gruMoses/wall_e-Mini/docs/data/shield_inputs_20261113/receiver_header_pins_20261114.jpg

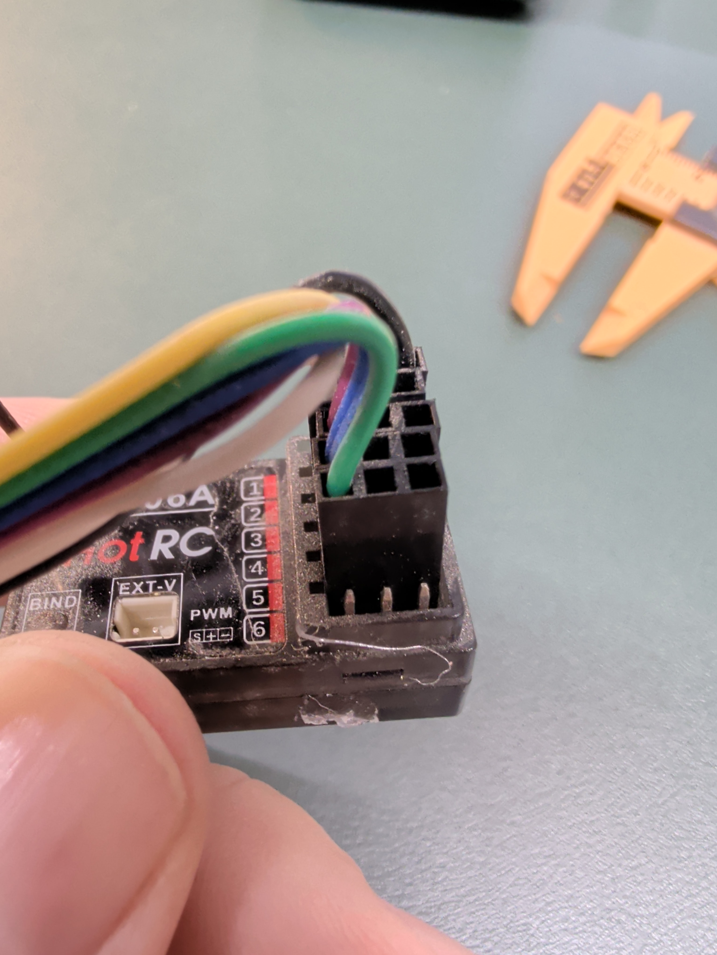
docs/data/shield_inputs_20261113/receiver_header_pins_20261114.jpg
