gruMoses/wall_e-Mini/docs/NEXT_SESSION.md

# Next session: start here

Updated 2026-11-10: a full audit of the documents against the code is in `docs/status_audit_2026-11-10.md`. Start there. It has the open safety gaps in priority order, the UPS battery incident of 2026-11-08, and the list of stale statements. Kevin's answers that day: the BMS targets in `docs/battery_settings.md` are applied; VESC part A is not applied; the new UPS cells stay; the east-field test plan is still wanted, but not now. This document does not have the 2026-11-08 drive review or the RTK sunset work (refer to `docs/rtk_float_investigation.md`).

Updated 2026-11-06 (evening): the VIO runs are DONE (`docs/depthai_upgrade.md`
section 5: works with the RAW IMU reports, 90.6 deg for a 90 deg turn, 6.79 m
for 7 m). The OAK is capped at USB 2 because USB 3 jams the RTK GPS
(`docs/ups_hat_b.md`); item 3 below no longer applies at USB 2. Next for VIO:
log it beside the gyro heading in one run, then decide whether it moves into
wall-e's pipeline (CPU about one core).

Plan written 2026-11-05 (evening) for 2026-11-06, in this order:

1. DONE 2026-11-06. VIO runs with `tools/vio_probe.py` (wall-e stopped).
2. VESC part A in the phone app (`docs/battery_settings.md` section 4, and
   the printed sheet). Not applied yet; a read-back at 15:1x showed the old
   values (-40 A regen, 40 A drive, cutoffs 40.8/36 V, regen cutoff off,
   right VESC 12 cells). After Kevin applies it, read both back with
   `tools/vesc_info.py`.
3. RC range check with the OAK at USB 3 (2.4 GHz noise): Kevin walks the
   remote to the far end of the yard; count clamped RC frames and RC-stale
   events. If the link degrades, force USB 2 in the config first. SUPERSEDED 2026-11-06: the OAK is capped at USB 2.
4. The regen stop measurement: the per-tick log now has `l_bus_v`,
   `l_bus_v_max`, `l_bus_a_min` (and `r_*`). The worst case (BMS charge FET
   open) needs a cold morning below 1 C or a BMS trip; on 2026-11-05 at
   17:56 the FET was back on (52.1 V, highest cell 4014 mV).
5. Kevin's decisions: a failed boot gravity check disables heading hold and
   waypoint navigation (Grok's advice), and wall-e starts the camera reader
   when the OAK is missing at startup (`docs/depthai_upgrade.md` section 6).

State at the end of 2026-11-05: depthai 3.6.1 is live (unplug test and
heading sign test passed, `docs/depthai_upgrade.md`); the OAK links at
USB 3 (Kevin keeps it) (SUPERSEDED 2026-11-06: capped at USB 2 with `max_usb_speed = "HIGH"`); the Pi-to-hub cable has its 5 V wire cut and the
backfeed is fixed (`docs/ups_hat_b.md`); the BMS cell overvoltage trip is
4250 mV (Kevin); the RC arm fail-safe is live (3a3a1b2).

Updated 2026-11-02 (evening): the 2026-11-03 east-field test plan is
`docs/field_test_2026-11-03.md`. The Pi was offline while it was written.
The test page and the google.com reachability halt are specified there and
were not implemented. Kevin installs a new UPS in the morning, drives the
robot into the plowed field east of the barn and east of the house, then
starts one routine at a time. Leave `docs/wifi_watchdog.md` alone.

Updated 2026-11-03: UPSPlus retired; Waveshare UPS HAT (B) + `bin/walle_ups.py` (`walle-ups.service`) halts the Pi 5 s after mains loss and RTC-polls every 60 s; see `docs/ups_hat_b.md`. The 2026-09-27 UPS MCU item and the 18650-pull TODO are closed.

Written 2026-09-20 (evening), at the end of the follow-me session.
Updated 2026-09-22 (evening): `fm-armsup` hardened after three Grok safety reviews and merged (sections 2 and 6).
Updated 2026-09-24 (evening): `fb9420e` deployed; the arms-up bench test PASSED on the test stand (section 2, "Bench result").
Updated 2026-09-24 (night): the log-only pump detector is built on branch `fm-pump` and NOT deployed (section 4, item 2). Housekeeping done (item 8).
Updated 2026-09-25 (night): four safety changes are live (the fourth: OAK auto-restart on a stalled colour stream, `b304609`), after these three: the stale-detection gate for follow-me (`2583757`), auto-disarm after 10 minutes armed and idle in MANUAL (`5340028`), and the startup arm interlock (`3f8cdfa`). Refer to section 4, item 0.
Updated 2026-09-26 (afternoon): follow-me top speed 1.61 m/s, follow range 8 m and a 4 ft stop are LIVE (`c3c995a`, deployed 13:45). Phantom obstacles in front of an iron gate: fix built and replay-validated on 45 raw frames (section 4, item 5).
Updated 2026-09-26 (evening): I2C bus 1 froze on 2026-09-25 21:36 (GPS and UPS monitor dark for 17 h); an auto-unlock guard service is LIVE (`2759465`, section 4, item 0). The corridor phantom fix is LIVE (`cceb2e1`, item 5).
Updated 2026-09-27: the UPS MCU is FROZEN (all registers constant since 2026-09-26 15:06), so the UPS watcher never saw a power-off; a battery-discharge fallback is LIVE (`f193e09`) and passed a live test. Section 4, item 0.
Updated 2026-09-27 (evening): the "pull to the left" was a stale heading-hold target with the GPS offset locked (fix `19a4ebe`); MANUAL obstacle curve for netting over the lens (`814c812`; no person/animal cap, by Kevin's safety principle); stick expo 0.6, ratio-preserving (`35dc7c2`). Wi-Fi: NetworkManager no-secrets block, stopgap live, watchdog not yet deployed that evening (reworked since: on `main`, installed and active). Section 4, item 0, "2026-09-27 evening".
Updated 2026-09-28: animal detections are logged (per-tick `animals`, no behaviour change) to size an animal slow zone; section 4, item 0, "Animals".
This document uses Simplified Technical English where practical.

## 1. State of the robot

- 2026-09-22: `main` gains the `fm-armsup` merge (`b758f7a`, section 2). Before that, the robot ran `main` at commit `8eb6cc5` plus documentation-only commits.
- Kevin validated this build in the field at 18:09 on 2026-09-20. His words: "that was gorgeous".
- All changes from 2026-09-20 are live: tracking fix, steering retune, speed-safety logic, honest person-range sampler, vision-latency fix.
- The full record of the day is `docs/follow_me_run_2026-09-20.md`.
- The end goal and the owner's constraints are in `CLAUDE.md` and in the auto-memory file `project-walle-north-star.md`.

## 2. Branch `fm-armsup`: arms-up bench test (deployed 2026-09-24, bench test PASSED)

Purpose: bench test for the "both arms up" gesture. When the robot sees both wrists above the shoulders, it gives one small reverse pulse (22 bytes for 0.25 s, approximately 7 cm). This is the acknowledgement test that Kevin asked for. It is the first step toward the back-up feature (section 4, item 2).

WARNING: This feature commands motion from a camera gesture. Enable it only while Kevin is at the robot with the RC.

How the gate works:

- A deploy does not enable the pulse. Only a runtime latch enables it: `POST /api/arms_up/twitch_test` with the body `{"enabled": true}`. The POST is accepted only from the robot itself (127.0.0.1). The latch is refused unless the robot is armed in MANUAL.
- The latch clears on disarm, e-stop, mode change, calibration, RC stale, 5 minutes, or 3 pulses. A second enable while latched is refused. A restart clears the latch.
- A pulse starts only when the sticks are within 6 bytes of neutral, web teleop is off, the output was neutral for 0.5 s, both wheel eRPMs are present and at or below 300, and the 3 s cooldown is over.
- A stick input, disarm, e-stop, charger, pack-low, calibration or a mode change cancels a pulse. A cancelled pulse does not resume.
- The gesture needs 3 fresh pose samples over 0.4 s. After a pulse, the camera must see the arms down (3 samples) before the next pulse.
- MediaPipe Pose loads at startup and runs only while the latch is on. It does not run in FOLLOW_ME or WAYPOINT_NAV.

Procedure (bench test with Kevin):

1. Kevin approves the push to `main` in the chat while at the robot. Push. Confirm the merge on the Pi with `git merge-base --is-ancestor`. The service restarts when the robot is disarmed.
2. Garage. Clear floor behind the robot. Armed, MANUAL, sticks centred. Kevin stands 2.5 m to 3 m in front of the robot with the arms down.
3. Latency baseline: with the latch off, Kevin stays in view for 30 s.
4. Enable the latch from a shell on the robot:
   `ssh pi@192.168.86.54 'curl -s -X POST -H "Content-Type: application/json" -d "{\"enabled\": true}" http://127.0.0.1:8080/api/arms_up/twitch_test'`
5. Kevin raises both arms above the head for approximately 1 s. The robot must move back approximately 7 cm, one time. One arm up must do nothing. Arms down for 1 s, then both arms up again: one more pulse.
6. Read the arm log: the `arms_up` block (`twitch_count`, `twitch_blocked_reason`, `twitch_cancel_reason`, `pose_ms`, `pose_hz`) and `oak.det_latency_s` with the latch on, compared with the 30 s baseline.

CAUTION: MediaPipe Pose runs only while the latch is on. A latency reading taken while disarmed or with the latch off does not measure the pose worker.

If `det_latency_s` p50 increases by more than approximately 0.05 s with the latch on, reduce `pose_max_hz` before the back-up feature runs the worker in FOLLOW_ME.

Known limit (deferred): detection freshness compares host poll times, not capture times. The crop can lag the person by the NN latency (approximately 0.2 s). The result is a missed trigger, not a false one. Use capture timestamps before the back-up feature.

Bench result (2026-09-24, 18:35 to 18:40, robot on the test stand with the wheels off the ground, `fb9420e`):

- Deploy: `DEPLOYED 39044dc -> fb9420e` at 18:30:06, service restarted. MediaPipe Pose loaded at boot.
- The latch was enabled from the Pi shell at 18:35:16. Pulses at 18:37:07 and 18:38:26. Kevin: "it definitely twitched backwards".
- Each pulse: bytes 110, 104, 112, 126; peak eRPM approximately -3600; wheel travel approximately 9 cm (integrated eRPM, no load); wheels stopped approximately 0.6 s after the start.
- One arm up: 78 distinct one-arm poses in 60 s gave no trigger.
- Re-arm: the second pulse came only after the camera saw the arms down.
- Expiry at 18:40:16 cleared the latch (1 pulse unused), and pose stopped (`pose_hz` 0).
- Latency (armed, MANUAL, person in view): `det_latency_s` p50 0.179 s with the latch off and 0.182 s with the latch on. `vision_work_ms` p50 26.7 to 32.0. Control loop unchanged. Pose inference approximately 75 ms per frame at 10 Hz (static-image mode).
- Camera geometry: at 2.5 m to 3 m, the shoulders are at 0.09 to 0.13 of the preview height and the NN box is clipped at the top. Raised hands are out of view at that range. The trigger fired only when Kevin stood farther back.
- Not tested: a stick cancel during a pulse, the third-pulse budget cutoff, and travel on the ground.

## 3. Rules learned on 2026-09-20 (obey these)

- Identity gates decide whom to follow. They must never hide a closer range from the speed command.
- A rule must never discard a CLOSE range. A veto is permitted only in the far direction.
- Do not fit a plant model from `imu.yaw_rate_dps`. Use the heading derivative. The analyzer does this.
- Count the zeros and the duplicates in a logged signal before you fit a model to it.
- `OakDetectionConfig.camera_fps = 15.0` is load-bearing. Measure `oak.det_latency_s` before and after each change to the OAK pipeline. The measurement works at idle. A field walk is not necessary.
- A diagnosis from a code review is a hypothesis. `nn_input_queue_size = 1` was "the bug" in review, and it changed nothing. The camera frame rate was the cause.
- Get a Grok safety review of each motion-safety diff before the push. The first review on 2026-09-20 found four real defects after 980 tests passed.
- Workflow that worked: diagnosis on the session model, `grok_second_opinion` on the plan, implementation by headless Grok CLI jobs in separate git worktrees with a written specification, diff review, full test suite, Grok safety review, then Kevin approves the push.
- Kevin wants short replies. Give the instruction first.
- (2026-09-22) Measure a code path in the state where it runs. The pose worker runs only while the bench latch is on, so a disarmed "idle" latency reading does not measure it.
- (2026-09-22) Give `grok_review` exact line ranges for a scoped re-review. An open focus used all 25 turns on reading and gave no verdict.

## 4. Backlog, in priority order

0. **INCIDENT 2026-09-25: follow-me drove on a frozen detection. Deploy 1 of the fix is LIVE (`2583757`, deployed 19:20, verified on the robot: `det_fresh_age_s` 0.2 s, sequence advancing, gate wired in the control loop). Follow-me can be used again.** Deploy 2 is LIVE too (`b304609`, 2026-09-25 night): the OAK session restarts itself after 5 s without a fresh NN packet (10 s warm-up), with a cap of 3 restarts in 15 min, then a latched `color_stall_fault` (health) until a fresh packet or a service restart.
   - At 17:43 the OAK colour camera (CAM_A: YOLO input and preview) stalled on the device after 23 h of uptime. The mono cameras and the depth path continued at 15 fps. Chip temperature was 77 C to 78 C before the stall; a thermal cause is not likely.
   - `get_person_detections()` returned the last list (one person, x -0.8, z 2.52 m, track 453) for 40 minutes. `get_health()` reported `detections_stale: True`, but no code read it.
   - At 18:23 Kevin selected FOLLOW_ME. The frozen list counted as a target, so the entry was accepted. Follow-me drove approximately 0.85 m/s with a constant left steer for 44 s (a circle), and again for 1.7 s and 2.2 s. Log: `arm_20260925_182305.log`.
   - The service restart at 18:30 recovered the camera (`det_fps` 14.5, detection age 0.05 s).
   - Also found: the robot stayed armed from 2026-09-24 18:46 to 2026-09-25 18:07 (arm switch on, transmitter on). The auto-deploy held all night for that reason.
   - Fix plan (Grok second opinion accepted): deploy 1 adds a capture-time freshness clock with sequence tracking in the reader, and a controller gate. The gate refuses FOLLOW_ME entry and leaves FOLLOW_ME on the same tick when the detections are older than 1.5 s. The reader return values do not change: an empty list means "detection gap" (coast), and a stale close person must keep forcing the stop tier. Deploy 2 (later, separate) restarts the OAK session when the colour stream is stale for 5 s with depth fresh, with a retry cap and a fault latch.
   - Deploy 1 is on `main` (`2583757`): full suite 1161 tests OK; Grok safety review: no must-fix. Two corrections were made in review: no slew bypass on the stale exit, and a per-session reset of the NN sequence.
   - Also live 2026-09-25 (Kevin approved each push; Grok safety review before each; no must-fix):
     - Auto-disarm (`5340028`): armed, MANUAL, sticks within 25 us of centre, no web teleop, not calibrating, and neutral output for 600 s (`SafetyConfig.auto_disarm_idle_s`) disarm the robot. The disarm latches: flip the arm switch off and on to re-arm. FOLLOW_ME and WAYPOINT_NAV never auto-disarm. The charger inhibit forces neutral output, so a charging robot left armed also disarms.
     - Startup arm interlock (`3f8cdfa`): after any restart (boot, deploy, crash) the robot arms only after the arm switch has been seen OFF (`SafetyConfig.require_switch_off_at_startup`). Journal lines: `Arm interlock: ...` at startup and `Arm latch cleared: arm switch seen OFF`.
   - Open: the log-only pump detector on `fm-pump` must be rebased on these changes and should use `get_detection_freshness()`. Not yet seen in the field: a real colour stall recovered by the watchdog (check the journal for `OAK colour stream stalled`).
   - Found 2026-09-25 20:20: the charger inhibit keys off charging current (`bms.charging`), not the plug. With a full pack (100 %, 0.0 A) on the charger, `charger_inhibit` is False and does not block motion. Candidate fix: detect the charger by voltage or a hardware input. Auto-disarm and the startup interlock cover the parked case meanwhile.
   - Charger-flag logging is LIVE (`6ef165b`): `bms.charger_connected`, `bms.load_connected`, `bms.bms_mode` in the per-tick log, and a WARNING `BMS charger flag: connected|disconnected ...` on each change. Test not done: the BMS Bluetooth went quiet at 20:55 (35 min on the charger at 100 %, 0 A; "Device ... was not found" since). A Daly BMS sleeps its Bluetooth without current; it should wake when current flows. Test: with the BMS awake, unplug the charger for 30 s and plug it back in, then read the journal.
   - OBSOLETE since 2026-11-03 for the UPS parts of the next six items: the UPSPlus HAT and `upsplus-power.service` are retired. The I2C guard now restarts `walle-ups.service`, and the MCU reset TO DO is closed. The text stays as history.
   - I2C BUS 1 FROZE 2026-09-25 21:36:16 (kernel: `i2c_designware 1f00074000.i2c: i2c_dw_handle_tx_abort: SDA stuck at low`). A device held SDA low; the GPS co-processor (0x20) and the UPSPlus HAT (read by `upsplus-power.service`, the safe-shutdown watcher) both went dark for 17 h. The UPS safe shutdown on power loss was OFF for that time. The bus had no I2C errors in the 3.8 days before; no power dip, no restart, robot parked on the charger. Suspect (not proven): the GPS co-processor, the most frequent user of the bus, whose read failed first. The Pi 5 driver has no GPIO bus recovery, so only a power cycle cleared it (done 2026-09-26 15:06; GPS back, RTK float at 15:15).
   - Fix LIVE 2026-09-26 (`2759465`, Kevin chose software over rewiring): `i2c-bus-guard.service` (root, `bin/i2c_bus_guard.py`, doc `docs/i2c_bus_guard.md`). When the UPS status is stale > 30 s AND 10 joint samples show SDA low with SCL high, it unbinds the driver, clocks SCL (open-drain emulation, never drives high), sends a STOP, restores `a3 pu`, rebinds, and restarts `upsplus-power` (that daemon never reopens its bus handle). It self-heals a half-finished recovery on every cycle, warns whenever the UPS status is stale for any cause, and restarts the UPS daemon if its status stays stale > 120 s on a healthy bus (once per 15 min). Status: `/tmp/i2c_guard_status.json`. It was verified with a dry run on the real pins; the live unlock was NOT exercised (Kevin skipped it), so the first real use will be a real freeze. The guard does not restart on auto-deploy: after changing it, run `sudo bash bin/install_i2c_bus_guard.sh`. If wall-e starts while the bus is stuck, GPS stays disabled until the next wall-e restart.

   - UPS MCU FROZEN (found 2026-09-27). The UPSPlus MCU (0x17, FW 14) answers I2C but has stopped sampling: every register (typec 5057 mV, battery 4034 mV, 72 percent, 52 C) stays constant; the typec register read 5040 on 2026-09-25 before the I2C lock-up and exactly 5057 at every read since 2026-09-26 15:06. The MCU runs on its own 18650, so a robot power cycle does not reset it. Effects: (1) the watcher never declared "AC lost" (it trusts typec_mv), so on 2026-09-26 17:25 main power off was never detected: no USB shed, no clean shutdown, the 18650 carried 4-7 A for 66 min and the Pi lost power hard at 18:31 (18650 at 2.456 V at the next boot); (2) no 20 s firmware output cut-off; (3) no Back-to-AC power-on: after a clean shutdown a person must power the Pi on.
   - During that outage the OAK flapped on USB (hub powered from the main pack) and each camera auto-restart aborted the wall-e process in depthai teardown (`dai::PipelineImpl::~PipelineImpl` -> `std::system_error: Resource deadlock avoided` -> abort): 117 crashes in an hour, 120 run logs. OPEN: make the camera session teardown survive this, so a flapping camera cannot crash-loop the service.
   - Fix LIVE (`f193e09`, installed 12:55 in `/home/pi/bin`, backup `.bak-20260927`): the watcher also declares input loss from the INA219 gauge (separate chip): every fresh reading below -2500 mA for 60 s (10 s cadence). The loss latches until a reading at or above -300 mA (the USB shed drops the drain to the Pi alone, ~-1 A, which must not cancel the shutdown; Grok found that loop). It sheds the OAK hub at once and re-checks with one fresh read before halting. A charger-voltage register unchanged for 30 min logs a warning. A main-loop simulation test covers outage, power back after the shed, and an hour of charger taper dips.
   - Live test 2026-09-27 13:11: main power off; at 13:12:05 "treating input power as LOST (register not trusted)", hub shed 13:12:06, clean power-off 13:12:17 (filesystems synced). Kevin powered the Pi on by hand (no Back-to-AC with a frozen MCU).
   - TO DO when the stack is apart: reset the UPS MCU (all power off, remove the 18650 for 10+ s). Then check that typec_mv changes and that Back-to-AC works again. Until then, after any power loss the Pi needs a manual power-on.

   **2026-09-27 evening** (Kevin approved each change and the deploy; independent Opus reviews because the Grok MCP timed out all evening):
   - **Pull to the left (fix `19a4ebe`).** RTK fixed at 16:52 and locked the GPS heading offset (+22.5 deg). With the lock, MANUAL re-applied a heading target from the start of each straight run on every tick, and the straight latch survives stick pulses, so the target stayed behind the operator's turns. At 17:32 Kevin held right stick for 52 s and the robot turned 27 deg left against up to -30 bytes of correction. MANUAL now works in the raw IMU frame with or without a lock; the compensator re-captures the target at each return to neutral. The review found a second path (a waypoint target kept into MANUAL through the straight latch); fixed in the same commit. Test: `test_manual_heading_hold_retarget.py`.
   - **MANUAL obstacle curve (`814c812`).** 17:18-17:26, loading electric mesh fencing: the netting hung over the lens and read as a solid 0.50 m obstacle; full stick gave the 15 percent crawl. MANUAL now gives 1.0 at 1.5 m, 0.5 at 0.50 m, and the 0.15 floor from 0.35 m. FOLLOW_ME, WAYPOINT_NAV and the 0.8 m person/animal hard stop do not change. The review found that the curve also relaxes a MANUAL approach to a person or an animal (at full stick, about 1.05 m/s instead of 0.60 m/s at the 0.8 m stop). A cap for that was built, leaked twice in review (animals and unranged persons are not masked out of the corridor; a hand or a cow's head reaches ahead of the range point), and was removed on Kevin's decision: his safety principle (CLAUDE.md) accepts a little extra risk from human input, never from autonomous input. Kevin will also keep the netting off the lens; with mesh over the lens the camera is partly blind, and follow-me still stops.
   - **Stick expo (`324023f` then `35dc7c2`).** RC MANUAL only, `rc_map.stick_expo` 0.6. The first version (per track) failed review: heading hold read gentle turns as straight and fought them, and near full stick a small difference was amplified about 2x. The live version multiplies both tracks by k = (1 - e) + e m^2 (m = the larger deflection): same turn radius, never more difference than linear, full stick unchanged; steering intent and the twitch stick band read the linear bytes. Tune on Kevin's word; 0.0 is linear.
   - **Wi-Fi (watchdog reworked, on `main`, installed and active).** 17:35-18:13 the Pi was up but off the network: NetworkManager 1.42 marked the profile "no-secrets" after three association timeouts at the edge of range and blocked it until reboot. A stopgap went live at 18:50: `preconfigured` auth-retries 0, autoconnect-retries 0. It covers association timeouts only; a drop during the WPA 4-way handshake still ends in the block. The first watchdog draft (branch `heading-hold`, `72cb1e4`) failed review: a router outage bounced working links; it could supersede NM's own attempt; candidate choice ignored the profile band; retry spacing counted from the start of an attempt; the `wwr outdoor` setup command put the password in sudo's log; and three tests were vacuous. The rework landed on `main` as `f4e209f` (2026-09-28), `e31067b` and `df1187d` (both 2026-10-04). It acts only when NM is idle for 120 s or the link is stuck for 600 s, takes candidates from `CONNECTIONS.AVAILABLE-CONNECTIONS`, remembers which profiles reached the gateway, and never takes down a link whose gateway has answered. `bin/add_wifi_profile.sh` prompts for the password. `wifi-watchdog.service` is installed and active on the Pi (verified 2026-11-03). The `wwr outdoor` fallback profile exists and passed the `GATEWAY_OK` test, so the `preconfigured` profile's `auth-retries` is now -1. `docs/wifi_watchdog.md` section 5 still describes the earlier `auth-retries` 0 stopgap; that section is out of date. Design and install notes: `docs/wifi_watchdog.md`. Kevin's "White Rock outdoor" is SSID `wwr outdoor` (2.4 GHz channels 6 and 11, -42 dBm at the garage). `preconfigured` is band=a (5 GHz only) for no recorded reason; the 2.4 GHz WHITE ROCK ROAD radios reach farther.

   **OAK vision worker hang (found 2026-10-08 17:15, "the robot drives extremely slowly").** Nothing in the code: the camera had been dead since 2026-10-04 13:41. A USB hub glitch (kernel: the OAK re-enumerated as the bootloader, then as an unbooted MyriadX; the Arduino serial dropped in the same second) raised X_LINK_ERROR on every stream, the colour-stall watchdog's third restart of the 15-minute window called `pipeline.stop()`, and depthai's teardown never returned. The worker thread sat in C++ for 99.7 h with `pipeline_running` True, `loop_age_s` 358,867 s, `depth_fps` 0; nothing restarted it because the supervisor runs inside that thread. Depth was 4 days stale, so MANUAL ran at the 10 percent stale floor (`throttle_scale 0.1` with `obstacle_distance_m 2.5` on the SSE stream; `OAK(2.50m scl=0.1)` in the journal) and FOLLOW_ME was refused. Recovery: a disarmed `sudo systemctl restart wall-e` at 17:36 (Kevin's OK); depth back at 14.5 fps a minute later.
   - Fix (this commit): `get_health()` reports `vision_hung`, `vision_worker_age_s`, `vision_thread_alive` (the worker heartbeat is the newer of the session-loop tick and the supervisor-loop tick, stamped before the import, at each session attempt, before `pipeline.start()`, and after each session, so a device-absent backoff or a slow boot is not a hang). `pi_app/app/vision_hang.py` turns the flag into a journal line every minute, JSON events, and after 60 s hung a loop exit with code 3 and `os._exit` (the stuck thread cannot be joined and depthai's exit teardown could block on the same deadlock); systemd `Restart=on-failure` starts a fresh process 5 s later. Grok's review (session `01a11db9`, 15 turns) found two must-fixes, both applied: (1) `cmd.is_armed` goes False on a 1 s RC dropout with the switch still up, so the gate now reads the raw ch3 level with a fresh link, blocks a dropout shorter than `vision_hang_rc_off_s` (30 s), allows after longer silence or with no RC ever (transmitter off), and must hold for `vision_hang_restart_settle_s` (10 s); (2) a hang that recurs on every boot had no bound, so `logs/vision_hang_restarts.json` caps it at `vision_hang_restart_budget` 3 per `vision_hang_restart_window_s` 60 min, then log only. Also from the review: SIGTERM is ignored once the exit is chosen (an auto-deploy restart during the cleanup could skip `os._exit`), the thread handle is published and read under the lock, and the pre-import hole is stamped. Accepted as-is: `Device.getAllAvailableDevices()` in the backoff has no timeout, so a USB scan blocked for 90 s also restarts (that is a hang; the budget bounds it). Knobs: `OakDetectionConfig.vision_hang_s` 30, `vision_hang_restart_s` 60 (0 = log only), `vision_hang_log_interval_s` 60. Tests: `test_vision_hang_monitor.py`, `test_oak_vision_hung.py`.
   - DONE 2026-11-05: depthai 3.6.1 is live and pinned in `requirements.txt`, and the IMU uses the UNCALIBRATED reports. The text below is history. The depthai teardown itself (research 2026-10-08, from the depthai-core source and PRs; the robot runs **depthai 3.3.0**, Python 3.11, kernel 6.12): the 2026-09-26 abort is a confirmed self-join. On a USB drop the reader node (`XLinkInHost`) throws, `ThreadedNode` calls `Node::stopPipeline()` on that node thread, and when that is the last Pipeline reference `~PipelineImpl` runs `wait()` on its own thread: EDEADLK, the destructor throws, the process aborts (PR luxonis/depthai-core#1678 describes the chain). Fixed by commit `3438d96a` (PR #1723): `stopPipeline()` now runs on a detached helper thread. First in **v3.6.0 / 3.6.1 (2026-05-04)**; absent from 3.3.0, 3.4.0, 3.5.0; latest is 3.10.0 (2026-09-02; issue titles report OAK-D Lite regressions on 3.7.1 and 3.8, unread). The 2026-10-04 hang is plausibly `XLinkInHost` parked on `isWaitingForReconnect.wait()` with no timeout, never woken because the monitor thread's `pipelinePtr.lock()` returns null during teardown (unchanged through 3.10.0, not confirmed). Ranked next steps: (1) upgrade depthai on the robot to 3.6.1 or later (try 3.10.0, fall back to 3.6.1) and bench-test stereo, detections and the IMU; CAUTION (2026-11-05, verified in the v3.6.1 release notes): from 3.6.1 the `RAW` IMU outputs are "captured directly from the IMU" instead of pre-rotated to RDF, and `oak_depth.py` requests `ACCELEROMETER_RAW` / `GYROSCOPE_RAW`, so `gyro_y` can change axis or sign silently; switch to the `*_UNCALIBRATED` outputs in the same change, then re-run the chalk SIGN test and check the boot gravity line. AutoCalibration is also on by default from 3.6 (`DEPTHAI_AUTOCALIBRATION=OFF` disables it); keep it off for the first run and confirm the intrinsics line still reads fx 456.89, cx 334.95. `requirements.txt` allows `depthai>=3.3,<4`, so a fresh install takes the newest 3.x; pin the version; (2) in the session `finally` call `pipeline.stop()` then `pipeline.wait()` on the worker thread and keep the old Pipeline referenced until `wait()` returns, before building the next one; (3) run stop+wait in a helper thread with a ~10 s join timeout and, on timeout, keep the object referenced, do not rebuild, and let the vision-hang self-restart recover (already live); (4) only with (1) or (2): `setMaxReconnectionAttempts(0)` / `DEPTHAI_RECONNECT_TIMEOUT=0` for one deterministic teardown (on 3.3.0 alone it makes the abort worse), and `DEPTHAI_CRASHDUMP_TIMEOUT=0`. Sources: https://github.com/luxonis/depthai-core/pull/1678 , https://github.com/luxonis/depthai-core/pull/1723 . The disarmed run log `run_20261004_125815.log` at 1.78 GB in 4 days is by design (1 Hz slow lines plus a 5 s heartbeat tick, about 450 MB/day; the sampled tail shows 0.2 ticks/s and no events): consider a lower idle slow-line rate.

   **RC channels 1-4 dead at the Arduino (2026-10-09 14:23, RESOLVED 2026-11-05).** Kevin in the field: "I can't drive." The transmitter reports connected, but the Arduino's CSV shows `ch1=1500 ch2=1500 ch3=1500 ch4=1500` for 20+ minutes across 200+ samples, while `ch5` jitters 996/1000 (a real pulse). The sketch (`arduino_rc_reader/arduino_rc_reader.ino`) initialises every channel to 1500 and clamps any pulse outside 800-2200 us to 1500, so an exact, jitter-free 1500 means NO pulse has been measured on that pin since the Arduino last reset (D2-D5 for ch1-ch4; D6 for ch5 works). A Pi reboot (Kevin's request, 14:31) and the Arduino's re-enumeration did not change it. The `Arm latch cleared` lines right after each start are the first frame, not a real switch. Diagnosis: the receiver's channel 1-4 outputs are not reaching the Arduino (leads/header on the receiver or the Arduino, receiver failsafe/output mode, or the transmitter on another model memory); ch5's lead is fine. Related: the kernel logged 167 USB over-current trips this boot before the reboot (25 on 2026-09-29 12:00-16:00, 2 on 10-04 13:41 that started the 4-day hang, 1 on 10-08 19:55), each cutting every USB port at once (OAK + Arduino + hub); `usb_max_current_enable=1` is not set in `/boot/firmware/config.txt` (Pi 5 default limit 600 mA without a PD supply), `EXT5V_V` reads 4.91 V, `throttled=0x0`. 2026-10-17 update: with the remote attached, channels 1-4 come through only in bursts (0 percent clamped frames on 10-08, 93 percent on 10-17); follow-me works because a 1500 on ch3/ch4 is "no change" for it, MANUAL cannot hold the arm (needs ch3 >= 1800 for 0.3 s) and reads the sticks as centre. **Do NOT set `usb_max_current_enable=1`** (Kevin asked why it was never set; investigated, no written decision, but the engineering reason holds): the Pi is fed by the UPSPlus through the header with no USB-PD, so the firmware's 600 mA cap exists because it cannot know the supply; the flag asserts a 5 A supply the HAT does not have (about 4 A; `EXT5V_V` 4.91 V), and the failure would move from a USB port trip to a Pi brownout mid-drive. The trips are not legitimate load either: the hub declares itself self-powered (100 mA) and the Arduino 98 mA, trips happen with the robot idle (10-10 01:09, 10-08 19:55), and the UPS daemon's notes record the hub's devices landing "back on the Pi's ports" when the pack dropped, so the hub's VBUS is wired both ways (backfeed of its higher 5 V into the Pi, or bus-power fallback when its pack supply sags). Fix: a Pi-to-hub USB lead with the 5 V wire cut (or a power-blocking adapter), so the hub runs on pack power only; then re-check the receiver (likely fed through the Arduino on the same starved port) and do the ch3-to-D6 swap test if it is still glitchy. Field check first: pull the hub's upstream cable from the Pi; the hub LED and the OAK must stay lit. 2026-11-04 update (raw serial, `wall-e` stopped, no project code in the path, robot on the stand): at rest ch1-ch4 read 1500-1508 and ch5 996-1000. Each press of transmitter button 3 or 4 gives ONE 40-80 ms frame group in which ch3 AND ch4 move together (button 3: both 1000-1004; button 4: both 2000-2004) and ch1/ch2 dip to 1484; then all four return to about 1504. 5,886 lines in 120 s, 4 presses, 4 such groups. On 2026-10-08 (`logs/netting_20261008/arm_20261008_171239.log`) ch3 held 2000-2004 for the whole armed session and ch4 sat at 992-996 on its own, so the fault is upstream of the Arduino's CSV and started between 10-08 and 10-09; `safety.py` (last change 2026-09-25), the reader and the sketch did not change in that window. Effect today: one button-4 press arms (one high frame is enough, because the debounce times the gap between transitions, not the pulse), the arm then holds while ch3 reads mid-band, and only a button-3 frame group disarms it. The `RC RC(... ch3=1500 ...) armed=Y` journal lines are this state, not a parse error. The 2026-10-17 sentence "MANUAL cannot hold the arm (needs ch3 >= 1800 for 0.3 s)" is wrong: it arms on one frame. Next checks: the transmitter's channel monitor for ch3/ch4 (independent there or not), then the ch3-to-D6 swap test. 2026-11-04 19:22-19:24 truth table (raw serial, `wall-e` stopped, one press at a time, Kevin: 3 and 4 are push-button toggles that latch; the transmitter has no channel monitor; capture kept on the robot as `logs/rc_truth_table_20261104.csv`): press 3 -> ch3 AND ch4 both low for 0.06-0.08 s, then both back to about 1502; press 3 again -> the same low blip (no toggle); press 4 -> both high for 0.04 s; press 4 again -> both high for 0.02 s. The drive stick held forward gave ch1/ch2 at 1796-1800 for the full 6.07 s, so the receiver-to-Arduino path carries a held value on D2/D3. Correction to the 2026-10-09 sentence above: ch1/ch2 are not dead, they only read centre when the sticks are centred. What reaches D4/D5 is a one-frame pulse per press on both channels, not a latched level. **2026-11-04 20:00 root cause (transmitter setting, not code or wiring):** the remote is a HotRC DS600 V3 (LCD, sold as Havcybin). Its V3 manual (`https://www.flyingtech.co.uk/wp-content/uploads/2023/11/DS600-Manual-EN-.pdf`) has two hybrid modes, cycled by holding button 3 while switching the remote on: LCD icon (1) = CH1/CH2 tank mix (KEEP, the drive mix), icon (2) = CH3/CH4 mix, a jog mode that puts one button on both channels with a neutral rest (the truth table above). The LCD showed (1) AND (2) on 2026-11-04. Holding 4 at power-on is Channel Reverse on the V3 (not the CH3/CH4 mix as in the older LED-model guide, which was tried first by mistake); stick directions looked unchanged afterwards, but confirm on the stand. Holding 5 = travel, 6 = trim lock, OK = failsafe. **Tomorrow:** cycle hold-3 power-ons until the LCD shows only (1); then arm with 3, push the stick forward, disarm with 3, and confirm in the arm log that ch3 holds about 2000 through the stick move and ch4 stays near 992 (the 2026-10-08 pattern). Until then the arm holds only through the mid-band hysteresis and disarm/follow-me arrive as 40-140 ms blips; the ch5 e-stop is the reliable stop. **Resolved 2026-11-05 about 09:30:** Kevin cycled the remote to icon (1) only. `arm_20261105_093449.log`: ch3 held 2000-2004 through stick moves, ch4 stayed at 992, and the disarm held 1000. SUPERSEDED on arming: since `3a3a1b2` (2026-11-05) the robot arms only after ch3 is held high for 0.2 s, and 0.5 s without a held-high reading while not low disarms it. The sentences above that say one high frame arms describe the code before that commit.

   **Mesh netting on the robot (Kevin, 2026-10-08 17:57).** With the electric-fence mesh netting loaded on the robot it hangs over the lens; the depth corridor reads it as a close wall and the MANUAL curve inhibits speed. Data: 60 raw depth snapshots with RGB taken while he drove with the netting on, 18:05-18:07 (`logs/depth_snapshots/20261008_180*.npz` on the robot; copied to the Mac at `logs/netting_20261008/`) and the armed log `arm_20261008_175636.log`. No video exists (the recorder is off whenever gestures are configured, backlog item 3).
   - Replay (`tools/replay_depth_snapshots.py`, new): in all 60 frames the mesh is a SOLID near wall to stereo, not a sparse field: 97-98 percent of the valid corridor pixels at 0.35-0.65 m (mode 0.45-0.55 m), 1-2 percent see through, corridor valid 33-42 percent, distance 0.40-0.41 m, MANUAL scale 0.26-0.29. The RGB shows the dense white/blue mesh over the whole frame with trees visible through it. The drive log: 588 s armed, 81 m of forward travel with the corridor at 0.40-0.50 m, scale 0.3-0.4, top speed 0.77 m/s. A depth-histogram filter cannot separate the mesh from a wall.
   - An automatic "the wall moves with us" latch (constant range over 0.5 m of wheel travel) was REJECTED by Grok's second opinion (session `01a11de8`) and I agree: a close person YOLO misses, wheels slipping on grass in front of a real wall, ground in the corridor with the nose down under cargo, or anything being pushed all satisfy the same test, and a safety mute must be one the hazard cannot satisfy.
   - Built instead (Kevin's OK before push): an EXPLICIT netting mute, `pi_app/control/netting_mute.py`. The operator taps "NETTING LOADED: MUTE CORRIDOR" on the phone dashboard (`POST /api/manual/netting_mute {"on": true|false}`) with the netting already over the lens: armed, MANUAL, and the dense near field in view (corridor distance <= `netting_mute_max_distance_m` 0.55 m, near/support share >= `netting_mute_min_near_share` 0.85), or the tap is refused (the badge shows why). There is no waiting state. While engaged, MANUAL ignores the corridor as long as the field holds (`netting_mute_hold_near_share` 0.70: the share sat below 0.85 for 36 percent of the drive in runs up to 69 s, below 0.70 for 0.1 percent and 0.33 s at most); a finite reading beyond 0.55 m drops it on that tick (a fence that appears when the netting lifts is never ignored); only a dropout (no reading, stale depth, in-band share dip) gets `netting_mute_absent_release_s` 0.5 s. It also drops on any person or stop/slow-tier animal detection (birds are log tier and do not count; a failed detection read counts as present), on disarm, on leaving MANUAL, after `netting_mute_timeout_s` 900 s, or on a second tap; after any drop a new tap is required. The web thread only queues the request and `process()` applies it (single writer; a same-tick operator drop could otherwise leave `active` True). The YOLO 0.8 m stop (distance 0.0 on its own channel) and a stale depth are never muted; FOLLOW_ME / WAYPOINT_NAV never use it. Accepted residual (explicit mute): a real wall inside 0.55 m at the moment of the tap is indistinguishable from the mesh. Telemetry `netting_mute` (SSE badge, per-tick log); journal `Netting mute ACTIVE / refused: ... / dropped: <reason>`. Grok safety review (session `01a11df6`) found three must-fixes in the first version (1 s release at 1.6 m/s, 0.70 m cap above the data with a waiting state, web/control race), all applied as above. Tests: `test_netting_mute.py`. Open: Kevin may prefer an RC channel; a true mesh recogniser (appearance: a periodic white/blue grid across the RGB frame) could add automatic engage later, with motion only as a veto, never as the permission; the corridor valid percent (27-47 percent on the netting) is logged but not a gate until the negative set is counted.

   **Animals (2026-09-28).** Kevin has ducks, chickens, geese, dogs and cats. YOLO reports all poultry as "bird" (COCO 14), which is in no safety tier; cat, dog, horse, sheep and cow are in the 0.8 m hard-stop tier. Grok's second opinion (accepted): do not just add bird to the hard stop. (1) 0.8 m is inside the braking distance at 1.6 m/s with 0.15-0.3 s of vision lag, for every animal. (2) A chicken inside about 0.8 m is mostly below the frame and below the depth corridor band (camera 0.5 m up). (3) The flock is the normal state of the yard, so a hard stop fires all the time, and false "bird" hits (leaves) add more. Kevin chose "log first, then slow zone":
   - Step 1 LIVE: the per-tick log has `animals` (label, conf, range, box, tier, depth status) for bird, cat, dog, horse, sheep and cow. Nothing else changed. Collect a yard session with the flock out, armed, in MANUAL and follow-me.
   - Step 2, after the data: an animal slow zone in FOLLOW_ME and WAYPOINT_NAV, from Grok's design: a bird-specific confidence; valid depth and a box-height-versus-range check for a ~0.25-0.4 m body, on the ground plane; 3-of-5-frame persistence; a speed cap of about 0.3 m/s (turn rate too) within about 2.5 m, applied to the command; the 0.8 m hard stop only after persistence, with release hysteresis; do not pull the obstacle distance to a raw bird sample. MANUAL: a soft cap at most (Kevin's safety principle). Count phantom stops on the logged yard data before trusting it. Get a Grok safety review of the diff.

1. **`fm-armsup` bench test.** PASSED 2026-09-24 on the test stand (section 2). Optional: one pulse on the ground to measure the real travel.
2. **Back-up feature.** Both arms up while Kevin walks toward the robot: the robot reverses, keeps Kevin centred, and keeps its distance. Agreed: trigger is both arms raised (the camera cannot see palms or fingers beyond 0.5 m); reverse speed cap 0.4 m/s; the robot stops when the arms go down (approximately 0.3 s); a maximum distance for each reverse movement; the RC always overrides; there are no rear sensors and Kevin accepts that. Skid-steer yaw sign does not depend on the travel direction, thus the keep-centred steering law stays the same. Write a design first, then get a Grok second opinion and a Grok safety review.
   CAUTION (bench test, 2026-09-24): with the camera as mounted, raised hands leave the frame when Kevin is closer than approximately 3.5 m to 4.5 m. That is the range where the back-up feature must work. Thus the raised-arms trigger is dropped.
   Design draft (2026-09-24): `docs/backup_pump_design.md`. The trigger is a low two-hand "pump" that the person box width shows at all ranges (tested the same evening: 3 to 3.7 x the rest width). Grok reviewed the draft and its eight corrections are in it. The box-based design does not use the pose crop, so the capture-time and largest-box limits of the arms-up worker do not apply. Kevin accepted the four decisions in section 10 of the design.
   Step 1 status (2026-09-24): the log-only detector is built on branch `fm-pump` (`dfbda57`): `pi_app/control/pump_gesture.py`, a `pump` log block, and the journal lines `PUMP would-start (log only)` / `PUMP would-stop (log only)`. 1164 tests pass. Grok review: no path to the motors or the mode, and no loop-stall risk. NOT deployed: Kevin said "not tonight".
   Procedure for the trial:
   1. Kevin approves the push in the chat. Merge `fm-pump` to `main` and push. The service restarts once while the robot is disarmed.
   2. Park the robot. Arm it in MANUAL with the sticks centred. CAUTION: the per-tick log runs at 10 Hz only while the robot is armed. Disarmed, it writes one line every 5 s, which is too slow for the trial.
   3. Kevin works in front of the robot for 10 minutes. Include the hard cases in design section 9, step 1: hands on hips, a carried board, bending, turning, walking toward the robot, a second person or an animal if possible.
   4. Kevin pumps 3 to 5 times each at approximately 2 m, 3 m and 4 m.
   5. Score the would-start journal lines and the `pump` log block. The raw `detections` are in the same log, so other detector variants can be replayed offline.
3. **Video recording is off.** The H.265 encoder is skipped when gestures are configured (`pi_app/hardware/oak_depth.py`, the condition `hand_queues is None` near the `VideoEncoder` block; journal line `OAK recorder: no recording queues available`). Kevin wants recording back. The comment says "ISP limits", but the hand stream replaces the preview stream, thus the count of camera outputs is the same as in the gestures-off configuration. Plan: a config flag, `fps=` on the 1080p output, encoder preset at the camera frame rate, then an idle A/B of `det_latency_s`, `det_fps` and `depth_fps`. Revert if latency increases.
4. **Hand gestures.** Decision: fix them, do not remove them. The RC stays the authority for now. Fix order: (a) mode ownership between RC channel 4 and gestures (an RC-started follow-me must put the state machine in phase ACTIVE so that the stop palm is checked; a gesture start must survive or be refused with a logged reason); (b) count the hold on new hand results, not on 30 Hz control ticks; (c) range: a hand crop from the person box at a higher resolution, or the on-device hand models. Refer to `docs/gesture_review_2026-09-20.md`.
5. **Phantom obstacles from repeated structures (gate, siding, gravel).** Fix built 2026-09-26 on `fm-speed` (`8a4afb2`, `04ba25d`): a depth-agreement speckle filter and a depth-aware person mask in the depth corridor. Replay-validated; field validation in motion is still open.
   - 2026-09-26 13:07 (`arm_20260926_130713.log`): Kevin stood in front of the iron gate. From 4.7 m to the stop, the corridor reported 0.56 m to 0.9 m (`corridor_near_px` 1,300 to 3,100, flickering around the support floor). Throttle 0.2 to 0.6 for 13 s: the approach was slow and jerky and started to slow early. 12:55: the same signature for 6 s next to the barn.
   - Evidence: 45 raw frames (`logs/depth_snapshots/*.npz` on the robot) from 11 setups that Kevin placed with the robot parked and disarmed. The gate phantoms are false stereo matches: sparse near pixels (median blob 2 px) at random depths from 0.35 m to 1.5 m, with nothing in front.
   - Filter: a near pixel (<= `slow_distance_m`) stays only when at least `corridor_speckle_min_neighbours` (16) near pixels in its `corridor_speckle_window_px` (13) square lie within one 100 mm depth bin of it. It runs only when the near pixels reach the support floor and stay under `corridor_speckle_max_near_px` (20,000). The density and support checks use the pixels before the filter; if too few remain to measure, the unfiltered reading stands (log `obstacle.corridor_speckle_fallback`). Log `obstacle.corridor_speckle_px` counts dropped pixels. About 7 ms per frame on the Pi 5 when it runs (the vision thread uses 11 of 66 ms today).
   - A blob-size filter (`8a4afb2`) was tried first and replaced: Grok and a stress test showed that woven wire fence looks like speckle at the pixel level; with 30 percent of the fence pixels removed, every blob variant lost the fence at about 1 m. Dropping pixels could also push valid density under `min_valid_pct` and publish "clear".
   - Replay of the production code over 150 frames (the 45 plus random and 8x8-block dropout to 70 percent): no real obstacle that the old code saw inside 1.5 m was lost, and no gate phantom was left. Old -> new: gate phantoms 0.70-0.81 m -> 2.1-2.2 m (ground edge); gate bars 1.00 -> 1.03 m; trash can 0.87 m (same); wire fence at 3 ft 0.79 -> 0.86 m (1.2 m at 70 percent density); wire fence at 5 ft 0.58-0.73 -> 1.64-1.71 m (its histogram peak is 1.6-1.8 m); siding in shade 1.73 m (same); sunlit siding at a taped 53 in (1.346 m; stereo median 1.341 m) 0.73 m (same, above the 20,000 px gate). The zero-loss, zero-phantom band is 12 to 22 neighbours at window 13.
   - Person mask: `person_mask_depth_margin_m` 0.5. The corridor used to zero the whole person box, which also hid an obstacle between the robot and the person inside that outline (Kevin asked why people are masked). Now only pixels at or beyond the person's range minus 0.5 m are masked. A person with an unknown range is not masked. An obstacle less than 0.5 m in front of the person is still masked (as before).
   - Still open: (a) a drive-by validation at the gate and along the barn; (b) a smooth, low-texture real obstacle (garage door, painted wall, dim light); (c) the sunlit siding reads about 0.6 m short (a 5 percent tail of false near pixels inside the wall's own blob sets the k-th smallest value): cautious, not a hazard. Rollback: `corridor_speckle_min_neighbours = 0`, `person_mask_depth_margin_m = 0.0`.
   - Tool: `POST /api/debug/depth_snapshot` on port 8080, local-only (live since `c284b28`). Run on the robot: `curl -s -X POST -H "Content-Type: application/json" -d '{"count": 5, "interval_s": 0.5}' http://127.0.0.1:8080/api/debug/depth_snapshot`. Cap 200 files. Colourized depth in the recorder cannot tell a false match from a hole (both dark blue): use raw frames.
6. **Steering gain.** Left at `pid_lateral_kp` 0.5 and cap 32 on purpose. The simulation shows margin. Since 2026-09-26 the follow-me forward cap is 128 (byte 254, the mixer limit), thus at top speed each steer correction is inside-wheel braking only and gives about half the yaw of the same correction at forward 110 or less. Optional experiment with Kevin present: `POST /api/follow_me/params {"pid_lateral_kp": 0.6}`. It needs no deploy and reverts in seconds.
7. **Lidar.** Recommendation: Slamtec RPLIDAR S2L (IP65, 80 klux, approximately 299 USD). Refer to `docs/lidar_selection_2026-09-20.md`. Verify the prices before an order. Do not start the integration before Kevin has the unit. Kevin also plans a T-bar handle to ride on the back axle: a rider changes the mass, the stopping distance and the yaw plant, thus measure them again.
8. **Housekeeping.** 2026-10-08: removed the eight clean, merged worktrees under `.claude/worktrees/` (arm-interlock, auto-disarm, bms-charger-flag, cam-restart, fix-vision-stale, fm-speed, heading-hold, i2c-guard) and the merged local branches animal-log `26c053e`, arm-interlock `d243f79`, auto-disarm `5340028`, bms-charger-flag `db773e9`, cam-restart `4a73ddf`, docs-ups `d089c46`, drive-push `04d9e09`, fix-vision-stale `7936805`, fm-speed `cceb2e1`, i2c-guard `e5e5815`, ups-discharge `f193e09`, wifi-watchdog `df1187d`, plus the superseded heading-hold `2c60f4b` (restore any with `git branch <name> <sha>`). Kept: `fm-pump` (worktree + branch, unmerged), `research/follow-me-trail-strategies`, and the stash `stray DetectionFilter confidence-gate comment` (behaviour-neutral; drop it when convenient). The 120 crash-loop run logs from 2026-09-26 were already removed by the 7-day cleanup. Earlier: DONE 2026-09-24 with Kevin's approval: all merged worktrees and local branches removed (only `main` and `fm-pump` remain); the two July review documents moved to the macOS Trash; 12 merged branches deleted from GitHub. Restore one with `git push origin <sha>:refs/heads/<name>`: `697a8d5 codex/replace-bare-except-with-logger.exception`, `1c6b80a docs/bms-fail-open-memo`, `16c1ac3 docs/gearing-memo`, `de4cb44 feature/property-map`, `7dc8466 fix/gps-align-lock-hardening`, `6950e14 fix/oak-imu-heading-hardening`, `c7b1734 fix/oak-imu-producer-integration`, `a2628f0 fix/spp-writer-retirement`, `7e6d8dd fix/stream-client-caps`, `dd0f366 fix/ups-startup-hardening`, `d2ba2b0 fm-armsup`, `91f4bb7 review/temperature-debug-graph`. Kept: `research/follow-me-trail-strategies` and `codex/initialize-_last_imu_update-in-controller` (not merged). 2026-11-10: these also exist, and their content is in `main`: the worktree `../wall_e-Mini-dai` (branch `depthai-upgrade-prep`), three worktrees under `.claude/worktrees/` (branches `worktree-agent-a1a2b199966abd999`, `worktree-agent-a6c2c9c909004a57d`, `worktree-agent-ac02263256c3121d3`), and the remote branches `origin/claude/epic-goodall-r0yri7` and `origin/claude/hopeful-euler-drwd8s`. They are safe to remove with Kevin's approval. DONE 2026-11-10 (evening) with Kevin's approval: all worktrees are removed (thirteen: the four above, the eight of that day's agent work, and `fm-pump`), with their local branches. Only `main` and `research/follow-me-trail-strategies` remain locally; `fm-pump` stays on GitHub only (`dfbda57`). The stash is dropped; its comment is in `main` (`862e066`). The old versions of the person stop hold (branch `worktree-agent-a22931b64a20f14f2`, tip `c1a2357`) are deleted on purpose. Not done: the two remote `claude/` branches are still on GitHub. DONE 2026-11-14 with Kevin's approval: three remote branches deleted from GitHub. Restore one with `git push origin <sha>:refs/heads/<name>`: `3f15802 claude/epic-goodall-r0yri7` (an ancestor of main), `a1e6050 claude/hopeful-euler-drwd8s` (its two files, `tools/vesc_info.py` and its test, are identical on main), `ff9dd01 codex/initialize-_last_imu_update-in-controller` (rejected: main already sets `_last_imu_update` at start-up with `time.monotonic()`; the branch used `time.time()` and an obsolete `RCInputs` field).

## 5. Known residual risks in the live build (from the second safety review)

All of them end in a stop, or they last 1 s or less.

1. A person at approximately 2.5 m with no stereo range and a box that is 0.85 of the frame height or more: the robot does not move closer until the range comes back.
2. A lone detection with an unknown range (for example a chicken) can continue the lock after the operator leaves the frame: the robot continues at a speed that does not increase for a maximum of 1 s, then it stops.
3. A close person whose box is short and whose range is unknown: the speed holds (it does not increase) for a maximum of 1 s.
4. The range status `ambiguous` can occur frequently beyond approximately 5 m, because one pixel of disparity is approximately 1 m at that distance.

## 6. Status of `fm-armsup` at the end of the 2026-09-22 session

- Commits: `d23c252` (detector and twitch), `b36db07` (hardening after review 1), `d2ba2b0` (fixes after review 2). Merge commit on `main`: `b758f7a`.
- Full test suite: 1137 tests, OK (4 skipped).
- Grok safety review 1 found 11 defects: twitch on by default; no RC override during the pulse; a twitch in FOLLOW_ME; a fake hold across a calibration gap; a pulse that resumed after charger or pack-low; the model load on the first armed frame; re-arm after a detection dropout; the unmapped crop; tracking on a moving crop; pose load in follow-me; a stop race.
- Grok safety review 2 found 3 bounded holes: a LAN client could refill the latch; the still check passed with no eRPM; a reverse byte could stay in the VESC across calibration.
- Grok safety review 3: no must-fix item for a supervised bench test.
- The largest confident person box is still the pose target, not the follow-me lock. This is acceptable for the MANUAL bench test only. The back-up feature must use the locked target.
- Idle baseline before the merge (2026-09-22 17:04, disarmed, `39044dc`): `det_latency_s` p10/p50/p90 0.174/0.197/0.219 s, `det_fps` 15.0, `vision_work_ms` 8.7.
- Bench test and latency with the latch on: done 2026-09-24, PASSED (section 2, "Bench result").

## 7. Session costs and tools (for the budget check)

- Grok CLI implementation jobs on 2026-09-20: approximately 12 USD of xAI credit in total. The documentation job was the most expensive (2.29 USD, 46 turns): give documentation jobs less to read next time.
- The 2026-09-20 session model was Fable 5.1. The 2026-09-22 session model was Opus 5.5.
- Grok on 2026-09-22: review 1 0.60 USD; second opinion 0.03 USD; implementation round 1 2.94 USD (42 turns); review 2 0.90 USD; implementation round 2 1.69 USD (39 turns); review 3 0.89 USD (ran out of turns, no verdict) and 0.22 USD (scoped retry). Total approximately 7.30 USD.
- A push to `main` needs Kevin's approval in the chat. The auto-mode classifier blocks an unapproved push as a production deploy. That is the correct behaviour.
