gruMoses/wall_e-Mini/docs/rtk_float_investigation.md

# RTK float investigation (2026-09-19)

The rover reported RTK float (fix quality 5) and never RTK fixed (4) until 15:27 on this date; the seven JSON logs on the Pi before that (oldest 2026-07-30) contain no epoch with quality 4 (section 2.1). Kevin has seen a fix in the past. This document gives the hardware identity, the evidence, the ranked causes, the decisive test, and the base-station checklist. A 13-agent research pass produced the causes; a Grok cross-check corrected one of them.

## 1. Hardware

- Kit: DFRobot Gravity GNSS-RTK High Precision Positioning Kit with LoRa, SKU KIT0198 (US 915 MHz variant for Texas). Rover: Quectel LC29HDA behind a DFRobot I2C co-processor at address 0x20 (`pi_app/hardware/rtk_gps.py`). Base: Quectel LC29HBS. Radio: Semtech LLCC68, 22 dBm.
- Bands: GPS/QZSS L1 C/A + L5; GLONASS L1 only; Galileo E1 + E5a; BDS B1I + B2a. Spec: 5 cm + 1 ppm; convergence < 10 s; range up to 1.5 km in the open.
- Base: on the barn roof, about 100 yards (90 m) from the yard. Kevin plugged it in without configuration. Power-cycle history unknown. The base has only a power LED; its state is invisible from the robot.
- The rover LED shows the fix state: 1 Hz blink = state 5, steady = state 4, off = other.

## 2. Evidence (robot parked, disarmed)

| Item | Value | Meaning |
|---|---|---|
| Fix quality | 5 continuously since 12:01; 1 (no corrections) from 11:12 to 12:01 | Corrections started when the robot moved at 12:01 |
| Satellites used | 28–36; HDOP 0.5–0.87 | The code solution is healthy; this says nothing about carrier-phase quality or L5 |
| Differential age | 1.0 s on 119 of 120 epochs, 2.0 s on 1 | Some correction message arrives each second |
| Station id | 3335 | RTCM 1005/1006 from the base decodes |
| Raw `$GNGGA` (register 81/82) | `...,5,30,0.71,38.075,M,-23.838,M,1.0,3335*57` | The receiver itself reports quality 5; the driver decode is correct |
| Raw `$GNRMC` | `...,0.067,076.52,190926,,,F,V*24` | Course 076.52°, speed 0.067 kn, mode F = RTK float; course and speed are available every epoch |
| Register 93 (operation) | 10 | LoRa mode confirmed |
| Register 94 (LoRa serial baud index) | 4 | 19,200 baud between the LoRa radio and the receiver; the air rate is not visible from the rover |
| Register 113 (connect state) | 0 | Meaning undocumented in LoRa mode |
| OAK-D Lite USB link | 480 Mb/s (USB 2) | No USB 3 harmonic near L1/L5 |

### 2.1 First fix, 15:27 (after this document was started)

Kevin drove the robot about 23 m west of its usual parking spot and stopped at 15:07. At 15:27:34, after 20 minutes stationary, the rover reported quality 4 for the first time in any log. It fell back to 5 at 15:27:49, fixed again at 15:34:30, fell to 5 at 15:47:08, and fixed at 15:47:18; it then held 4 with `$GNRMC` mode R, course 324.1, position scatter about 1 cm. Conclusions: the base, the link and the rover can produce a fixed solution; the convergence time (20 minutes against a specification of under 10 seconds) and the drop-outs say the corrections or the carrier-phase quality are marginal, which points at causes 1, 2 and 4 in section 3; the old parking spot never fixed in hours, so it is worse (obstruction, multipath, or LoRa margin) than the new one. The short-baseline test in section 4 and the base checklist in section 5 stay the next steps; the GPS heading aligner can now lock during a straight manual run for the first time.

### 2.2 Fixes happen mostly near sunset (2026-11-08)

The journal (`journalctl -u wall-e | grep fix_quality`) has 32 transitions to quality 4 from 2026-09-19 to 2026-11-08, on 6 days. All of them occur between about 3 hours before and 1 hour after local sunset. None occurs at midday.

CAUTION: The journal is not complete. Its `fix_quality` lines start at 17:57 CDT on 2026-09-19. Section 2.1 records an earlier fix on that day, at 15:27 CDT: 3 h 55 min before sunset, with the sun at about 47°. The daily PV total for 2026-09-19 was 11.2 kWh, which is a normal sunny day for this array. The position was different (23 m west of the usual parking spot). Thus a fix in strong daylight is possible at some spots. The table below does not include that episode.

The fixed share of the time in quality 4 or 5:

| Time relative to sunset | Fixed | Float | Fixed share | Days |
|---|---|---|---|---|
| −5 h to −3 h | 0 min | 347 min | 0 % | 5 |
| −3 h to −2 h | 30 min | 210 min | 12 % | 5 |
| −2 h to −1 h | 53 min | 229 min | 19 % | 8 |
| −1 h to 0 h | 147 min | 196 min | 43 % | 7 |
| 0 h to +1 h | 102 min | 23 min | 82 % | 4 |

The fix window follows sunset across the dates, not the clock time and not the GPS sidereal repeat. Examples: 2026-09-19, fixes 17:58–19:54 CDT, sunset 19:22. 2026-11-07, fixes 16:40–17:59 CST, sunset 17:30. In float, the differential age stays 1.0 s and station id 3335 decodes, with 23–37 satellites. The drive of 2026-11-08, 12:36–14:35, stayed in float the whole time.

Interpretation: a cause that moves with the sun lowers the carrier-phase quality in daylight. Leading suspect: switching noise from the solar power system, radiated by the panel wiring, which stops when production stops. Grok (session `01a1bd0d-4321-7511-a27f-ffcb05efc136`) objects that the step from 43 % to 82 % at sunset is sharper than the fall of PV output, so heat or solar radio noise can also fit. Sampling bias is possible too: the robot is often stationary in the evening.

Layout (Kevin, 2026-11-08): the base antenna is on top of the metal barn roof. The base unit is under it, with a gap, so the sun does not heat it directly. The inverter and charge equipment are in a steel shipping container (conex) below. The PV array is a ground mount, about 20 (unit not stated) from the antenna and the base, lower than both. The base gets its power from the container solar system. Thus noise can also reach the base through its supply (conducted), not only through the air. The container battery ran flat on 2026-11-04 (dark 03:29–07:07). That restarted the base and its survey-in, so RTK coordinates recorded before that date (waypoints) can have an offset. The container shields the equipment itself, but not the cables that leave it: the PV string wiring to the ground mount can radiate the MPPT switching noise. If the cause is solar noise, the base is the more probable victim (it is closer than the rover). A base with bad observations still sends corrections every second, which agrees with the evidence.

### 2.3 Stationary rover against PV power (2026-11-07)

On 2026-11-07 the robot stood disarmed, wheels at 0 rpm, at one spot from 12:22 to 17:59 (`arm_20261107_121745.log`; the spot is about 72 m east and 8 m south of the 12:17 start position). Corrections arrived the whole time (differential age 1.0 s). PV power is from the dashboard history (`/api/solar/history` on the home-auto Pi, 1-minute samples, 48 hours only).

| Time (CST) | PV power | Rover |
|---|---|---|
| 12:20–13:20 | 2.2–2.5 kW | float, 23–30 satellites |
| 13:30–15:20 | about 600 W (battery full, PV curtailed to the load) | float, 27–35 satellites |
| 15:30–16:30 | 500 W falling to 120 W | float, 34–39 satellites, HDOP 0.4–0.5 |
| 16:40 | about 100 W | **fixed** |
| 16:40–17:58 | 100 W falling to 0 W | fixed, with 4 short drops to float |
| 17:59 | 0 W | robot moved; the session ended |

Sunset was 17:30. The battery inverter carried about 600 W of AC load all evening while the rover held the fix. Thus the AC side of the inverter is not the noise source. If solar is the cause, the source is the PV side: the MPPT and the PV string wiring.

This day removes two explanations: the robot did not move (no sampling bias), and the spot did not change. It does not separate PV power from sun elevation: both are low at 16:40 (the sun was at about 9°). The step at 13:30 (2.4 kW to 600 W, still float for 3 hours) shows that the noise, if it is the cause, does not scale simply with power. A curtailed MPPT still switches. On 2026-11-08 (overcast, PV 200–400 W at midday) the rover stayed float, so a threshold must be below about 150 W.

Counter-evidence: the 2026-09-19 fix at 15:27 CDT (sections 2.1 and 2.2) occurred on a sunny day, at a different spot. The dashboard keeps only 48 hours of PV power, so the PV power at that time is not known here. Solar Assistant keeps a longer history. If the PV power was high at 15:27 on 2026-09-19, then PV noise is not the full cause: at most it removes the last margin at a marginal spot.

Satellite geometry (multipath from the metal roof) repeats about 4 minutes earlier each day. The journal fix times moved with sunset instead: 2026-09-19 at 16:58 CST, 2026-11-07 at 16:40 CST. A sidereal repeat would have moved them about 3 hours earlier over those 49 days. The two spots are different, so this comparison is weaker than a comparison at one spot. It still argues against fixed multipath geometry as the cause of the window.

Separate observation (2026-11-08): the robot stood disarmed within about 12 m of the 2026-11-07 spot from 13:03 to 14:24, and the corrections stopped (quality 2, differential age 0, 19–24 satellites). They came back at 14:24. At the garage area (about 70 m west) there are no corrections either. The cause (LoRa link, base power, or a base restart) is not known yet. A base restart starts a new survey-in, which changes the reference position.

Second opinion: Grok session `01a1bd64-c194-7123-bf11-03ff1cd48f16` agreed with a PV-only test and supplied the curtailment objection, the off-on-off sequence and the base-power check below.

Decisive test (Kevin runs it, clear day, near solar noon):

1. Park the robot at the 2026-11-07 spot. Do not move it during the test.
2. The base gets its power from the container solar system, so the inverter must stay on during the test (step 3 keeps it on).
3. Stop the PV input and keep the inverter on to supply the load from the battery. CAUTION: Do not open a DC disconnect under load unless it is load-break rated. A DC arc at string voltage does not stop like an AC arc. The safer sequence: disable PV charging in the inverter menu if it has that control. Or let the battery fill (PV then curtails to the load) and open a load-break-rated PV switch.
4. Keep the PV input off for 20–30 minutes. Then turn it on again. Do the off-on cycle two times.
5. Result: a fix within a few minutes of PV off, and float within about a minute of PV on, means PV noise. The sun's elevation and the temperature do not change that fast.
6. If the rover stays float with PV off, restart the rover one time with PV still off (a filter can stay bad after the noise stops). If it is still float, move the base antenna off the roof or run the base on a battery away from the array for one midday hour. That separates roof multipath from inverter noise.

Do not swap the base to a power bank as a first test (Grok session `01a1bd74-8f67-7620-b6d9-b728f30cdc6d`). The swap restarts the base and its survey-in. A boost converter at 5 V is not a quiet supply. A float result removes nothing, because the PV wiring still radiates. The PV-off test covers both the conducted and the radiated path, and the base stays powered.

Monitor options (2026-11-08). The base has no documented data port: the DFRobot wiki lists only Type-C power, a 5–10 V terminal, the SMA antenna connector and a power LED. Radio facts from the wiki: Semtech LLCC68, 915 MHz, 22 dBm, "pre-configured", and one base serves several rovers. Spreading factor, bandwidth, sync word, channel and framing are not documented. Order (Grok session `01a1bd79-cdaa-7d51-a49e-e51e3ac13d3a`):

1. The robot is the free monitor. It logs fix, satellites and differential age while parked and disarmed (verified in `arm_20261107_121745.log`). Park it at the 2026-11-07 spot on clear days and join its log to `pv_power`. It shows correlation, not the mechanism.
2. A receive-only 915 MHz listener (an ESP32 board with an SX1262 radio) on Wi-Fi, in channel-activity or RSSI mode, logged beside `pv_power`. It needs no decode to tell whether the base is on the air. Bursts present with a dead differential age at the robot means the base transmits and the robot does not use it. No bursts means the base radio or its power. Board (picked 2026-11-08, Grok session `01a1bd7f-f62e-71f3-9005-ff44f9cb313c`): Heltec WiFi LoRa 32 V3, US915. WARNING: The firmware must never call a transmit function; a transmitter on 915 MHz can jam the base link. The V3 needs Vext on (active low) and the RF switch set to receive (SX1262 DIO2), or it hears nothing.
3. Decode the link with the same listener: find the frequency by RSSI, then try spreading factor, bandwidth and sync word until packets decode, and look for RTCM3 frames (preamble 0xD3). If that works, the RTCM stream shows base restarts (a changed 1005 coordinate), the byte rate, and (with MSM4 or MSM7) the base's signal strength. The decoded stream can also feed a home-built rover (any dual-band RTK module). Risk: an unknown framing or frequency hopping. CAD and RSSI see only the frequency, spreading factor and bandwidth that are programmed, so the search is a sweep (902–928 MHz, SF5–SF11, BW 125/250/500 kHz, both sync words, both IQ settings). An implicit header, a custom sync word or hopping can stop the decode while CAD still fires. If the sweep finds nothing, the next tool is a USB SDR waterfall, not another LoRa board.
4. A second KIT0198-US is the plug-and-play rover. The wiki suggests that one base serves any number of rovers, but that a rover from another kit hears this base is not verified. Ask DFRobot before buying. Never re-pair the robot's rover to another base.

### 2.4 Listener results (2026-11-12)

The receive-only listener of option 2 is built: Heltec WiFi LoRa 32 V3,
firmware in `~/Documents/walle/heltec_lora_listener/` (outside this
repository). It runs on the outdoor Wi-Fi near the barn as
`lora-listener.local` (192.168.84.115), with a network console on port 23
and over-the-air updates. At boot it logs a 10 s summary of the base's
bursts.

Results:

1. The base is on the air. It sends a group of 9-10 short LoRa packets
   once per second (fixed 33.3 ms slots, about 263 ms per group), centred
   near 915.01 MHz. The level is about -68 dBm at the house and about
   -40 dBm near the barn (SNR about +9 dB). The listener hears this every
   second.
2. Radio settings: LoRa, SF5, 500 kHz, sync word 0x12, explicit header,
   CRC on. The packets decode with a valid LoRa CRC.
3. The payload is not plain RTCM3; the kit's own framing hides it. We do
   not try to read the payload. Ask DFRobot for the RTCM message set if it
   is needed (cause 2 in section 3).
4. The robot's logs agree: every drive of 2026-11-06 to 2026-11-08 shows
   reference station 3335 and a differential age of 1.0 s while
   corrections arrive. But corrections were missing for long stretches:
   87 % of the rows on 2026-11-07 evening, and 100 % while the robot is in
   the garage (2026-11-11 and 2026-11-12).

Conclusion: the base and its radio work. The weak point is reception at
the robot. Next checks: the rover's LoRa antenna (connected, vertical,
clear of the chassis and the battery), and a reception map. Carry the
listener (or log it next to the robot) where the robot drives, and
compare its burst count with the robot's differential age at the same
time. Bursts at the listener with a dead differential age at the robot
means the rover's antenna or radio.

A firmware defect in the first listener build hid all packets for a few
hours: the receive loop restarted the radio on every interrupt,
including "preamble detected". Version 1.2.0 raises the interrupt line
only for reception outcomes.

The test is faster and more certain with per-satellite carrier-to-noise density (C/N0) in the log, which the rover driver does not read yet (GSV sentences, possibly in `get_all_gnss()`, register 91). With C/N0, compare the midday value with the value near sunset, and compare satellites near the sun with satellites far from it (solar radio noise).

## 3. Ranked causes

1. HIGH. Incomplete correction epochs on the air. RTCM 1005 is about 20 bytes and keeps the differential age at 1 s by itself, while the MSM observation blocks (about 900 B/s for four constellations at MSM4) are truncated or dropped by a LoRa air rate set for range, not throughput (the LLCC68 goes down to 1.76 kb/s). Confirm with the short-baseline test (section 4) and by decoding the RTCM stream at the base output. Fix: raise the air rate (Emlid recommends about 9 kb/s for RTK), and cut the payload to GPS + Galileo, L1 + L5/E5a, MSM4 at 0.5–1 Hz, station coordinates at 0.1 Hz.
2. HIGH. L1-only intersection. GLONASS has no L5. If the base sends only L1/E1/B1I observations, or an antenna at either end is an L1-only patch, the rover resolves ambiguities on one frequency, which commonly ends in permanent float. 30+ satellites used is what four-constellation L1 tracking looks like. Confirm with per-satellite signal ids (GSV) from the full NMEA buffer or a UART tap; fix with L1/L5 antennas at both ends and an L5/E5a MSM set.
3. MEDIUM. Base coordinate not frozen. The LC29HBS default survey-in is 43,200 epochs (12 hours) and the base transmits while it surveys. CORRECTION from the Grok cross-check: a running mean moves the coordinate by about 0.3 mm per epoch after two hours, which cannot block a fix by itself; a frozen but wrong coordinate still gives quality 4. The only way this blocks a fix is an engine that restarts on each coordinate change. The fix is the same and takes five minutes at the base UART: freeze the coordinate (`$PQTMCFGSVIN` with a fixed position, or a 300-epoch survey-in that then locks). Do not wait 12 hours.
4. MEDIUM. Rover carrier-phase quality: GNSS antenna without a ground plane, multipath from the robot, broadband noise from the Pi, the VESCs and the BMS radio in the same enclosure. Satellite count and HDOP cannot show this. Confirm with the short-baseline test with the compute powered down.
5. MEDIUM. Base antenna sky view and multipath (metal roof, eaves). Confirm with the base's own NMEA on its UART and a sky photo.
6. LOW. Message set gaps (no 1230 with GLONASS MSM; infrequent 1005), MSM7 versus MSM4, receiver mode, or firmware. Confirm by decoding the RTCM stream.
7. RULED OUT. Driver decode (the raw GGA agrees with register 19). Packet loss at the parking spot (119/120 epochs on time). USB 3 interference (the OAK runs at USB 2). CORRECTION 2026-11-06: at USB 3 the OAK does jam the RTK GPS (10 to 11 satellites and no RTK, against 32 to 34 with float at USB 2). The OAK is capped at USB 2 since then.

The gates stay as they are: `WaypointNavConfig.min_rtk_quality = 4` and the aligner's `== 4` check are correct. Float is decimetre-to-metre accuracy and must not establish heading lock. Consequence: the GPS heading aligner has never locked, so the robot has run on gyro-only heading with no north reference since at least July. CORRECTION: the aligner has locked since then, first in the evening of 2026-09-19, when a waypoint run also succeeded. The heading is gyro-only whenever RTK is not fixed.

## 4. Decisive test: short baseline

WARNING: This test moves the robot. Kevin does it, and says when he starts.

1. Look at the rover LED. A 1 Hz blink confirms state 5 from the module itself.
2. Carry or drive the robot to within 5–10 m of the base antenna, with clear sky at both ends. If possible, power down the Pi, the OAK and the VESCs, or lift the GNSS antenna onto a metal disc away from the robot.
3. Wait 15 minutes. Watch the LED (or the dashboard `gps_fix`).
4. Result A: fixed near the base, float at the parking spot → baseline, link margin or robot noise. Raise the LoRa air rate; check the LoRa antennas; move the GNSS antenna onto a ground plane.
5. Result B: still float near the base → base configuration, base antenna, or the message set. Go to section 5.

## 5. Base-station checklist

1. Power LED on? When was it last power-cycled? Has it ever run for hours without interruption?
2. Photograph the sky from the antenna position. Note metal within 2 m, the roof, the eaves, and whether the antenna sits on a ground plane.
3. Confirm both LoRa antennas are screwed on, vertical, and clear of metal. Confirm both radios are the 915 MHz US variant.
4. Get a USB-TTL adapter on the base UART (LC29HBS). CAUTION: the base has no documented data port (2026-11-08); this step needs the case open and the module pinout. Do it on a bench, never on the roof. Read `$PQTMVERNO` (firmware) and `$PQTMCFGSVIN,R` (survey-in mode and stored position). Log the transmitted 1005/1006 coordinate for several minutes: frozen or moving?
5. Freeze the coordinate: `$PQTMCFGSVIN,W,1,300,15,0,0,0` (300-epoch survey-in, then lock) or a fixed position. Save and power-cycle to confirm it persists.
6. Decode the RTCM stream (RTKLIB `str2str`, `pyrtcm`): list every message number and rate. Required: 1005 or 1006; MSM for each constellation in use; 1230 if GLONASS MSM is sent.
7. Size the stream against the radio: measure bytes per second; read the spreading factor, bandwidth and air rate at both ends; they must match, and the air rate must exceed the payload with margin.
8. Make it permanent: bolt the antenna, record the coordinate, give the base an always-on supply, and stop power-cycling it.
9. Rover side: put the GNSS antenna on a 100 mm metal ground plane, as far from the USB run, the VESCs and the Pi as the harness allows.

## 6. Software changes (in progress, branch fable-follow-fixes)

- Log every fix-quality transition at WARNING with UTC, satellites, HDOP, differential age and station id.
- Parse UTC and geoid separation from the bytes already read; read course and speed over ground from the RMC sentence (registers 83/84) and log them; do not feed them into control yet. DONE: the items are in `main`. `cog_deg` and `sog_mps` feed `GpsHeadingAligner.update_cog()` in `pi_app/control/controller.py`.
- Publish low-quality epochs instead of discarding them, so a fix loss is visible.
- Poll at 5 Hz and dedupe on the UTC second (the 1 Hz poll aliases against the 1 Hz output).
- Verify the LoRa-mode register instead of writing it blind; log at WARNING.
- Health counters and bus reopen on repeated I2C errors.

## 7. Sources

- DFRobot wiki KIT0198: https://wiki.dfrobot.com/kit0198-eu/ and https://wiki.dfrobot.com/GNSS_RTK_High_Precision_Positioning_Kit_SKU_KIT0198_EN
- DFRobot product page (US 915 MHz): https://www.dfrobot.com/product-2970.html
- Vendor library: https://github.com/DFRobot/DFRobot_RTK_LoRa
- Quectel forum, LC29HBS float to fixed: https://forums.quectel.com/t/float-rtk-mode-to-fixed-rtk-using-lc29hbs-and-lc29hda/37451
- RTCM MSM bandwidth reference: https://www.kalmixtech.com/blogs/blog/an002-rtcm-3-frame-structure-msm-reference

## Appendix: Technical Names

DFRobot, KIT0198, Gravity, Quectel, LC29HDA, LC29HBS, Semtech, LLCC68, LoRa, RTCM, MSM4, MSM7, RTK, GNSS, GPS, GLONASS, Galileo, BDS, QZSS, L1, L5, E1, E5a, B1I, B2a, HDOP, NMEA, `$GNGGA`, `$GNRMC`, `$GNVTG`, GSV, `$PQTMCFGSVIN`, `$PQTMVERNO`, RTKLIB, `str2str`, `pyrtcm`, Emlid, I2C, UART, USB-TTL, USB 2, USB 3, OAK-D Lite, VESC, BMS, Pi, `rtk_gps.py`, `min_rtk_quality`, survey-in, ground plane, Kevin, Grok.
