gruMoses/wall_e-Mini/docs/gps_heading_alignment.md

# GPS Course-Over-Ground Heading Alignment

The OAK-D Lite BMI270 has no magnetometer. Integrated-gyro heading is relative to
startup orientation and drifts over time. **GPS heading alignment** learns a
scalar offset from RTK course-over-ground (COG) while the robot is actually
moving, so:

```text
corrected_heading_deg = (raw_imu_heading_deg + offset_deg) mod 360
```

is referenced to true north. The aligner never commands motors — it only
maintains this offset for consumers (waypoint nav, straight-drive heading hold).

## When the offset locks

All gates must pass on **distinct GPS samples** (deduped by `GpsReading.timestamp`):

| Gate | Default (`config.gps_heading_align`) | Meaning |
|---|---|---|
| `enabled` | `True` | Feature on |
| `min_fix_quality` | `4` | **RTK fixed only** (not float/GPS/DGPS) |
| `min_distance_m` | `0.8` | Displacement in rolling window |
| `min_speed_mps` | `0.12` | COG speed from GPS sample timestamps |
| `history_seconds` | `8.0` | Rolling GPS window |
| manual forward-straight intent | required | Both RC tracks must command forward; equal reverse never qualifies |
| `max_lock_yaw_rate_dps` | `3.0` | Curved/turning motion clears lock history |

Fix quality in this codebase (`rtk_gps.py`): `0=none`, `1=GPS`, `2=DGPS`,
`4=RTK fixed`, `5=RTK float`.

After lock, the offset is **frozen**. The aligner keeps it for the life of the
process, including disarm. A service restart or an IMU frame break clears it
(see "Lock persistence and verification" below). Continuous
EMA refinement is disabled: the 2026-07-12 field trace proved that GPS COG
during a turn is not the robot body heading and drove the offset through nearly
200°, producing a self-sustaining circle.

Before lock, RTK dropout (quality ≠ 4) clears history on a new sample.
Once locked, `update()` is a pure no-op until `reset()`, preserving the frozen
offset and history. Duplicate GPS timestamps are ignored. Out-of-order
timestamps clear unlocked history (fail-closed).

## Armed session lifecycle

The lock outlives the armed session. `Controller._on_armed_session_ended()`
runs on each transition that **ends an armed session**, and it keeps the lock:

- Manual RC disarm (ch3 low)
- RC link stale (>1 s)
- Emergency stop (ch5 latched)

The emergency stop is a special case. The same event schedules
`sudo shutdown -h now` 5 s later. The Pi halts, the process ends, and the lock
is gone.

`GpsHeadingAligner.reset()` runs in one place: the IMU frame check in the
controller (see "Lock persistence and verification" below). A service restart
also starts unlocked. After a reset or a restart, drive forward on RTK fixed to
re-lock before waypoint missions.

## Waypoint navigation gate (field test)

When heading alignment is **enabled** and both GPS + IMU are available,
`/api/nav/start` and `/api/nav/go` return **409** with
`heading_alignment_not_locked` until the aligner has locked.

Independently of the heading-align gate, waypoint activation and every runtime
navigation update require exactly fix quality **4** when
`waypoint_nav.min_rtk_quality = 4`. RTK float (quality **5**) returns
`gps_quality_not_trusted` at activation and commands zero motion if quality
drops during a mission. The existing stale-GPS timeout remains in force.

Start refusal reasons (2026-11-10, `Controller.waypoint_nav_activation_blocked()`).
The check runs in this order, and the first problem is the reason:
`waypoint_nav_unavailable`, `gps_state_unknown` (no GPS reading yet, for
example right after a restart), `gps_stale` (the reading is older than
`waypoint_nav.stale_timeout_s`, 3 s by default, or its age is unreadable),
`gps_quality_not_trusted`, `vision_stale` (the detection stream is older
than `OakDetectionConfig.vision_stale_s`; the person stop would be blind),
then the heading check: `heading_unavailable` (alignment is required but
there is no IMU compensator), `heading_alignment_not_locked`, and
`heading_stale` (the heading is older than `waypoint_nav.heading_stale_s`,
0.5 s by default, or its age is unknown). The `/navigate` page shows a
message for each reason (`pi_app/web/waypoint_nav_ui.py`).

Run end reasons (2026-11-10). While WAYPOINT_NAV runs, the controller checks
the same conditions on every tick. If one fails, it sets the mode to MANUAL,
the sticks have control, and the route and index stay. The reasons are
`vision_stale`, `heading_lock_lost` (the lock is gone; it is the in-run
name of `heading_alignment_not_locked`), `heading_stale`,
`heading_unavailable`, and `align_timeout` (ALIGN lasted longer than
`waypoint_nav.align_timeout_s`, 10 s by default). The reason is in the
controller telemetry key `waypoint_nav_exit_reason` and in the journal line
`WAYPOINT_NAV stopped: <reason>`. Refer to `docs/logging_troubleshooting.md`.

When alignment is disabled (`gps_heading_align.enabled = False`) or the GPS/IMU
stack is absent, waypoint nav behaves as before, except for the GPS and vision
checks above.

The `/navigate` pre-run validation panel shows **GPS heading alignment locked**
when the gate applies.

## Operator observability

| Field | Where | Meaning |
|---|---|---|
| `heading_offset_deg` | SSE, JSON log, MCAP | Learned IMU→true-north offset |
| `heading_offset_locked` | SSE, JSON log, MCAP | `True` once COG lock succeeded |
| `heading_offset_frozen` | SSE, JSON log, MCAP | `True` after the one-shot lock |
| `heading_offset_refining` | SSE, JSON log, MCAP | Always `False` in this tranche |
| `corrected_heading_deg` | SSE, JSON log, MCAP | True-north heading from raw IMU |
| `heading_align.last_cog_deg` | SSE, JSON log | Last trusted GPS track bearing |
| `heading_align.last_speed_mps` | Controller telemetry dict | Last COG speed used |
| CLI `HDG_OFF(+12.3° F)` | journalctl heartbeat | Offset and frozen state |

Dashboard heading card shows `raw° → corrected°` when locked.

## Field gate checklist (upcoming validation)

1. Arm on level ground with RTK fixed (fix quality **4**).
2. Drive forward straight ≥1 m with equal manual RC commands — confirm
   `heading_offset_locked=true`, `heading_offset_frozen=true`, and CLI
   `HDG_OFF(… F)`.
3. Command a short turn; confirm the offset does not change.
4. Start waypoint nav — it must succeed only after lock.
5. Disarm — the offset is kept (`HDG_OFF(… F)` stays); the next arm does not need a new drive to lock. A service restart clears it.
6. Run a short waypoint mission — compare cross-track error vs pre-alignment baseline.

Disable the gate temporarily with `gps_heading_align.enabled = False` in
`config.py` (service restart required).

## Per-epoch course-over-ground lock (2026-09-19)

The displacement method above needs a straight command on both tracks and a straight path for 8 s. A single mixed RC stick and uneven ground make that unreliable. The receiver reports its own Doppler course over ground each epoch (`GpsReading.cog_deg`, from `$GNRMC`). `GpsHeadingAligner.update_cog()` pairs each epoch's course with the IMU heading at that instant. Each pair gives one offset sample; a wobble moves the course and the heading together, so the samples still agree.

Gates (all fail-closed):

- RTK fixed only (`min_fix_quality`). A fix loss clears the candidate samples.
- Forward intent: both tracks last commanded above neutral + 6 bytes, in MANUAL mode, from the RC or the phone. A reverse run would give a course 180 degrees from the heading.
- Speed over ground at least `cog_min_speed_mps` (0.3 m/s). The Doppler course is noise below that.
- Yaw rate at most `cog_max_yaw_rate_dps` (6 degrees per second).
- Lock when `cog_min_samples` (6) samples inside `cog_window_s` (20 s) have a circular standard deviation at most `cog_max_spread_deg` (8 degrees). The circular mean becomes the frozen offset; `lock_source` reports `"cog"`.

Procedure: with the robot armed and the fix at 4, drive forward at walking pace for about 10 seconds. The path does not need to be straight. The nav page shows "GPS heading alignment locked" and the journal shows the lock line with the sample count and the spread.

The displacement method stays in place; either method can lock first. The offset stays frozen for the life of the process, including disarm.

### Lock persistence and verification (2026-09-19)

The lock is kept across disarm and RC stale within one service run (Kevin's decision). A ch5 e-stop does not keep it: that e-stop halts the Pi 5 s later (`sudo shutdown -h now`), and the halt ends the process. The IMU boot frame is continuous across disarm and RC stale: the gyro keeps integrating, ZUPT holds the heading while the robot is parked, and the tracked bias keeps it honest. Two guards replace the old reset:

1. Verification. While locked, qualifying epochs keep feeding the course-over-ground window. When six epochs agree with each other (spread at most 8 degrees) but disagree with the frozen offset by more than `cog_verify_max_error_deg` (15 degrees), the offset moves to the new value, `lock_source` becomes `"cog-relock"`, `relock_count` increments, and the journal shows a WARNING. Verification happens only in MANUAL mode under the same gates as the lock, so a waypoint run never changes the offset.
2. Frame discontinuity. Once per second the controller reads the OAK IMU health counters `oak_reconnect_count` and `count_cum_reset`. If either changes while locked, the lock is dropped with a WARNING, because rotation during an outage can be lost. Drive forward at RTK fixed to relock.

A service restart still starts unlocked.
