gruMoses/wall_e-Mini/docs/depthai_upgrade.md

# depthai upgrade: 3.3.0 to 3.6.1 or later

Status: DONE 2026-11-05 17:29. The robot runs depthai 3.6.1 (user
site-packages). Steps 1 to 7 passed; the results are in section 4. This
procedure is for Kevin and Claude together, with the robot on the test stand.

## 1. Why upgrade

- depthai 3.3.0 aborts the process when the OAK drops off USB during a
  session (`Resource deadlock avoided` in `PipelineImpl::wait`). systemd
  restarts wall-e. If the camera is not back yet, wall-e starts without it
  ("OAK-D Lite not detected") and runs with no obstacle avoidance and no
  follow-me until the next restart. This happened on 2026-11-05 at 14:59.
- The fix is in depthai 3.6.0 and later (PR luxonis/depthai-core#1723). Refer
  to `docs/NEXT_SESSION.md`, the depthai teardown item.
- Later versions add record and replay with calibration (3.6.1), newer YOLO
  parsers, and an `Odometry` message for VIO (3.11). Refer to section 0 of
  `docs/oak_d_lite_capability_audit.md`.

## 2. The two silent changes, and what the code does about them

| Change in depthai 3.6.1 | Effect on WALL-E | Protection in the code |
|---|---|---|
| The `RAW` IMU reports come directly from the IMU. Before, they were rotated into the RDF frame. `UNCALIBRATED` is the old behaviour. | The yaw channel (`gyro_y`, +Y down) and the boot gravity check assume RDF. With `RAW` on 3.6.1, the yaw axis can move or change sign. | `oak_depth.imu_report_names()` requests `RAW` before 3.6.1 and `UNCALIBRATED` from 3.6.1. Startup logs the choice. |
| AutoCalibration runs at pipeline start by default. | It can change the calibration that the corridor and the person geometry use. | `oak_depth.py` sets `DEPTHAI_AUTOCALIBRATION=OFF` unless the variable is already set. Startup logs the value. |

Source: the depthai v3.6.1 release notes and the 3.6.1 `IMUSensor` stubs.
3.3.0 has no `ACCELEROMETER_UNCALIBRATED`, so 3.3.0 must keep `RAW`.

`requirements.txt` pins `depthai==3.6.1` (3.3.0 before 2026-11-05). `bin/auto_deploy.sh` does not run
`pip install`, so the pin does not change the robot by itself.

## 3. Startup line to look for

Each OAK session logs one line at WARNING level:

```
OAK device: depthai 3.3.0, USB SUPER, IMU reports ACCELEROMETER_RAW + GYROSCOPE_RAW, DEPTHAI_AUTOCALIBRATION=OFF
```

This example is from before the upgrade. Today the line shows depthai 3.6.1 and `USB HIGH (cap HIGH)`.

Read it with `sudo journalctl -u wall-e -b | grep "OAK device"`.

## 4. Procedure

CAUTION: The OAK allows one process at a time. Each step that runs a tool
needs `wall-e.service` stopped. Get Kevin's permission to stop it, with the
robot disarmed.

1. Record the baseline on 3.3.0. Stop wall-e. Run
   `python3 tools/depthai_upgrade_check.py` with the robot at rest on a level
   floor. Keep the output. The expected result is PASS: fx 456.89, cx 334.95,
   and the `RAW` family with gravity on -Y.
2. Install the new version for the user that runs wall-e (it uses the
   system `python3` with the user site-packages):
   `python3 -m pip install --user --break-system-packages depthai==3.6.1`
   (the system Python is marked externally managed). Do not use 3.12.0 for the
   first step. To go back, install `depthai==3.3.0` the same way.
   Before this step, test 3.6.1 without changing what wall-e uses: a copy
   is staged in `/home/pi/depthai-3.6.1` (installed 2026-11-05 with
   `pip install --no-deps --target`; it imports, and it has `BasaltVIO` and
   the `UNCALIBRATED` reports). Run a tool on it with
   `PYTHONPATH=/home/pi/depthai-3.6.1 python3 tools/depthai_upgrade_check.py`.
   wall-e still imports 3.3.0 from the user site-packages.
3. Run `python3 tools/depthai_upgrade_check.py` again. The expected result is
   PASS, with the `UNCALIBRATED` family showing gravity on -Y, and the same
   fx and cx. If the robot's family does not show gravity on -Y, stop and go
   back to 3.3.0.
4. Start wall-e. Read the "OAK device" line (section 3). It must show
   `UNCALIBRATED` and `DEPTHAI_AUTOCALIBRATION=OFF`.
5. Run the chalk SIGN test (`docs/heading_tuning.md`). A right turn must
   increase the heading. If the sign is wrong, fix it at the reader. Do not
   add an inversion downstream.
6. Check vision on the stand: camera health HEALTHY, `oak.det_latency_s` near
   0.20 s at idle, person detections, depth corridor, no colour-stall
   restarts in 10 minutes.
7. Unplug and replug the OAK once, with the robot disarmed. wall-e must stay
   up (no abort in the journal), and the camera must come back by itself.
8. Change the pin in `requirements.txt` to the version that passed. Record
   the results in this document.

### Results, 2026-11-05 17:09 (steps 1 and 3, robot at rest on the stand)

`tools/depthai_upgrade_check.py`, wall-e stopped, the 3.6.1 run from the
staged copy. Both runs: USB SUPER, DEPTHAI_AUTOCALIBRATION=OFF, CAM_A
fx 456.89 cx 334.95, RESULT PASS.

| depthai | Report | Accelerometer (g) | Gravity | Gyro at rest (deg/s) |
|---|---|---|---|---|
| 3.3.0 | RAW (the robot's) | (-0.009, -0.988, -0.046) | -Y | (+0.232, -0.643, +0.127) |
| 3.3.0 | CALIBRATED | refused: "BMI270 supports only ACCELEROMETER_RAW and/or GYROSCOPE_RAW" | | |
| 3.6.1 | RAW | (-0.009, +0.988, +0.047) | +Y | (+0.210, +0.598, -0.161) |
| 3.6.1 | UNCALIBRATED (the robot's) | (-0.009, -0.988, -0.048) | -Y | (+0.218, -0.546, +0.146) |
| 3.6.1 | CALIBRATED | (-0.009, -0.988, -0.048) | -Y | (+0.227, -0.523, +0.134) |

The 3.6.1 RAW frame has Y and Z reversed against the old RAW (a half turn
about X), so `gyro_y` changes sign. Without the version gate the heading
would turn the wrong way, or be saved only by the inverted-mount sign from
the gravity check. 3.6.1 UNCALIBRATED matches 3.3.0 RAW. 3.6.1 also accepts
CALIBRATED on the BMI270, which 3.3.0 refused; it is a later option.

### Results, 2026-11-05 17:29-17:50 (steps 2 and 4 to 7)

- Step 2: `pip install --user --break-system-packages --no-deps
  depthai==3.6.1` with wall-e stopped (17:29).
- Step 4: `OAK device: depthai 3.6.1, USB SUPER, IMU reports
  ACCELEROMETER_UNCALIBRATED + GYROSCOPE_UNCALIBRATED,
  DEPTHAI_AUTOCALIBRATION=OFF`. Boot gravity: `+Y points DOWN (ay=-0.99 g)
  ... yaw_axis_sign=+1`. Gyro bias y -0.61 deg/s (3.3.0: -0.64).
- Step 5 (sign, by hand, disarmed, on the ground): a right turn of about
  90 degrees moved the heading 352 to 82 (+90); the turn back moved it 82 to
  351 (-91). PASS. The chalk magnitude test was not repeated; the frame and
  the gyro scale did not change (step 3).
- Step 6: camera HEALTHY, idle `oak.det_latency_s` p50 0.183 s, p90 0.206 s
  (3.3.0: 0.196 / 0.211), depth 15 fps, no colour-stall restarts.
- Step 7 (17:33, disarmed, on the stand): Kevin pulled and replugged the
  camera. wall-e stayed up (`NRestarts=0`, no abort). The session restarted
  itself and the camera was HEALTHY at 17:34:02, at USB 3, about 7 s after
  the replug. On 3.3.0 the same unplug aborted wall-e (14:59 the same day).
- Step 8: `requirements.txt` pins `depthai==3.6.1` (2026-11-05).

Rollback: stop wall-e, `python3 -m pip install --user
--break-system-packages --no-deps depthai==3.3.0`, start wall-e. The code
selects the IMU reports for either version.

## 5. Visual-inertial odometry (VIO) probe

`tools/vio_probe.py` runs depthai's `BasaltVIO` node and only logs the pose
to `logs/vio_probe_*.csv`. It does not control the motors. `BasaltVIO` is in
the Python API of both 3.3.0 and 3.6.1 for the Pi (aarch64 wheels, checked
2026-11-05). It runs on the Pi, not on the camera.

CAUTION: Do not give VIO control authority until the logged runs show that it
is better than the gyro. A featureless view or netting over the lens can
blind it.

Runs to do (wall-e stopped, robot moved by hand or on the stand):

1. Parked for 60 s: the yaw and position drift at rest.
2. A 90 degree right turn on the chalk marks: the yaw change and its sign.
3. A straight push along a tape: the distance against the tape.
4. The CPU figure that the tool prints, at 30 fps and at 60 fps.

### Results, 2026-11-06 16:44-16:57 (outdoors on gravel, OAK at USB 2)

Kevin pushed the robot by hand. wall-e was stopped. CSV files are in
`logs/vio_probe_20261106_*.csv` on the robot. The VIO yaw is
counter-clockwise-positive (world Z up), so a right turn is negative.

| Run | IMU reports | Result |
|---|---|---|
| Parked 75 s, 30 fps | UNCALIBRATED | yaw within 0.16 deg, position within 3.4 cm; 27.5 poses/s; 100 % of one core |
| 90 deg right turn | UNCALIBRATED | FAILED: 6 m of false travel during the turn; yaw reached -105 deg, then wandered to -46 deg with the robot still |
| 90 deg right turn | RAW | -90.3 deg at the end of the turn, then -90.6 deg for 65 s; 1.1 m position shift (the camera is ahead of the pivot point) |
| 7 m straight push (tape measure, two markers) | RAW | 6.79 m (-3 %); yaw drift -2.8 deg over the push; steady after the stop |
| Parked 45 s, 60 fps | RAW | yaw 0.0 deg, position within 3 cm; the dogs ran through the view; about 42 poses/s (USB 2 limit); 127 % of one core |

Findings:

- **BasaltVIO needs the RAW IMU reports on depthai 3.6.1.** RAW is the
  sensor's own frame, which the EEPROM IMU extrinsics describe. The
  UNCALIBRATED reports that wall-e uses (the old RDF frame) look correct
  at rest and fail during rotation. `tools/vio_probe.py` defaults to
  `--imu-report raw` since 2026-11-06. wall-e's own heading still uses
  UNCALIBRATED (section 2); do not change that for VIO.
- 30 fps fits USB 2. At 60 fps USB 2 delivers about 42 poses/s.
- CPU: 100-156 % of one core at 30 fps (system 27-37 % of four cores at
  60 fps). Measure the cost again before VIO runs beside wall-e.
- The surface was gravel, which has much texture. A grass field and
  netting over the lens are not tested.
- Not yet compared: VIO against the gyro heading in the same run (the probe
  logs VIO only), and VIO beside wall-e's own pipeline (one process can use
  the camera; VIO must move into wall-e's pipeline for that).

### VIO inside wall-e (log-only, 2026-11-06)

`OakDetectionConfig.vio_enabled` (default False) adds a BasaltVIO node to
wall-e's own camera session. It logs to the `vio` block
(`docs/logging_troubleshooting.md`) and has no control authority.

- The IMU node has one accelerometer slot and one gyroscope slot, so with
  VIO on wall-e requests RAW and `_poll_imu` negates y and z. On 3.6.1 that
  gives the UNCALIBRATED (RDF) values the heading uses (the bench numbers
  in section 4). `BasaltVIO.setImuExtrinsics` cannot do this from Python:
  `TransformData` has only an empty constructor in the 3.6.1 bindings.
- VIO shares the 640x400 mono outputs (at `camera_fps`, 15 fps) and the
  100 Hz IMU. Its inputs drop instead of blocking.
- Fallbacks: a VIO build failure, or any start failure of a session that
  tried VIO (including a failure to enable RAW), or two VIO sessions in a
  row that end within 60 s, disable VIO until the next process start. The
  next camera session then runs on UNCALIBRATED without VIO.
- Startup line: `IMU reports ACCELEROMETER_RAW + GYROSCOPE_RAW (y/z flipped
  to RDF), VIO on`.
- Before `vio_enabled = True` on the robot: `tools/vio_wall_e_bench.py`
  with VIO off and on (latency, depth fps, IMU packets/s, gravity sign,
  CPU); after the switch, the hand-turn heading sign test (section 4, step
  5) and the boot gravity line.

Bench 2026-11-06 17:52-17:55 (`tools/vio_wall_e_bench.py`, robot parked,
wall-e stopped, OAK at USB 2, 45 s each, first 10 s not counted):

| | VIO off | VIO on |
|---|---|---|
| `det_latency_s` p50 / p90 | 0.181 / 0.207 s | 0.209 / 0.237 s |
| depth fps (median) | 15.0 | **10.0** |
| detection fps (median) | 15.0 | **12.0** |
| IMU packets/s into the heading | 99.2 | 99.4 |
| `ay` (gravity, RDF) | -9.70 m/s^2 | -9.71 m/s^2 |
| VIO poses/s | - | 11.0 |
| VIO roll / pitch, frame_ok | - | 0.4 / -2.2 deg, True |
| process CPU | 49 % of one core | 82 % of one core |

Result: the RAW + y/z flip path is correct (same gravity, same IMU rate,
the VIO world is level). But VIO takes a third of the depth frames and a
fifth of the detection frames. **Keep `vio_enabled = False`.** The likely
cause is the USB 2 link: the two extra 640x400 mono streams (about
7.7 MB/s) on top of depth, the colour preview and the NN output come close
to what USB 2 carries through the hub. A second suspect is the shared
output: a frame held for the slow host transfer is not free for the
camera's frame pool. Next tries: give VIO its own `requestOutput` at a
lower size (320x200 is a quarter of the bytes), and check the VIO quality
at that size with `tools/vio_probe.py --width 320 --height 200` and a hand
turn.

## 6. Open items

- Grok review 2026-11-05 (session `01a1adba`): the boot gravity check in
  `oak_imu` only logs a warning. A wrong IMU frame then gives a wrong
  heading without a stop. Make a failed gravity check (gravity not on -Y,
  or a magnitude far from 1 g) disable the heading-dependent features
  (MANUAL heading hold, waypoint navigation) until a restart. This is a
  behaviour change: get Kevin's decision first.
- Adopted from the same review: an unparseable depthai version now selects
  the IMU report from the enum, not RAW.
- When the OAK is missing at startup, wall-e runs without the camera until
  the next restart. Decide with Kevin whether wall-e must start the camera
  reader anyway and let its supervisor wait for the device.

## Appendix: Technical Names

depthai, OAK, OAK-D Lite, BasaltVIO, VIO, RDF, IMU, `RAW`, `UNCALIBRATED`,
AutoCalibration, `DEPTHAI_AUTOCALIBRATION`, wall-e, `wall-e.service`,
systemd, YOLO, aarch64, fx, cx, CSV, pip.
