gruMoses/wall_e-Mini/docs/imu_steering.md

# IMU Steering Compensation

This document describes the IMU-based steering compensation system for the WALL-E Mini robot.

## Overview

The IMU steering compensation system uses an IMU (accelerometer + gyroscope) to:
- **Compensate for bumps and terrain variations** that cause unintended turning
- **Maintain straight-line travel** when no steering input is given
- **Provide smooth corrections** for external disturbances

## Hardware

The IMU is the **OAK-D Lite onboard BMI270** (gyroscope + accelerometer only — **no magnetometer**). `imu_source = "oak_d"` in `config.py` (pinned 2026-09-19). Heading is integrated from the gyro and is **relative to the robot's orientation at startup**, not referenced to magnetic north.

Do not restore `imu_source = "auto"`. It tries an external I2C IMU first, and that path publishes the opposite yaw-rate sign. The external path is unvalidated and has no tests; see `docs/external_imu_postmortem.md`. Magnetometer fusion is off (`imu_use_magnetometer = False`).

## Sign convention

The canonical statement is in the docstring of `OakImuReader.read`
(`pi_app/hardware/oak_imu.py`). Repeated here because the whole PID sign
depends on it:

- `heading_deg` is compass-style, **clockwise-positive** viewed from above,
  relative to boot orientation, in `[0, 360)`.
- `yaw_rate_world_dps` (published as `gz_dps`) is `d(heading_deg)/dt`, so a
  right turn gives a **positive** rate.
- `controller.py` applies a positive correction as `left + corr` /
  `right - corr`, which turns the robot **right**.

Therefore a rightward drift gives `error = target - heading < 0`, a negative
correction, and a left turn. No inversion is needed, and
`ImuSteeringConfig.invert_output` is **`False`** (default flipped from `True` on
2026-09-19). The knob is kept only for a bench A/B after a physical IMU
re-mount.

**Do not re-enable `invert_output` to fix a steering direction.** Before
2026-09-19 the OAK reader published a counter-clockwise-positive heading and
`invert_output = True` compensated for it. That pair also made the derivative
term anti-damping, because the yaw rate was clockwise-positive while the heading
was counter-clockwise-positive. If steering turns the wrong way, fix the reader
sign and re-run the chalk harness (which now prints a SIGN PASS/FAIL), rather
than adding a second inversion.

`pi_app/tests/test_heading_sign_closed_loop.py` closes the loop around a
kinematic plant so an inverted sign anywhere in the chain diverges.

## How It Works

### 1. PID Control Loop
The system implements a PID controller:
- **Proportional (P)**: Corrects based on current heading error
- **Integral (I)**: Accumulates and corrects for systematic drift
- **Derivative (D)**: Dampens oscillations using yaw rate (true damping only
  when the rate and the heading share the clockwise-positive convention above)

### 2. Steering Intent Detection
- Compensation is strongest in straight-intent conditions and scales down as steering input grows.
- Neutral/intent handling is controlled by hysteresis thresholds in `config.py`.

### 3. Fallback Behavior
- If IMU is unavailable or fails, the system automatically falls back to RC-only control
- No manual intervention required

## Configuration

The live values are in `ImuSteeringConfig` in `config.py`; do not copy numbers from this document.

### Tuning Guidelines

1. **Start with low gains**: Begin with the default values
2. **Increase P gain**: For faster response to heading errors
3. **Add I gain**: To eliminate steady-state drift
4. **Add D gain**: To reduce oscillations and overshoot
5. **Adjust deadband**: Increase if corrections are too sensitive

## Setup

The OAK-D Lite is the IMU. It needs no separate IMU hardware and no I2C wiring. The steering compensator calibrates the gyro bias at startup (`ImuSteeringCompensator._initialize_imu`), so keep the robot still during boot. Boot calibration and mount orientation are in `docs/heading_tuning.md`. Install the Python dependencies with `pip install -r requirements.txt`.

The CLI tools `calibrate_imu`, `advanced_imu_calibration`, `imu_axis_mapping_tuner` and `imu_cli_manual` work with the external I2C IMU only. Do not use them for the OAK IMU.

## Runtime Source Selection

`config.py` sets `imu_source = "oak_d"` (pinned 2026-09-19). The IMU is the OAK-D onboard BMI270.

- `"oak_d"`: the OAK-D onboard IMU. This is the only validated source.
- `"none"`: disables IMU steering.
- `"auto"` and `"external"` select the external I2C IMU path. That path is unvalidated, has no tests, and publishes the opposite yaw-rate sign. Do not restore `"auto"`: it lets a plugged-in external board take over the heading.

## Integration

The IMU steering compensation is automatically integrated into the main control loop:

1. **Controller initialization**: IMU compensator is created if IMU is available
2. **Real-time compensation**: Corrections are applied during each control cycle
3. **Automatic fallback**: RC-only control if IMU fails

## Monitoring

The system provides real-time status information:

```python
# Get IMU status from controller
imu_status = controller.get_imu_status()
if imu_status:
    print(f"Heading: {imu_status['heading_deg']:.1f}°")
    print(f"Target: {imu_status['target_heading_deg']:.1f}°")
    print(f"Available: {imu_status['is_available']}")
```

## Troubleshooting

### IMU Not Detected
- Verify the OAK-D is connected and the OAK pipeline is running (the BMI270 is on the OAK)

### Excessive Corrections
- Reduce `kp` gain
- Increase `deadband_deg`

### Oscillations
- Reduce `kp` gain
- Increase `kd` gain
- Check for loose hardware

### Drift Issues (heading wandering over time)
- Expected with gyro-only integration — the BMI270 has no magnetometer
- Increase `ki` gain to correct slow bias
- GPS COG heading alignment locks a true-north offset while driving on RTK fixed; see `docs/gps_heading_alignment.md`

## Safety Features

- **Maximum correction limits**: Prevents excessive steering adjustments
- **Automatic fallback**: RC control always available
- **Error detection**: System disables IMU if too many errors occur
- **Configurable timeouts**: Prevents system lockup

## Performance Characteristics

- **Update rate**: set by `ImuSteeringConfig.update_rate_hz` in `config.py`
- **Latency**: < 50ms from IMU reading to motor correction
- **Accuracy**: ±2° heading hold (configurable deadband)
- **Fallback time**: Immediate (< 1ms) when IMU unavailable
