gruMoses/wall_e-Mini/docs/mower_mode_plan.md

# WALL-E Mini — Mower Mode Plan

*Created: 2026-03-29*

## Overview

Add an autonomous lawn mowing mode to WALL-E Mini. The robot already has the core hardware — RTK GPS, OAK-D Lite stereo camera, IMU, VESC motor controllers over CAN bus, differential drive tracks, and a web dashboard. This plan covers what we need to build on top of that.

**Navigation strategy:** RTK GPS systematic mowing with boustrophedon (back-and-forth) path planning. No random bouncing.

**Obstacle avoidance:** OAK-D Lite neural net + stereo depth fusion. Tiered response — hard stop for people/pets, slow+navigate for objects, map+avoid for permanent obstacles.

## What We Already Have

These existing WALL-E systems carry over directly:

- **RTK GPS** — DFRobot GNSS-RTK on I2C (0x20)
- **OAK-D Lite** — stereo depth + RGB + Myriad X neural compute (MobileNet person detection already running)
- **IMU** — external I2C with OAK-D BMI270 fallback
- **VESC motor controllers** — CAN bus with telemetry read-back capability (wheel speed feedback)
- **Pure pursuit path following** — trail_follow already implemented and field-tested
- **Depth-based obstacle avoidance** — already implemented
- **Safety state machine** — arm/disarm, e-stop, RC override
- **Web dashboard** — Flask + SSE telemetry
- **config.py dataclass pattern** — all tuning parameters centralized

## What's New

### Navigation
- Boundary mapping tool (RC drive perimeter, record RTK waypoints → GeoJSON polygon)
- Boustrophedon path planner (Fields2Cover library or custom implementation)
- Coverage tracker (which areas have been mowed, resume after charge)
- Multi-zone support (front yard, back yard, side strips)
- Exclusion zones (permanent obstacles mapped via GPS)
- Return-to-dock navigation

### Obstacle Detection
- Upgrade from MobileNet to YOLOv8n (multi-class, 20-25 FPS on Myriad X VPU)
- Custom yard obstacle dataset (200-500 images per class from our lawn)
- Depth-validated detection pipeline (shadows have no depth signal → zero false positives)
- Tiered safety response system

### Hardware
- Mower deck + blade motor control (ESC or relay — TBD)
- Blade safety interlocks (tilt, lift, obstacle proximity)
- Battery-aware mission planning

### Sensor Fusion
- Dual-EKF: RTK GPS (5Hz) + IMU (50Hz) + VESC wheel encoders (100Hz)
- Dead-reckoning for GPS dropout under tree canopy
- Optional: OAK-D visual odometry as additional input

## Reference Projects

| Project | What It Is | Why It Matters |
|---|---|---|
| [OpenMower](https://github.com/ClemensElflein/OpenMower) | Most popular open-source RTK mower, ROS-based | Largest community, ublox F9P RTK, custom mainboard |
| [OAK-Mower](https://alemamm.github.io/oakmower/) | Spatial AI obstacle detection on OAK-D for OpenMower | Closest to our exact hardware stack |
| [Fields2Cover](https://github.com/Fields2Cover/Fields2Cover) | Path planning library for agricultural robots | Boustrophedon decomposition, Dubins curves, ROS2-compatible |
| Kenny Trussell's ArduRover mower | PixHawk + ZED-F9P, 5-18 acre fields | Most battle-tested DIY build, 2+ years of real mowing |
| [Greenzie](https://greenzie.com) | Commercial autonomous mowing | Boustrophedon planner was open-sourced (archived) |

## Commercial Mower Lessons

Key takeaways from studying Mammotion Luba, Husqvarna EPOS, Segway Navimow, and others:

- **Tree canopy is the universal weakness.** Every commercial RTK mower struggles under trees. Sensor fusion (IMU + wheel odometry dead-reckoning) is mandatory for bridging GPS gaps.
- **Multi-sensor fusion wins.** No single sensor is reliable enough. RTK + depth camera + IMU is the minimum viable stack. Mammotion's Luba 3 added LiDAR because RTK-only missed dark objects on the ground.
- **Own RTK base station > NTRIP** for residential. ~$400, set-and-forget, no internet dependency.
- **Husqvarna EPOS** achieves 1-2cm accuracy with local base station. That's our target.
- **Segway Navimow X3** has the best obstacle AI (300° FOV, 200+ object types via VSLAM). Worth studying their detection tiers.
- **App/connectivity issues** are the #1 complaint across all brands. Keep the dashboard simple and local.

## Obstacle Detection Strategy

### Model
**YOLOv8n** deployed on OAK-D Myriad X VPU. 20-25 FPS, Pi CPU stays near 0% during inference. Significantly better multi-class detection than current MobileNet-SSD.

### Detection Pipeline
1. Neural net detection (YOLOv8n on Myriad X)
2. Confidence threshold filtering
3. Depth validation (reject detections with no depth signal — kills shadow false positives)
4. Temporal tracking (persistence across frames)
5. Size validation (reject noise)
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
