gruMoses/wall_e-Mini/docs/data/shield_inputs_20261113/can_hat_pins_caliper_20261114.jpg

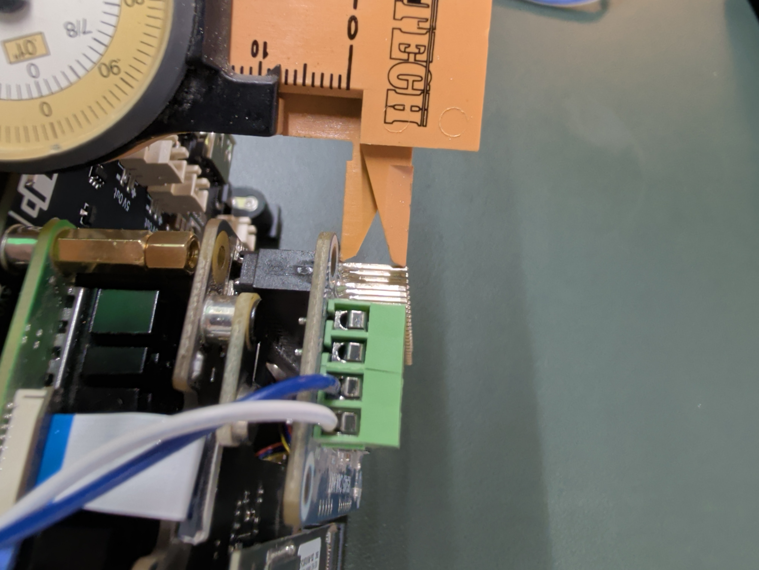
docs/data/shield_inputs_20261113/can_hat_pins_caliper_20261114.jpg
