gruMoses/wall_e-Mini/docs/data/shield_inputs_20261113/nano_bottom_ch340g.jpg

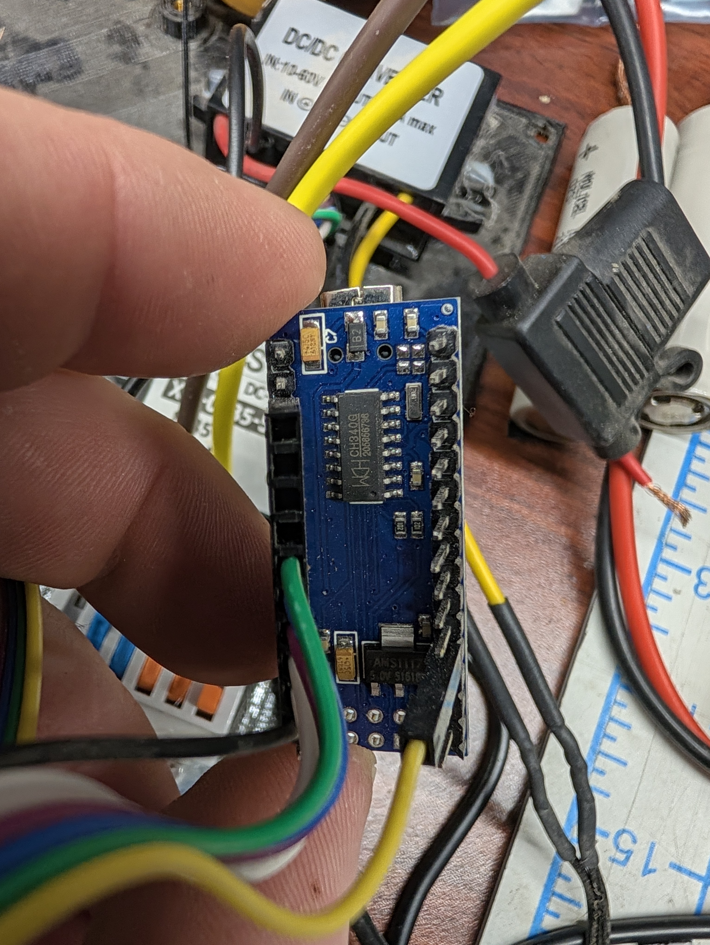
docs/data/shield_inputs_20261113/nano_bottom_ch340g.jpg
