gruMoses/wall_e-Mini/docs/data/shield_inputs_20261113/nano_length_caliper.jpg

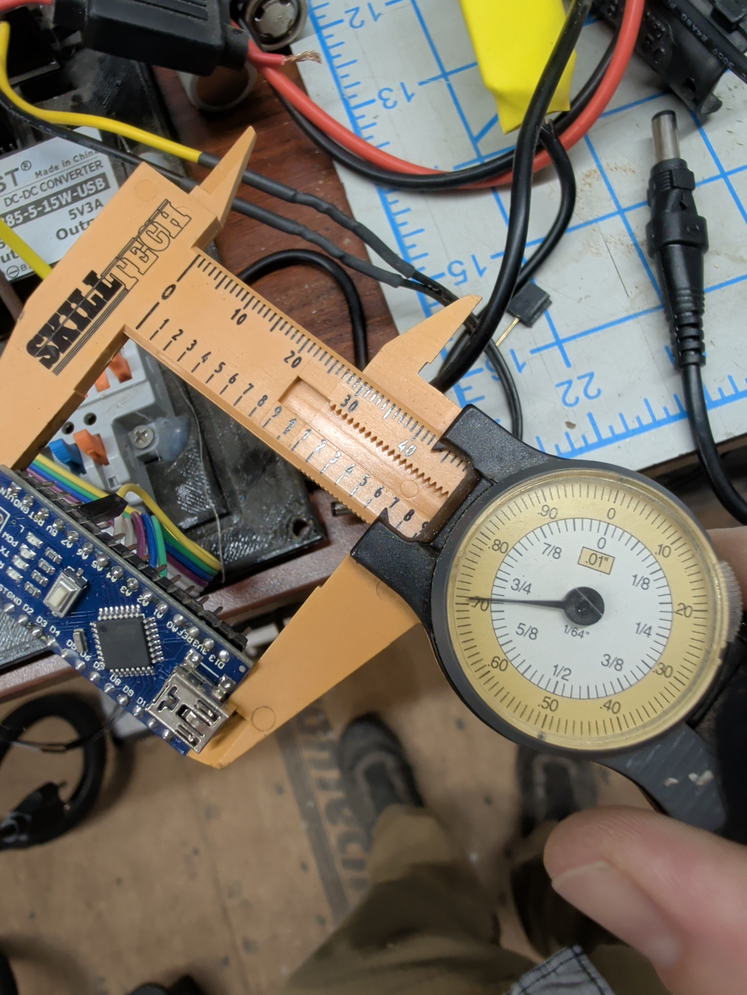
docs/data/shield_inputs_20261113/nano_length_caliper.jpg
