gruMoses/wall_e-Mini/docs/data/shield_inputs_20261113/nano_mount_and_usb_plug.jpg

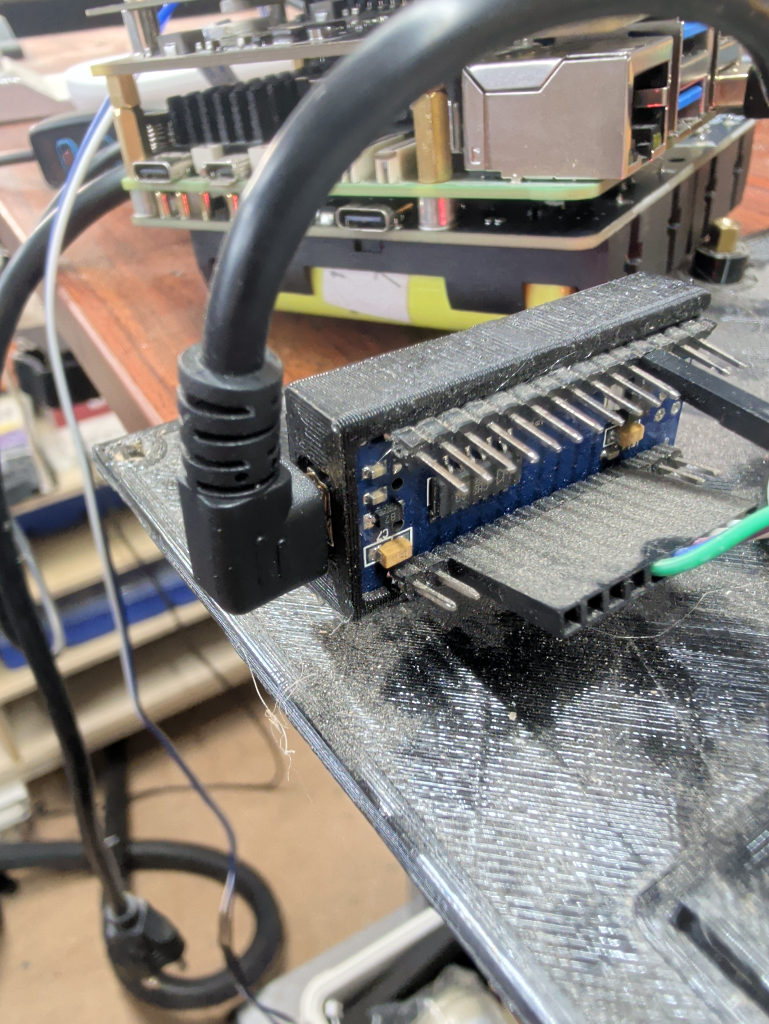
docs/data/shield_inputs_20261113/nano_mount_and_usb_plug.jpg
