gruMoses/wall_e-Mini/docs/data/shield_inputs_20261113/nano_receiver_power_5v_20261114.jpg

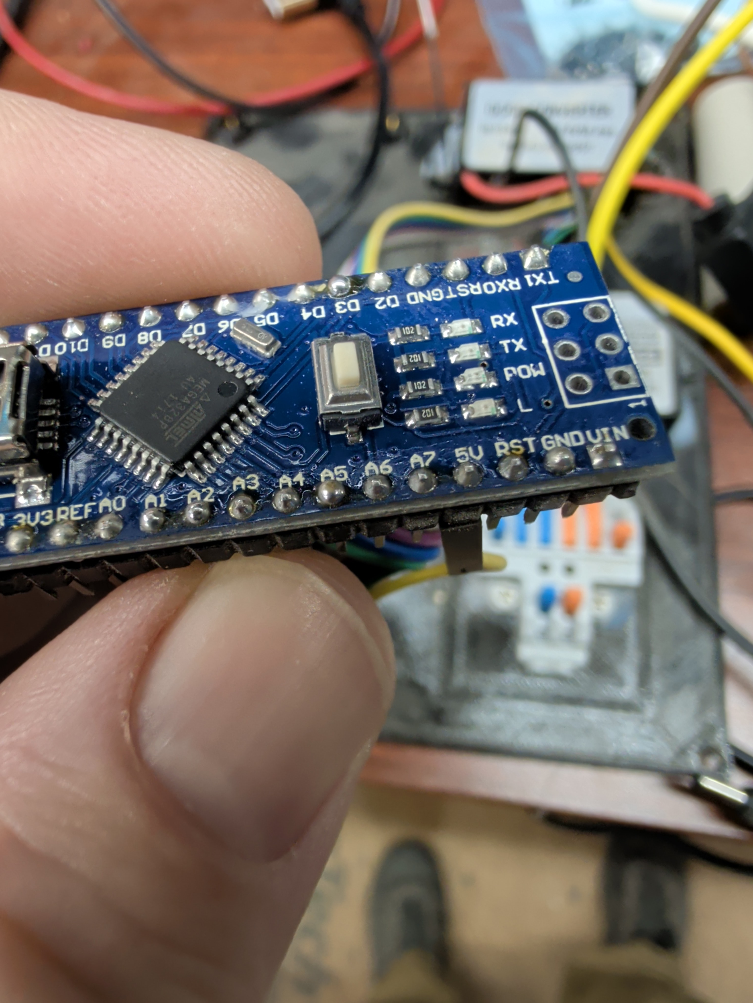
docs/data/shield_inputs_20261113/nano_receiver_power_5v_20261114.jpg
