gruMoses/wall_e-Mini/docs/data/shield_inputs_20261113/nano_top_silkscreen.jpg

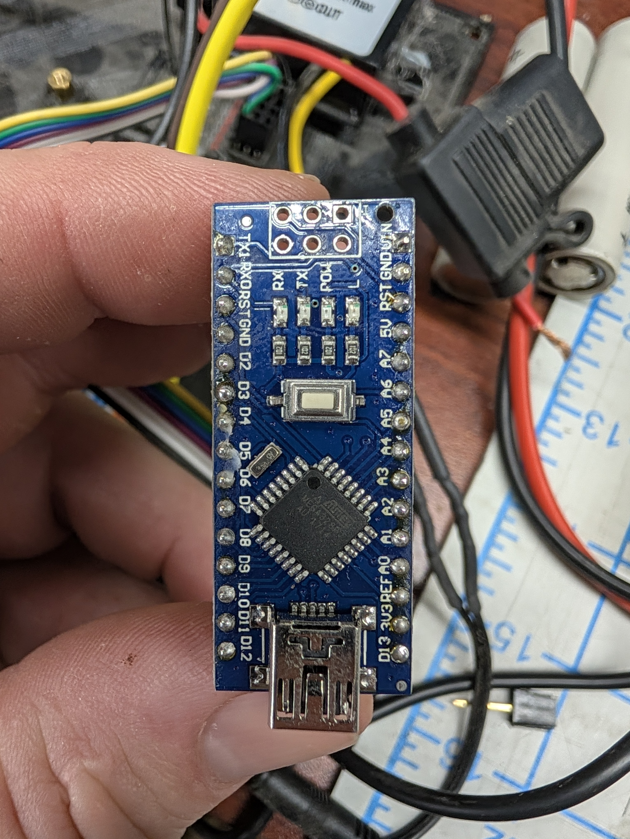
docs/data/shield_inputs_20261113/nano_top_silkscreen.jpg
