gruMoses/wall_e-Mini/docs/data/shield_inputs_20261113/rover_cable_back.jpg

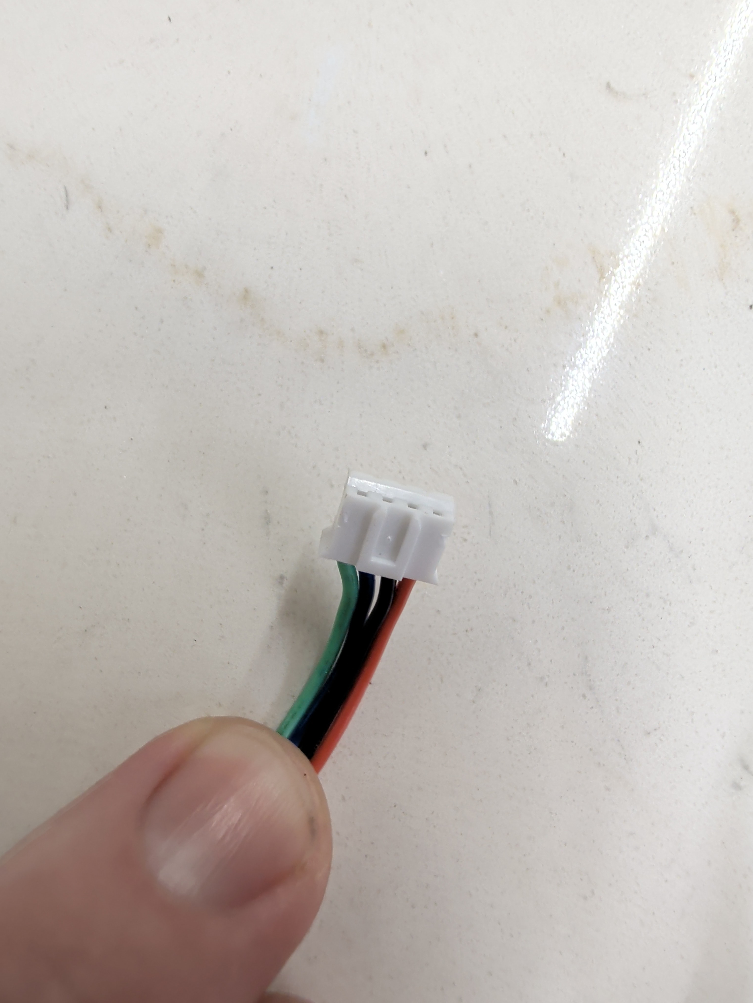
docs/data/shield_inputs_20261113/rover_cable_back.jpg
