gruMoses/wall_e-Mini/docs/data/shield_inputs_20261113/rover_cable_front.jpg

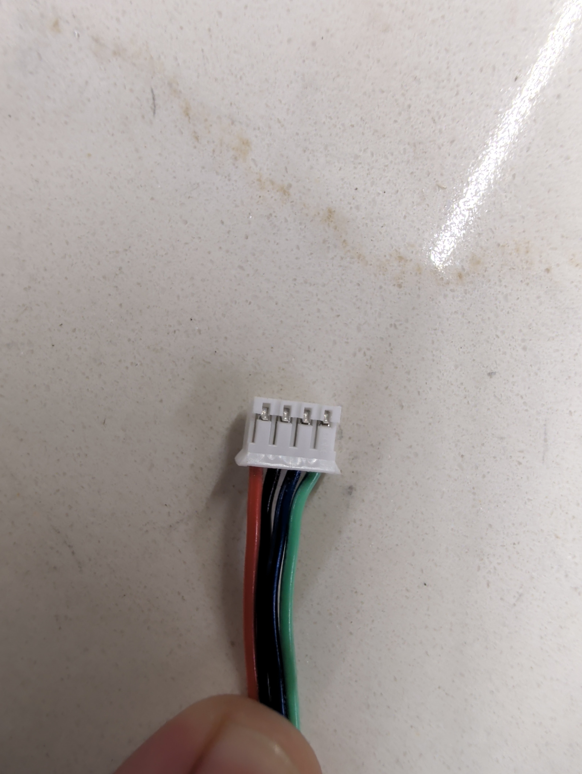
docs/data/shield_inputs_20261113/rover_cable_front.jpg
