gruMoses/wall_e-Mini/docs/data/shield_inputs_20261113/stack_height_caliper_20261114.jpg

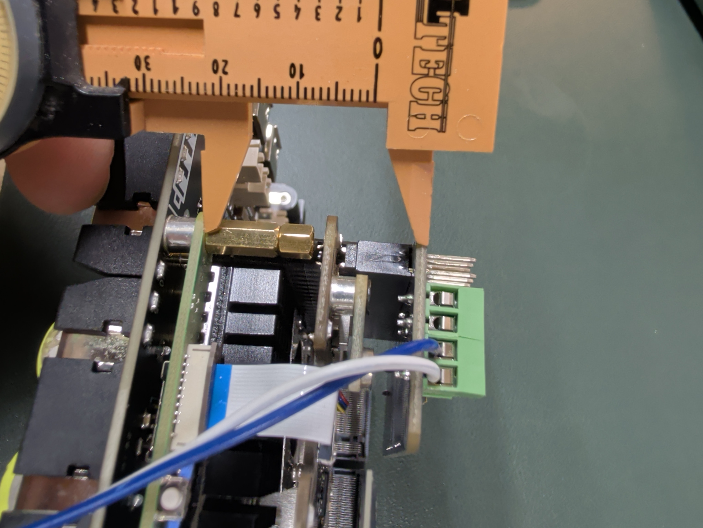
docs/data/shield_inputs_20261113/stack_height_caliper_20261114.jpg
