gruMoses/wall_e-Mini/docs/data/shield_inputs_20261113/terminal_block_dial_20261114.jpg

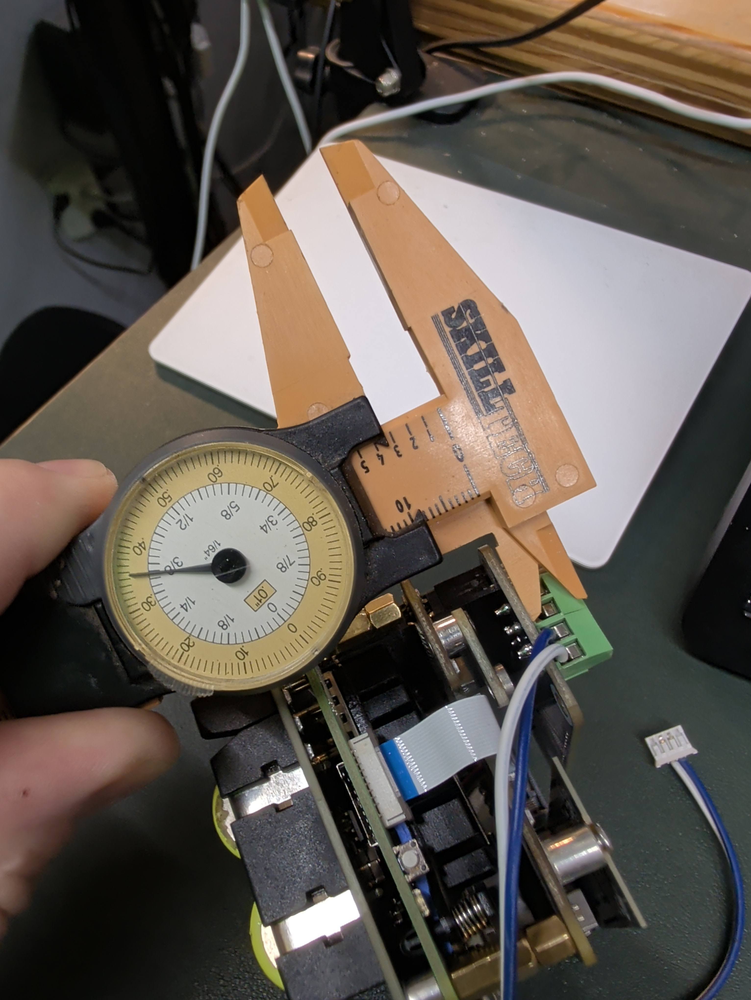
docs/data/shield_inputs_20261113/terminal_block_dial_20261114.jpg
