gruMoses/wall_e-Mini/docs/data/shield_inputs_20261113/measurement_sheet_20261114.pdf

# WALL-E Pi 5 shield: measurement sheet

2026-11-14 · Fill in, then send a photo of this sheet. Sketches are not to scale. Numbers in circles match the sketches.

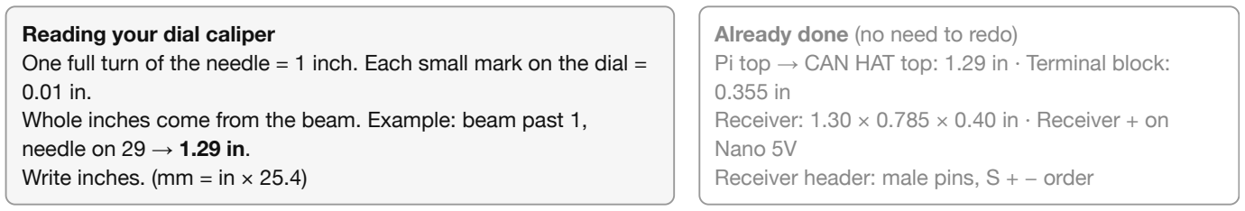
[picture p23: figure]
Reading your dial caliper; needle on 29 → 1.29 in. Write inches. (mm = in × 25.4); Already done (no need to redo); Nano 5V Receiver header: male pins, S + − order

One full turn of the needle = 1 inch. Each small mark on the dial =

Whole inches come from the beam. Example: beam past 1,

Pi top → CAN HAT top: 1.29 in · Terminal block:

Receiver: 1.30 × 0.785 × 0.40 in · Receiver + on

### A · The stack: CAN HAT and NVMe carrier

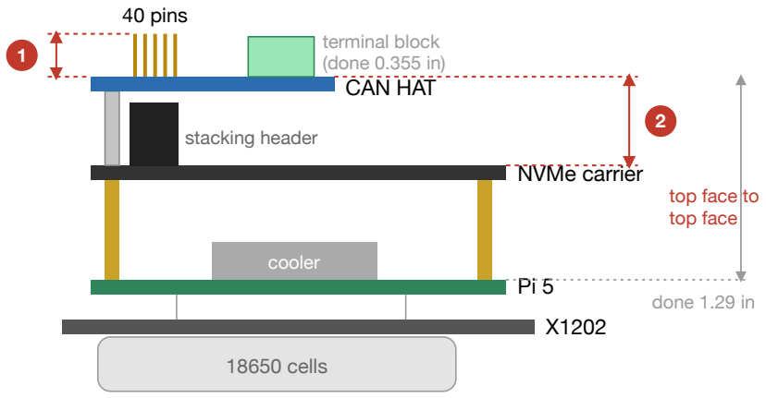
[picture p24: figure]
18650 cells; cooler; NVMe carrier; stacking header; CAN HAT; 40 pins; terminal block (done 0.355 in); top face to top face; done 1.29 in

Side view. ① measures the pins sticking up above the CAN HAT. ② is measured beside hole A or B.

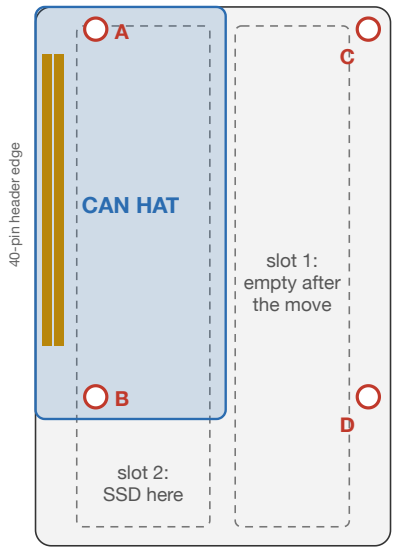
[picture p25: figure]
slot 2: SSD here; slot 1: empty after the move; CAN HAT; 40-pin header edge

↓ USB / Ethernet end of the Pi
Top view, like your photo. A, B: CAN HAT holes. C, D: carrier holes.

### 1 Pin height: CAN HAT top face to the pin tips. Measure at

each end of the 40-pin row and in the middle.
Want 0.295 to 0.335 in (7.5 to 8.5 mm)
end A | middle | end B
in

### 2 Carrier top face to CAN HAT top face, right beside hole

A, then beside hole B.
Sets the long standoffs for C and D (this + 0.433 in) | at A | in at B | in
3
What is in each hole today? Look from the top. Do C and
D after the SSD moves to slot 2.
A: | screw head | stud up | empty
B: | screw head | stud up | empty
C: | screw | nut | stud up | empty
D: | screw | nut | stud up | empty

CAN HAT

spare 2x20 female header

pushed down
until it stops | 4

### 4 Optional. Only if you have a spare

2x20 female header (the 8.5 mm tall kind). Push it onto the CAN HAT pins until it stops. CAN HAT top face to the top of the header.
Want 0.433 in (11.0 mm) or less. Skip if you have none.

in

### B · The receiver (HotRC F-06A)

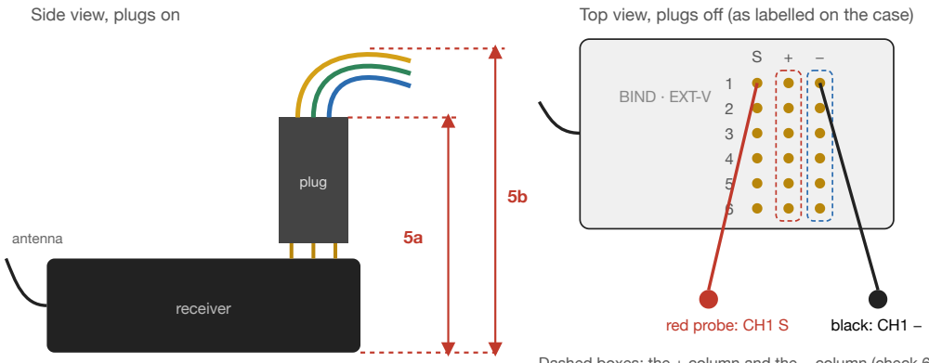
[picture p26: figure]
Side view, plugs on; antenna; plug; receiver; BIND · EXT-V; red probe: CH1 S; black: CH1 −

Top view, plugs off (as labelled on the case)

Dashed boxes: the + column and the − column (check 6)

5 Height with the plugs on, from the receiver's bottom face.
5a: to the top of the plug housing. 5b: to the top of the wire
bend.
For the case lid. Your harness as it is today. | 5a | in 5b | in

### 6 Meter on beep, receiver unplugged from power. Touch

the + pin of row 1, then the + pin of each other row. Then
the same for the − pins.
The shield powers the receiver through any one lead, so these must all connect.
all + beep together? | yes | no
all − beep together? | yes | no

### 7 Signal voltage. Receiver powered (its harness on the

Nano, Nano on any USB port), transmitter on, stick centred. Meter on DC volts: red probe on CH1's S pin (or the back of its plug), black on a − pin.
The meter shows the average of the pulses. I work the real level out from it.

V
blue LED on the receiver: | on | off

### C · The Nano's USB plug

Nano (top view)

90° plug

8

board edge →
far side of the plug

### 8 Your 90° Mini-B plug, plugged

into the Nano. From the
Nano's board edge (USB end)
to the far side of the plug, or of
the cable bend if that sticks out
more. | in

Nano flat, parts up. Which way
does the cable leave the plug?
up | down | left
right | straight out

### D · Later, after the board is built

Rover current at first power-up (USB meter) | mA
RC range test, receiver on the shield: solid link out to | ft

New Nano has the 6-pin ICSP header fitted? (tallest point if
so) | yes | no
