gruMoses/wall_e-Mini/docs/logging_troubleshooting.md

# Logging and Troubleshooting (Dashboard / OAK Feed)

This doc summarizes where logs live, how to use them for the **dashboard video feed root-cause** testing, and recommendations to improve logging if tests don’t go well.

NOTE: the "Current logging layout" table below predates the 2026-09-19
logging audit. Read "Log format (2026-09-19)" first for the current line
shapes; the table is kept for the parts that are still accurate (file
paths, journalctl commands).

## Current logging layout

| What | Where | Notes |
|---|---|---|
| **Structured JSON (main loop)** | `logs/run_YYYYMMDD_HHMMSS.log` | One JSON object per line, ~10 Hz. Symlink: `logs/latest.log`. |
| **Camera health** | Inside each JSON line as `oak_camera_health` | `pipeline_running`, `*_age_s`, `*_stale`, `is_stale`, `last_*_error`. |
| **Health transition warnings** | stdout (journalctl) | Only when health flips healthy↔stale; includes age fields and last errors. |
| **Module loggers** (oak_depth, recorder, viewer, etc.) | stderr → journalctl | `journalctl -u wall-e.service -n 500 --no-pager` |

## Key log locations for dashboard testing

- **Structured run log:** `logs/latest.log` (or the current `run_*.log`).
- **Service stdout/stderr:** `journalctl -u wall-e.service -f` (follow) or `-n 200` (last 200 lines).
- **Dashboard:** `http://<robot-ip>:8080/` — telemetry includes `camera_health` (RGB/Depth age, Pipeline running).

## Recommendations to improve logging (if testing doesn’t go well)

1. **Structured log: add a "health changed" event** — DONE 2026-09-19.
   The main loop writes `{"type":"event","event":"oak_health","from":...,"to":...,"ts":...}`
   on every transition, in addition to the existing console print. See
   "Log format (2026-09-19)" below.

2. **Emit transition to the structured log file (not only print)** — DONE 2026-09-19,
   same change as item 1.

3. **OAK thread: log first exception with full traceback**
   - In `oak_depth.py`, when setting `_last_depth_error_msg` / `_last_pipeline_error_msg` etc., the first time an error is set in a run, call `logger.exception(...)` (or `logger.error(..., exc_info=True)`) so journalctl gets one full traceback. Subsequent same-error can stay as the short summary to avoid spam. That helps distinguish pipeline crash vs device vs host-side bugs.

4. **Optional: periodic "heartbeat" line in structured log** — DONE 2026-09-19
   (differently than proposed): a 1 Hz `{"type":"slow",...}` line now carries
   `imu_pipeline`, `oak_camera_health`, and `oak.chip_temp_c`, replacing the
   heartbeat idea with something more useful than just confirming the loop
   is alive. See below.

5. **Dashboard: surface last error strings**
   - Telemetry already exposes `camera_health`. If not already shown, add the `last_*_error` strings to the dashboard (e.g. collapsed or tooltip) so you can see the last OAK error without opening logs.

6. **Retention and disk**
   - Run logs can grow large. Keep `_cleanup_old_logs(..., days=7)` (or configurable). For a failure run, copy the relevant `run_*.log` (and a journalctl snippet) off the Pi before the next restart so the exact failure window is preserved.

## Quick checks during/after a bad run

- **Is the vision worker hung (robot "extremely slow" in MANUAL, 2026-10-08)?**
  `curl -s -N -m 25 http://192.168.86.54:8080/api/telemetry | grep '^data:' | tail -1`
  and read `camera_health`: `vision_hung: true`, `vision_worker_age_s` large,
  `pipeline_running: true` with `depth_fps: 0` is a thread stuck inside depthai;
  `throttle_scale` 0.1 with a sane `obstacle_distance_m` is the MANUAL stale
  floor, not an obstacle. The journal has `OAK vision worker HUNG ...` every
  minute and the JSON log an `oak_vision_hung` event; the service restarts
  itself after 60 s hung while disarmed (`oak_vision_hung_restart` event,
  then `Started wall-e.service`).
- **When did health go stale?**  
  `grep '"is_stale": true' logs/latest.log | head -1` and check `ts_iso` / `ts`.
- **What did the pipeline report?**  
  Last line before staleness: `oak_camera_health.last_pipeline_error`, `last_depth_error`, etc., in that line.
- **Did the control loop keep ticking?**  
  `ts` and `loop_dt_ms` should keep advancing; if they stop, the main process likely hung or exited.
- **Journal around the time of stall:**  
  `journalctl -u wall-e.service --since "2026-03-13 18:25" --until "2026-03-13 18:35"` (adjust to your stall window).

## Log format (2026-09-19)

A 2026-09-19 audit found `logs/run_*.log` / `logs/arm_*.log` wrote 7,658 B
per armed line: `imu.oak_imu` alone was 2,197 B, `imu_pipeline` 1,539 B,
`oak_camera_health` 710 B. Most of that was monotonic counters that change
over seconds, logged 10 times a second. This section describes the format
after the fix. Each JSON line has a `"type"` field, except the original
per-tick line, which has none (it predates this change and stays that way
for backward compatibility with existing tools).

### Per-tick line (no `"type"` field)

One line per tick while armed (10 Hz); a low-rate heartbeat plus
always-log-on-event while disarmed (`should_log_tick`,
`pi_app/app/log_gating.py`). Since 2026-11-10 a tick with a non-empty
`events` list always writes a line while armed. Before that, the 10 Hz gate
could skip such a tick and the event was lost, because `events` lives in one
tick only. In the worst case this gives one line per control tick (about
30 Hz). Events are edge-triggered, so a session has only a few extra lines.
Built by `build_log_obj()`. Top-level blocks:

- `rc`, `bt`, `motor`, `safety`, `pid`, `obstacle`, `waypoint_nav`,
  `detections`, `heading_align`, `recording_state`, `bms`, `events`.
- `animals` (2026-09-28, log only): every YOLO detection whose class is in
  `OakDetectionConfig.log_animal_class_ids` (bird, cat, dog, horse, sheep,
  cow): `label`, `conf`, `z_m`, `x_m`, `bbox`, `tier` (`stop`/`slow`/`log`;
  birds are `log`), `depth_status`. `null` when none. Data for the planned
  animal slow zone; it changes no behaviour.
- `obstacle.person_stop_hold` (2026-11-10): the state of the person-stop
  hold (`pi_app/control/person_stop_hold.py`) at the last depth poll. The
  hold keeps the 0.8 m person/animal stop after a trigger until positive
  evidence or the operator releases it. Keys (`PersonStopHoldSnapshot`):
  `active` (bool), `reason`, `evidence_polls` (int), `operator_only` (bool),
  `operator_only_reason`, `chain` (`"person"`, `"animal"` or `""`),
  `chain_present` (bool), `beyond_streak` (int), `resolved` (bool),
  `manual_carry` (bool). `reason` is what engaged the hold (`trigger`,
  `carry_in`) or how it ended (`seen_beyond`, `corridor_clear`, `operator`,
  `manual_neutral`); it is `""` before the first event. When `operator_only`
  is true, only the operator ends the hold, and `operator_only_reason` is
  `lost`, `ambiguous`, `second_object`, `impostor_in_gate` or
  `second_trigger`. The value is `null` when the hold is off.
- `imu`: `controller.get_imu_status()`, rounded to 3 decimals. Its nested
  `oak_imu` sub-block drops the counters that duplicate `imu_pipeline`
  (`producer_*`, `queue_*`, `drain_batch_*`, `cadence_*`, `host_queue_*`,
  `max_packets_per_drain`, plus `last_batch_packets`,
  `zupt_engage_count`, `bias_updates`, `bias_g[xyz]_dps`,
  `window_*_std_*`, `last_bias_update_host_ts`,
  `stationary_tracking_enabled`, `zupt_enabled`) — confirmed key-for-key
  against `OakDepthReader.get_imu_metrics()`. It keeps
  `yaw_rate_source_*`, `yaw_axis_sign`, `integrate_status`,
  `integration_path`, `sample_age_s`, `last_dt_s`, `gx/gy/gz_body_dps`,
  `yaw_rate_world_dps`, `heading_deg`, `tracked_bias_dps`,
  `gyro_bias_dps`, `stationary`, `zupt_active`, and `count_*`.
- `imu_steering`: `steering_input`, `correction_raw`, `correction_applied`,
  `correction_blend`, `speed_gain_scale`, `saturated` (the anti-windup
  clamp flag).
- `vesc`: adds `rpm_plausible`, `gate_trips`, `l_temp_c`/`r_temp_c`,
  `l_motor_temp_c`/`r_motor_temp_c`, `l_duty`/`r_duty` (all were already
  computed by `controller.process()` and simply not logged before).
  It also holds the drive bus fields below (see "VESC bus fields").
- `gps`: adds `age_s` (seconds since the current fix, monotonic clock;
  `None` when there is no fix this tick).
- `follow_me`: adds `speed_loop` — `open_loop_byte`, `target_mps`,
  `actual_mps`, `err_mps`, `p`, `i`, `d`, `corr_mps`, `corr_byte`,
  `closed` (bool: whether the closed-loop velocity PID ran this tick; `p`/
  `i`/`d` are only meaningful when `closed` is `True`).
- Top level also adds `straight_intent`.
- `waypoint_nav_exit_reason` (2026-11-10): the controller sets this key in
  its telemetry dict on the one tick where it ends WAYPOINT_NAV by itself
  and returns the robot to MANUAL (`controller.py`). Values: `vision_stale`,
  `heading_unavailable`, `heading_stale`, `heading_lock_lost` (the
  heading-alignment lock was lost), `align_timeout` (ALIGN lasted longer than
  `waypoint_nav.align_timeout_s`, 10 s by default). WARNING: `build_log_obj()`
  does not copy this key into the JSON line yet. To find the reason, search
  the journal for `WAYPOINT_NAV stopped: <reason>`.
- Dropped: `imu_pipeline`, `oak_camera_health` (moved to the slow line —
  see below), and the flat `heading_offset_deg` / `heading_offset_locked`
  / `heading_offset_frozen` / `heading_offset_refining` keys (the same
  values are in `heading_align.offset_deg` / `.locked` / `.frozen` /
  `.refining` on the same line). `corrected_heading_deg` is unchanged.

### VESC bus fields (2026-11-05, per-tick `vesc` block)

These fields show the drive bus during braking. Regenerative braking pushes
energy back onto the 13S battery bus (54.6 V maximum). When the BMS charge
FET is open, the energy has nowhere to go and the bus voltage can rise
toward the VESC over-voltage fault (90 V). The fields are in the per-tick
line only. The slow line does not repeat them.

Latest values (one per VESC, `l_` is left and `r_` is right). The control
loop reads them every 50 ms, so a value can be up to 50 ms old.

| Key | Unit | Meaning |
|-----|---|---|
| `l_bus_v` / `r_bus_v` | V | Bus input voltage that the VESC measures (CAN STATUS_5). |
| `l_bus_a` / `r_bus_a` | A | Bus input current (CAN STATUS_4). Negative means energy flows into the pack (regen). |
| `l_motor_a` / `r_motor_a` | A | Motor current (CAN STATUS). The sign is as the VESC reports it. The sign convention is not checked on this robot. |

Peak-hold values. The driver sees every CAN frame (about 48 Hz per VESC),
so these catch a spike that is shorter than one log line.

| Key | Unit | Meaning |
|-----|---|---|
| `l_bus_v_max` / `r_bus_v_max` | V | Highest bus voltage in any frame since the previous log line. |
| `l_bus_a_min` / `r_bus_a_min` | A | Lowest bus input current in any frame since the previous log line. A strong regen pulse gives the most negative value. |

Rules for the peak-hold values:

- The window starts at the previous line that the logger wrote. The logger
  reads the peaks and resets them when it writes a line.
- Armed lines come at 10 Hz, so the window is 0.1 s. A disarmed heartbeat
  line comes every 5 s, so its window is longer.
- The first line after a service start covers the time since the start.
- A peak is `null` when no frame of that kind arrived in the window.
- `l_bus_a_min` is the lowest value, not only a negative one. It is
  positive when the robot did not regenerate in the window.

Rules for the latest values:

- A value is `null` when the VESC never sent that frame, or the last frame
  is older than 0.5 s, or the VESC telemetry as a whole is stale.
- The two VESCs measure the same bus. Their voltages can differ by a small
  ADC offset.
- Resolution is 0.1 V and 0.1 A (the VESC sends tenths).

Stand test: spin the wheels, release the stick, and read the maximum of
`l_bus_v_max` and `r_bus_v_max` in the lines after the release. Example
(`jq` on a run log):

```bash
jq -c 'select(.vesc) | [.ts_iso, .vesc.l_bus_v_max, .vesc.r_bus_v_max, .vesc.l_bus_a_min, .vesc.r_bus_a_min]' logs/arm_*.log
```

### VIO fields (2026-11-06, per-tick and slow `vio` block)

Log-only BasaltVIO inside wall-e's camera session. The block is `null` while
`OakDetectionConfig.vio_enabled` is False (the default). VIO has no control
authority: nothing reads these fields except the logs and `/api/telemetry`.

| Key | Unit | Meaning |
|---|---|---|
| `st` | | `on`, `stale` (no pose for 2 s), or `disabled: <reason>` |
| `hdg` | deg | VIO heading change since the camera session started, clockwise positive (compare with a change of the IMU `heading_deg`) |
| `x` / `y` / `z` | m | VIO position in its own world frame (Z up), origin at the session start |
| `path` | m | Path length since the session start |
| `age` | s | Age of the newest VIO pose |
| `frame_ok` | | False when roll or pitch passed 30 deg (a wrong IMU frame puts the VIO world upside down) |

The slow line adds `session`, `poses`, `hz`, `roll`, `pitch`, `imu_flip_yz`
(True when the IMU node runs RAW and `_poll_imu` negates y and z for the
heading), `errors` and `last_error`. A new camera session restarts VIO at the
origin, so compare VIO and gyro changes inside one session.

### Slow line (`"type": "slow"`)

One line per second, armed or not (`should_write_slow_line`,
`build_slow_obj()`). Carries `imu_pipeline` and `oak_camera_health` at full
float precision (the per-tick `imu` block above is rounded to 3 decimals;
this line is not), plus `oak.chip_temp_c` — the OAK module's chip
temperature, sampled once a second from
`pipeline.getDefaultDevice().getChipTemperature()` inside the pipeline
worker thread.

The `oak_camera_health` block (`OakDepthReader.get_health()`) holds the IMU
health fields (2026-11-10): `imu_age_s` (age of the newest IMU sample;
`null` before the first sample), `imu_stale` (true when that age is more than
the reader's stale age, 0.5 s, or when there is no sample yet; the heading is
frozen while it is true), `imu_watchdog` (the IMU watchdog is active),
`imu_stall_restarts` (count of camera restarts that the IMU watchdog caused)
and `imu_stall_fault` (true when the shared restart budget is full and the
watchdog stopped restarting). `imu_stale` is not part of `is_stale`; that
field stays the vision health.

`tools/imu_pipeline_analyzer.py` reads `imu_pipeline` from the slow line
when present, and falls back to the old per-tick location for logs
captured before this change.

### Session header (`"type": "session_header"`)

The first line written to every new `run_*.log` and `arm_*.log`
(`_session_header()`, called right after each `_open_log_file()`).
Carries `git_sha`, `git_dirty`, `file`, and a `config` block with the
tunables that matter for interpreting a run or deriving PID gains offline:
`imu_steering` (`kp`/`ki`/`kd`/`max_correction`/`invert_output`/
`deadband_deg`/`oak_yaw_rate_source`/`oak_yaw_rate_scale`/
`oak_stationary_*`/`oak_zupt_enabled`/`oak_yaw_axis_sign_auto`),
`follow_me` (`speed_kp`/`speed_ki`/`speed_kd`/`speed_integral_limit`/
`speed_pid_max_correction_mps`/`speed_loop_mps_per_byte`/
`follow_distance_m`/`max_follow_speed_byte`), `vesc`
(`rpm_plausibility_*`), `waypoint_nav` (`min_rtk_quality`/
`align_threshold_deg`/`recovery_threshold_deg`/`pivot_yaw_cmd`),
`gps_heading_align.max_lock_yaw_rate_dps`, and `imu_source`.

### Event lines (`"type": "event"`)

Written immediately when something happens, not on a timer. The first
kind: `{"type":"event","event":"oak_health","from":"HEALTHY"|"STALE",
"to":"HEALTHY"|"STALE","ts":...}`, mirroring the console
"OAK camera health transition" print.

IMU stall events (2026-11-10, `ImuStallMonitor` in `pi_app/app/imu_stall.py`).
The main loop writes each one as `{"type":"event", ...fields...,
"is_armed":<bool>,"ts":...}`. They exist because a 38.8 h IMU stall on
2026-11-06 left only `integrate_status` "stale" in the log:

- `oak_imu_stall`: the IMU has been stale for `OakDetectionConfig.imu_stall_event_s`
  (5 s). Fields: `imu_age_s`, `stale_for_s`. Shorter drops are not events.
- `oak_imu_stall_restart`: the IMU watchdog ended the camera session.
  Fields: `imu_age_s`, `imu_stall_restarts` (the new count).
- `oak_imu_stall_fault`: the restart budget is full and the watchdog stopped
  restarting. Fields: `imu_age_s`, `imu_stall_restarts`.
- `oak_imu_recovered`: fresh IMU samples after an `oak_imu_stall`. Fields:
  `stalled_for_s`, `imu_stall_restarts`.

`{"type":"event","event":"arm_midband_disarm","ch3_us":...,"ch4_us":...,
"since_held_high_s":...,"mode":...,"ts":...}` (2026-11-05): the robot
disarmed because, while armed, ch3 was not held high (>= 1800 us for
`SafetyParams.arm_high_persist_s`) for longer than
`SafetyParams.arm_midband_disarm_s` and was not low (the RC ch3/ch4
hybrid-mix fault). `since_held_high_s` is the time since the last held-high
tick, on the monotonic clock. The same tick's line has `ARM_MIDBAND_DISARM` and `DISARMED` in
`events`, and the journal has an `ARM SWITCH MID-BAND DISARM` warning.

### GPS (2026-09-19, Commit D)

The per-tick `gps` block gains `utc` (ISO 8601 string, `None` before the
receiver has a time fix), `cog_deg` and `sog_mps` (course/speed over
ground; `None` when the receiver reports no course, e.g. stationary),
`nmea_mode` (the RMC/VTG mode-indicator character), and `geoid_sep_m`.
`cog_deg`/`sog_mps` are logged, and the heading lock reads them
(`GpsHeadingAligner.update_cog()`; see `docs/gps_heading_alignment.md`).

The slow line gains `gps_health`: `RtkGpsReader.get_health()` --
`reconnect_count`, `poll_error_count`, `consecutive_i2c_errors`,
`last_poll_age_s`, `rmc_errors`, `mode_register_value` (the raw value last
read from operation-mode register 93).

A fix-quality change (e.g. RTK float -> RTK fixed) is logged separately at
WARNING with UTC/sats/HDOP/diff-age/station-id context, independent of the
JSON log -- `journalctl -u wall-e.service | grep 'fix_quality'` finds it
even without a copy of the run log. See `docs/rtk_gps_module.md` for the
register map and the read protocol this is built on.
