gruMoses/wall_e-Mini/pi_app/web/teleop.py

"""Phone teleop: fail-safe session manager + server-side deadman watchdog.

TRANCHE 1 — the fail-safe core (not the pretty UI; that's tranche 2).

Kevin's requirement: a phone-browser driver that is *fail-safe* — if internet/
wifi drop, the robot stops. The whole point of this module is that stopping is
enforced by the **server**, in a dedicated watchdog loop, NOT by anything the
phone or the WebSocket handler does. A dead WS handler thread, a slept phone, a
dropped wifi link, a crashed browser tab — all converge on the same code path:
no fresh heartbeat → motor neutral → teleop session disarmed.

Architecture / how this slots UNDER existing RC authority
---------------------------------------------------------
The real motor command path is the main control loop in ``pi_app/app/main.py``:

    rc = rc_reader.get_state()
    bt_override = <read /tmp/wall_e_bt_latest.json if fresh within 600 ms>
    cmd = controller.process(rc, bt_override_bytes=bt_override)  # -> set_tracks

``controller.process`` already gates EVERYTHING through RC: an RC-stale watchdog,
``update_safety`` (ch3 disarm / ch5 e-stop latch), and a final
``if not is_armed: left = right = NEUTRAL`` (controller.py:898). So phone teleop
physically cannot move the robot unless RC keeps it armed. We do not change that.

This module is purely an additional, *tighter* fail-safe ON TOP of that existing
file channel:

  * The legacy ``/api/teleop`` endpoint used to write the same override file
    with a 600 ms freshness window — a crude deadman (fall back to RC after
    600 ms) with no arming ceremony, no e-stop latch, no speed cap, no stale
    guard, and no explicit re-arm, on the SAME unauth Flask app and routing
    around every guard below. It has since been retired (410 Gone in
    ``oak_viewer.py``) because it shared this module's override file with no
    coordination — last-writer-wins let it fight ``/drive`` or drive
    unsupervised under a latched ``/drive`` e-stop. Use ``/drive`` or the REST
    mirror below instead.
  * ``TeleopSession`` owns a 250 ms server-side deadman, an arming ceremony, a
    latched e-stop, a speed cap, and a stale-command guard.
  * The **watchdog thread is the sole writer** to the command sink. The WS / REST
    handlers only mutate session state (last heartbeat, intent, seq). If the
    handler thread dies, the watchdog still runs and trips the deadman.

Defense in depth on a deadman trip:
  1. Belt: the watchdog writes NEUTRAL bytes to the override file immediately.
  2. Suspenders: it then stops writing, so the file goes stale and the main loop
     drops ``bt_override`` to ``None`` within 600 ms → RC regains authority.
Both independently bring the robot to a stop.

The core ``TeleopSession`` has **no Flask dependency** so it is unit-testable with
a mock motor sink and an injected clock. The Flask/WebSocket layer below is a
thin adapter.
"""

from __future__ import annotations

import json
import logging
import threading
import time
from pathlib import Path
from typing import Callable, Optional, Tuple

from pi_app.app import phone_override as _phone_override
from pi_app.control.mapping import CENTER_OUTPUT_VALUE
from pi_app.io.bt_proto import floats_to_bytes

logger = logging.getLogger(__name__)

# Default speed caps applied server-side to the normalized [-1, 1] track values.
DEFAULT_SPEED_CAPS = {"slow": 0.3, "normal": 0.6, "fast": 1.0}
DEFAULT_SPEED_LEVEL = "slow"

# Fail-safe timing.
DEADMAN_TIMEOUT_S = 0.25   # >250 ms without a heartbeat while armed -> trip
STALE_COMMAND_S = 0.30     # drive commands older than this (by client clock) dropped
ARM_HOLD_MIN_MS = 500      # UI press-and-hold floor before an arm message is honored
WATCHDOG_HZ = 50.0         # watchdog tick rate (20 ms) — comfortably tighter than 250 ms


class TeleopSession:
    """Fail-safe state machine for one phone-teleop session.

    Thread-safe. All public methods take an optional ``now`` (monotonic seconds)
    so tests can drive the clock deterministically; production passes the real
    ``now_fn`` at construction and lets the watchdog supply ``now``.

    The sink ``command_sink(left_byte, right_byte)`` is the ONLY way motor
    commands leave this object. In production it writes the override file; in
    tests it is a mock motor's ``set_tracks``.
    """

    def __init__(
        self,
        *,
        command_sink: Callable[[int, int], None],
        rc_state_provider: Optional[Callable[[], Optional[Tuple[bool, bool]]]] = None,
        now_fn: Callable[[], float] = time.monotonic,
        deadman_timeout_s: float = DEADMAN_TIMEOUT_S,
        stale_command_s: float = STALE_COMMAND_S,
        arm_hold_min_ms: int = ARM_HOLD_MIN_MS,
        require_rc_arm: bool = True,
        speed_caps: Optional[dict] = None,
    ) -> None:
        self._sink = command_sink
        # rc_state_provider() -> (rc_armed: bool, rc_estop: bool) | None
        #   None  => RC state unknown (e.g. no telemetry yet) -> do not force-disarm.
        self._rc_state_provider = rc_state_provider
        self._now = now_fn
        self._deadman_s = float(deadman_timeout_s)
        self._stale_s = float(stale_command_s)
        self._arm_hold_min_ms = int(arm_hold_min_ms)
        self._require_rc_arm = bool(require_rc_arm)
        self._caps = dict(speed_caps or DEFAULT_SPEED_CAPS)

        self._lock = threading.RLock()
        # ---- session state ----
        self.armed: bool = False
        self.estop_latched: bool = False
        self.speed_level: str = DEFAULT_SPEED_LEVEL
        self.tripped_reason: Optional[str] = None
        self._last_hb: float = 0.0          # monotonic of last heartbeat/accepted drive
        self._last_seq: int = -1            # last accepted drive sequence number
        self._max_client_ts: float = float("-inf")  # newest client timestamp (ms) seen
        self._intent: Tuple[float, float] = (0.0, 0.0)  # last commanded (left_f, right_f)
        self._driving: bool = False         # are we actively writing drive bytes?
        self._last_echo_ts: Optional[float] = None  # last client ts, echoed for RTT calc
        # ---- single-driver lock (DEFECT-1) ----
        # Exactly one client may hold the session armed. The client that completes
        # the arm ceremony becomes the driver; arm/drive from any other client is
        # refused. e-stop is accepted from ANY client (never lock out a stop). The
        # lock is released on driver disconnect, deadman trip, disarm, or e-stop.
        # A None driver id means "no one holds the lock" (bench/single-client).
        self._driver_id: Optional[str] = None
        # ---- e-stop physical re-arm gate (DEFECT-4) ----
        # When RC state has ever been observed, a latched e-stop is cleared from
        # the browser only AFTER an RC ch3 cycle (rc_armed False->True). In bench
        # mode (no RC ever seen) the two-tap browser clear remains.
        self._rc_ever_seen: bool = False         # provider has ever returned non-None
        self._rc_saw_disarm_since_estop: bool = False  # saw rc_armed False post-estop
        self._rc_rearm_since_estop: bool = False       # observed False->True post-estop
        # ---- watchdog thread ----
        self._wd_thread: Optional[threading.Thread] = None
        self._wd_stop = threading.Event()

    # -- arming ceremony ----------------------------------------------------

    def arm(self, *, rc_in_hand: bool = False, hold_ms: int = 0,
            client_id: Optional[str] = None,
            now: Optional[float] = None) -> Tuple[bool, str]:
        """Attempt to arm the phone session.

        Refuses while the e-stop is latched. Requires the robot to be RC-armed,
        OR an explicit ``rc_in_hand`` confirmation ("RC is in my hand"). A phone
        on the LAN therefore can never arm-and-drive with zero ceremony: it needs
        the press-and-hold (``hold_ms``) AND either RC already armed or the
        explicit confirmation. (The downstream controller RC gate applies
        regardless — teleop still cannot move the robot unless RC keeps it armed.)

        Single-driver lock (DEFECT-1): if another client already holds the driver
        lock, a different ``client_id`` is refused with ``"not_driver"``. The
        client that successfully arms becomes (or remains) the driver. A ``None``
        ``client_id`` leaves the lock untouched (bench / single-client).
        """
        with self._lock:
            now = self._now() if now is None else now
            # Driver lock: a different client cannot arm over the current driver.
            if (client_id is not None and self._driver_id is not None
                    and client_id != self._driver_id):
                return False, "not_driver"
            if self.estop_latched:
                return False, "estop_latched"
            if hold_ms < self._arm_hold_min_ms:
                return False, "hold_too_short"
            if self._require_rc_arm and not rc_in_hand:
                rc = self._read_rc_state()
                # rc is (rc_armed, rc_estop) or None (unknown).
                if rc is None or not rc[0] or rc[1]:
                    return False, "rc_not_armed"
            self.armed = True
            self.tripped_reason = None
            self._last_hb = now          # grace: first watchdog tick won't trip
            self._last_seq = -1
            self._max_client_ts = float("-inf")
            self._intent = (0.0, 0.0)
            # The client that completes the ceremony owns the driver lock.
            if client_id is not None:
                self._driver_id = client_id
            return True, "armed"

    def disarm(self, reason: str = "user", *, client_id: Optional[str] = None) -> None:
        with self._lock:
            self.armed = False
            self.tripped_reason = reason
            self._intent = (0.0, 0.0)
            self._driver_id = None      # release the single-driver lock
            self._stop_motor_if_driving()

    # -- e-stop (latched) ---------------------------------------------------

    def estop(self, *, client_id: Optional[str] = None) -> None:
        """Server-side latched e-stop: neutral + disarm + latch.

        Accepted from ANY client (never lock out a stop). Independent of the RC
        ch5 e-stop. The latch survives reconnects and is cleared only by
        ``clear_estop`` (subject to the physical re-arm gate when RC is present)
        followed by a fresh ``arm``.
        """
        with self._lock:
            self.estop_latched = True
            self.armed = False
            self.tripped_reason = "estop"
            self._intent = (0.0, 0.0)
            self._driver_id = None      # release the single-driver lock
            # Reset the physical re-arm tracking: a clear now requires a fresh
            # RC ch3 cycle (False then True) observed AFTER this e-stop.
            self._rc_saw_disarm_since_estop = False
            self._rc_rearm_since_estop = False
            self._stop_motor_if_driving()

    def clear_estop(self) -> Tuple[bool, str]:
        """Dismiss the latched e-stop. Does NOT re-arm — arm() must be called.

        Physical re-arm gate (DEFECT-4): when RC state has ever been observed,
        the latch is "latched until physical re-arm" — clear is REFUSED until an
        RC ch3 cycle (rc_armed False->True) has been seen since the e-stop. In
        bench mode (no RC ever observed) the two-tap browser clear remains.

        Returns ``(ok, reason)``.
        """
        with self._lock:
            if not self.estop_latched:
                return True, "not_latched"
            if self._rc_ever_seen and not self._rc_rearm_since_estop:
                # RC is the authority; require the physical ch3 re-arm cycle.
                return False, "cycle_rc_ch3"
            self.estop_latched = False
            if self.tripped_reason == "estop":
                self.tripped_reason = None
            return True, "cleared"

    # -- inputs from the phone ---------------------------------------------

    def heartbeat(self, *, client_ts: Optional[float] = None,
                  client_id: Optional[str] = None,
                  now: Optional[float] = None) -> None:
        """Liveness ping. Refreshes the deadman only while armed.

        After a trip the session is disarmed; heartbeats keep arriving but do
        NOT re-arm — re-arm requires an explicit ``arm`` message.

        Driver lock (DEFECT-1): only the driver's heartbeat refreshes the
        deadman; a non-driver heartbeat must not keep someone else's armed
        session alive. RTT echo is still recorded for any client.
        """
        with self._lock:
            now = self._now() if now is None else now
            if client_ts is not None:
                self._last_echo_ts = client_ts
            if (client_id is not None and self._driver_id is not None
                    and client_id != self._driver_id):
                return
            if self.armed and not self.estop_latched:
                self._last_hb = now

    def drive(self, *, left_f: float, right_f: float, seq: Optional[int] = None,
              client_ts: Optional[float] = None, client_id: Optional[str] = None,
              now: Optional[float] = None) -> str:
        """Apply a drive intent (also serves as a heartbeat when accepted).

        Stale-command guard: a command whose ``seq`` is not strictly greater than
        the last accepted seq is dropped (out-of-order). A command whose
        ``client_ts`` is older than the newest seen client timestamp by more than
        ``stale_command_s`` is dropped (stale). Commands are ignored entirely
        while e-stopped or not armed.

        Driver lock (DEFECT-1): a ``drive`` from a client that is not the current
        driver is refused with ``"not_driver"``.

        Returns a short status string describing what happened.
        """
        with self._lock:
            now = self._now() if now is None else now
            if client_ts is not None:
                self._last_echo_ts = client_ts

            # Single-driver lock: reject before touching any guard/intent state.
            if (client_id is not None and self._driver_id is not None
                    and client_id != self._driver_id):
                return "not_driver"

            # Ordering / staleness guards run regardless of arm state so a stale
            # packet can never be "accepted" later.
            if seq is not None:
                if seq <= self._last_seq:
                    return "dropped_out_of_order"
            if client_ts is not None and self._max_client_ts != float("-inf"):
                # client_ts in ms; stale window in seconds.
                if client_ts < self._max_client_ts - (self._stale_s * 1000.0):
                    return "dropped_stale"

            if self.estop_latched:
                return "ignored_estop"
            if not self.armed:
                return "ignored_disarmed"

            # Accept: advance guards, refresh deadman, store intent.
            if seq is not None:
                self._last_seq = seq
            if client_ts is not None:
                self._max_client_ts = max(self._max_client_ts, client_ts)
            self._intent = (
                max(-1.0, min(1.0, float(left_f))),
                max(-1.0, min(1.0, float(right_f))),
            )
            self._last_hb = now
            return "accepted"

    def set_speed(self, level: str) -> bool:
        with self._lock:
            if level not in self._caps:
                return False
            self.speed_level = level
            return True

    # -- single-driver lock helpers (DEFECT-1) ------------------------------

    def is_driver(self, client_id: Optional[str]) -> bool:
        """True if ``client_id`` currently holds (or may take) the driver lock.

        A ``None`` client id (bench / single-client) is always treated as the
        driver. A real id is the driver only when no one else holds the lock.
        """
        with self._lock:
            if client_id is None:
                return True
            return self._driver_id is None or self._driver_id == client_id

    def release_driver(self, client_id: Optional[str]) -> None:
        """Release the driver lock if ``client_id`` holds it (e.g. on disconnect).

        Also disarms the session: the driver going away is exactly the kind of
        event the deadman protects against, and dropping the lock without
        disarming would leave an armed-but-ownerless session.
        """
        with self._lock:
            if client_id is not None and self._driver_id == client_id:
                self._driver_id = None
                if self.armed:
                    self.armed = False
                    self.tripped_reason = "driver_left"
                    self._intent = (0.0, 0.0)
                    self._stop_motor_if_driving()

    def notify_rc_state(self, rc_armed: bool, rc_estop: bool) -> None:
        """RC authority hook. If RC is not armed or RC e-stop is active, force the
        phone session disarmed immediately — RC overrides phone state at all times.
        Safe to call from any thread; the watchdog also re-checks every tick.
        """
        with self._lock:
            self._rc_ever_seen = True
            # Track the ch3 re-arm cycle for the e-stop physical-clear gate.
            self._observe_rc_rearm_edge(rc_armed)
            if (not rc_armed) or rc_estop:
                if self.armed:
                    self.armed = False
                    self.tripped_reason = "rc_override"
                    self._intent = (0.0, 0.0)
                    self._driver_id = None      # release the single-driver lock
                    self._stop_motor_if_driving()

    # -- the watchdog: server-side enforcement -----------------------------

    def tick(self, now: Optional[float] = None) -> str:
        """One watchdog iteration. THIS is where the deadman is enforced.

        Order of authority (highest first):
          1. RC override   — RC disarm / RC e-stop forces session disarm.
          2. Latched e-stop — UI big-red-button.
          3. Disarmed       — nothing to enforce; ensure a stop was emitted.
          4. Deadman        — armed but heartbeat older than 250 ms → trip.
          5. Driving        — armed + fresh → write the capped intent.

        Returns a short status for logging/telemetry. The watchdog thread calls
        this ~50 Hz; tests call it directly with a controlled ``now``.
        """
        with self._lock:
            now = self._now() if now is None else now

            # 1. RC authority — always wins.
            rc = self._read_rc_state()
            if rc is not None:
                rc_armed, rc_estop = rc
                # Track the ch3 re-arm cycle for the e-stop physical-clear gate.
                self._observe_rc_rearm_edge(rc_armed)
                if (not rc_armed) or rc_estop:
                    if self.armed:
                        self.armed = False
                        self.tripped_reason = "rc_override"
                        self._driver_id = None  # release the single-driver lock
                    self._stop_motor_if_driving()
                    return "rc_override"

            # 2. Latched e-stop.
            if self.estop_latched:
                self._stop_motor_if_driving()
                return "estop"

            # 3. Disarmed: ensure we emitted a final neutral, then stay quiet so we
            #    don't suppress RC by continuously stamping the override file.
            if not self.armed:
                self._stop_motor_if_driving()
                return "idle"

            # 4. Deadman: armed but no fresh heartbeat.
            if (now - self._last_hb) > self._deadman_s:
                self.armed = False
                self.tripped_reason = "deadman"
                self._driver_id = None      # release the single-driver lock
                self._stop_motor_if_driving()
                # WARNING, not INFO: the app installs no logging handler, and a
                # deadman trip is a safety event the operator sees as a
                # mysterious lock (2026-09-19: a backgrounded phone tab).
                logger.warning(
                    "teleop deadman tripped: %.0f ms since last heartbeat "
                    "(timeout %.0f ms); session disarmed, press-and-hold ARM required",
                    (now - self._last_hb) * 1000.0, self._deadman_s * 1000.0,
                )
                return "deadman_trip"

            # 5. Armed + fresh: drive the capped intent.
            cap = self._caps.get(self.speed_level, self._caps[DEFAULT_SPEED_LEVEL])
            lf, rf = self._intent
            left_byte, right_byte = floats_to_bytes(lf * cap, rf * cap)
            self._sink(left_byte, right_byte)
            self._driving = True
            return "driving"

    def start_watchdog(self) -> None:
        """Spawn the daemon watchdog thread (production)."""
        with self._lock:
            if self._wd_thread is not None and self._wd_thread.is_alive():
                return
            self._wd_stop.clear()
            self._wd_thread = threading.Thread(
                target=self._watchdog_loop, name="TeleopWatchdog", daemon=True
            )
            self._wd_thread.start()
            logger.info("Teleop watchdog started (deadman=%dms, %.0f Hz)",
                        int(self._deadman_s * 1000), WATCHDOG_HZ)

    def stop_watchdog(self) -> None:
        self._wd_stop.set()
        with self._lock:
            self._stop_motor_if_driving()

    def _watchdog_loop(self) -> None:
        period = 1.0 / WATCHDOG_HZ
        while not self._wd_stop.is_set():
            try:
                self.tick()
            except Exception:  # never let the safety loop die
                logger.exception("Teleop watchdog tick failed")
            time.sleep(period)

    # -- status -------------------------------------------------------------

    def status(self, *, client_id: Optional[str] = None,
               now: Optional[float] = None) -> dict:
        with self._lock:
            now = self._now() if now is None else now
            hb_age_ms = None
            if self.armed and self._last_hb > 0.0:
                hb_age_ms = int(round((now - self._last_hb) * 1000.0))
            rc = self._read_rc_state()
            # Whether a browser clear_estop would be refused pending an RC ch3
            # cycle (DEFECT-4). False in bench mode (no RC ever observed).
            estop_clear_gated = bool(
                self.estop_latched and self._rc_ever_seen
                and not self._rc_rearm_since_estop
            )
            return {
                "armed": self.armed,
                "estop_latched": self.estop_latched,
                "estop_clear_gated": estop_clear_gated,
                "speed_level": self.speed_level,
                "speed_cap": self._caps.get(self.speed_level),
                "tripped_reason": self.tripped_reason,
                "deadman_ms": int(self._deadman_s * 1000),
                "heartbeat_age_ms": hb_age_ms,
                "rc_state": rc,
                "echo_ts": self._last_echo_ts,
                # Single-driver lock (DEFECT-1): is THIS client the driver / can
                # it take the lock? has_driver tells the UI someone else holds it.
                "has_driver": self._driver_id is not None,
                "is_driver": (client_id is None
                              or self._driver_id is None
                              or self._driver_id == client_id),
            }

    # -- internals ----------------------------------------------------------

    def _read_rc_state(self) -> Optional[Tuple[bool, bool]]:
        if self._rc_state_provider is None:
            return None
        try:
            rc = self._rc_state_provider()
        except Exception:
            logger.exception("rc_state_provider raised")
            return None
        if rc is not None:
            # Latch the fact that RC is the authority for this session; once seen,
            # the e-stop physical-re-arm gate (DEFECT-4) applies.
            self._rc_ever_seen = True
        return rc

    def _observe_rc_rearm_edge(self, rc_armed: bool) -> None:
        """Track an RC ch3 re-arm cycle (False->True) AFTER a latched e-stop.

        Called every time we read a real RC state while the e-stop is latched.
        Must run holding ``self._lock``.
        """
        if not self.estop_latched:
            return
        if not rc_armed:
            self._rc_saw_disarm_since_estop = True
        elif self._rc_saw_disarm_since_estop:
            self._rc_rearm_since_estop = True

    def _stop_motor_if_driving(self) -> None:
        """Emit ONE neutral command if we were driving, then stop writing.

        Writing neutral only on the driving->stopped edge (rather than every idle
        tick) is deliberate: continuously stamping the override file would make
        the main loop treat teleop as 'fresh' forever and suppress the RC sticks.
        On a real stop we emit the immediate neutral (belt) and then let the file
        go stale so RC regains authority (suspenders).
        """
        if self._driving:
            try:
                self._sink(CENTER_OUTPUT_VALUE, CENTER_OUTPUT_VALUE)
            except Exception:
                logger.exception("Teleop neutral write failed")
            self._driving = False


# ---------------------------------------------------------------------------
# Production command sink: write the shared override file the main loop reads.
# ---------------------------------------------------------------------------

class FileCommandSink:
    """Writes ``/tmp/wall_e_bt_latest.json`` in the schema ``main.py`` consumes.

    Same file + schema as the now-retired ``/api/teleop`` endpoint used to
    write, so this rides the already-audited RC-gated override path rather
    than touching the motor. This is now the sole session-gated writer; see
    the module docstring for the other (uncoordinated) writers that remain:
    ``pi_app/cli/spp_server.py``.
    """

    def __init__(self, path: str = "/tmp/wall_e_bt_latest.json") -> None:
        self._path = Path(path)

    def __call__(self, left_byte: int, right_byte: int) -> None:
        self._path.write_text(
            json.dumps({
                "left_byte": int(left_byte),
                "right_byte": int(right_byte),
                # main.py judges freshness on the monotonic stamp and the
                # boot ID (pi_app/app/phone_override.py); the epoch is for
                # people. The boot ID stops a command left in /tmp from an
                # earlier boot from looking fresh at the same uptime.
                "last_update_mono_s": time.monotonic(),
                "boot_id": _phone_override.BOOT_ID,
                "last_update_epoch_s": time.time(),
            }),
            encoding="utf-8",
        )


def make_recorder_rc_state_provider(
    recorder, *, staleness_s: float = 1.0,
    now_fn: Callable[[], float] = time.monotonic,
) -> Callable[[], Optional[Tuple[bool, bool]]]:
    """Build an rc_state_provider from the OAK recorder's latest telemetry.

    Returns ``(rc_armed, rc_estop)``:
      * ``rc_estop`` reflects the latched RC ch5 emergency (``emergency_active``).
      * ``rc_armed`` reflects the controller's armed state (``is_armed``).

    Fail-safe semantics (DEFECT-2 / DEFECT-3):
      * If telemetry has NEVER been seen (recorder is None, or it has not yet
        produced a snapshot), return ``None`` — RC state is genuinely unknown, so
        the session must not force-disarm (bench-mode behavior unchanged).
      * Once telemetry HAS been seen, a frozen/stale object is a fault, not a
        valid "all clear": if the newest snapshot's monotonic stamp is older than
        ``staleness_s`` (default 1.0 s) we return ``(False, False)`` so the rc
        gate force-disarms the teleop session. A frozen telemetry object must
        never keep the session armable forever.
    """
    # Closure flag: have we EVER observed a real telemetry snapshot? Once True we
    # apply the staleness fail-safe; until then we report "unknown" (None).
    seen: dict = {"any": False}

    def _provider() -> Optional[Tuple[bool, bool]]:
        if recorder is None:
            return None
        try:
            t = recorder.get_latest_telemetry()
        except Exception:
            # Transient read miss while telemetry has previously flowed is a
            # fault → force-disarm rather than silently reporting "unknown".
            return (False, False) if seen["any"] else None
        if t is None:
            return None
        seen["any"] = True
        # Staleness bound: a telemetry object whose monotonic stamp is older than
        # staleness_s means the main loop has stopped updating it → fail-safe.
        ts_mono = getattr(t, "ts_mono", 0.0)
        try:
            age = now_fn() - float(ts_mono)
        except Exception:
            age = float("inf")
        if not ts_mono or age > staleness_s:
            return (False, False)
        rc_armed = bool(getattr(t, "is_armed", False))
        rc_estop = bool(getattr(t, "emergency_active", False))
        return rc_armed, rc_estop
    return _provider


def make_recorder_battery_provider(recorder) -> Callable[[], Optional[float]]:
    """Best-effort pack voltage from telemetry for the UI status line."""
    def _provider() -> Optional[float]:
        if recorder is None:
            return None
        try:
            t = recorder.get_latest_telemetry()
        except Exception:
            return None
        if t is None:
            return None
        v = getattr(t, "bms_voltage_v", None)
        return float(v) if isinstance(v, (int, float)) else None
    return _provider


# ---------------------------------------------------------------------------
# Auth token resolution (Item F — hardening)
# ---------------------------------------------------------------------------

# Env var name and the default on-disk token path.
TELEOP_TOKEN_ENV = "WALL_E_TELEOP_TOKEN"
DEFAULT_TOKEN_PATH = "~/.config/wall_e/teleop_token"


def resolve_teleop_token(
    explicit: Optional[str] = None,
    *,
    token_path: str = DEFAULT_TOKEN_PATH,
    env: Optional[dict] = None,
) -> str:
    """Resolve the teleop auth token. Returns "" to mean *auth disabled*.

    Resolution order (Item F):
      1. An explicit non-empty ``explicit`` argument wins (caller override).
      2. The ``WALL_E_TELEOP_TOKEN`` env var IF IT IS SET — even when set to the
         empty string. ``WALL_E_TELEOP_TOKEN=""`` (set-but-empty) is the
         documented way to DISABLE auth for bench use → returns "".
      3. Otherwise a token file (default ``~/.config/wall_e/teleop_token``),
         auto-generated with ``secrets.token_hex(16)`` and ``chmod 600`` on first
         use if absent.

    The token VALUE is never logged or printed — only the file path is logged.
    """
    import os

    if explicit:
        return explicit

    environ = os.environ if env is None else env
    if TELEOP_TOKEN_ENV in environ:
        # Set (possibly empty). Empty => auth explicitly disabled.
        return environ[TELEOP_TOKEN_ENV]

    # Env unset: fall back to the on-disk token, generating it if missing.
    import secrets

    path = Path(os.path.expanduser(token_path))
    try:
        if path.exists():
            tok = path.read_text(encoding="utf-8").strip()
            if tok:
                logger.info("Teleop auth: using token file %s", path)
                return tok
        # Absent or empty: generate, persist with restrictive perms.
        path.parent.mkdir(parents=True, exist_ok=True)
        tok = secrets.token_hex(16)
        path.write_text(tok, encoding="utf-8")
        try:
            os.chmod(path, 0o600)
        except OSError:
            pass
        logger.info("Teleop auth: generated token file %s (chmod 600)", path)
        return tok
    except Exception:
        # If the filesystem is unusable, fail CLOSED with an ephemeral token so
        # the surface is not silently left open. Never logs the value.
        logger.exception("Teleop auth: token file %s unusable — using ephemeral token", path)
        return secrets.token_hex(16)


# ---------------------------------------------------------------------------
# Flask / WebSocket adapter (thin — all enforcement lives in TeleopSession)
# ---------------------------------------------------------------------------

def register_teleop(app, session: "TeleopSession", *, token: Optional[str] = None,
                    battery_provider: Optional[Callable[[], Optional[float]]] = None,
                    token_path: str = DEFAULT_TOKEN_PATH,
                    frame_source: Optional[Callable[[], Optional[bytes]]] = None,
                    frame_client_hook: Optional[Callable[[bool], None]] = None) -> None:
    """Register the /drive page, the drive WebSocket, and REST fallbacks on ``app``.

    Additive only: it adds new routes and does not modify any existing route.

    Auth (Item F): the effective token is resolved via ``resolve_teleop_token``:
    an explicit non-empty ``token`` wins; otherwise ``WALL_E_TELEOP_TOKEN`` if set
    (empty string = auth OFF for bench use); otherwise an auto-generated token
    file. The token is required on ``/drive``, the WS upgrade, and the REST
    mirror, supplied as ``?token=`` (browsers can't set WS headers) OR the
    ``X-Teleop-Token`` header. PWA manifest/icon routes stay open.

    Backward compatible: ``oak_viewer.py`` passes ``token=os.environ.get(
    "WALL_E_TELEOP_TOKEN", "")``. A falsy passed value triggers full resolution
    (env-or-file), so an unset env now activates the file-based token instead of
    leaving the surface open.

    The WS / REST handlers ONLY mutate session state — the watchdog thread is
    what reaches the motor, so a dying handler cannot keep the robot driving.
    """
    from flask import Blueprint, Response, request

    # Resolve the effective token. A falsy ``token`` (None or "" from the
    # legacy oak_viewer call) defers to env/file resolution; a non-empty string
    # is an explicit override.
    token = resolve_teleop_token(token, token_path=token_path)

    bp = Blueprint("teleop", __name__)

    def _auth_ok() -> bool:
        if not token:
            return True  # auth explicitly disabled (WALL_E_TELEOP_TOKEN="")
        supplied = request.args.get("token") or request.headers.get("X-Teleop-Token")
        return supplied == token

    def _client_id() -> Optional[str]:
        """Per-request client id for the single-driver lock (DEFECT-1).

        REST clients pass ``?cid=`` (or ``X-Teleop-Client`` header). None means
        "no id" → lock not enforced for that caller (bench/single-client).
        """
        return request.args.get("cid") or request.headers.get("X-Teleop-Client") or None

    def _json(obj, status=200):
        return Response(json.dumps(obj), status=status, content_type="application/json")

    def _battery_v():
        if battery_provider is None:
            return None
        try:
            return battery_provider()
        except Exception:
            return None

    def _status_payload(client_id=None):
        st = session.status(client_id=client_id)
        st["battery_v"] = _battery_v()
        st["server_t"] = time.time()
        st["camera_available"] = frame_source is not None
        return st

    # -- page ---------------------------------------------------------------

    @bp.route("/drive")
    def drive_page():
        if not _auth_ok():
            return Response("unauthorized", status=401)
        return Response(_DRIVE_HTML, content_type="text/html")

    # -- REST fallbacks (mirror the WS messages; deadman still watchdog-enforced)

    @bp.route("/api/teleop/session/arm", methods=["POST"])
    def rest_arm():
        if not _auth_ok():
            return _json({"error": "unauthorized"}, 401)
        p = request.get_json(silent=True) or {}
        cid = _client_id()
        ok, reason = session.arm(rc_in_hand=bool(p.get("rc_in_hand", False)),
                                 hold_ms=int(p.get("hold_ms", 0)), client_id=cid)
        return _json({"ok": ok, "reason": reason, "status": _status_payload(cid)})

    @bp.route("/api/teleop/session/disarm", methods=["POST"])
    def rest_disarm():
        if not _auth_ok():
            return _json({"error": "unauthorized"}, 401)
        cid = _client_id()
        session.disarm(client_id=cid)
        return _json({"ok": True, "status": _status_payload(cid)})

    @bp.route("/api/teleop/session/estop", methods=["POST"])
    def rest_estop():
        if not _auth_ok():
            return _json({"error": "unauthorized"}, 401)
        cid = _client_id()
        # e-stop is accepted from ANY authenticated client — never lock out a stop.
        session.estop(client_id=cid)
        return _json({"ok": True, "status": _status_payload(cid)})

    @bp.route("/api/teleop/session/clear_estop", methods=["POST"])
    def rest_clear_estop():
        if not _auth_ok():
            return _json({"error": "unauthorized"}, 401)
        cid = _client_id()
        ok, reason = session.clear_estop()
        return _json({"ok": ok, "reason": reason, "status": _status_payload(cid)})

    @bp.route("/api/teleop/session/speed", methods=["POST"])
    def rest_speed():
        if not _auth_ok():
            return _json({"error": "unauthorized"}, 401)
        p = request.get_json(silent=True) or {}
        ok = session.set_speed(str(p.get("level", "")))
        return _json({"ok": ok, "status": _status_payload(_client_id())})

    @bp.route("/api/teleop/session/drive", methods=["POST"])
    def rest_drive():
        if not _auth_ok():
            return _json({"error": "unauthorized"}, 401)
        p = request.get_json(silent=True) or {}
        cid = _client_id()
        result = session.drive(
            left_f=float(p.get("left", 0.0)), right_f=float(p.get("right", 0.0)),
            seq=p.get("seq"), client_ts=p.get("t"), client_id=cid,
        )
        return _json({"result": result, "status": _status_payload(cid)})

    @bp.route("/api/teleop/session/status")
    def rest_status():
        if not _auth_ok():
            return _json({"error": "unauthorized"}, 401)
        return _json(_status_payload(_client_id()))

    @bp.route("/api/teleop/camera/frame")
    def rest_camera_frame():
        """REST fallback: latest JPEG frame, token-gated.

        Returns 401 when auth fails, 503 when no frame source is registered or
        the frame source returns None after the poll window.

        If a ``frame_client_hook`` is provided and the initial frame_source()
        call returns None (preview not yet enabled), the hook is called with
        True to register this client, then frame_source is polled for up to
        ~0.8 s at 50 ms intervals.  The hook(False) is always called in a
        finally block so the recorder's client count stays balanced.
        """
        if not _auth_ok():
            return Response("unauthorized", status=401)
        if frame_source is None:
            return Response("no camera source", status=503)
        try:
            data = frame_source()
        except Exception:
            logger.exception("camera frame_source raised")
            data = None
        if not data and frame_client_hook is not None:
            # Preview not yet active — register this caller and poll briefly.
            try:
                frame_client_hook(True)
            except Exception:
                logger.exception("frame_client_hook(True) raised in REST camera frame")
            try:
                _POLL_INTERVAL_S = 0.05
                _POLL_TOTAL_S = 0.80
                _polls = int(_POLL_TOTAL_S / _POLL_INTERVAL_S)
                for _ in range(_polls):
                    time.sleep(_POLL_INTERVAL_S)
                    try:
                        data = frame_source()
                    except Exception:
                        logger.exception("camera frame_source raised during poll")
                        data = None
                    if data:
                        break
            finally:
                try:
                    frame_client_hook(False)
                except Exception:
                    logger.exception("frame_client_hook(False) raised in REST camera frame")
        if not data:
            return Response("no frame available", status=503)
        return Response(data, status=200, content_type="image/jpeg")

    # -- PWA assets (additive; no auth — manifest/icons are public) ----------

    @bp.route("/drive/manifest.json")
    def drive_manifest():
        return Response(_MANIFEST_JSON, content_type="application/manifest+json")

    @bp.route("/drive/icon.svg")
    def drive_icon_svg():
        return Response(_ROBOT_SVG, content_type="image/svg+xml")

    @bp.route("/drive/icon-<int:size>.png")
    def drive_icon_png(size):
        if size not in (180, 192, 512):
            from flask import abort as _abort
            _abort(404)
        return Response(_get_robot_png(size), content_type="image/png")

    app.register_blueprint(bp)

    # -- WebSocket ----------------------------------------------------------

    try:
        from flask_sock import Sock
    except Exception:
        logger.warning("flask-sock not installed — /drive WS disabled, REST fallback only")
        return

    sock = Sock(app)

    @sock.route("/ws/drive")
    def ws_drive(ws):  # pragma: no cover - exercised via integration, not unit tests
        import secrets as _secrets
        from flask import request as _req
        if token:
            # Accept the token via ?token= (browsers can't set WS headers) OR the
            # X-Teleop-Token header — fixes the audited WS/REST inconsistency.
            supplied = _req.args.get("token") or _req.headers.get("X-Teleop-Token")
            if supplied != token:
                try:
                    ws.send(json.dumps({"type": "error", "error": "unauthorized"}))
                finally:
                    ws.close()
                return

        # Server-issued per-connection client id for the single-driver lock
        # (DEFECT-1). Each WS connection is a distinct driver candidate.
        client_id = "ws-" + _secrets.token_hex(8)
        try:
            ws.send(json.dumps({"type": "hello", "client_id": client_id}))
        except Exception:
            return

        stop = threading.Event()

        def _pump_status():
            # Push status ~5 Hz so the phone always has a fresh deadman/arm/latency view.
            while not stop.is_set():
                try:
                    ws.send(json.dumps({"type": "status", **_status_payload(client_id)}))
                except Exception:
                    break
                time.sleep(0.2)

        sender = threading.Thread(target=_pump_status, name="TeleopWsStatus", daemon=True)
        sender.start()
        try:
            while True:
                raw = ws.receive()  # blocks; returns None on close
                if raw is None:
                    break
                try:
                    msg = json.loads(raw)
                except Exception:
                    continue
                _dispatch_ws(session, msg, client_id)
        finally:
            stop.set()
            # Release the single-driver lock so the session does not stay armed
            # without an owner once this connection goes away (DEFECT-1). This
            # disarms via release_driver(); it does NOT replace the deadman — the
            # watchdog still trips within 250 ms if heartbeats merely stop while a
            # connection somehow lingers. We do not rely on this path to stop the
            # robot; it only clears ownership.
            try:
                session.release_driver(client_id)
            except Exception:
                logger.exception("release_driver on WS close failed")

    # -- Camera WebSocket (only when a frame_source is provided) -------------
    # Completely separate socket from /ws/drive so camera latency never
    # affects the control channel or the deadman cadence.

    if frame_source is not None:
        _CAMERA_TARGET_HZ = 8.0
        _CAMERA_FRAME_S = 1.0 / _CAMERA_TARGET_HZ   # 125 ms nominal period

        @sock.route("/ws/camera")
        def ws_camera(ws):  # pragma: no cover - exercised via integration, not unit tests
            from flask import request as _req
            if token:
                supplied = _req.args.get("token") or _req.headers.get("X-Teleop-Token")
                if supplied != token:
                    try:
                        ws.send(json.dumps({"type": "error", "error": "unauthorized"}))
                    except Exception:
                        pass
                    finally:
                        try:
                            ws.close()
                        except Exception:
                            pass
                    return

            # Register this WS connection as a preview client so the recorder
            # starts producing JPEG previews (OakRecorder only generates them
            # when at least one consumer is connected).
            if frame_client_hook is not None:
                try:
                    frame_client_hook(True)
                except Exception:
                    logger.exception("frame_client_hook(True) raised in /ws/camera")

            try:
                # Push JPEG frames as binary messages at ~8 fps.
                # Pacing: record the wall-clock time before the send; if the send
                # took longer than one frame period (slow send, network backpressure)
                # skip the sleep entirely to avoid building a queue.  This keeps the
                # frame rate honest without queuing stale frames.
                while True:
                    t0 = time.monotonic()
                    try:
                        data = frame_source()
                    except Exception:
                        logger.exception("camera frame_source raised in /ws/camera")
                        data = None
                    if data:
                        try:
                            ws.send(data)
                        except Exception:
                            break   # client disconnected or error; exit cleanly
                    elapsed = time.monotonic() - t0
                    remaining = _CAMERA_FRAME_S - elapsed
                    if remaining > 0:
                        time.sleep(remaining)
            finally:
                # Always deregister — the hook is called exactly once per direction
                # per connection, so the recorder's client count stays balanced.
                if frame_client_hook is not None:
                    try:
                        frame_client_hook(False)
                    except Exception:
                        logger.exception("frame_client_hook(False) raised in /ws/camera")


def _dispatch_ws(session: "TeleopSession", msg: dict,
                 client_id: Optional[str] = None) -> None:
    mtype = msg.get("type")
    if mtype == "drive":
        session.drive(
            left_f=float(msg.get("left", 0.0)), right_f=float(msg.get("right", 0.0)),
            seq=msg.get("seq"), client_ts=msg.get("t"), client_id=client_id,
        )
    elif mtype == "hb":
        session.heartbeat(client_ts=msg.get("t"), client_id=client_id)
    elif mtype == "arm":
        session.arm(rc_in_hand=bool(msg.get("rc_in_hand", False)),
                    hold_ms=int(msg.get("hold_ms", 0)), client_id=client_id)
    elif mtype == "disarm":
        session.disarm(client_id=client_id)
    elif mtype == "estop":
        # e-stop accepted from ANY client — never lock out a stop.
        session.estop(client_id=client_id)
    elif mtype == "clear_estop":
        session.clear_estop()
    elif mtype == "speed":
        session.set_speed(str(msg.get("level", "")))


# ---------------------------------------------------------------------------
# PWA assets: manifest, SVG icon, and pure-Python PNG icon generator
# (no external image library required).
# ---------------------------------------------------------------------------

_MANIFEST_JSON = json.dumps({
    "name": "WALL-E Drive",
    "short_name": "W-E Drive",
    "description": "Fail-safe phone controller for WALL-E Mini",
    "start_url": "/drive",
    "display": "standalone",
    "orientation": "portrait",
    "theme_color": "#080a0f",
    "background_color": "#080a0f",
    "icons": [
        {"src": "/drive/icon.svg",     "sizes": "any",     "type": "image/svg+xml", "purpose": "any maskable"},
        {"src": "/drive/icon-180.png", "sizes": "180x180", "type": "image/png"},
        {"src": "/drive/icon-192.png", "sizes": "192x192", "type": "image/png"},
        {"src": "/drive/icon-512.png", "sizes": "512x512", "type": "image/png"},
    ],
}, separators=(",", ":"))

# Simple WALL-E robot glyph: binocular eyes, boxy head/body, twin track pods.
_ROBOT_SVG = (
    '<svg xmlns="http://www.w3.org/2000/svg" viewBox="0 0 512 512">'
    '<rect width="512" height="512" rx="96" fill="#080a0f"/>'
    # tracks
    '<rect x="86" y="318" width="80" height="140" rx="40" fill="#1a1d27" stroke="#2563eb" stroke-width="8"/>'
    '<rect x="346" y="318" width="80" height="140" rx="40" fill="#1a1d27" stroke="#2563eb" stroke-width="8"/>'
    # body
    '<rect x="120" y="230" width="272" height="200" rx="32" fill="#1a1d27" stroke="#2563eb" stroke-width="8"/>'
    # head
    '<rect x="150" y="100" width="212" height="158" rx="24" fill="#1a1d27" stroke="#2563eb" stroke-width="8"/>'
    # eyes (binocular rings)
    '<circle cx="210" cy="172" r="44" fill="#080a0f" stroke="#2563eb" stroke-width="8"/>'
    '<circle cx="210" cy="172" r="26" fill="#2563eb"/>'
    '<circle cx="302" cy="172" r="44" fill="#080a0f" stroke="#2563eb" stroke-width="8"/>'
    '<circle cx="302" cy="172" r="26" fill="#2563eb"/>'
    # antenna
    '<line x1="256" y1="100" x2="256" y2="56" stroke="#2563eb" stroke-width="10" stroke-linecap="round"/>'
    '<circle cx="256" cy="48" r="18" fill="#2563eb"/>'
    '</svg>'
)

_PNG_CACHE: dict = {}


def _get_robot_png(size: int) -> bytes:
    if size not in _PNG_CACHE:
        _PNG_CACHE[size] = _robot_png_bytes(size)
    return _PNG_CACHE[size]


def _robot_png_bytes(size: int) -> bytes:
    """Generate a WALL-E glyph PNG icon.  Uses numpy when available (fast);
    falls back to pure Python without any extra deps."""
    import struct
    import zlib

    bg   = (8,   10,  15)   # #080a0f
    body = (26,  29,  39)   # #1a1d27
    blue = (37,  99,  235)  # #2563eb

    try:
        import numpy as np
        img = np.empty((size, size, 3), dtype=np.uint8)
        img[:, :] = bg

        Y, X = np.mgrid[0:size, 0:size]
        NY = Y / size
        NX = X / size

        head  = (NX >= 0.29) & (NX <= 0.71) & (NY >= 0.14) & (NY <= 0.45)
        bod   = (NX >= 0.23) & (NX <= 0.77) & (NY >= 0.43) & (NY <= 0.83)
        lt    = (NX >= 0.10) & (NX <= 0.26) & (NY >= 0.55) & (NY <= 0.92)
        rt    = (NX >= 0.74) & (NX <= 0.90) & (NY >= 0.55) & (NY <= 0.92)
        struct_m = head | bod | lt | rt

        le  = (NX - 0.41) ** 2 + (NY - 0.30) ** 2 < 0.070 ** 2
        re  = (NX - 0.59) ** 2 + (NY - 0.30) ** 2 < 0.070 ** 2
        ant = (NX - 0.50) ** 2 + (NY - 0.08) ** 2 < 0.050 ** 2
        stm = (NX >= 0.485) & (NX <= 0.515) & (NY >= 0.08) & (NY <= 0.17)
        accent_m = le | re | ant | stm

        img[struct_m]  = body
        img[accent_m]  = blue
        pixels = img

    except ImportError:
        rows_list = []
        for y in range(size):
            ny = y / size
            row = []
            for x in range(size):
                nx = x / size
                if ((nx - 0.41) ** 2 + (ny - 0.30) ** 2 < 0.070 ** 2 or
                        (nx - 0.59) ** 2 + (ny - 0.30) ** 2 < 0.070 ** 2 or
                        (nx - 0.50) ** 2 + (ny - 0.08) ** 2 < 0.050 ** 2 or
                        (0.485 <= nx <= 0.515 and 0.08 <= ny <= 0.17)):
                    row.append(blue)
                elif ((0.29 <= nx <= 0.71 and 0.14 <= ny <= 0.45) or
                      (0.23 <= nx <= 0.77 and 0.43 <= ny <= 0.83) or
                      (0.10 <= nx <= 0.26 and 0.55 <= ny <= 0.92) or
                      (0.74 <= nx <= 0.90 and 0.55 <= ny <= 0.92)):
                    row.append(body)
                else:
                    row.append(bg)
            rows_list.append(row)
        pixels = rows_list

    def png_chunk(tag: bytes, data: bytes) -> bytes:
        hdr = tag + data
        return struct.pack(">I", len(data)) + hdr + struct.pack(">I", zlib.crc32(hdr) & 0xFFFFFFFF)

    raw = bytearray()
    if hasattr(pixels, "flatten"):          # numpy path
        for row_arr in pixels:
            raw.append(0)                   # filter = None
            raw.extend(row_arr.flatten().tolist())
    else:                                   # pure-Python path
        for row_list in pixels:
            raw.append(0)
            for (r, g, b) in row_list:
                raw.extend((r, g, b))

    ihdr = png_chunk(b"IHDR", struct.pack(">IIBBBBB", size, size, 8, 2, 0, 0, 0))
    idat = png_chunk(b"IDAT", zlib.compress(bytes(raw), 6))
    iend = png_chunk(b"IEND", b"")
    return b"\x89PNG\r\n\x1a\n" + ihdr + idat + iend


# ---------------------------------------------------------------------------
# Polished phone-first /drive UI  (tranche 2 — the "sexy" UI)
# ---------------------------------------------------------------------------
_DRIVE_HTML = r"""<!DOCTYPE html>
<html lang="en">
<head>
<meta charset="utf-8">
<meta name="viewport" content="width=device-width,initial-scale=1,maximum-scale=1,user-scalable=no,viewport-fit=cover">
<meta name="apple-mobile-web-app-capable" content="yes">
<meta name="apple-mobile-web-app-status-bar-style" content="black-translucent">
<meta name="apple-mobile-web-app-title" content="WALL-E Drive">
<meta name="theme-color" content="#080a0f">
<link rel="manifest" href="/drive/manifest.json">
<link rel="apple-touch-icon" href="/drive/icon.svg">
<title>WALL-E Drive</title>
<style>
/* ============================================================
   WALL-E Drive — FLIGHT DECK (Direction A) skin.
   Tokens flattened from the designer's .tv-deck scope: warm graphite
   panel plates, machined knurled knob, hazard-stripe E-STOP.
   Semantic roles: red=danger · green=armed/ok · blue=selected · amber=warn
   ============================================================ */
:root{
  --bg:#0b0c0f;--s1:#14161b;--s2:#1c1f25;--bd:#2c303a;
  --blue:#3b82f6;--blue-lo:rgba(59,130,246,.13);--blue-md:rgba(59,130,246,.35);--blue-bd:rgba(59,130,246,.55);
  --green:#10b981;--green-lo:rgba(16,185,129,.16);--green-md:rgba(16,185,129,.3);
  --red:#e5484d;--red-lo:rgba(229,72,77,.16);--red-md:rgba(229,72,77,.38);--red-bd:rgba(229,72,77,.55);
  --amber:#f5a623;
  --text:#eef0f3;--t2:#9aa3ae;--t3:#5d656f;
  --r-panel:8px;--r-pad:14px;--r-seg:9px;--r-arm:9px;--r-estop:12px;--r-chip:5px;
  color-scheme:dark;
}
*,*::before,*::after{
  box-sizing:border-box;
  -webkit-user-select:none;user-select:none;
  -webkit-tap-highlight-color:transparent;
}
html,body{margin:0;height:100%;overflow:hidden;}
body{
  background:var(--bg);color:var(--text);
  font:700 13px/1 -apple-system,"SF Pro Display",Roboto,system-ui,sans-serif;
  display:flex;flex-direction:column;
  padding-top:env(safe-area-inset-top);
  padding-bottom:env(safe-area-inset-bottom);
  padding-left:env(safe-area-inset-left);
  padding-right:env(safe-area-inset-right);
}
button{cursor:pointer;font-family:inherit;}
/* ---- overlay (disconnect / deadman / unauthorized) ---- */
#overlay{
  position:fixed;inset:0;z-index:100;
  background:rgba(4,6,10,.92);
  backdrop-filter:blur(14px);-webkit-backdrop-filter:blur(14px);
  display:flex;flex-direction:column;
  align-items:center;justify-content:center;gap:14px;padding:24px;text-align:center;
}
#overlay.hidden{display:none;}
.ov-icon{font-size:54px;line-height:1;animation:blink 1.4s ease-in-out infinite;}
.ov-title{font-size:24px;font-weight:900;color:var(--red);letter-spacing:.1em;}
.ov-sub{font-size:12px;font-weight:700;color:var(--t2);text-align:center;max-width:270px;line-height:1.55;letter-spacing:.03em;}
.ov-btn{
  margin-top:8px;padding:15px 48px;
  border:1.5px solid var(--bd);border-radius:12px;
  background:var(--s2);color:var(--text);
  font:800 13px/1 inherit;letter-spacing:.12em;
  transition:background .12s;
}
.ov-btn:active{background:var(--s1);}
/* ---- A2HS banner ---- */
#a2hs{
  background:var(--s1);border-bottom:1px solid var(--bd);
  padding:9px 14px;display:flex;align-items:center;
  gap:10px;font-size:11px;color:var(--t2);flex-shrink:0;
}
#a2hs.hidden{display:none;}
#a2hs-msg{flex:1;line-height:1.4;}
#a2hs-dismiss{
  border:1px solid var(--bd);border-radius:6px;
  background:var(--s2);color:var(--t2);
  font:inherit;padding:4px 9px;flex-shrink:0;
}
/* ---- HUD ---- */
.hud{
  background:linear-gradient(#171a20,#121419);
  box-shadow:inset 0 1px 0 rgba(255,255,255,.035),0 1px 0 rgba(0,0,0,.5);
  border-bottom:1px solid var(--bd);
  padding:10px 14px;flex-shrink:0;
}
.hud-r{display:flex;align-items:center;gap:7px;}
.hud-r+.hud-r{margin-top:9px;}
.sp{flex:1;}
.dot{
  width:9px;height:9px;border-radius:50%;background:var(--t3);flex-shrink:0;
  transition:background .3s,box-shadow .3s;
}
.dot.live{background:var(--green);box-shadow:0 0 0 3px var(--green-lo);animation:hbp 1.2s ease-in-out infinite;}
.dot.dead{background:var(--red);box-shadow:0 0 0 3px var(--red-lo);}
.lnk{font-size:10px;letter-spacing:.12em;color:var(--t2);transition:color .3s;}
.lnk.live{color:var(--green);}.lnk.dead{color:var(--red);}
/* CAM toggle lives in the HUD header (right side) */
.cam-btn{
  border:1px solid var(--bd);border-radius:var(--r-chip);
  background:var(--s2);color:var(--t3);
  font:800 9px/1 inherit;letter-spacing:.12em;
  padding:8px 11px;display:flex;align-items:center;gap:6px;flex-shrink:0;
  transition:color .15s,border-color .15s,background .15s;
}
.cam-btn .cd{width:6px;height:6px;border-radius:50%;background:var(--t3);transition:background .15s,box-shadow .15s;}
.cam-btn.on{border-color:var(--blue);color:var(--blue);background:var(--blue-lo);}
.cam-btn.on .cd{background:var(--blue);box-shadow:0 0 6px var(--blue);}
.cam-btn:disabled{opacity:.35;pointer-events:none;}
/* compact HUD chips — even fill, flex row */
.chip{
  flex:1;text-align:center;font-size:10px;letter-spacing:.05em;
  border:1px solid var(--bd);border-radius:var(--r-chip);
  padding:6px 4px;background:var(--s2);color:var(--t2);white-space:nowrap;
  transition:all .2s;
}
.chip.ok{background:var(--green-lo);border-color:var(--green);color:var(--green);}
.chip.warn{border-color:var(--amber);color:var(--amber);}
.chip.bad{background:var(--red-lo);border-color:var(--red);color:var(--red);animation:blink .9s infinite;}
/* ---- camera panel (below HUD when CAM on) ---- */
.cam-panel{
  flex-shrink:0;padding:0 12px;margin-top:9px;display:none;
}
.cam-panel.visible{display:block;}
.cam-img-wrap{
  position:relative;width:100%;
  background:#000;border-radius:var(--r-panel);overflow:hidden;
  border:1px solid var(--bd);
  aspect-ratio:4/3;
}
.cam-img-wrap img{
  width:100%;height:100%;object-fit:contain;display:block;
}
.cam-hint{
  position:absolute;right:8px;bottom:8px;
  font:700 9px/1 inherit;letter-spacing:.08em;color:var(--t2);
  background:rgba(0,0,0,.5);padding:4px 8px;border-radius:5px;
  pointer-events:none;
}
/* ---- drive zone (joystick bottom-anchored, gauges flanking) ---- */
.sticks{
  flex:1;min-height:0;display:flex;flex-direction:column;
  align-items:center;justify-content:flex-end;
  padding:8px 12px 2px;gap:7px;
}
.padrow{
  flex:1;min-height:120px;max-height:330px;width:100%;
  display:flex;align-items:stretch;justify-content:center;gap:13px;
}
.pad{
  height:100%;aspect-ratio:1/1;max-width:310px;
  position:relative;overflow:hidden;flex-shrink:1;
  background:var(--s1);border:1px solid var(--bd);border-radius:var(--r-pad);
  box-shadow:inset 0 2px 14px rgba(0,0,0,.55);
  touch-action:none;
  transition:border-color .15s;
}
.pad::before{
  content:'';position:absolute;top:9px;bottom:9px;left:50%;width:1px;
  background:var(--bd);pointer-events:none;transform:translateX(-50%);
}
.pad::after{
  content:'';position:absolute;left:9px;right:9px;top:50%;height:1px;
  background:var(--bd);pointer-events:none;
}
.pad-guide{
  position:absolute;left:50%;top:50%;width:62%;height:62%;
  transform:translate(-50%,-50%);border-radius:50%;
  border:1px solid var(--bd);opacity:.55;pointer-events:none;
}
.pad.fwd{border-color:var(--blue-bd);}
.pad.rev{border-color:var(--red-bd);}
.pknob{
  position:absolute;width:64px;height:64px;border-radius:50%;
  background:radial-gradient(circle at 36% 30%,#454c5b,#181b21 72%);
  border:2px solid #3a414f;
  box-shadow:0 5px 16px rgba(0,0,0,.7),inset 0 1px 0 rgba(255,255,255,.09);
  transform:translate(-50%,-50%);
  left:50%;top:50%;
  pointer-events:none;
  transition:left .22s cubic-bezier(.34,1.56,.64,1),top .22s cubic-bezier(.34,1.56,.64,1);
}
/* machined knurled inset ring */
.pknob::before{
  content:'';position:absolute;inset:6px;border-radius:50%;
  border:1.5px dashed rgba(255,255,255,.14);
}
.pknob::after{
  content:'';position:absolute;inset:-4px;
  border-radius:50%;border:2px solid transparent;transition:border-color .12s;
}
.pad.fwd .pknob::after{border-color:var(--blue-bd);}
.pad.rev .pknob::after{border-color:var(--red-bd);}
.pknob.drag{transition:none;}
.slbl{text-align:center;font-size:9px;font-weight:800;color:var(--t3);letter-spacing:.18em;flex-shrink:0;}
/* live L/R track gauges (presentational mirror of trackL/trackR) */
.gauge{display:flex;flex-direction:column;align-items:center;gap:6px;flex-shrink:0;}
.gbar{
  flex:1;width:15px;position:relative;overflow:hidden;
  background:var(--s1);border:1px solid var(--bd);border-radius:8px;
}
.gbar::after{
  content:'';position:absolute;left:2px;right:2px;top:50%;height:1px;
  background:var(--t3);opacity:.6;
}
.gfill{position:absolute;left:2.5px;right:2.5px;border-radius:4px;transition:height .1s linear;height:0;}
.gfill.pos{bottom:50%;top:auto;background:var(--green);box-shadow:0 0 8px var(--green-lo);}
.gfill.neg{top:50%;bottom:auto;background:var(--red);box-shadow:0 0 8px var(--red-lo);}
.glab{font-size:9px;font-weight:800;color:var(--t3);letter-spacing:.1em;}
/* ---- speed segmented ---- */
.spd-seg{
  display:flex;flex-shrink:0;margin:7px 12px 0;
  background:var(--s1);border:1px solid var(--bd);
  border-radius:var(--r-seg);padding:3px;gap:3px;
}
.seg{
  flex:1;padding:11px 2px;border:none;border-radius:calc(var(--r-seg) - 3px);
  background:transparent;color:var(--t3);
  font:800 10px/1 inherit;letter-spacing:.14em;
  transition:background .14s,color .14s,box-shadow .14s;
}
.seg.on{background:var(--blue);color:#fff;box-shadow:0 2px 12px var(--blue-md);}
/* ---- arm row ---- */
.arm-row{display:flex;align-items:center;gap:11px;padding:9px 12px 0;flex-shrink:0;flex-wrap:wrap;}
#dm-banner{
  flex:1 1 100%;
  font-size:12px;font-weight:700;color:var(--red);
  line-height:1.45;letter-spacing:.02em;
}
#dm-banner.hidden{display:none;}
.arm-outer{flex:1;position:relative;}
.arm-btn{
  width:100%;height:48px;border-radius:var(--r-arm);
  border:1.5px solid var(--bd);background:var(--s2);
  color:var(--t2);font:800 12px/1 inherit;letter-spacing:.09em;
  transition:background .15s,color .15s,border-color .15s,box-shadow .15s;
  touch-action:none;
}
.arm-btn.arming{border-color:var(--green);color:var(--green);background:rgba(16,185,129,.05);}
.arm-btn.armed{background:var(--green-lo);border-color:var(--green);color:var(--green);box-shadow:0 2px 16px var(--green-lo);}
.arm-btn:disabled{opacity:.38;pointer-events:none;}
/* radial progress ring */
.arm-ring{
  position:absolute;top:-8px;right:-8px;
  width:32px;height:32px;pointer-events:none;overflow:visible;
}
.r-bg{fill:none;stroke:var(--bd);stroke-width:2.5;}
.r-fg{
  fill:none;stroke:var(--green);stroke-width:2.5;
  stroke-linecap:round;
  stroke-dasharray:94.25;stroke-dashoffset:94.25;
}
.rc-lbl{
  display:flex;align-items:center;gap:7px;
  font-size:10px;font-weight:700;color:var(--t2);flex-shrink:0;letter-spacing:.04em;
  cursor:pointer;touch-action:manipulation;
}
.rc-lbl input{width:18px;height:18px;accent-color:var(--blue);cursor:pointer;}
/* ---- e-stop (bottom-most, largest, hazard-striped) ---- */
.estop-wrap{padding:10px 12px 12px;flex-shrink:0;}
.estop{
  width:100%;height:62px;border:none;border-radius:var(--r-estop);
  background:var(--red);color:#fff;
  font:900 18px/1 inherit;letter-spacing:.18em;
  box-shadow:0 4px 26px var(--red-md),0 2px 4px rgba(0,0,0,.4);
  transition:transform .08s,box-shadow .08s;
  position:relative;overflow:hidden;
  touch-action:none;
}
/* hazard strips on top & bottom edges */
.estop::before{
  content:'';position:absolute;left:0;right:0;top:0;height:7px;
  background:repeating-linear-gradient(-45deg,rgba(0,0,0,.32) 0 9px,transparent 9px 18px);
  pointer-events:none;
}
.estop::after{
  content:'';position:absolute;left:0;right:0;bottom:0;height:7px;
  background:repeating-linear-gradient(-45deg,rgba(0,0,0,.32) 0 9px,transparent 9px 18px);
  pointer-events:none;
}
.estop:active{transform:scaleY(.96);box-shadow:0 2px 12px var(--red-md);}
.estop.latched{
  background:#fff;color:var(--red);
  box-shadow:0 0 0 3px var(--red),0 4px 22px var(--red-md);
  animation:latch 1.1s ease-in-out infinite;
}
.estop.latched::before,.estop.latched::after,
.estop.dim1::before,.estop.dim1::after{display:none;}
.estop.dim1{
  background:var(--red-lo);color:#fff;
  border:2px solid var(--red);box-shadow:none;animation:none;
}
/* ---- keyframes ---- */
@keyframes blink{0%,100%{opacity:1;}50%{opacity:.55;}}
@keyframes hbp{
  0%,100%{opacity:1;box-shadow:0 0 0 3px var(--green-lo);}
  50%{opacity:.72;box-shadow:0 0 0 6px transparent;}
}
@keyframes latch{
  0%,100%{box-shadow:0 0 0 3px var(--red),0 4px 22px var(--red-md);}
  50%{box-shadow:0 0 0 7px var(--red),0 6px 32px var(--red-md);}
}
/* ---- landscape compact ---- */
@media(orientation:landscape)and(max-height:480px){
  .hud{padding:5px 14px;}
  .hud-r+.hud-r{display:none;}
  .cam-panel{margin-top:5px;padding:0 8px;}
  .spd-seg{margin:4px 12px 0;}
  .seg{padding:7px 2px;font-size:9px;}
  .estop-wrap{padding:5px 12px;}
  .estop{height:46px;font-size:15px;}
  .arm-row{padding:4px 12px 0;}
  .arm-btn{height:38px;}
  .sticks{padding:4px 12px 2px;gap:4px;}
  .padrow{min-height:90px;}
}
</style>
</head>
<body>

<!-- disconnected / deadman overlay — requires explicit dismiss before re-arm -->
<div id="overlay" class="hidden">
  <div class="ov-icon">&#9888;</div>
  <div class="ov-title" id="ov-title">DISCONNECTED</div>
  <div class="ov-sub"  id="ov-sub">Robot stopped &middot; reconnecting&hellip;</div>
  <button class="ov-btn" id="ov-btn">DISMISS</button>
</div>

<!-- iOS Add-to-Home-Screen hint (dismissible, not shown in standalone mode) -->
<div id="a2hs" class="hidden">
  <span id="a2hs-msg">Tap <b>&#8679; Share</b> &rarr; <b>Add to Home Screen</b> for full-screen mode</span>
  <button id="a2hs-dismiss">&#x2715;</button>
</div>

<!-- HUD — link status + CAM toggle in header, compact chip rows below -->
<div class="hud">
  <div class="hud-r">
    <div class="dot" id="dot"></div>
    <span class="lnk" id="lnklbl">CONNECTING</span>
    <div class="sp"></div>
    <button class="cam-btn" id="cam-btn"><span class="cd"></span><span>CAM OFF</span></button>
  </div>
  <div class="hud-r">
    <span class="chip" id="c-rtt">RTT &mdash;</span>
    <span class="chip" id="c-arm">DISARMED</span>
    <span class="chip" id="c-batt">BATT &mdash;</span>
  </div>
  <div class="hud-r">
    <span class="chip" id="c-cap">CAP &mdash;</span>
    <span class="chip" id="c-dm">DM &mdash;</span>
    <span class="chip" id="c-rc">RC &mdash;</span>
  </div>
</div>

<!-- Camera panel (below HUD; hidden until CAM on + camera_available) -->
<div class="cam-panel" id="cam-panel">
  <div class="cam-img-wrap" id="cam-wrap" style="display:none">
    <img id="cam-img" alt="camera feed">
    <span class="cam-hint" id="cam-hint"></span>
  </div>
</div>

<!-- Drive zone — joystick bottom-anchored, live L/R track gauges flanking -->
<div class="sticks">
  <div class="padrow">
    <div class="gauge">
      <div class="gbar"><div class="gfill pos" id="gfillL"></div></div>
      <span class="glab">L</span>
    </div>
    <div class="pad" id="padS">
      <div class="pad-guide"></div>
      <div class="pknob" id="knobS"></div>
    </div>
    <div class="gauge">
      <div class="gbar"><div class="gfill pos" id="gfillR"></div></div>
      <span class="glab">R</span>
    </div>
  </div>
  <div class="slbl">↑ FWD / REV ↓ &nbsp;&nbsp; ← STEER →</div>
</div>

<!-- Speed segmented control -->
<div class="spd-seg" id="spd-seg">
  <button class="seg on" data-l="slow">SLOW</button>
  <button class="seg"    data-l="normal">NORMAL</button>
  <button class="seg"    data-l="fast">FAST</button>
</div>

<!-- ARM row -->
<div class="arm-row">
  <div class="dm-banner hidden" id="dm-banner">Deadman tripped: the page was hidden or the connection paused. Press and hold ARM to resume.</div>
  <div class="arm-outer">
    <button class="arm-btn" id="arm-btn">HOLD TO ARM</button>
    <svg class="arm-ring" viewBox="0 0 32 32" aria-hidden="true">
      <circle class="r-bg" cx="16" cy="16" r="15"/>
      <circle class="r-fg" cx="16" cy="16" r="15" id="ring" transform="rotate(-90 16 16)"/>
    </svg>
  </div>
  <label class="rc-lbl">
    <input type="checkbox" id="rc-in-hand">
    <span>RC in hand</span>
  </label>
</div>

<!-- E-STOP — bottom-most, largest control, nearest the thumb -->
<div class="estop-wrap">
  <button class="estop" id="estop">E &mdash; STOP</button>
</div>

<script>
'use strict';

/* ---- config ---- */
const QS       = new URLSearchParams(location.search);
const ARM_MS   = 520;     // >= 500 ms server minimum
const RING_C   = 94.25;   // 2*pi*15 — ring circumference for 32x32 SVG, r=15

/* ---- auth token (Item F) ----
   Resolution: ?token= in the URL wins (and is persisted); else a previously
   persisted token from localStorage; else a one-time prompt. An empty token
   means the server has auth disabled (bench mode) — we send nothing. */
function resolveToken() {
  var t = QS.get('token');
  if (t !== null) { try { localStorage.setItem('walle-teleop-token', t); } catch(_) {} return t; }
  try { t = localStorage.getItem('walle-teleop-token'); } catch(_) { t = null; }
  if (t != null) return t;
  try {
    t = window.prompt('Teleop token (leave blank if auth is disabled):', '');
  } catch(_) { t = null; }
  if (t == null) t = '';
  try { localStorage.setItem('walle-teleop-token', t); } catch(_) {}
  return t;
}
const TOKEN = resolveToken();

/* ---- state ---- */
let ws = null, connected = false;
let rtt = null, lastSt = {}, seq = 1;
let leftV = 0, rightV = 0;   // mixed arcade values, sent as tank protocol
let stickX = 0, stickY = 0;  // raw joystick axes [-1,1]
let clientId = null;          // server-issued single-driver id (DEFECT-1)

/* ---- arcade mix ---- */
const STEER_GAIN = 0.8;
function clamp(v, lo, hi) { return v < lo ? lo : v > hi ? hi : v; }
function applyArcadeMix() {
  /* throttle = -y (stick up = +1), steer = x */
  var throttle = -stickY;
  var steer    = stickX;
  leftV  = clamp(throttle + STEER_GAIN * steer, -1, 1);
  rightV = clamp(throttle - STEER_GAIN * steer, -1, 1);
  paintGauges();
}

/* ---- live L/R track gauges — presentational mirror of the commanded
   trackL/trackR (leftV/rightV). They read zero unless the session is
   actually armed, not e-stopped, and the link is up — i.e. they reflect
   what is being SENT, not raw stick deflection. ---- */
var gfillL = null, gfillR = null;  // resolved after DOM parse (below script start)
function setGauge(el, v) {
  if (!el) return;
  var mag = Math.min(1, Math.abs(v));
  el.className = 'gfill ' + (v >= 0 ? 'pos' : 'neg');
  el.style.height = (mag * 50).toFixed(1) + '%';
}
function paintGauges() {
  var live = !!lastSt.armed && !lastSt.estop_latched && connected;
  setGauge(gfillL, live ? leftV  : 0);
  setGauge(gfillR, live ? rightV : 0);
}

/* ---- WebSocket ---- */
function wsUrl() {
  var p = location.protocol === 'https:' ? 'wss' : 'ws';
  var u = p + '://' + location.host + '/ws/drive';
  return TOKEN ? u + '?token=' + encodeURIComponent(TOKEN) : u;
}
function connect() {
  ws = new WebSocket(wsUrl());
  ws.onopen  = function() { connected = true;  renderConn(); hideOverlay(); };
  ws.onclose = function() {
    connected = false; clientId = null; renderConn();
    showOverlay('disconnected');
    setTimeout(connect, 800);
  };
  ws.onerror = function() { try { ws.close(); } catch(_) {} };
  ws.onmessage = function(ev) {
    var m; try { m = JSON.parse(ev.data); } catch(_) { return; }
    if (m.type === 'hello') { clientId = m.client_id; return; }
    if (m.type === 'error') { showOverlay('unauthorized'); return; }
    if (m.type !== 'status') return;
    var wasArmed = lastSt.armed;
    lastSt = m;
    if (!m.armed) armPending = false;
    if (m.echo_ts != null) rtt = Math.max(0, Math.round(performance.now() - m.echo_ts));
    if (!wasArmed && m.armed) startDriveLoop();
    renderAll();
    updateCamFromStatus(m);
  };
}
function send(o) {
  if (ws && ws.readyState === 1) { try { ws.send(JSON.stringify(o)); } catch(_) {} }
}

/* Neutral / no-input drive intent (same payload as a released stick). */
function sendNeutral() {
  stickX = stickY = 0; leftV = rightV = 0;
  send({type:'drive', seq: seq++, t: performance.now(), left: 0, right: 0});
  var knob = document.getElementById('knobS');
  var pad  = document.getElementById('padS');
  if (knob) { knob.classList.remove('drag'); knob.style.left = '50%'; knob.style.top = '50%'; }
  if (pad) pad.classList.remove('fwd', 'rev');
  paintGauges();
}

/* ---- drive loops — identical timing to tranche-1 minimal UI ---- */
/* heartbeat 10 Hz */
setInterval(function() { send({type:'hb', t: performance.now()}); }, 100);
/* drive 15 Hz, only when session is armed */
function driveTick() {
  if (lastSt.armed) send({type:'drive', seq: seq++, t: performance.now(), left: leftV, right: rightV});
}
var driveTimer = setInterval(driveTick, 66);
function stopDriveLoop() {
  if (driveTimer != null) { clearInterval(driveTimer); driveTimer = null; }
}
function startDriveLoop() {
  if (driveTimer == null) driveTimer = setInterval(driveTick, 66);
}

/* ---- client-side safety belt: zero sticks immediately on page hide ----
   Stop the drive loop so a later visible tab does not auto-resume driving.
   Re-arm (armed false→true) is what starts the loop again. The server
   cannot tell "tab hidden" from "connection paused"; both look like a
   stale heartbeat, so the UI uses one deadman message for both. */
document.addEventListener('visibilitychange', function() {
  if (document.hidden) {
    sendNeutral();
    stopDriveLoop();
  } else if (lastSt.armed) {
    /* Back before the 250 ms deadman tripped (rare): the session is still
       armed, so a stopped loop would leave the stick dead with the chip
       saying ARMED. Sticks were zeroed on hide, so nothing moves until the
       operator touches the stick again. */
    startDriveLoop();
  }
});
window.addEventListener('pagehide', function() {
  sendNeutral();
  stopDriveLoop();
});

/* ---- overlay ---- */
function showOverlay(reason) {
  var titles = {disconnected:'DISCONNECTED', deadman:'DEADMAN', unauthorized:'UNAUTHORIZED'};
  var subs   = {
    disconnected: 'Robot stopped · reconnecting…',
    deadman:      'Deadman tripped: the page was hidden or the connection paused. Press and hold ARM to resume.',
    unauthorized: 'Bad or missing token — clear it and reload to re-enter',
  };
  document.getElementById('ov-title').textContent = titles[reason] || 'STOPPED';
  document.getElementById('ov-sub').textContent   = subs[reason]   || 'Robot stopped';
  document.getElementById('overlay').classList.remove('hidden');
}
function hideOverlay() { document.getElementById('overlay').classList.add('hidden'); }
document.getElementById('ov-btn').addEventListener('click', hideOverlay);

/* ---- iOS A2HS banner ---- */
(function() {
  var ios = /iphone|ipad|ipod/i.test(navigator.userAgent);
  if (ios && !window.navigator.standalone && !localStorage.getItem('walle-a2hs-v1')) {
    document.getElementById('a2hs').classList.remove('hidden');
  }
  document.getElementById('a2hs-dismiss').addEventListener('click', function() {
    localStorage.setItem('walle-a2hs-v1', '1');
    document.getElementById('a2hs').classList.add('hidden');
  });
})();

/* ---- speed segmented control ---- */
document.getElementById('spd-seg').addEventListener('click', function(e) {
  var b = e.target.closest('.seg');
  if (!b) return;
  send({type:'speed', level: b.dataset.l});
  document.querySelectorAll('.seg').forEach(function(x) { x.classList.toggle('on', x === b); });
});

/* ---- E-STOP ---- */
var estopEl    = document.getElementById('estop');
var dimStep    = 0;
var dimTmr     = null;

estopEl.addEventListener('pointerdown', function() {
  if (lastSt.estop_latched) return;   /* latched state handled by click */
  stickX = stickY = 0; leftV = rightV = 0;
  send({type:'estop'});
  if (navigator.vibrate) navigator.vibrate(150);
});

estopEl.addEventListener('click', function() {
  if (!lastSt.estop_latched) return;
  /* DEFECT-4: when RC is present the server requires a physical RC ch3 re-arm
     cycle before the latch can clear. Tell the operator why instead of letting
     the two-tap silently no-op. */
  if (lastSt.estop_clear_gated) {
    estopEl.classList.add('dim1');
    estopEl.textContent = 'CYCLE RC CH3 TO CLEAR';
    if (navigator.vibrate) navigator.vibrate([60, 40, 60]);
    setTimeout(function() {
      estopEl.classList.remove('dim1'); renderEstop();
    }, 2500);
    return;
  }
  if (dimStep === 0) {
    dimStep = 1;
    estopEl.classList.add('dim1');
    estopEl.textContent = 'TAP AGAIN TO CLEAR';
    dimTmr = setTimeout(function() {
      dimStep = 0; estopEl.classList.remove('dim1'); renderEstop();
    }, 3000);
  } else {
    clearTimeout(dimTmr); dimStep = 0;
    estopEl.classList.remove('dim1');
    send({type:'clear_estop'});
  }
});

function renderEstop() {
  if (dimStep) return;
  estopEl.classList.toggle('latched', !!lastSt.estop_latched);
  if (lastSt.estop_latched) {
    estopEl.textContent = lastSt.estop_clear_gated ? 'E-STOP · CYCLE RC CH3'
                                                   : 'E-STOP LATCHED';
  } else {
    estopEl.textContent = 'E — STOP';
  }
}

/* ---- ARM button with 500 ms hold + radial progress ring ---- */
var armEl      = document.getElementById('arm-btn');
var ring       = document.getElementById('ring');
var isHolding  = false;
var armPending = false;
var justArmed  = false;
var holdTmr    = null;
var holdStart  = 0;
var holdRAF    = null;

function setRing(frac) {
  ring.style.strokeDashoffset = (RING_C * (1 - Math.max(0, Math.min(1, frac)))).toFixed(2);
}
function animRing() {
  setRing((performance.now() - holdStart) / ARM_MS);
  holdRAF = requestAnimationFrame(animRing);
}
function cancelHold() {
  isHolding = false;
  if (holdTmr) { clearTimeout(holdTmr); holdTmr = null; }
  if (holdRAF) { cancelAnimationFrame(holdRAF); holdRAF = null; }
  setRing(0);
  armEl.classList.remove('arming');
  renderArm();
}

armEl.addEventListener('pointerdown', function(e) {
  e.preventDefault();
  if (lastSt.armed || lastSt.estop_latched || isHolding) return;
  isHolding = true;
  holdStart = performance.now();
  armEl.classList.add('arming');
  armEl.textContent = 'HOLD…';
  setRing(0);
  holdRAF = requestAnimationFrame(animRing);
  holdTmr = setTimeout(function() {
    holdTmr  = null;
    isHolding = false;
    justArmed = true;
    armPending = true;
    send({type:'arm',
          hold_ms: Math.round(performance.now() - holdStart),
          rc_in_hand: document.getElementById('rc-in-hand').checked});
    if (navigator.vibrate) navigator.vibrate([25, 15, 25]);
    if (holdRAF) { cancelAnimationFrame(holdRAF); holdRAF = null; }
    setRing(1);
    armEl.classList.remove('arming');
    armEl.textContent = 'ARMING…';
  }, ARM_MS);
});

armEl.addEventListener('pointerup',     cancelHold);
armEl.addEventListener('pointerleave',  cancelHold);
armEl.addEventListener('pointercancel', cancelHold);

armEl.addEventListener('click', function() {
  if (justArmed) { justArmed = false; return; }  /* swallow click after successful hold */
  if (lastSt.armed) send({type:'disarm'});
});

function renderArm() {
  if (isHolding) return;
  armEl.classList.toggle('armed', !!lastSt.armed);
  armEl.classList.remove('arming');
  /* DEFECT-1: another client holds the single-driver lock. We are a spectator —
     arm/drive will be rejected server-side; reflect that and block the hold. */
  var lockedOut = (lastSt.has_driver && lastSt.is_driver === false);
  if (lastSt.armed) {
    armPending = false;
    armEl.textContent = lockedOut ? 'ANOTHER DRIVER ACTIVE' : 'ARMED · TAP TO DISARM';
    armEl.disabled = !!lockedOut;
  } else if (lockedOut) {
    armEl.textContent = 'ANOTHER DRIVER ACTIVE';
    armEl.disabled = true;
    setRing(0);
  } else if (armPending) {
    armEl.textContent = 'ARMING…';
    armEl.disabled = false;
  } else if (lastSt.estop_latched) {
    armEl.textContent = 'CLEAR E-STOP FIRST';
    armEl.disabled = true;
  } else {
    armEl.textContent = 'HOLD TO ARM';
    armEl.disabled = false;
    setRing(0);
  }
}

/* ---- single arcade-mix joystick (2-D) ---- */
function bindStick(padId, knobId) {
  var pad  = document.getElementById(padId);
  var knob = document.getElementById(knobId);
  var ptr  = null;

  function calcXY(e) {
    var r = pad.getBoundingClientRect();
    var x = Math.max(-1, Math.min(1,  2 * (e.clientX - r.left) / r.width  - 1));
    var y = Math.max(-1, Math.min(1,  2 * (e.clientY - r.top)  / r.height - 1));
    return [x, y];
  }
  function paint(x, y) {
    /* knob travels ±38% of pad size in each axis */
    knob.style.left = (50 + x * 38).toFixed(1) + '%';
    knob.style.top  = (50 + y * 38).toFixed(1) + '%';
    /* throttle = -y; forward when y < 0 */
    pad.classList.toggle('fwd', -y >  0.05);
    pad.classList.toggle('rev', -y < -0.05);
  }
  function spring() {
    knob.classList.remove('drag');
    /* CSS spring transition fires here — both axes return to centre */
    knob.style.left = '50%';
    knob.style.top  = '50%';
    pad.classList.remove('fwd', 'rev');
    paintGauges();
  }

  pad.addEventListener('pointerdown', function(e) {
    e.preventDefault();
    pad.setPointerCapture(e.pointerId);
    ptr = e.pointerId;
    knob.classList.add('drag');
    var xy = calcXY(e);
    stickX = xy[0]; stickY = xy[1];
    applyArcadeMix();
    paint(xy[0], xy[1]);
  });
  pad.addEventListener('pointermove', function(e) {
    if (ptr !== e.pointerId) return;
    var xy = calcXY(e);
    stickX = xy[0]; stickY = xy[1];
    applyArcadeMix();
    paint(xy[0], xy[1]);
  });
  function end(e) {
    if (ptr !== e.pointerId) return;
    ptr = null;
    stickX = stickY = 0; leftV = rightV = 0;
    spring();
  }
  pad.addEventListener('pointerup',     end);
  pad.addEventListener('pointercancel', end);
  pad.addEventListener('pointerleave',  end);
}

gfillL = document.getElementById('gfillL');
gfillR = document.getElementById('gfillR');
bindStick('padS', 'knobS');
paintGauges();

/* ---- HUD render ---- */
function renderConn() {
  var d = document.getElementById('dot');
  var l = document.getElementById('lnklbl');
  d.className = 'dot ' + (connected ? 'live' : 'dead');
  l.className = 'lnk ' + (connected ? 'live' : 'dead');
  l.textContent = connected ? 'LINK UP' : 'LINK DOWN';
  if (gfillL) paintGauges();
}

function renderAll() {
  var s = lastSt;

  /* RTT */
  var rttEl = document.getElementById('c-rtt');
  rttEl.textContent = rtt != null ? 'RTT ' + rtt + ' ms' : 'RTT —';
  rttEl.className   = 'chip' + (rtt != null && rtt > 120 ? ' warn' : '');

  /* arm badge */
  var ac = document.getElementById('c-arm');
  if (s.armed) {
    ac.textContent = 'ARMED'; ac.className = 'chip ok';
  } else if (s.tripped_reason) {
    ac.textContent = s.tripped_reason.replace(/_/g,' ').toUpperCase();
    ac.className = 'chip bad';
  } else {
    ac.textContent = 'DISARMED'; ac.className = 'chip';
  }

  /* deadman copy next to the press-and-hold ARM control (not a full-screen lock) */
  var dmBanner = document.getElementById('dm-banner');
  if (dmBanner) {
    dmBanner.classList.toggle('hidden', !(!s.armed && s.tripped_reason === 'deadman'));
  }

  /* battery */
  var bc = document.getElementById('c-batt');
  if (s.battery_v != null) {
    bc.textContent = s.battery_v.toFixed(1) + ' V';
    bc.className   = 'chip' + (s.battery_v < 21.0 ? ' warn' : '');
  } else {
    bc.textContent = 'BATT —'; bc.className = 'chip';
  }

  /* speed cap */
  document.getElementById('c-cap').textContent =
    s.speed_cap != null ? 'CAP ' + Math.round(s.speed_cap * 100) + '%' : 'CAP —';

  /* deadman age */
  var dc = document.getElementById('c-dm');
  if (s.armed && s.heartbeat_age_ms != null) {
    var pct = s.heartbeat_age_ms / (s.deadman_ms || 250);
    dc.textContent = 'HB ' + s.heartbeat_age_ms + ' ms';
    dc.className   = 'chip' + (pct > 0.7 ? ' warn' : '');
  } else {
    dc.textContent = 'DM —'; dc.className = 'chip';
  }

  /* RC state */
  var rc = document.getElementById('c-rc');
  if (s.rc_state) {
    var ra = s.rc_state[0], re = s.rc_state[1];
    rc.textContent = 'RC ' + (re ? 'ESTOP' : ra ? 'ARMED' : 'DISARMD');
    rc.className   = 'chip' + (re ? ' bad' : ra ? ' ok' : '');
  } else {
    rc.textContent = 'RC —'; rc.className = 'chip';
  }

  /* sync speed seg to server-reported level */
  if (s.speed_level) {
    document.querySelectorAll('.seg').forEach(function(b) {
      b.classList.toggle('on', b.dataset.l === s.speed_level);
    });
  }

  renderArm();
  renderEstop();
  paintGauges();
}

/* ---- camera feed ---- */
var camWs       = null;
var camOn       = false;
var camPrevUrl  = null;
var camFrameTs  = 0;
var camFpsTs    = 0;
var camFpsCount = 0;
var camFps      = null;
var camAvail    = false;  // populated from status.camera_available

var camPanel = document.getElementById('cam-panel');
var camBtn   = document.getElementById('cam-btn');
var camBtnLbl= camBtn.querySelector('span:last-child');  // text span (preserve .cd dot)
var camWrap  = document.getElementById('cam-wrap');
var camImg   = document.getElementById('cam-img');
var camHint  = document.getElementById('cam-hint');

function camWsUrl() {
  var p = location.protocol === 'https:' ? 'wss' : 'ws';
  var u = p + '://' + location.host + '/ws/camera';
  return TOKEN ? u + '?token=' + encodeURIComponent(TOKEN) : u;
}

function camStart() {
  if (camWs) return;
  camWs = new WebSocket(camWsUrl());
  camWs.binaryType = 'arraybuffer';
  camWs.onopen = function() {
    camWrap.style.display = '';
  };
  camWs.onmessage = function(ev) {
    if (!(ev.data instanceof ArrayBuffer)) return;
    /* revoke previous object URL to avoid memory leak */
    if (camPrevUrl) { try { URL.revokeObjectURL(camPrevUrl); } catch(_) {} }
    var blob = new Blob([ev.data], {type: 'image/jpeg'});
    var url  = URL.createObjectURL(blob);
    camImg.src = url;
    camPrevUrl = url;
    /* fps / staleness hint */
    var now = performance.now();
    camFrameTs = now;
    camFpsCount++;
    if (now - camFpsTs >= 2000) {
      camFps = camFpsCount / ((now - camFpsTs) / 1000);
      camFpsCount = 0;
      camFpsTs = now;
    }
    renderCamHint();
  };
  camWs.onerror = function() { try { camWs.close(); } catch(_) {} };
  camWs.onclose = function() {
    camWs = null;
    if (camOn) {
      /* auto-retry in 1 s while CAM is on */
      setTimeout(function() { if (camOn) camStart(); }, 1000);
    } else {
      camWrap.style.display = 'none';
    }
  };
}

function camStop() {
  if (camWs) { try { camWs.close(); } catch(_) {} camWs = null; }
  if (camPrevUrl) { try { URL.revokeObjectURL(camPrevUrl); } catch(_) {} camPrevUrl = null; }
  camImg.src = '';
  camWrap.style.display = 'none';
  camFps = null; camFpsCount = 0; camFpsTs = 0;
}

function renderCamHint() {
  if (!camOn || !camFrameTs) { camHint.textContent = ''; return; }
  var age = Math.round(performance.now() - camFrameTs);
  var fps = camFps != null ? camFps.toFixed(1) + ' fps' : '';
  var stale = age > 2000 ? ' · stale ' + (age / 1000).toFixed(1) + 's' : '';
  camHint.textContent = fps + stale;
}
setInterval(renderCamHint, 500);

function renderCamBtn() {
  /* CAM toggle lives in the HUD header now; the panel below holds only the
     feed, so show it only while actually streaming (CAM on + available). The
     toggle stays enabled whenever the camera is available from server status. */
  camPanel.classList.toggle('visible', camAvail && camOn);
  camBtn.disabled = !camAvail;
  camBtn.classList.toggle('on', camOn);
  camBtnLbl.textContent = camOn ? 'CAM ON' : 'CAM OFF';
}

camBtn.addEventListener('click', function() {
  if (!camAvail) return;
  camOn = !camOn;
  if (camOn) {
    camFpsTs = performance.now();
    camFpsCount = 0;
    camStart();
  } else {
    camStop();
  }
  renderCamBtn();
});

/* Update camAvail from the status stream */
function updateCamFromStatus(s) {
  var prev = camAvail;
  camAvail = !!s.camera_available;
  if (!camAvail && camOn) {
    /* server lost the camera — turn off */
    camOn = false;
    camStop();
  }
  if (prev !== camAvail) renderCamBtn();
}

/* ---- start ---- */
connect();
</script>
</body>
</html>"""
