gruMoses/wall_e-Mini/pi_app/hardware/oak_depth.py

"""
Threaded OAK-D Lite depth and spatial person-detection reader.

Runs a DepthAI pipeline on a background daemon thread. Exposes thread-safe
APIs consumed by the main control loop:
  - get_min_distance()      -> (distance_m, age_s)  for obstacle avoidance
  - get_person_detections() -> list[PersonDetection]  for Follow Me
  - get_detection_freshness() -> dict                  age of that stream
  - get_depth_stats()       -> DepthStats              for enriched telemetry
  - get_hand_data()         -> HandData | None          for gesture control
  - get_latest_rgb_frame()  -> (frame, ts)              640x480 BGR preview copy

When recording is enabled, exposes additional queues for the recorder:
  - get_recording_queues()  -> dict of XLinkOut queue names
"""

from __future__ import annotations

import logging
import marshal  # kept for _build_hand_tracker_script compatibility
import math
import numbers
import os
import re
import sys
import threading
import time
from dataclasses import dataclass, field, replace
from pathlib import Path
from typing import Optional

sys.path.append(str(Path(__file__).resolve().parents[2]))

from config import ObstacleAvoidanceConfig, FollowMeConfig, GestureConfig, OakRecordingConfig, OakDetectionConfig
from pi_app.control.follow_me import PersonDetection
from pi_app.control.gesture_control import HandData
from pi_app.control.person_stop_hold import PersonStopHold, PersonStopHoldSnapshot
from pi_app.hardware.oak_imu_yaw_producer import ImuPacket, ImuYawProducer
# OakImuReader's stale age, so health "imu_stale" means what the heading
# reader means (oak_imu imports oak_depth only for type checking).
from pi_app.hardware.oak_imu import _STALE_AGE_S as _IMU_STALE_AGE_S
from pi_app.hardware.vio_track import VioTracker

logger = logging.getLogger(__name__)

# depthai 3.6+ runs AutoCalibration at pipeline start by default, and it can
# change the calibration the corridor and person geometry are built on (see
# "Camera calibration" in CLAUDE.md). Keep it off until it has been evaluated
# on this unit; set DEPTHAI_AUTOCALIBRATION explicitly to override. pi_app
# imports depthai only inside functions, after this module has loaded, and
# run_main.sh exports the same default for the service. Older depthai ignores it.
os.environ.setdefault("DEPTHAI_AUTOCALIBRATION", "OFF")

# depthai 3.6.1 changed the IMU RAW reports: before, RAW was pre-rotated into
# the Luxonis RDF frame; from 3.6.1 RAW is the sensor's own frame and
# UNCALIBRATED carries the old RDF behaviour (v3.6.1 release notes). The yaw
# channel (gyro_y, +Y down) and the boot gravity check in oak_imu assume RDF,
# so the report is chosen by version to keep RDF on both sides of the upgrade.
# 3.3.0 has no ACCELEROMETER_UNCALIBRATED, so older versions keep RAW.
_IMU_UNCALIBRATED_IS_RDF_SINCE = (3, 6, 1)


def _depthai_version_tuple(version: str) -> Optional[tuple]:
    """Return (major, minor, patch) from a depthai version string, or None."""
    m = re.match(r"\s*(\d+)\.(\d+)\.(\d+)", str(version or ""))
    if m is None:
        return None
    return tuple(int(part) for part in m.groups())


def imu_report_names(depthai_version: str, imu_sensor_enum=None) -> tuple:
    """IMU report names (accelerometer, gyroscope) that arrive in the RDF frame.

    The version decides. When it cannot be parsed, the enum decides instead:
    ACCELEROMETER_UNCALIBRATED arrived with the 3.6.1 RAW change, so its
    presence means RAW is no longer RDF. Falling back to RAW there would put
    the yaw on the sensor's own axes without any error.
    """
    uncal = ("ACCELEROMETER_UNCALIBRATED", "GYROSCOPE_UNCALIBRATED")
    parsed = _depthai_version_tuple(depthai_version)
    if parsed is not None:
        return uncal if parsed >= _IMU_UNCALIBRATED_IS_RDF_SINCE else ("ACCELEROMETER_RAW", "GYROSCOPE_RAW")
    if imu_sensor_enum is not None and hasattr(imu_sensor_enum, uncal[0]):
        return uncal
    return ("ACCELEROMETER_RAW", "GYROSCOPE_RAW")


# BasaltVIO needs the RAW reports on depthai 3.6.1 (it diverges on
# UNCALIBRATED: its world comes out upside down). The IMU node has one
# accelerometer and one gyroscope slot, so with VIO on wall-e requests RAW too
# and turns it back into the UNCALIBRATED (RDF) values at the one conversion
# point (_poll_imu): on 3.6.1, UNCALIBRATED = RAW with y and z negated, a half
# turn about X. Measured on this unit 2026-11-05 at rest: accel UNCALIBRATED
# (-0.009, -0.988, -0.048) g, RAW (-0.009, +0.988, +0.047); gyro bias
# UNCALIBRATED (+0.218, -0.546, +0.146) deg/s, RAW (+0.210, +0.598, -0.161).
# Two independent vectors with X unchanged and the small Z component flipped
# rule out an axis swap.
VIO_MIN_DEPTHAI = (3, 6, 1)


def imu_session_reports(depthai_version: str, imu_sensor_enum=None, vio: bool = False) -> tuple:
    """(accelerometer report, gyroscope report, flip_yz) for one camera session.

    ``vio`` is True only when the caller has checked VIO_MIN_DEPTHAI. Then the
    reports are RAW and ``flip_yz`` tells _poll_imu to negate y and z, so the
    heading sees the same RDF values as with VIO off.
    """
    if vio:
        return ("ACCELEROMETER_RAW", "GYROSCOPE_RAW", True)
    accel, gyro = imu_report_names(depthai_version, imu_sensor_enum)
    return (accel, gyro, False)


def vio_decision(vio_enabled: bool, depthai_version: str, dai_node=None,
                 disabled_reason: Optional[str] = None) -> tuple:
    """(on, reason) for adding the log-only BasaltVIO node to a session."""
    if not vio_enabled:
        return (False, "off")
    if disabled_reason:
        return (False, f"disabled: {disabled_reason}")
    parsed = _depthai_version_tuple(depthai_version)
    if parsed is None or parsed < VIO_MIN_DEPTHAI:
        return (False, f"disabled: needs depthai >= 3.6.1 (have {depthai_version or '?'})")
    if dai_node is not None and not hasattr(dai_node, "BasaltVIO"):
        return (False, "disabled: depthai has no BasaltVIO node")
    return (True, "on")


def open_pipeline(dai, max_usb_speed: str = "HIGH"):
    """Return a dai.Pipeline on a device capped at ``max_usb_speed``.

    ``max_usb_speed`` is a depthai UsbSpeed name ("HIGH" = USB 2, "SUPER" =
    USB 3). An empty value keeps depthai's default (the cable decides). An
    unknown name is logged and also keeps the default, so a typo in the
    config cannot stop the camera. The device opens here, as dai.Pipeline()
    opens its implicit device, so a missing camera raises from the same call.
    """
    name = str(max_usb_speed or "").strip().upper()
    if not name:
        return dai.Pipeline()
    speed = getattr(getattr(dai, "UsbSpeed", None), name, None)
    if speed is None:
        logger.warning(
            "OAK max_usb_speed %r is not a depthai UsbSpeed; using the depthai default",
            max_usb_speed,
        )
        return dai.Pipeline()
    return dai.Pipeline(dai.Device(speed))


PERSON_LABEL = 15       # MobileNet-SSD VOC label index for "person"
YOLO_PERSON_LABEL = 0   # YOLOv8 COCO label index for "person"

_HAND_MODELS_DIR = Path(__file__).resolve().parent.parent / "models" / "hand"
_HAND_SCRIPT_TEMPLATE = _HAND_MODELS_DIR / "hand_tracker_script.py"

# DepthAI host IMU output queue (message slots, not wall-clock seconds).
# BMI270 is requested at 100 Hz with batch threshold 1 → ~1 packet/message.
# Default DepthAI maxSize=16 overflows during ordinary full-vision stalls
# (depth/YOLO/hand). 512 message slots give multi-second headroom at batch≈1,
# but this is NOT a hard 5.1 s guarantee: one queue message may hold multiple
# packets, and nonblocking overwrite loss is not observable via tryGet.
# Nonblocking so a stalled host never wedges the device.
IMU_HOST_QUEUE_MAX_SIZE = 512
IMU_HOST_QUEUE_BLOCKING = False
# Producer packet cap per drain (packets, not messages). Align with host
# message capacity at ~1 pkt/msg so a full host backlog is not silently
# halved. Keeps sort+fold memory O(cap). Raise only with measured multi-packet
# need — not a free pass to unbounded CPU.
IMU_MAX_PACKETS_PER_DRAIN = IMU_HOST_QUEUE_MAX_SIZE
# Drain-batch observability thresholds (NOT host-queue occupancy).
# A large drain means many messages were successfully retrieved in one poll;
# it does not measure remaining queue depth or overwritten samples.
IMU_DRAIN_BATCH_LARGE_FRAC = 0.75


@dataclass
class DepthStats:
    """Rich depth ROI statistics exposed for telemetry and recorder."""
    min_distance_m: float = float("inf")
    p5_mm: float = 0.0  # support-backed near estimate (see _corridor_near_distance_mm)
    p50_mm: float = 0.0
    valid_pixel_pct: float = 0.0
    corridor_valid_pct: float = 0.0
    corridor_support_px: int = 0
    corridor_near_px: int = 0  # valid corridor pixels claiming <= slow_distance_m
    timestamp: float = 0.0
    corridor_speckle_px: int = 0  # near pixels dropped by the speckle filter
    corridor_speckle_fallback: bool = False  # filter left too few pixels; unfiltered reading used


def _corridor_near_distance_mm(valid_depths, min_support_px: int) -> float | None:
    """Return the support-backed near depth (mm), or None if the corridor is rejected.

    Reported as ``p5_mm``, but this is not a plain 5th percentile: k =
    max(min_support_px, int(0.05 * n_valid)), clamped to n_valid, and the
    k-th smallest valid depth is taken with ``np.partition`` (no full sort).

    Why: on the 2026-09-19 18:50 follow-me run the corridor p5 flickered
    2.3 → 0.4 m while the followed person was 2.8–3.8 m ahead. Full-frame
    valid_pixel_pct was 2–7%; 5% of that handful was a few noisy near
    pixels. A real obstacle at 1 m and 0.3 m wide covers tens of thousands
    of corridor pixels; min_support_px=400 ≈ a 20x20 blob — anything
    smaller is noise.
    """
    import numpy as np
    n_valid = int(getattr(valid_depths, "size", 0) or 0)
    min_support_px = int(min_support_px)
    if n_valid <= 0 or n_valid < min_support_px:
        return None
    k = max(min_support_px, int(0.05 * n_valid))
    if k > n_valid:
        k = n_valid
    kth = k - 1
    partitioned = np.partition(valid_depths, kth)
    return float(partitioned[kth])


def _mask_person_boxes(band, person_boxes, y0: int, h: int, w: int,
                       margin_m: float):
    """Remove person pixels from the corridor band. Pure; returns a new array
    when it masks anything and never writes into ``band``.

    ``person_boxes`` holds ``(bbox, z_m)`` pairs: bbox normalised
    (xmin, ymin, xmax, ymax) on the full frame, z_m the person's range (0.0
    when unknown). ``y0`` is the band's first row in the full frame.

    ``margin_m > 0``: inside each box only pixels at or beyond
    ``z_m - margin_m`` are zeroed, so an obstacle between the robot and the
    person stays in the corridor. A person with ``z_m <= 0`` is not masked.
    ``margin_m <= 0``: the whole box is zeroed (behaviour before 2026-09-26).
    Zeroed pixels fail the ``> min_depth_mm`` validity test.
    """
    out = band
    copied = False
    band_h = band.shape[0]
    for bbox, z_m in person_boxes:
        bx1, by1, bx2, by2 = bbox
        px1 = max(0, int(bx1 * w))
        px2 = min(w, int(bx2 * w))
        py1 = max(0, int(by1 * h) - y0)
        py2 = min(band_h, int(by2 * h) - y0)
        if not (py1 < py2 and px1 < px2):
            continue
        if margin_m > 0.0 and z_m <= 0.0:
            continue
        if not copied:
            out = band.copy()
            copied = True
        region = out[py1:py2, px1:px2]
        if margin_m > 0.0:
            region[region >= max(0.0, (z_m - margin_m) * 1000.0)] = 0
        else:
            region[...] = 0
    return out


_SPECKLE_FILTER_UNAVAILABLE_LOGGED = False
_SPECKLE_BIN_MM = 100.0


def _drop_unsupported_near_pixels(depths, valid_mask, slow_mm: float,
                                  window_px: int, min_neighbours: int):
    """Drop near pixels that no nearby surface agrees with. Pure.

    Near = ``valid_mask`` and ``depths <= slow_mm``. A near pixel stays only
    when at least ``min_neighbours`` near pixels (itself included) in the
    ``window_px`` x ``window_px`` box around it lie within one 100 mm depth
    bin of its own. False stereo matches are sparse and have random depths,
    so they have few agreeing neighbours; a real surface, even a woven
    wire fence with holes, agrees with itself. Far pixels are never
    touched. Returns ``(kept_mask, dropped_px)``. ``min_neighbours <= 0``
    or no OpenCV returns the mask unchanged.

    Cost: one uint8 box filter per occupied depth bin over the bounding box
    of the near pixels (about 7 ms per frame on the Pi 5 for a band-wide
    speckle field).
    """
    global _SPECKLE_FILTER_UNAVAILABLE_LOGGED
    if min_neighbours <= 0 or window_px <= 0:
        return valid_mask, 0
    import numpy as np
    near = valid_mask & (depths <= slow_mm)
    ys, xs = np.nonzero(near)
    if ys.size == 0:
        return valid_mask, 0
    try:
        import cv2
    except ImportError:
        if not _SPECKLE_FILTER_UNAVAILABLE_LOGGED:
            _SPECKLE_FILTER_UNAVAILABLE_LOGGED = True
            logger.warning("Corridor speckle filter disabled: OpenCV not importable")
        return valid_mask, 0
    half = int(window_px) // 2
    h, w = depths.shape
    y0 = max(0, int(ys.min()) - half)
    y1 = min(h, int(ys.max()) + half + 1)
    x0 = max(0, int(xs.min()) - half)
    x1 = min(w, int(xs.max()) + half + 1)
    ly = ys - y0
    lx = xs - x0
    bins = (depths[ys, xs] // _SPECKLE_BIN_MM).astype(np.int32)
    present = np.unique(bins)
    ksize = (int(window_px), int(window_px))
    # A 13 x 13 window holds at most 169 pixels, so uint8 sums cannot
    # overflow for windows up to 15 x 15 (225).
    indicator = np.zeros((y1 - y0, x1 - x0), dtype=np.uint8)
    per_bin = {}
    for k in present:
        indicator[:] = 0
        sel = bins == k
        indicator[ly[sel], lx[sel]] = 1
        per_bin[int(k)] = cv2.boxFilter(indicator, -1, ksize, normalize=False,
                                        borderType=cv2.BORDER_CONSTANT)
    agree = np.zeros(ys.size, dtype=np.int32)
    for k in present:
        sel = np.nonzero(bins == k)[0]
        py = ly[sel]
        px = lx[sel]
        for kk in (int(k) - 1, int(k), int(k) + 1):
            counts = per_bin.get(kk)
            if counts is not None:
                agree[sel] += counts[py, px]
    bad = agree < int(min_neighbours)
    dropped = int(bad.sum())
    if dropped == 0:
        return valid_mask, 0
    kept = valid_mask.copy()
    kept[ys[bad], xs[bad]] = False
    return kept, dropped


def _corridor_min_support_px(min_px: int, min_frac: float, corridor_pixel_count: int) -> int:
    """Pixels of near support a corridor estimate needs: max(min_px, min_frac * corridor).

    Pure helper so the rule is unit-testable without a device.
    """
    frac_px = int(max(0.0, float(min_frac)) * max(0, int(corridor_pixel_count)))
    return max(int(min_px), frac_px)


# Person-range sampler (2026-09-20). OAK-D Lite is PASSIVE stereo; outdoors
# only 5-10 percent of depth pixels are valid. See FollowMeConfig comments
# next to depth_ema_alpha for the three field failures this replaces.
_PERSON_DEPTH_EDGE_EPS = 0.01
_VISION_RATE_WINDOW_S = 2.0
_HAND_DETECT_WINDOW_S = 1.0
_VISION_YIELD_S = 0.001


@dataclass(frozen=True)
class PersonDepthSample:
    """Stereo person-range sample. z_m is 0.0 whenever depth_status != "ok"."""
    x_m: float = 0.0
    z_m: float = 0.0
    depth_status: str = "no_frame"  # "ok" | "no_support" | "height_veto" | "far_veto" | "ambiguous" | "no_frame"
    depth_valid_px: int = 0
    depth_roi_px: int = 0
    z_stereo_m: float = 0.0
    z_height_m: float = 0.0
    z_spread_m: float = 0.0


def _record_event_ts(times: list, now: float, window_s: float = _VISION_RATE_WINDOW_S) -> None:
    """Append ``now`` and drop samples older than the moving-rate window."""
    times.append(now)
    cutoff = now - window_s
    n_drop = 0
    for t in times:
        if t < cutoff:
            n_drop += 1
        else:
            break
    if n_drop:
        del times[:n_drop]


def _window_rate(times, now: float, window_s: float = _VISION_RATE_WINDOW_S) -> float:
    """Events-per-second over the last ``window_s`` seconds (count / window)."""
    cutoff = now - window_s
    n = 0
    for t in times:
        ts = t[0] if isinstance(t, tuple) else t
        if ts >= cutoff:
            n += 1
    return n / window_s if window_s > 0.0 else 0.0


def _window_mean(samples, index: int, now: float, window_s: float = _VISION_RATE_WINDOW_S) -> float:
    """Mean of ``sample[index]`` over samples with ts in the last ``window_s``."""
    cutoff = now - window_s
    total = 0.0
    n = 0
    for sample in samples:
        if sample[0] >= cutoff:
            total += float(sample[index])
            n += 1
    return total / n if n else 0.0


def _record_windowed(samples: list, item: tuple, window_s: float) -> None:
    """Append a (ts, ...) sample and drop entries older than ``window_s``."""
    samples.append(item)
    cutoff = item[0] - window_s
    n_drop = 0
    for sample in samples:
        if sample[0] < cutoff:
            n_drop += 1
        else:
            break
    if n_drop:
        del samples[:n_drop]


def _color_stall_check(
    now: float,
    session_start_ts: float,
    fresh_ts: float | None,
    cfg,
) -> tuple[bool, float]:
    """Decide whether a colour-stream stall should end the OAK session.

    Returns ``(restart_now, stalled_for_s)``. ``stalled_for_s`` is the age
    of the last fresh NN packet, or the session age when none has arrived.

    Disabled when ``color_stall_restart_s <= 0``. Otherwise the reference
    time is ``max(fresh_ts or 0.0, session_start_ts + warmup)``: a session
    that has never produced a fresh packet restarts at
    ``session_start + warmup + restart_s``, and a later stall restarts
    ``restart_s`` after its last fresh packet, never inside the warm-up.

    The retry cap is not decided here. The reader keeps the restart times.
    """
    restart_s = 5.0
    warmup_s = 10.0
    if cfg is not None:
        restart_s = float(getattr(cfg, "color_stall_restart_s", 5.0))
        warmup_s = float(getattr(cfg, "color_stall_warmup_s", 10.0))
    return _stream_stall_check(now, session_start_ts, fresh_ts, restart_s, warmup_s)


def _stream_stall_check(
    now: float,
    session_start_ts: float,
    fresh_ts: float | None,
    restart_s: float,
    warmup_s: float,
) -> tuple[bool, float]:
    """Shared stall rule of the colour and IMU watchdogs.

    See ``_color_stall_check``: ``restart_s <= 0`` disables; the reference
    is ``max(fresh_ts or 0.0, session_start_ts + warmup_s)``.
    """
    if fresh_ts:
        stalled_for_s = now - fresh_ts
    else:
        stalled_for_s = now - session_start_ts
    if restart_s <= 0.0:
        return False, stalled_for_s
    reference = max(fresh_ts or 0.0, session_start_ts + warmup_s)
    return (now - reference) >= restart_s, stalled_for_s


def _imu_stall_check(
    now: float,
    session_start_ts: float,
    msg_ts: float | None,
    cfg,
) -> tuple[bool, float]:
    """Decide whether an IMU-stream stall should end the OAK session.

    Same rule as ``_color_stall_check``, with ``imu_stall_restart_s`` and
    ``imu_stall_warmup_s``. ``msg_ts`` is the last IMU message of THIS
    session. Depth freshness, the "never delivered" case and the budget are
    decided by the reader (``OakDepthReader._imu_stall_after_poll``).
    """
    restart_s = 10.0
    warmup_s = 10.0
    if cfg is not None:
        restart_s = float(getattr(cfg, "imu_stall_restart_s", 10.0))
        warmup_s = float(getattr(cfg, "imu_stall_warmup_s", 10.0))
    return _stream_stall_check(now, session_start_ts, msg_ts, restart_s, warmup_s)


def vision_loop_sleep_s(period: float, elapsed: float, deadline_flag: bool) -> float:
    """Seconds to sleep at the end of a vision-loop iteration.

    When ``deadline_flag`` is True, sleep only the remainder of the period so
    work + sleep ≈ period (2026-09-20 field runs: an unconditional 67 ms
    sleep after ~60 ms of work collapsed det_fps to ~8 Hz). When elapsed
    already meets or exceeds the period, yield ``_VISION_YIELD_S`` rather
    than busy-spinning. When ``deadline_flag`` is False, keep the old
    unconditional sleep of ``period``.
    """
    if not deadline_flag:
        return float(period)
    remaining = float(period) - float(elapsed)
    if remaining <= 0.0:
        return _VISION_YIELD_S
    return remaining


def _nn_msg_latency_s(msg) -> float | None:
    """Host age of an NN/detection message, or None if no usable timestamp.

    DepthAI NNData / ImgDetections expose getTimestamp() as a host-synced
    timedelta on this stack (see tools/perf/oak_timing_probe.py). Device
    timestamps (getTimestampDevice) are on the device clock and cannot be
    subtracted from time.monotonic(). If getTimestamp is missing, or the
    implied age is negative / implausibly large (wrong time base), latency
    is omitted.
    """
    getter = getattr(msg, "getTimestamp", None)
    if not callable(getter):
        return None
    try:
        ts = getter()
    except Exception:
        return None
    if ts is None:
        return None
    try:
        ts_s = float(ts.total_seconds()) if hasattr(ts, "total_seconds") else float(ts)
    except (TypeError, ValueError):
        return None
    age = time.monotonic() - ts_s
    if age < 0.0 or age > 5.0:
        return None
    return age


def _nn_msg_capture_ts(msg) -> float | None:
    """Host-synced capture time in seconds, or None if unusable.

    Same ``getTimestamp()`` conversion as ``_nn_msg_latency_s`` (timedelta
    ``total_seconds()``, otherwise ``float``). No 5 s plausibility cap: a
    frozen NN input frame must keep its old capture time so the age grows
    (2026-09-25, CAM_A stalled and the last person list was re-served for
    40 min). A value more than 0.5 s in the future is rejected — that is
    the wrong time base, not a real capture.
    """
    getter = getattr(msg, "getTimestamp", None)
    if not callable(getter):
        return None
    try:
        ts = getter()
    except Exception:
        return None
    if ts is None:
        return None
    try:
        ts_s = float(ts.total_seconds()) if hasattr(ts, "total_seconds") else float(ts)
    except (TypeError, ValueError):
        return None
    if not math.isfinite(ts_s):
        return None
    if time.monotonic() - ts_s < -0.5:
        return None
    return ts_s


def _nn_msg_sequence_num(msg) -> int | None:
    """``msg.getSequenceNum()`` as an int, or None if the message has none."""
    getter = getattr(msg, "getSequenceNum", None)
    if not callable(getter):
        return None
    try:
        seq = getter()
    except Exception:
        return None
    if seq is None:
        return None
    try:
        return int(seq)
    except (TypeError, ValueError):
        return None


def sample_person_depth(
    bbox,
    depth_frame,
    fx: float,
    cx_principal: float,
    *,
    person_depth_sample_min_m: float = 0.30,
    person_depth_sample_max_m: float = 9.0,
    person_depth_min_valid_px: int = 12,
    person_depth_min_valid_frac: float = 0.02,
    person_assumed_height_m: float = 1.75,
    person_depth_height_veto_ratio: float = 0.0,
    person_depth_fullheight_max_m: float = 3.5,
    person_depth_max_spread_m: float = 1.0,
    detect_camera_vfov_deg: float = 42.13,
) -> PersonDepthSample:
    """Torso-band stereo range for a person bbox. Pure; no device I/O.

    ROI is the torso band (inner 50 percent of width, 20-55 percent of
    height from the top). If the box touches the left frame edge the
    horizontal ROI shifts to the right half of the box (50-90 percent of
    width); if it touches the right edge, 10-50 percent — erosion only
    moves the sample window, it discards nothing. Valid pixels use
    (person_depth_sample_min_m, person_depth_sample_max_m), NOT
    FollowMeConfig.min_distance_m / max_distance_m, so a person at 0.4 m
    or 6.0-6.5 m is not discarded. z_height_m is a diagnostic (never a
    source of z). The too-close height veto is off unless
    person_depth_height_veto_ratio > 0.

    depth_status (z_m is 0.0 unless "ok"; downstream treats any other
    value as unknown):
      "ok"          stereo median with enough support
      "no_support"  too few valid stereo pixels in the ROI
      "height_veto" too-close vs bbox height (only if the ratio is > 0)
      "far_veto"    box clipped top AND bottom, z_stereo above
                    person_depth_fullheight_max_m — background past a
                    close person (impossible-far; safe direction)
      "ambiguous"   p75-p25 too large; ROI holds two surfaces
      "no_frame"    no depth frame, or the sampler raised
    """
    import numpy as np

    xmin, ymin, xmax, ymax = (
        float(bbox[0]), float(bbox[1]), float(bbox[2]), float(bbox[3]),
    )
    bbox_w = xmax - xmin
    bbox_h = ymax - ymin

    # Same VFOV convention as DetectionFilter Rule 3: implied_h =
    # bbox_h * z * 2 * tan(vfov/2), so z_height = assumed_h / (bbox_h * 2 * tan).
    top_bottom_clipped = (
        ymin <= _PERSON_DEPTH_EDGE_EPS or ymax >= (1.0 - _PERSON_DEPTH_EDGE_EPS)
    )
    if (not top_bottom_clipped) and bbox_h > 0.0 and detect_camera_vfov_deg > 0.0:
        z_height_m = float(person_assumed_height_m) / (
            bbox_h * 2.0 * math.tan(math.radians(float(detect_camera_vfov_deg)) / 2.0)
        )
    else:
        z_height_m = 0.0

    def _result(
        *,
        status: str,
        x_m: float = 0.0,
        z_m: float = 0.0,
        valid_px: int = 0,
        roi_px: int = 0,
        z_stereo_m: float = 0.0,
        z_spread_m: float = 0.0,
    ) -> PersonDepthSample:
        return PersonDepthSample(
            x_m=float(x_m),
            z_m=float(z_m),
            depth_status=status,
            depth_valid_px=int(valid_px),
            depth_roi_px=int(roi_px),
            z_stereo_m=float(z_stereo_m),
            z_height_m=float(z_height_m),
            z_spread_m=float(z_spread_m),
        )

    if depth_frame is None:
        return _result(status="no_frame")

    frame = np.asarray(depth_frame)
    if frame.ndim < 2 or frame.shape[0] <= 0 or frame.shape[1] <= 0:
        return _result(status="no_support")

    dh, dw = int(frame.shape[0]), int(frame.shape[1])

    left_edge = xmin <= _PERSON_DEPTH_EDGE_EPS
    right_edge = xmax >= (1.0 - _PERSON_DEPTH_EDGE_EPS)
    if left_edge and not right_edge:
        # Box against the left edge: sample the right half of the box.
        x0_n = xmin + 0.50 * bbox_w
        x1_n = xmin + 0.90 * bbox_w
    elif right_edge and not left_edge:
        # Box against the right edge: sample the left half of the box.
        x0_n = xmin + 0.10 * bbox_w
        x1_n = xmin + 0.50 * bbox_w
    else:
        x0_n = xmin + 0.25 * bbox_w
        x1_n = xmin + 0.75 * bbox_w
    y0_n = ymin + 0.20 * bbox_h
    y1_n = ymin + 0.55 * bbox_h

    x0d = max(0, min(dw, int(x0_n * dw)))
    x1d = max(0, min(dw, int(x1_n * dw)))
    y0d = max(0, min(dh, int(y0_n * dh)))
    y1d = max(0, min(dh, int(y1_n * dh)))
    if x1d <= x0d:
        x1d = min(dw, x0d + 1)
    if y1d <= y0d:
        y1d = min(dh, y0d + 1)

    roi = frame[y0d:y1d, x0d:x1d]
    roi_px = int(roi.size)
    min_mm = int(float(person_depth_sample_min_m) * 1000.0)
    max_mm = int(float(person_depth_sample_max_m) * 1000.0)
    if roi_px <= 0:
        return _result(status="no_support", roi_px=0)

    valid = roi[(roi > min_mm) & (roi < max_mm)]
    valid_px = int(valid.size)
    z_stereo_m = 0.0
    z_spread_m = 0.0
    if valid_px > 0:
        z_stereo_m = float(np.median(valid)) / 1000.0
        p25, p75 = np.percentile(valid, [25.0, 75.0])
        z_spread_m = (float(p75) - float(p25)) / 1000.0

    min_px = int(person_depth_min_valid_px)
    min_frac_px = float(person_depth_min_valid_frac) * float(roi_px)
    if valid_px < min_px or valid_px < min_frac_px:
        return _result(
            status="no_support",
            valid_px=valid_px,
            roi_px=roi_px,
            z_stereo_m=z_stereo_m,
            z_spread_m=z_spread_m,
        )

    ratio = float(person_depth_height_veto_ratio)
    if (
        ratio > 0.0
        and z_height_m > 0.0
        and z_stereo_m < ratio * z_height_m
    ):
        return _result(
            status="height_veto",
            valid_px=valid_px,
            roi_px=roi_px,
            z_stereo_m=z_stereo_m,
            z_spread_m=z_spread_m,
        )

    # H2b: both-edges clip + stereo farther than a full-height adult can be.
    fullheight_max_m = float(person_depth_fullheight_max_m)
    both_clipped = (
        ymin <= _PERSON_DEPTH_EDGE_EPS and ymax >= (1.0 - _PERSON_DEPTH_EDGE_EPS)
    )
    if (
        fullheight_max_m > 0.0
        and both_clipped
        and z_stereo_m > fullheight_max_m
    ):
        return _result(
            status="far_veto",
            valid_px=valid_px,
            roi_px=roi_px,
            z_stereo_m=z_stereo_m,
            z_spread_m=z_spread_m,
        )

    # H2c: two surfaces in the ROI; the median is not a measurement.
    spread_cap = max(
        float(person_depth_max_spread_m),
        0.35 * z_stereo_m,
    )
    if z_spread_m > spread_cap:
        return _result(
            status="ambiguous",
            valid_px=valid_px,
            roi_px=roi_px,
            z_stereo_m=z_stereo_m,
            z_spread_m=z_spread_m,
        )

    z_m = z_stereo_m
    x_m = 0.0
    if fx > 0.0 and z_m > 0.0:
        # ROI-independent bbox centre, same pinhole projection as before.
        cx_d = int(((xmin + xmax) / 2.0) * dw)
        x_m = ((float(cx_d) - float(cx_principal)) / float(fx)) * z_m
    return _result(
        status="ok",
        x_m=x_m,
        z_m=z_m,
        valid_px=valid_px,
        roi_px=roi_px,
        z_stereo_m=z_stereo_m,
        z_spread_m=z_spread_m,
    )


class _CorridorPersistence:
    """Report max(current, last persistence_polls-1 corridor estimates).

    A single-poll phantom cannot lower the distance. A genuine approaching
    obstacle is delayed by at most (persistence_polls - 1) polls (~66 ms at
    15 Hz). Applied ONLY to the corridor estimate, before the YOLO
    safety-tier override — a stop-tier detection must stay immediate.
    """

    def __init__(self, persistence_polls: int = 2) -> None:
        self._persistence_polls = max(1, int(persistence_polls))
        self._prev: list[float] = []

    def reset(self) -> None:
        self._prev.clear()

    def update(self, current_mm: float) -> float:
        reported = float(current_mm) if not self._prev else max(float(current_mm), *self._prev)
        keep = self._persistence_polls - 1
        if keep <= 0:
            self._prev = []
        else:
            self._prev.append(float(current_mm))
            extra = len(self._prev) - keep
            if extra > 0:
                del self._prev[:extra]
        return reported


@dataclass
class _DepthState:
    min_distance_m: float = float("inf")
    timestamp: float = 0.0
    stats: DepthStats = field(default_factory=DepthStats)
    raw_frame: object = None  # numpy uint16 array or None


@dataclass
class _DetectionState:
    persons: list[PersonDetection]
    timestamp: float = 0.0


@dataclass
class _RgbState:
    frame: object = None  # numpy BGR array or None
    timestamp: float = 0.0


@dataclass
class _HandState:
    hand_data: HandData | None = None
    timestamp: float = 0.0


@dataclass
class _ImuState:
    ax_mss: float = 0.0  # m/s²
    ay_mss: float = 0.0
    az_mss: float = 0.0
    gx_rads: float = 0.0  # rad/s
    gy_rads: float = 0.0
    gz_rads: float = 0.0
    timestamp: float = 0.0
    device_timestamp_s: float = 0.0
    # Producer-side unscaled cumulative free yaw (rad). Consumers apply scale once.
    cum_yaw_x_rad: float = 0.0
    cum_yaw_y_rad: float = 0.0
    cum_yaw_z_rad: float = 0.0
    cum_yaw_grav_rad: float = 0.0
    yaw_generation: int = 0
    producer_packets_integrated: int = 0
    producer_integrated_time_s: float = 0.0
    last_integrated_device_ts_s: float = 0.0
    # Stationary detector / zero-velocity update (see ImuYawProducer).
    # zupt_active means the producer deliberately froze cum for this sample, so
    # a consumer must report a yaw rate of 0 to stay consistent with the
    # frozen heading.
    stationary: bool = False
    zupt_active: bool = False
    # Producer's TRACKED gyro bias (dps) — diverges from the reader's boot
    # calibration copy once stationary tracking has adapted it. See
    # OakImuReader.read, which now sources body-rate bias from here.
    bias_gx_dps: float = 0.0
    bias_gy_dps: float = 0.0
    bias_gz_dps: float = 0.0
    # Producer packet cadence (avg seconds/packet) — used by OakImuReader to
    # bound how long the "duplicate read" branch may report a live rate.
    producer_cadence_avg_s: float = 0.0


@dataclass
class _ImuMetrics:
    """Lightweight IMU observability counters.

    Packet-loss proof uses integrated vs received, gap/backlog drops, and
    drain-batch size stats — never a manufactured coalesced=0, and never
    claims of DepthAI host-queue occupancy or overwrite count (those are
    not exposed by nonblocking tryGet).
    """
    # Successfully tryGet'd host queue messages (all are consumed/batched).
    queue_msgs_received: int = 0
    queue_msgs_consumed: int = 0
    # Always 0: drained messages are not dropped. Nonblocking DepthAI overwrite
    # loss is not observable through this API — do not invent a drop count.
    queue_msgs_dropped: int = 0
    queue_drain_count: int = 0
    packets_received: int = 0  # drained/parsed from host queue (batch total)
    packets_parsed: int = 0    # successfully converted to ImuPacket
    packets_consumed: int = 0  # alias of integrated delta (compat)
    # Selection-mode drops (legacy "latest"/"bounded"). Lossless path never
    # increments this — it stays 0 by structure, not by forcing assignment.
    packets_coalesced: int = 0
    packets_integrated: int = 0
    packets_duplicate: int = 0
    packets_regressed: int = 0
    packets_restart: int = 0
    packets_gap_freeze: int = 0
    packets_invalid_ts: int = 0
    packets_backlog_dropped: int = 0
    last_batch_packets: int = 0
    last_drain_msgs: int = 0
    host_queue_max_size: int = IMU_HOST_QUEUE_MAX_SIZE
    host_queue_blocking: bool = IMU_HOST_QUEUE_BLOCKING
    # Drain-batch observability: messages successfully drained per poll.
    # NOT host-queue occupancy, NOT overwrite count, NOT overflow proof.
    drain_batch_high_water_msgs: int = 0
    drain_batch_large_events: int = 0      # drain size >= large frac of maxSize
    drain_batch_full_size_events: int = 0  # drain size >= maxSize (interesting only)
    cadence_samples: int = 0
    cadence_last_s: float = 0.0
    cadence_min_s: float = 0.0
    cadence_max_s: float = 0.0
    cadence_avg_s: float = 0.0
    error_count: int = 0
    first_error_ts: float = 0.0
    last_error_ts: float = 0.0
    last_error_msg: str = ""
    warning_emits: int = 0


@dataclass
class ObjectDetection:
    """Single detection from YOLOv8 (or MobileNet) with spatial coordinates."""
    label: int
    label_name: str
    confidence: float
    x_m: float        # lateral offset in metres (positive = right of robot)
    z_m: float        # forward distance in metres
    bbox: tuple       # (xmin, ymin, xmax, ymax) normalised 0-1
    safety_tier: str  # "stop", "slow", or "log"
    depth_status: str = "ok"  # person-sampler status; default "ok" for device-spatial paths


@dataclass
class _AllDetsState:
    detections: list  # list[ObjectDetection]
    timestamp: float = 0.0


# ─────────────────────────────────────────────────────────────────────────────
# Host-side tracklet layer (IoU + constant-velocity Kalman)
#
# The OAK device's on-device ObjectTracker emits stable track_ids, but the
# host-side YOLOv8 NeuralNetwork parse path and the raw SpatialDetectionNetwork
# path do not. This pure-numpy layer assigns stable, monotonic track_ids to
# person detections on those paths so follow_me can lock onto one person across
# frames / brief occlusions instead of falling back to "closest by depth".
# Zero new dependencies — hand-rolled constant-velocity Kalman.
# ─────────────────────────────────────────────────────────────────────────────

# Monotonic, process-global track-id source. Never reused, even across tracker
# resets, so a re-acquired target always gets a fresh id (matches the "new id
# after target absent > max_age" contract).
_track_id_lock = threading.Lock()
_track_id_counter = 0


def _next_track_id() -> int:
    global _track_id_counter
    with _track_id_lock:
        _track_id_counter += 1
        return _track_id_counter


def _iou(a, b) -> float:
    """Intersection-over-union of two (xmin, ymin, xmax, ymax) boxes."""
    ax1, ay1, ax2, ay2 = a
    bx1, by1, bx2, by2 = b
    ix1 = max(ax1, bx1); iy1 = max(ay1, by1)
    ix2 = min(ax2, bx2); iy2 = min(ay2, by2)
    iw = max(0.0, ix2 - ix1); ih = max(0.0, iy2 - iy1)
    inter = iw * ih
    area_a = max(0.0, ax2 - ax1) * max(0.0, ay2 - ay1)
    area_b = max(0.0, bx2 - bx1) * max(0.0, by2 - by1)
    union = area_a + area_b - inter
    return inter / union if union > 0.0 else 0.0


class Tracklet:
    """One tracked person — constant-velocity Kalman over bbox state.

    State vector ``x = [cx, cy, w, h, vx, vy]`` (bbox centre, size, centre
    velocity). Measurements observe ``[cx, cy, w, h]``; ``vx, vy`` are inferred.
    """

    def __init__(self, track_id: int, bbox) -> None:
        import numpy as np
        cx, cy, w, h = self._bbox_to_z(bbox)
        self.track_id = track_id
        self.x = np.array([cx, cy, w, h, 0.0, 0.0], dtype=float)
        self.P = np.eye(6, dtype=float) * 10.0
        # Constant-velocity transition: centre advances by its velocity each step.
        self.F = np.eye(6, dtype=float)
        self.F[0, 4] = 1.0
        self.F[1, 5] = 1.0
        # Measurement matrix: observe [cx, cy, w, h].
        self.H = np.zeros((4, 6), dtype=float)
        self.H[0, 0] = self.H[1, 1] = self.H[2, 2] = self.H[3, 3] = 1.0
        self.Q = np.eye(6, dtype=float) * 1e-3   # process noise
        self.R = np.eye(4, dtype=float) * 1e-2   # measurement noise
        self.hits = 1
        self.age = 1
        self.time_since_update = 0
        # Last measured depth (m) of the detection this tracklet matched; None
        # until a caller supplies depths. Used by the association depth gate.
        self.last_depth: float | None = None

    @staticmethod
    def _bbox_to_z(bbox):
        x1, y1, x2, y2 = bbox
        return (x1 + x2) * 0.5, (y1 + y2) * 0.5, (x2 - x1), (y2 - y1)

    def predicted_bbox(self):
        """Bbox implied by the current (already-predicted) state."""
        cx, cy, w, h = self.x[0], self.x[1], self.x[2], self.x[3]
        w = max(0.0, w); h = max(0.0, h)
        return (cx - w * 0.5, cy - h * 0.5, cx + w * 0.5, cy + h * 0.5)

    def predict(self) -> None:
        self.x = self.F @ self.x
        self.P = self.F @ self.P @ self.F.T + self.Q
        self.age += 1
        self.time_since_update += 1

    def update(self, bbox) -> None:
        import numpy as np
        z = np.array(self._bbox_to_z(bbox), dtype=float)
        y = z - self.H @ self.x
        S = self.H @ self.P @ self.H.T + self.R
        K = self.P @ self.H.T @ np.linalg.inv(S)
        self.x = self.x + K @ y
        self.P = (np.eye(6) - K @ self.H) @ self.P
        self.hits += 1
        self.time_since_update = 0


class TrackletTracker:
    """Greedy-IoU + Kalman multi-object tracker for person bboxes.

    ``update(detections)`` takes a list of ``(xmin, ymin, xmax, ymax)`` bboxes
    (normalised 0-1) and returns a parallel list of ``Optional[int]`` track_ids:
    the confirmed id for a detection matched to (or that grew into) a confirmed
    tracklet, else ``None``. A tracklet is confirmed only after ``min_hits``
    hits, so transient / first-seen detections report ``None`` — keeping the
    None path identical to today's untracked behaviour.

    After the greedy IoU pass, unmatched CONFIRMED tracklets may still match
    unmatched detections by centre-distance. Narrow boxes at range plus
    detection gaps plus ego yaw drop IoU to 0 between consecutive boxes of
    the same person (2026-09-20 run). Disabled when ``center_gate_min`` and
    ``center_gate_width_mult`` are both 0 (the constructor default, so
    existing callers are unchanged). Ambiguous gates — two detections in one
    tracklet's gate, or one detection in two tracklets' gates — are not
    matched, so two people side by side cannot swap ids. Tentative
    tracklets never use the fallback.
    """

    def __init__(
        self,
        iou_threshold: float = 0.3,
        min_hits: int = 3,
        max_age: int = 15,
        depth_gate_m: float = 0.0,
        depth_gate_growth_m_per_frame: float = 0.0,
        center_gate_min: float = 0.0,
        center_gate_width_mult: float = 0.0,
    ) -> None:
        self._iou_threshold = float(iou_threshold)
        self._min_hits = int(min_hits)
        self._max_age = int(max_age)
        # Depth gate on association (2026-09-19). A detection may only match a
        # tracklet when |depth − tracklet.last_depth| <= gate + growth × missed
        # frames. Without it a closer occluder's bigger box can inherit the
        # operator's id purely on IoU, and the id then LIES to follow_me.
        # 0.0 (the constructor default) disables it: bbox-only behaviour, so
        # callers that pass no depths are unchanged.
        self._depth_gate_m = max(0.0, float(depth_gate_m))
        self._depth_gate_growth = max(0.0, float(depth_gate_growth_m_per_frame))
        # Centre-distance fallback (2026-09-20). 0.0 on both knobs disables
        # it, so existing callers and tests keep bbox-IoU-only association.
        self._center_gate_min = max(0.0, float(center_gate_min))
        self._center_gate_width_mult = max(0.0, float(center_gate_width_mult))
        self._tracklets: list[Tracklet] = []

    @property
    def tracklets(self) -> list:
        return self._tracklets

    def _depth_ok(self, t: "Tracklet", depth) -> bool:
        if self._depth_gate_m <= 0.0 or depth is None or t.last_depth is None:
            return True
        d = float(depth)
        if d <= 0.0:
            return True  # no depth measurement → cannot gate
        # time_since_update is already >= 1 here (predict() ran this frame);
        # each ADDITIONAL missed frame widens the gate.
        missed = max(0, int(t.time_since_update) - 1)
        tol = self._depth_gate_m + self._depth_gate_growth * missed
        return abs(d - t.last_depth) <= tol

    def _fallback_enabled(self) -> bool:
        return self._center_gate_min > 0.0 or self._center_gate_width_mult > 0.0

    def _centre_ok(self, t: "Tracklet", det_bbox, depth) -> bool:
        """Centre-distance fallback gate. Tentative tracklets never match here."""
        if t.hits < self._min_hits:
            return False
        pb = t.predicted_bbox()
        cx_p, cy_p, w_p, h_p = Tracklet._bbox_to_z(pb)
        cx_d, cy_d, w_d, h_d = Tracklet._bbox_to_z(det_bbox)
        center_gate = max(
            self._center_gate_min,
            self._center_gate_width_mult * max(w_p, w_d),
        )
        if abs(cx_d - cx_p) > center_gate:
            return False
        if abs(cy_d - cy_p) > 0.5 * max(h_p, h_d):
            return False
        if h_p > 0.0:
            ratio = h_d / h_p
            if ratio < 0.6 or ratio > 1.67:
                return False
        return self._depth_ok(t, depth)

    def update(self, detections, depths=None):
        """Advance the tracker one frame; return parallel list of Optional[int].

        ``depths`` (optional) is a list parallel to ``detections`` of forward
        distance in metres (``None`` / ``<= 0`` = unknown). When supplied and
        the depth gate is enabled, association additionally requires depth
        continuity (see ``_depth_ok``).
        """
        # 1. Predict every existing tracklet forward one frame.
        for t in self._tracklets:
            t.predict()

        n_det = len(detections)
        assigned = [None] * n_det  # track_id (or None) per detection
        if depths is None or len(depths) != n_det:
            depths = [None] * n_det

        # 2. Greedy IoU matching: predicted tracklet bbox vs new detections.
        unmatched_tracklets = set(range(len(self._tracklets)))
        unmatched_dets = set(range(n_det))
        if self._tracklets and n_det:
            pairs = []
            for ti, t in enumerate(self._tracklets):
                pb = t.predicted_bbox()
                for di in range(n_det):
                    iou = _iou(pb, detections[di])
                    if iou >= self._iou_threshold and self._depth_ok(t, depths[di]):
                        pairs.append((iou, ti, di))
            pairs.sort(reverse=True)  # highest IoU first
            for iou, ti, di in pairs:
                if ti in unmatched_tracklets and di in unmatched_dets:
                    self._tracklets[ti].update(detections[di])
                    unmatched_tracklets.discard(ti)
                    unmatched_dets.discard(di)
                    t = self._tracklets[ti]
                    if depths[di] is not None and float(depths[di]) > 0.0:
                        t.last_depth = float(depths[di])
                    if t.hits >= self._min_hits:
                        assigned[di] = t.track_id

        # 2b. Centre-distance fallback for still-unmatched CONFIRMED tracklets
        #     (2026-09-20). IoU is 0 when a narrow box jumps across the frame
        #     during a detection gap + ego yaw; without this pass a new id is
        #     minted and follow_me treats the operator as a different person.
        #     Ambiguous gates (one tracklet ↔ many dets, or one det ↔ many
        #     tracklets) are not matched — two people side by side must not
        #     swap ids.
        if (
            self._fallback_enabled()
            and unmatched_tracklets
            and unmatched_dets
        ):
            cand_pairs = []
            for ti in unmatched_tracklets:
                t = self._tracklets[ti]
                for di in unmatched_dets:
                    if self._centre_ok(t, detections[di], depths[di]):
                        cand_pairs.append((ti, di))
            t_count: dict = {}
            d_count: dict = {}
            for ti, di in cand_pairs:
                t_count[ti] = t_count.get(ti, 0) + 1
                d_count[di] = d_count.get(di, 0) + 1
            for ti, di in cand_pairs:
                if t_count[ti] != 1 or d_count[di] != 1:
                    continue
                if ti not in unmatched_tracklets or di not in unmatched_dets:
                    continue
                self._tracklets[ti].update(detections[di])
                unmatched_tracklets.discard(ti)
                unmatched_dets.discard(di)
                t = self._tracklets[ti]
                if depths[di] is not None and float(depths[di]) > 0.0:
                    t.last_depth = float(depths[di])
                if t.hits >= self._min_hits:
                    assigned[di] = t.track_id

        # 3. Unmatched detections become new tentative tracklets (report None
        #    until they reach min_hits).
        for di in unmatched_dets:
            t = Tracklet(_next_track_id(), detections[di])
            if depths[di] is not None and float(depths[di]) > 0.0:
                t.last_depth = float(depths[di])
            self._tracklets.append(t)
            if t.hits >= self._min_hits:  # only true if min_hits <= 1
                assigned[di] = t.track_id

        # 4. Age out tracklets unmatched for longer than max_age.
        self._tracklets = [
            t for t in self._tracklets if t.time_since_update <= self._max_age
        ]

        return assigned


class OakDepthReader:
    """Background OAK-D Lite reader following the ArduinoRCReader thread pattern."""

    def __init__(
        self,
        obstacle_config: ObstacleAvoidanceConfig,
        follow_me_config: FollowMeConfig,
        recording_config: OakRecordingConfig | None = None,
        gesture_config: GestureConfig | None = None,
        imu_poll_hz: float = 60.0,
        imu_packet_mode: str = "latest",
        imu_max_packets_per_poll: int = 4,
        detection_config: OakDetectionConfig | None = None,
    ) -> None:
        self._obs_cfg = obstacle_config
        self._fm_cfg = follow_me_config
        self._rec_cfg = recording_config
        self._gesture_cfg = gesture_config
        self._det_cfg = detection_config
        # Log-only VIO (OakDetectionConfig.vio_enabled). _imu_flip_yz is set
        # per session with the IMU report choice (imu_session_reports).
        self._vio_tracker = VioTracker()
        self._vio_active = False
        self._vio_reason = "off"
        self._vio_disabled_reason: Optional[str] = None
        self._vio_short_sessions = 0
        self._vio_errors = 0
        self._last_vio_error_msg = ""
        self._imu_flip_yz = False
        # Follow-me refuses a detection stream older than this. Default
        # matches OakDetectionConfig even when no detection config is passed
        # (unit tests, MobileNet-only callers).
        self._vision_stale_s = 1.5
        if detection_config is not None:
            self._vision_stale_s = float(getattr(detection_config, "vision_stale_s", 1.5))

        self._depth_state = _DepthState()
        self._corridor_persistence = _CorridorPersistence(
            int(getattr(obstacle_config, "corridor_persistence_polls", 2))
        )
        # Person/animal stop memory (pi_app/control/person_stop_hold.py).
        # The hold object, _person_hold_seen_det_ts and the warn-once flags
        # are written ONLY by the vision worker in _poll_depth. The snapshot
        # (vision writer) and the control-loop levels (one writer:
        # set_person_stop_hold_inputs) cross threads under self._lock.
        oc = obstacle_config
        self._person_hold_enabled = bool(getattr(oc, "person_stop_hold_enabled", False))
        self._person_hold = PersonStopHold(
            release_distance_m=float(getattr(oc, "person_stop_hold_release_m", 1.0)),
            release_polls=int(getattr(oc, "person_stop_hold_release_polls", 5)),
            min_valid_pct=float(getattr(oc, "person_stop_hold_min_valid_pct", 20.0)),
            edge_margin=float(getattr(oc, "person_stop_hold_edge_margin", 0.05)),
            in_manual=bool(getattr(oc, "person_stop_hold_in_manual", False)),
            carry_in_s=float(getattr(oc, "person_stop_hold_carry_in_s", 1.0)),
            chain_gap_s=float(getattr(oc, "person_stop_hold_chain_gap_s", 0.6)),
            chain_gate=float(getattr(oc, "person_stop_hold_chain_gate", 0.30)),
            resolve_polls=int(getattr(oc, "person_stop_hold_resolve_polls", 3)),
            stop_radius_m=float(getattr(oc, "safety_stop_radius_m", 0.8)),
            plausible_speed_mps=float(getattr(oc, "person_stop_hold_plausible_speed_mps", 1.5)),
            plausible_margin_m=float(getattr(oc, "person_stop_hold_plausible_margin_m", 0.25)),
            plausible_area_factor=float(getattr(oc, "person_stop_hold_plausible_area_factor", 1.5)),
        )
        self._person_hold_levels_max_age_s = float(
            getattr(oc, "person_stop_hold_levels_max_age_s", 1.0)
        )
        self._person_hold_snapshot = PersonStopHoldSnapshot()
        # Control-loop levels. Until the first write, and whenever they are
        # older than _person_hold_levels_max_age_s, the worker uses the strict
        # values: autonomous True, release False, forward neutral False.
        self._person_hold_release_req = False
        self._person_hold_autonomous = True
        self._person_hold_fwd_neutral = False
        self._person_hold_levels_ts: float | None = None
        self._person_hold_levels_warned = False  # vision worker only
        self._person_hold_error_logged = False   # vision worker only
        self._person_hold_seen_det_ts: float | None = None
        self._det_state = _DetectionState(persons=[])
        self._all_dets_state = _AllDetsState(detections=[])
        self._rgb_state = _RgbState()
        self._hand_state = _HandState()
        # Host-side MediaPipe Hands is the most expensive per-frame CPU consumer
        # in this loop. Gate it (see set_hand_poll_enabled) so it does not run
        # while no gesture can have any effect. Defaults True so standalone /
        # CLI users keep the previous behavior.
        self._hand_poll_enabled = True
        # Factory camera calibration for the socket the depth frame lives in.
        # Set at session start, cleared on teardown. _intrinsics_for()
        # caches the resolution-specific (fx, cx) derived from it.
        self._calib = None
        self._calib_socket = None
        self._intrinsics_cache: dict[tuple[int, int], tuple[float, float]] = {}
        self._intrinsics_warned = False
        self._lm_net = None  # lazy-loaded OpenCV DNN for host-side LM
        self._imu_state = _ImuState()
        self._imu_metrics = _ImuMetrics()
        # Lossless producer-side yaw: every drained packet is integrated here
        # independent of depth/YOLO/RGB/hand load and of consumer poll rate.
        # Packet cap aligns with host message capacity at ~1 pkt/msg.
        self._imu_yaw_producer = ImuYawProducer(
            max_packets_per_drain=int(IMU_MAX_PACKETS_PER_DRAIN),
        )
        # Host output queue depth (also stamped into metrics for field tools).
        self._imu_host_queue_max_size = int(IMU_HOST_QUEUE_MAX_SIZE)
        self._imu_host_queue_blocking = bool(IMU_HOST_QUEUE_BLOCKING)
        self._imu_max_packets_per_drain = int(IMU_MAX_PACKETS_PER_DRAIN)
        self._imu_metrics.host_queue_max_size = self._imu_host_queue_max_size
        self._imu_metrics.host_queue_blocking = self._imu_host_queue_blocking
        # Person label index depends on the active model
        _model_type = detection_config.model_type if detection_config is not None else "mobilenet-ssd"
        self._person_label: int = YOLO_PERSON_LABEL if _model_type == "yolov8n" else PERSON_LABEL
        # Host-side tracklet layer for parse paths the OAK device doesn't track
        # (YOLOv8 NeuralNetwork parse + raw SpatialDetectionNetwork). Knobs from
        # FollowMeConfig; getattr defaults keep old configs working.
        self._tracklet_tracker = TrackletTracker(
            iou_threshold=getattr(self._fm_cfg, "tracklet_iou_threshold", 0.3),
            min_hits=getattr(self._fm_cfg, "tracklet_min_hits", 3),
            max_age=getattr(self._fm_cfg, "tracklet_max_age", 15),
            depth_gate_m=getattr(self._fm_cfg, "tracklet_depth_gate_m", 0.0),
            depth_gate_growth_m_per_frame=getattr(
                self._fm_cfg, "tracklet_depth_gate_growth_m_per_frame", 0.0
            ),
            center_gate_min=getattr(self._fm_cfg, "tracklet_center_gate_min", 0.0),
            center_gate_width_mult=getattr(
                self._fm_cfg, "tracklet_center_gate_width_mult", 0.0
            ),
        )
        self._imu_prev_consumed_ts = 0.0
        self._imu_last_warn_ts = 0.0
        self._lock = threading.Lock()

        self._thread: threading.Thread | None = None
        self._stop_event = threading.Event()

        # Populated by _run_pipeline when recording is enabled; consumed by OakRecorder
        self._device = None
        self._recording_queues: dict | None = None
        self._device_ready = threading.Event()
        self._depth_stats_decimation = 3
        # OAK chip temperature (2026-09-19 logging audit), sampled once/sec
        # from the pipeline loop via pipeline.getDefaultDevice().
        # getChipTemperature() -- a live device call, so it must not run at
        # tick rate. average/css/mss are dai.ChipTemperature's own fields;
        # css/mss are best-effort (not on every depthai/device combination).
        self._chip_temp_c: float | None = None
        self._chip_temp_css_c: float | None = None
        self._chip_temp_mss_c: float | None = None
        self._last_chip_temp_poll_t: float = 0.0
        self._depth_stats_counter = 0
        self._rgb_poll_enabled = False
        self._rgb_always_poll = False  # set True for YOLO (passthrough monitoring)
        # Pose worker needs the same 640x480 preview the hand/web path uses.
        # Separate from _rgb_poll_enabled so the recorder toggling that flag
        # cannot starve Pose, and Pose cannot starve the recorder.
        self._pose_rgb_wanted = False
        self._imu_poll_interval_s = 1.0 / max(1.0, float(imu_poll_hz))
        mode = str(imu_packet_mode or "latest").strip().lower()
        self._imu_packet_mode = mode if mode in ("latest", "bounded") else "latest"
        self._imu_max_packets_per_poll = max(1, int(imu_max_packets_per_poll))
        self._pipeline_running = False
        self._pipeline_dead = False  # True when pipeline has crashed and not yet recovered
        # USB disconnect / auto-reconnect supervisor state.
        self._connected = False           # True while a device session is live
        self._reconnect_count = 0         # number of recoveries since start()
        self._last_disconnect_ts = 0.0    # monotonic ts of the most recent drop
        self._last_pipeline_loop_ts = 0.0
        self._last_depth_poll_ts = 0.0
        self._last_depth_recv_ts = 0.0
        self._depth_recv_count = 0
        self._depth_quality_reject_count = 0
        # 2 s moving rates for the vision thread (2026-09-20): the 14:58 run
        # suggested the loop runs at 6-10 Hz in follow-me, not the 15 Hz
        # everything assumes, and nothing logged it.
        self._det_event_ts: list[float] = []
        self._depth_event_ts: list[float] = []
        self._det_latency_s: float | None = None
        # Vision-loop diagnostics (2026-09-20 latency fix): 2 s window of
        # (ts, work_s, hand_poll_s) and a 1 s window of (ts, found) for
        # hand-detect rate. nn_input_queue_size is the value read back from
        # the device after setMaxSize (None until the pipeline starts).
        self._vision_iter_samples: list[tuple[float, float, float]] = []
        self._hand_detect_samples: list[tuple[float, bool]] = []
        self._nn_input_queue_size: int | None = None
        # H5: sampler exception log-once-per-episode (reset on the next success).
        self._person_sample_exc_logged = False
        self._last_detection_poll_ts = 0.0
        # Detection-stream freshness for the follow-me gate (2026-09-25).
        # None until the first packet whose sequence is missing or newer
        # than the last one seen. A repeated sequence does not move it:
        # the host can keep re-publishing one frozen NN frame.
        self._det_fresh_ts: float | None = None
        self._det_last_seq: int | None = None
        self._det_seq_stuck_packets: int = 0
        # Colour-stall watchdog (2026-09-25 CAM_A). Times are monotonic
        # stamps of watchdog restarts, pruned to color_stall_window_s.
        # The count is the total since this reader was created. The fault
        # latches when the window is full and stays until a fresh NN
        # packet arrives or the service restarts.
        self._color_stall_restart_times: list[float] = []
        self._color_stall_restart_count: int = 0
        self._color_stall_fault: bool = False
        # IMU stall watchdog (2026-11-06 19:34:37, the IMU stream stopped
        # with depth and detections live). Off until a heading consumer
        # (OakImuReader) asks for it: nobody needs a camera restart for an
        # IMU that no one reads. _imu_msg_ts is the last IMU message with
        # packets in any session (None = the IMU never delivered since this
        # reader started); _imu_session_msg_ts is the same for the current
        # session only. Restarts share the colour watchdog's budget (see
        # _watchdog_restarts_in_window_locked). The fault latches when the
        # budget is full and clears on the next IMU message after it.
        self._imu_watchdog_enabled: bool = False
        self._imu_msg_ts: float | None = None
        self._imu_session_msg_ts: float | None = None
        self._imu_stall_restart_times: list[float] = []
        self._imu_stall_restart_count: int = 0
        self._imu_stall_fault: bool = False
        self._imu_stall_fault_ts: float = 0.0
        self._imu_never_seen_logged: bool = False
        # Supervisor heartbeat (2026-10-08): stamped by _run_pipeline around
        # each session attempt and backoff, so get_health() can tell a
        # device-absent wait (supervisor ticking) from a worker thread that
        # is stuck inside depthai (nothing ticking, pipeline_running stale).
        self._last_supervisor_ts = 0.0
        self._last_rgb_poll_ts = 0.0
        self._last_pipeline_error_msg = ""
        self._last_depth_error_msg = ""
        self._last_detection_error_msg = ""
        self._last_rgb_error_msg = ""
        self._last_imu_error_msg = ""

    # -- Public API ----------------------------------------------------------

    @staticmethod
    def detect() -> bool:
        """Return True if an OAK-D Lite (Myriad X) is visible on USB."""
        try:
            import depthai as dai
            if hasattr(dai.Device, "getAllAvailableDevices"):
                return len(dai.Device.getAllAvailableDevices()) > 0
            # depthai v3: use DeviceDiscovery
            return len(dai.DeviceDiscovery.getAllAvailableDevices()) > 0
        except Exception:
            return False

    def start(self) -> None:
        with self._lock:
            if self._thread is not None:
                return
        self._stop_event.clear()
        thread = threading.Thread(
            target=self._run_pipeline, name="OakDepthReader", daemon=True
        )
        # Publish the handle only once the thread is alive, so get_health()
        # never samples a started-but-not-yet-running thread as "dead".
        thread.start()
        with self._lock:
            self._thread = thread

    def stop(self) -> None:
        self._stop_event.set()
        with self._lock:
            thread = self._thread
        if thread is not None:
            thread.join(timeout=3.0)
            with self._lock:
                self._thread = None

    def is_stopped(self) -> bool:
        """True after stop() has been requested. PoseWorker polls this."""
        return self._stop_event.is_set()

    def get_min_distance(self) -> tuple[float, float]:
        """Return (min_distance_m, age_s). Thread-safe."""
        with self._lock:
            age = time.monotonic() - self._depth_state.timestamp
            return self._depth_state.min_distance_m, age

    def get_person_stop_hold(self) -> dict:
        """Person/animal stop hold as of the last depth poll. Thread-safe."""
        with self._lock:
            return self._person_hold_snapshot.as_dict()

    def set_person_stop_hold_inputs(self, release: bool, autonomous: bool,
                                    forward_neutral: bool = False) -> None:
        """Control-loop inputs to the person-stop hold, written every tick.

        ``release``: the arm switch reads off with a live RC link.
        ``autonomous``: the mode is not MANUAL. ``forward_neutral``: MANUAL
        and no drive command for the neutral hold time (False when unknown).
        Levels, not queued events. The vision worker reads them at its next
        depth poll; if they are older than
        ``person_stop_hold_levels_max_age_s`` it uses the strict values.
        Thread-safe; the control loop is the only writer.
        """
        with self._lock:
            self._person_hold_release_req = bool(release)
            self._person_hold_autonomous = bool(autonomous)
            self._person_hold_fwd_neutral = bool(forward_neutral)
            self._person_hold_levels_ts = time.monotonic()

    def get_person_detections(self) -> list[PersonDetection]:
        """Return latest person detections. Thread-safe."""
        with self._lock:
            return list(self._det_state.persons)

    def get_person_detections_ts(self) -> float:
        """Monotonic time at which the current person list was published.

        0.0 until the first list is published. Thread-safe. The pose worker
        drops a list older than ``ArmsUpConfig.max_det_age_s`` relative to
        the preview frame.
        """
        with self._lock:
            return float(self._det_state.timestamp)

    def get_detection_freshness(self) -> dict:
        """Age of the detection stream the follow-me gate consumes.

        Keys: ``age_s`` (``inf`` before the first refreshing packet),
        ``stale`` (``age_s > vision_stale_s``), ``seq`` (last sequence that
        refreshed the clock; None if that packet had none), and
        ``seq_stuck_packets`` (packets since then whose sequence did not
        advance). Does not change ``get_person_detections()``. Thread-safe.
        """
        now = time.monotonic()
        with self._lock:
            fresh_ts = self._det_fresh_ts
            seq = self._det_last_seq
            stuck = self._det_seq_stuck_packets
            limit = self._vision_stale_s
        if fresh_ts is None:
            age = float("inf")
        else:
            age = now - fresh_ts
        return {
            "age_s": age,
            "stale": age > limit,
            "seq": seq,
            "seq_stuck_packets": stuck,
        }

    def get_depth_stats(self) -> DepthStats:
        """Return rich depth ROI statistics. Thread-safe."""
        with self._lock:
            return self._depth_state.stats

    def get_latest_depth_frame(self):
        """Return the most recent raw depth frame (uint16 mm) or None. Thread-safe."""
        with self._lock:
            return self._depth_state.raw_frame

    def get_latest_rgb_frame(self):
        """Return (frame, ts) of the most recent RGB preview. Thread-safe.

        The frame reference and timestamp are read under the lock. The
        copy runs after the lock is released: the vision thread assigns a
        new array on every poll, so the reference stays stable. ``ts`` is
        monotonic; ``frame`` is a BGR copy or None.
        """
        with self._lock:
            frame = self._rgb_state.frame
            ts = self._rgb_state.timestamp
        if frame is None:
            return None, ts
        copied = frame.copy() if hasattr(frame, "copy") else frame
        return copied, ts

    def get_hand_data(self) -> HandData | None:
        """Return latest hand landmark data or None. Thread-safe."""
        with self._lock:
            return self._hand_state.hand_data

    def get_all_detections(self) -> list:
        """Return all latest object detections (all classes) as list[ObjectDetection].

        Each entry includes a safety_tier field ("stop", "slow", "log") based on
        OakDetectionConfig.stop_class_ids / slow_class_ids.  Useful for detection-based
        obstacle awareness beyond the depth-ROI approach.  Thread-safe.
        """
        with self._lock:
            return list(self._all_dets_state.detections)

    def set_rgb_poll_enabled(self, enabled: bool) -> None:
        """Enable/disable host RGB preview polling to reduce host copy load."""
        with self._lock:
            self._rgb_poll_enabled = bool(enabled)

    def set_pose_rgb_wanted(self, wanted: bool) -> None:
        """Keep the 640x480 preview queue polled while the pose worker is on.

        Does not request a new camera output. ORs into the existing
        ``_rgb_poll_enabled`` / ``_rgb_always_poll`` / hand-poll path.
        """
        with self._lock:
            self._pose_rgb_wanted = bool(wanted)

    def set_hand_poll_enabled(self, enabled: bool) -> None:
        """Enable/disable host-side MediaPipe Hands inference.

        MediaPipe runs on the Pi CPU every poll iteration and competes with the
        ~30 Hz control loop. No gesture can produce an effect while the robot is
        disarmed: ACTIVATE requires ``safety_state.is_armed`` and DEACTIVATE only
        applies in FOLLOW_ME, which itself requires armed (see
        ``Controller.compute``). Disarmed is most of WALL-E's uptime, so gating
        on arm state is free CPU with no behavior change.

        Disabling clears the cached hand data, so a stale half-finished gesture
        sequence cannot survive across an arm cycle. ``GestureStateMachine.update``
        treats ``None`` as "no hand" and resets its hold counter.

        NOTE: while gestures are configured, the hand queue IS the RGB preview
        queue. The poll loop therefore keeps polling it for RGB when hand
        inference is off, so camera liveness and the web stream do not age out.
        """
        with self._lock:
            changed = bool(enabled) != self._hand_poll_enabled
            self._hand_poll_enabled = bool(enabled)
            if changed and not enabled:
                self._hand_state.hand_data = None
                self._hand_state.timestamp = time.monotonic()

    def get_imu_data(self) -> tuple[_ImuState, float]:
        """Return (imu_state_copy, age_s). Thread-safe.

        Includes producer cumulative free-yaw channels (unscaled rad). Consumers
        must apply ``oak_yaw_rate_scale`` once and must not re-integrate gyro×dt
        from the sparse latest snapshot for heading.

        ``gx_rads`` / ``gy_rads`` / ``gz_rads`` are the latest **raw** body rates
        (not bias-subtracted, not NMNI-gated). Bias and NMNI apply only inside
        the producer integrator that advances cum free-yaw. Gyro calibration
        must sample these raw rates (see ``get_imu_raw_gyro_dps``).
        """
        with self._lock:
            age = time.monotonic() - self._imu_state.timestamp if self._imu_state.timestamp else float("inf")
            return _ImuState(
                ax_mss=self._imu_state.ax_mss,
                ay_mss=self._imu_state.ay_mss,
                az_mss=self._imu_state.az_mss,
                gx_rads=self._imu_state.gx_rads,
                gy_rads=self._imu_state.gy_rads,
                gz_rads=self._imu_state.gz_rads,
                timestamp=self._imu_state.timestamp,
                device_timestamp_s=self._imu_state.device_timestamp_s,
                cum_yaw_x_rad=self._imu_state.cum_yaw_x_rad,
                cum_yaw_y_rad=self._imu_state.cum_yaw_y_rad,
                cum_yaw_z_rad=self._imu_state.cum_yaw_z_rad,
                cum_yaw_grav_rad=self._imu_state.cum_yaw_grav_rad,
                yaw_generation=self._imu_state.yaw_generation,
                producer_packets_integrated=self._imu_state.producer_packets_integrated,
                producer_integrated_time_s=self._imu_state.producer_integrated_time_s,
                last_integrated_device_ts_s=self._imu_state.last_integrated_device_ts_s,
                stationary=self._imu_state.stationary,
                zupt_active=self._imu_state.zupt_active,
                bias_gx_dps=self._imu_state.bias_gx_dps,
                bias_gy_dps=self._imu_state.bias_gy_dps,
                bias_gz_dps=self._imu_state.bias_gz_dps,
                producer_cadence_avg_s=self._imu_state.producer_cadence_avg_s,
            ), age

    def get_imu_raw_gyro_dps(self) -> tuple[tuple[float, float, float], float]:
        """Return ((gx, gy, gz) dps, age_s) of latest **raw** body gyro.

        Explicit calibration contract: never bias-subtracted or NMNI-gated.
        Same underlying sample as ``get_imu_data().g*_rads``; separate method
        so callers cannot confuse integrate-path rates with raw rates if the
        snapshot shape gains corrected fields later.
        """
        with self._lock:
            age = (
                time.monotonic() - self._imu_state.timestamp
                if self._imu_state.timestamp
                else float("inf")
            )
            return (
                (
                    math.degrees(self._imu_state.gx_rads),
                    math.degrees(self._imu_state.gy_rads),
                    math.degrees(self._imu_state.gz_rads),
                ),
                age,
            )

    def set_imu_gyro_bias_dps(self, gx_dps: float, gy_dps: float, gz_dps: float) -> None:
        """Push gyro bias into the producer integrator (applied before cum yaw)."""
        with self._lock:
            self._imu_yaw_producer.set_gyro_bias_dps(gx_dps, gy_dps, gz_dps)

    def set_imu_nmni(self, enabled: bool, threshold_dps: float = 0.3) -> None:
        """Configure per-packet NMNI on the producer integrator."""
        with self._lock:
            self._imu_yaw_producer.set_nmni(enabled, threshold_dps)

    def set_imu_watchdog_enabled(self, enabled: bool) -> None:
        """Turn the IMU stall watchdog on or off.

        ``OakImuReader`` turns it on when it is built on this reader: the
        OAK IMU is then the heading source, so a dead IMU stream is worth a
        session rebuild. Without a heading consumer the watchdog stays off.
        """
        with self._lock:
            self._imu_watchdog_enabled = bool(enabled)

    def set_motion_witness(self, still: bool) -> None:
        """Forward a wheels-stopped witness to the IMU yaw producer.

        Pushed once per control-loop tick from ``pi_app.app.main`` via
        ``pi_app.control.rpm_plausibility.wheels_stopped()``. See
        ``ImuYawProducer.set_motion_witness`` / docs/heading_tuning.md.
        """
        with self._lock:
            self._imu_yaw_producer.set_motion_witness(bool(still), time.monotonic())

    def configure_stationary_tracking(
        self,
        *,
        enabled: Optional[bool] = None,
        zupt_enabled: Optional[bool] = None,
        window_s: Optional[float] = None,
        gyro_std_dps: Optional[float] = None,
        accel_std_g: Optional[float] = None,
        max_rate_dps: Optional[float] = None,
        bias_tau_s: Optional[float] = None,
    ) -> None:
        """Configure stationary gyro-bias tracking / ZUPT on the producer.

        ``None`` leaves a knob unchanged. Both features default OFF on the
        producer; ``OakImuReader`` pushes the production values from config the
        same way it pushes bias and NMNI, so there is exactly one owner.
        """
        with self._lock:
            self._imu_yaw_producer.configure_stationary_tracking(
                enabled=enabled,
                zupt_enabled=zupt_enabled,
                window_s=window_s,
                gyro_std_dps=gyro_std_dps,
                accel_std_g=accel_std_g,
                max_rate_dps=max_rate_dps,
                bias_tau_s=bias_tau_s,
            )

    def get_imu_metrics(self) -> dict:
        """Return a thread-safe snapshot of IMU observability counters."""
        now = time.monotonic()
        with self._lock:
            m = self._imu_metrics
            last_ts = self._imu_state.timestamp
            snap = self._imu_yaw_producer.snapshot()
            # Truthful accounting: not all received packets integrate (restart
            # seeds, duplicates, gap freezes). Selection coalescing is separate.
            packets_not_integrated = max(
                0,
                int(m.packets_parsed)
                - int(m.packets_integrated)
                - int(m.packets_duplicate)
                - int(m.packets_gap_freeze)
                - int(m.packets_regressed)
                - int(m.packets_restart)
                - int(m.packets_invalid_ts)
                - int(m.packets_backlog_dropped),
            )
            return {
                "queue_msgs_received": m.queue_msgs_received,
                "queue_msgs_consumed": m.queue_msgs_consumed,
                # Always 0 — drained messages are consumed/batched, not dropped.
                # DepthAI nonblocking overwrite loss is not observable here.
                "queue_msgs_dropped": m.queue_msgs_dropped,
                "queue_msgs_overwrite_observable": False,
                "queue_drain_count": m.queue_drain_count,
                "packets_received": m.packets_received,
                "packets_parsed": m.packets_parsed,
                "packets_drained": m.packets_received,
                "packets_consumed": m.packets_consumed,
                "packets_coalesced": m.packets_coalesced,
                "packets_integrated": m.packets_integrated,
                "packets_not_integrated_residual": packets_not_integrated,
                "packets_duplicate": m.packets_duplicate,
                "packets_regressed": m.packets_regressed,
                "packets_restart": m.packets_restart,
                "packets_gap_freeze": m.packets_gap_freeze,
                "packets_invalid_ts": m.packets_invalid_ts,
                "packets_backlog_dropped": m.packets_backlog_dropped,
                "last_batch_packets": m.last_batch_packets,
                "last_drain_msgs": m.last_drain_msgs,
                "host_queue_max_size": m.host_queue_max_size,
                "host_queue_blocking": m.host_queue_blocking,
                "max_packets_per_drain": int(self._imu_max_packets_per_drain),
                # Drain-batch observability (messages drained per poll).
                # Never infer host-queue occupancy or overwrite overflow from these.
                "drain_batch_high_water_msgs": m.drain_batch_high_water_msgs,
                "drain_batch_large_events": m.drain_batch_large_events,
                "drain_batch_full_size_events": m.drain_batch_full_size_events,
                "cadence_samples": m.cadence_samples,
                "cadence_last_s": m.cadence_last_s,
                "cadence_min_s": m.cadence_min_s,
                "cadence_max_s": m.cadence_max_s,
                "cadence_avg_s": m.cadence_avg_s,
                "error_count": m.error_count,
                "first_error_ts": m.first_error_ts,
                "last_error_ts": m.last_error_ts,
                "last_error_msg": m.last_error_msg,
                "warning_emits": m.warning_emits,
                "last_sample_timestamp": last_ts,
                "last_sample_age_s": (now - last_ts) if last_ts else float("inf"),
                # Producer yaw channels (unscaled rad / deg helpers).
                "producer_cum_yaw_x_deg": math.degrees(snap.cum_yaw_x_rad),
                "producer_cum_yaw_y_deg": math.degrees(snap.cum_yaw_y_rad),
                "producer_cum_yaw_z_deg": math.degrees(snap.cum_yaw_z_rad),
                "producer_cum_yaw_grav_deg": math.degrees(snap.cum_yaw_grav_rad),
                "producer_generation": snap.generation,
                "producer_integrated_time_s": snap.integrated_time_s,
                "producer_last_status": snap.last_status,
                # Stationary detector / gyro-bias tracking / ZUPT.
                "stationary": snap.stationary,
                "zupt_active": snap.zupt_active,
                "zupt_engage_count": snap.zupt_engage_count,
                "bias_updates": snap.bias_updates,
                "bias_gx_dps": snap.bias_gx_dps,
                "bias_gy_dps": snap.bias_gy_dps,
                "bias_gz_dps": snap.bias_gz_dps,
                "window_gyro_std_dps": snap.window_gyro_std_dps,
                "window_accel_std_g": snap.window_accel_std_g,
                "last_bias_update_host_ts": snap.last_bias_update_host_ts,
                "stationary_tracking_enabled": bool(
                    self._imu_yaw_producer.stationary_tracking_enabled
                ),
                "zupt_enabled": bool(self._imu_yaw_producer.zupt_enabled),
                # Motion witness (wheels-stopped signal; see docs/heading_tuning.md).
                "witness_still": snap.witness_still,
                "witness_age_s": snap.witness_age_s,
            }

    def get_health(self) -> dict:
        """Return OAK pipeline health snapshot for observability."""
        now = time.monotonic()
        hz = max(1.0, float(getattr(self._obs_cfg, "update_rate_hz", 10.0)))
        loop_stale_s = max(0.5, 5.0 / hz)
        depth_stale_s = max(1.0, 12.0 / hz)
        det_stale_s = max(1.0, 12.0 / hz)
        rgb_stale_s = 3.0

        with self._lock:
            running = bool(self._pipeline_running)
            connected = bool(self._connected)
            reconnect_count = self._reconnect_count
            last_disconnect_ts = self._last_disconnect_ts
            loop_ts = self._last_pipeline_loop_ts
            depth_ts = self._last_depth_poll_ts
            depth_recv_ts = self._last_depth_recv_ts
            depth_recv_count = self._depth_recv_count
            depth_reject_count = self._depth_quality_reject_count
            det_ts = self._last_detection_poll_ts
            rgb_ts = self._last_rgb_poll_ts
            depth_state_ts = self._depth_state.timestamp
            rgb_state_ts = self._rgb_state.timestamp
            pipe_err = self._last_pipeline_error_msg
            depth_err = self._last_depth_error_msg
            det_err = self._last_detection_error_msg
            rgb_err = self._last_rgb_error_msg
            imu_err = self._last_imu_error_msg
            rgb_expected = bool(
                self._rgb_poll_enabled or self._rgb_always_poll or self._pose_rgb_wanted
            )
            chip_temp_c = self._chip_temp_c
            chip_temp_css_c = self._chip_temp_css_c
            chip_temp_mss_c = self._chip_temp_mss_c
            det_event_ts = list(self._det_event_ts)
            depth_event_ts = list(self._depth_event_ts)
            det_latency_s = self._det_latency_s
            det_fresh_ts = self._det_fresh_ts
            det_seq = self._det_last_seq
            det_seq_stuck_packets = self._det_seq_stuck_packets
            vision_stale_s = self._vision_stale_s
            color_stall_restarts = self._color_stall_restart_count
            color_stall_fault = bool(self._color_stall_fault)
            imu_stall_restarts = self._imu_stall_restart_count
            imu_stall_fault = bool(self._imu_stall_fault)
            imu_watchdog = bool(self._imu_watchdog_enabled)
            imu_sample_ts = self._imu_state.timestamp
            supervisor_ts = self._last_supervisor_ts
            thread = self._thread
            vision_iter_samples = list(self._vision_iter_samples)
            hand_detect_samples = list(self._hand_detect_samples)
            nn_input_queue_size = self._nn_input_queue_size
            hand_poll_enabled = bool(self._hand_poll_enabled)
            mp_loaded = self._lm_net is not None

        loop_age_s = (now - loop_ts) if loop_ts > 0.0 else float("inf")
        depth_age_s = (now - depth_ts) if depth_ts > 0.0 else float("inf")
        depth_recv_age_s = (now - depth_recv_ts) if depth_recv_ts > 0.0 else float("inf")
        det_age_s = (now - det_ts) if det_ts > 0.0 else float("inf")
        if det_fresh_ts is None:
            det_fresh_age_s = float("inf")
        else:
            det_fresh_age_s = now - det_fresh_ts
        vision_stale = det_fresh_age_s > vision_stale_s
        rgb_age_s = (now - rgb_ts) if rgb_ts > 0.0 else float("inf")
        depth_frame_age_s = (now - depth_state_ts) if depth_state_ts > 0.0 else float("inf")
        rgb_frame_age_s = (now - rgb_state_ts) if rgb_state_ts > 0.0 else float("inf")
        last_disconnect_age_s = (now - last_disconnect_ts) if last_disconnect_ts > 0.0 else None

        loop_stale = (not running) or (loop_age_s > loop_stale_s)
        # Worker hang (2026-10-08): neither the session loop nor the
        # supervisor has ticked for vision_hang_s, or the worker thread has
        # died, while nobody asked it to stop. A thread stuck inside depthai
        # (teardown deadlock) looks exactly like this: pipeline_running
        # frozen True, loop_age_s growing for days. The main loop acts on
        # this (journal reminder, and a service restart while disarmed).
        worker_ts = max(loop_ts, supervisor_ts)
        worker_age_s = (now - worker_ts) if worker_ts > 0.0 else float("inf")
        hang_s = float(getattr(self._det_cfg, "vision_hang_s", 30.0) or 0.0)
        thread_started = thread is not None
        thread_alive = bool(thread_started and thread.is_alive())
        stop_requested = self._stop_event.is_set()
        vision_hung = bool(
            hang_s > 0.0
            and thread_started
            and not stop_requested
            and (
                (not thread_alive)
                or (worker_ts > 0.0 and worker_age_s > hang_s)
            )
        )
        depth_stale = depth_recv_age_s > depth_stale_s
        det_stale = det_age_s > det_stale_s
        rgb_stale = rgb_expected and (rgb_age_s > rgb_stale_s)
        # "Critical" stale means obstacle/depth safety path is unhealthy.
        # Detection/RGB stalls are degraded but should not hard-mark pipeline stale.
        critical_stale = loop_stale or depth_stale
        det_fps = _window_rate(det_event_ts, now)
        depth_fps = _window_rate(depth_event_ts, now)
        vision_loop_hz = _window_rate(vision_iter_samples, now)
        vision_work_ms = _window_mean(vision_iter_samples, 1, now) * 1000.0
        hand_poll_ms = _window_mean(vision_iter_samples, 2, now) * 1000.0
        hand_cutoff = now - _HAND_DETECT_WINDOW_S
        hand_n = 0
        hand_found = 0
        for ts, found in hand_detect_samples:
            if ts >= hand_cutoff:
                hand_n += 1
                if found:
                    hand_found += 1
        hand_detect_rate = (hand_found / hand_n) if hand_n else 0.0

        return {
            "pipeline_running": running,
            "connected": connected,
            "reconnect_count": reconnect_count,
            "last_disconnect_ts": last_disconnect_ts if last_disconnect_ts > 0.0 else None,
            "last_disconnect_age_s": round(last_disconnect_age_s, 3) if last_disconnect_age_s is not None else None,
            "loop_age_s": round(loop_age_s, 3) if loop_age_s != float("inf") else None,
            "depth_age_s": round(depth_age_s, 3) if depth_age_s != float("inf") else None,
            "depth_recv_age_s": round(depth_recv_age_s, 3) if depth_recv_age_s != float("inf") else None,
            "depth_recv_count": depth_recv_count,
            "depth_quality_reject_count": depth_reject_count,
            "detections_age_s": round(det_age_s, 3) if det_age_s != float("inf") else None,
            "rgb_age_s": round(rgb_age_s, 3) if rgb_age_s != float("inf") else None,
            "depth_frame_age_s": round(depth_frame_age_s, 3) if depth_frame_age_s != float("inf") else None,
            "rgb_frame_age_s": round(rgb_frame_age_s, 3) if rgb_frame_age_s != float("inf") else None,
            "loop_stale": loop_stale,
            "depth_stale": depth_stale,
            "detections_stale": det_stale,
            "rgb_stale": rgb_stale,
            "rgb_expected": rgb_expected,
            "pipeline_dead": self._pipeline_dead,
            "critical_stale": critical_stale,
            "is_stale": loop_stale or depth_stale or det_stale or rgb_stale,
            "last_pipeline_error": pipe_err or None,
            "last_depth_error": depth_err or None,
            "last_detection_error": det_err or None,
            "last_rgb_error": rgb_err or None,
            "last_imu_error": imu_err or None,
            "chip_temp_c": round(chip_temp_c, 1) if chip_temp_c is not None else None,
            "chip_temp_css_c": round(chip_temp_css_c, 1) if chip_temp_css_c is not None else None,
            "chip_temp_mss_c": round(chip_temp_mss_c, 1) if chip_temp_mss_c is not None else None,
            "det_fps": round(det_fps, 2),
            "depth_fps": round(depth_fps, 2),
            "det_latency_s": round(det_latency_s, 3) if det_latency_s is not None else None,
            "vision_loop_hz": round(vision_loop_hz, 2),
            "vision_work_ms": round(vision_work_ms, 1),
            "hand_poll_ms": round(hand_poll_ms, 1),
            "nn_input_queue_size": nn_input_queue_size,
            "hand_poll_enabled": hand_poll_enabled,
            "mp_loaded": mp_loaded,
            "hand_detect_rate": round(hand_detect_rate, 3),
            "det_fresh_age_s": (
                round(det_fresh_age_s, 3) if det_fresh_age_s != float("inf") else None
            ),
            "det_seq": det_seq,
            "det_seq_stuck_packets": det_seq_stuck_packets,
            "vision_stale": vision_stale,
            "color_stall_restarts": color_stall_restarts,
            "color_stall_fault": color_stall_fault,
            "imu_stall_restarts": imu_stall_restarts,
            "imu_stall_fault": imu_stall_fault,
            # Age of the newest IMU sample, the same age get_imu_data()
            # hands OakImuReader; stale past its 0.5 s stale age (then the
            # heading is frozen). None / True before the first sample. Not
            # part of is_stale: that stays the vision health.
            "imu_age_s": (
                round(now - imu_sample_ts, 3) if imu_sample_ts else None
            ),
            "imu_stale": (
                (not imu_sample_ts) or (now - imu_sample_ts) > _IMU_STALE_AGE_S
            ),
            "imu_watchdog": imu_watchdog,
            "vision_worker_age_s": (
                round(worker_age_s, 3) if worker_age_s != float("inf") else None
            ),
            "vision_thread_alive": thread_alive,
            "vision_hung": vision_hung,
            **self._vio_health(now),
        }

    def _vio_health(self, now: float) -> dict:
        """Log-only VIO fields for get_health (no control authority)."""
        with self._lock:
            active = self._vio_active
            reason = self._vio_reason
            snap = self._vio_tracker.snapshot(now)
            errors = self._vio_errors
            err = self._last_vio_error_msg
            flip = self._imu_flip_yz
            disabled = self._vio_disabled_reason
        if active:
            age = snap.get("vio_age_s")
            status = "on" if (age is not None and age <= 2.0) else "stale"
        elif disabled and bool(getattr(self._det_cfg, "vio_enabled", False)):
            status = f"disabled: {disabled}"
        else:
            status = reason if reason != "on" else "off"
        out = {"vio_status": status, "imu_flip_yz": flip, "vio_errors": errors,
               "last_vio_error": err or None}
        out.update(snap)
        return out

    @property
    def pipeline_dead(self) -> bool:
        """True when the OAK-D pipeline has crashed and is attempting recovery.

        Obstacle avoidance should treat depth as unavailable when this is True.
        """
        with self._lock:
            return self._pipeline_dead

    # Substrings that mark a fatal device/communication failure (USB drop,
    # XLink teardown, device closed). When a per-poll call raises one of these
    # the whole session is unrecoverable and must be rebuilt by the supervisor.
    _FATAL_COMM_MARKERS = (
        "x_link",
        "xlink",
        "communication",
        "device",
        "closed",
        "disconnect",
        "no available",
        "not running",
        "usb",
    )

    @classmethod
    def _is_fatal_comm_error(cls, exc: BaseException) -> bool:
        """Heuristically classify an exception as a fatal device/comm failure.

        depthai surfaces USB drops as plain RuntimeError with messages like
        "Communication exception - possible device error/misconfiguration" or
        "X_LINK_ERROR". We treat any such message (or an explicitly-named
        device/comm error class) as fatal so the supervisor rebuilds the device.
        Non-fatal, frame-level glitches keep their existing swallow-and-continue
        behaviour inside the individual _poll_* methods.
        """
        name = exc.__class__.__name__.lower()
        if "xlink" in name or "communication" in name:
            return True
        msg = str(exc).lower()
        return any(marker in msg for marker in cls._FATAL_COMM_MARKERS)

    @staticmethod
    def _format_err(prefix: str, exc: Exception) -> str:
        msg = str(exc).strip()
        if len(msg) > 220:
            msg = msg[:220] + "..."
        if msg:
            return f"{prefix}: {exc.__class__.__name__}: {msg}"
        return f"{prefix}: {exc.__class__.__name__}"

    @property
    def recording_enabled(self) -> bool:
        return self._rec_cfg is not None and self._rec_cfg.enabled

    def get_recording_queues(self, timeout_s: float = 10.0) -> dict | None:
        """Wait for the pipeline to be ready, then return output queue dict.

        Returns None if pipeline never became ready or recording is disabled.
        """
        if not self.recording_enabled:
            return None
        if not self._device_ready.wait(timeout=timeout_s):
            return None
        with self._lock:
            if self._recording_queues is None:
                return None
            return dict(self._recording_queues)

    # -- Pipeline Construction & Run (depthai v3 API) -----------------------

    # Reconnect backoff schedule (seconds): quick first retries, then steady
    # 10 s polling for the device to re-enumerate. The final value repeats.
    _RECONNECT_BACKOFF_S = (2.0, 5.0, 10.0)

    def _run_pipeline(self) -> None:
        """Supervisor loop: owns one device session at a time and re-establishes
        it after a USB disconnect / re-enumeration without a service restart.

        A "session" is build-pipeline -> open-device -> run poll loops. When the
        OAK USB device drops mid-run a queue ``get`` raises an X_LINK /
        communication error; ``_run_pipeline_once`` detects that, closes the
        device defensively, and returns. This loop then marks health as
        disconnected, backs off (interruptibly), optionally waits for the device
        to re-enumerate, and rebuilds — repeating until ``stop()`` is called.
        """
        # Heartbeat before the import too: a live thread stuck before the
        # supervisor loop (a wedged import) would otherwise be invisible.
        with self._lock:
            self._last_supervisor_ts = time.monotonic()
        try:
            import depthai as dai
            import numpy as np
        except ImportError:
            logger.error("depthai or numpy not installed -- OAK-D reader cannot start")
            return

        attempt = 0  # consecutive failed/ended sessions since last clean run
        while not self._stop_event.is_set():
            session_connected = False
            with self._lock:
                self._last_supervisor_ts = time.monotonic()
            try:
                # Returns True if the device session actually opened (ran the
                # poll loop) before ending; False if the build/open failed.
                session_connected = bool(self._run_pipeline_once(dai, np))
            except Exception:
                logger.exception("OAK-D pipeline crashed -- will retry")
            if self._stop_event.is_set():
                break

            # The session has ended (fault or device drop). Mark disconnected so
            # consumers stop trusting depth, and count a reconnect attempt iff a
            # previously-live device went away (not a build failure on a missing
            # camera). We do NOT touch _depth_state.timestamp here: its age must
            # keep growing while the device is down so the staleness fail-safe in
            # compute_throttle_scale() stops autonomous motion.
            now = time.monotonic()
            with self._lock:
                self._last_supervisor_ts = now
                self._pipeline_dead = True
                self._pipeline_running = False
                self._connected = False
                self._last_disconnect_ts = now
                if session_connected:
                    self._reconnect_count += 1

            # A live device that just dropped restarts the fast 2s->5s->10s ramp;
            # consecutive build/open failures (device truly absent) keep climbing
            # toward the steady 10s poll for re-enumeration.
            if session_connected:
                attempt = 0
            backoff_s = self._RECONNECT_BACKOFF_S[
                min(attempt, len(self._RECONNECT_BACKOFF_S) - 1)
            ]
            attempt += 1
            logger.warning(
                "OAK-D reconnect: device session ended (connected=%s); "
                "retry in %.1fs (reconnects=%d)",
                session_connected, backoff_s, self._reconnect_count,
            )
            # Interruptible backoff sleep — stop() fires the event and we exit
            # promptly instead of finishing the full backoff window.
            if self._stop_event.wait(timeout=backoff_s):
                break
            # Optionally wait for the device to re-enumerate before rebuilding so
            # we don't burn cycles building a pipeline against an absent device.
            # Bounded so a permanently-missing device still loops (and so a test
            # without the helper present is unaffected).
            self._wait_for_device(timeout_s=backoff_s)
        with self._lock:
            self._pipeline_dead = False
            self._connected = False

    def _wait_for_device(self, timeout_s: float) -> bool:
        """Poll the availability helper until a device appears or timeout/stop.

        Best-effort: any error in the helper is swallowed and treated as
        "unknown / proceed", so a missing or mocked-out ``detect()`` never blocks
        the supervisor. Returns True if a device was seen, else False.
        """
        deadline = time.monotonic() + max(0.0, float(timeout_s))
        while not self._stop_event.is_set():
            try:
                if self.detect():
                    return True
            except Exception:
                return False
            if time.monotonic() >= deadline:
                return False
            if self._stop_event.wait(timeout=0.25):
                return False
        return False

    def _camera_fps_kw(self) -> dict:
        """kwargs for Camera.requestOutput: fps= only when camera_fps > 0."""
        fps = float(getattr(self._det_cfg, "camera_fps", 0.0) or 0.0)
        return {"fps": fps} if fps > 0.0 else {}

    def _nn_thread_counts(self) -> tuple[int, int]:
        threads = int(getattr(self._det_cfg, "nn_inference_threads", 2))
        shaves = int(getattr(self._det_cfg, "nn_shaves_per_thread", 4))
        return threads, shaves

    def _configure_nn_input_queue(self, nn_input, label: str) -> None:
        """Keep the NN input queue at nn_input_queue_size (newest-only when 1).

        depthai 3.3.0 on the robot has Node.Input.setMaxSize / getMaxSize.
        Older depthai raises AttributeError; we leave the library default.
        0 = do not call setMaxSize. Log the read-back at WARNING because
        this app installs no logging handler and INFO is dropped.
        """
        requested = int(getattr(self._det_cfg, "nn_input_queue_size", 1) or 0)
        if requested > 0:
            try:
                nn_input.setMaxSize(requested)
            except AttributeError:
                logger.warning(
                    "%s.input.setMaxSize not available on this depthai; "
                    "leaving library default",
                    label,
                )
        try:
            read_back = int(nn_input.getMaxSize())
            self._nn_input_queue_size = read_back
            logger.warning(
                "%s.input queue maxSize=%s (requested %s; 0 leaves library default)",
                label, read_back, requested,
            )
        except AttributeError:
            logger.warning(
                "%s.input.getMaxSize not available on this depthai",
                label,
            )

    def _poll_vision_queues(self, depth_q, spatial_depth_q, det_q, np) -> None:
        """Poll detections and depth in the configured order.

        The corridor already masks with the last published person boxes
        (see _poll_depth) and the safety-tier override already reads the
        last published detections (_all_dets_state), so detections-first
        does not change those consumers — it only publishes person boxes
        one corridor-computation earlier to the steering loop.
        """
        detections_first = bool(getattr(self._det_cfg, "poll_detections_first", True))
        if detections_first:
            self._poll_detections(det_q)
            self._poll_depth(depth_q, spatial_depth_q, np)
        else:
            self._poll_depth(depth_q, spatial_depth_q, np)
            self._poll_detections(det_q)

    def _color_stall_after_poll(
        self,
        now: float,
        session_start_ts: float,
        det_q_present: bool,
    ) -> bool:
        """Apply the colour-stall watchdog after one vision poll.

        Returns True when the session loop should exit so the supervisor
        rebuilds the device. A latched fault does not end the session:
        depth stays up, and follow-me keeps refusing the stale stream.
        ``stop()`` never counts as a watchdog restart.
        """
        if not det_q_present or self._stop_event.is_set():
            return False
        with self._lock:
            fresh_ts = self._det_fresh_ts
            fault = self._color_stall_fault
            depth_recv_ts = self._last_depth_recv_ts
            vision_stale_s = self._vision_stale_s
        restart_now, stalled_for_s = _color_stall_check(
            now, session_start_ts, fresh_ts, self._det_cfg,
        )
        # A packet younger than the follow-me gate means CAM_A is back.
        # The restart history stays, so a flap cannot reset the cap.
        if fault and fresh_ts is not None and (now - fresh_ts) < vision_stale_s:
            with self._lock:
                self._color_stall_fault = False
            logger.warning(
                "OAK colour stream recovered after a stall fault"
            )
            return False
        if not restart_now or fault:
            return False

        cfg = self._det_cfg
        window_s = 900.0
        max_restarts = 3
        if cfg is not None:
            window_s = float(getattr(cfg, "color_stall_window_s", 900.0))
            max_restarts = int(getattr(cfg, "color_stall_max_restarts", 3))
        if depth_recv_ts > 0.0:
            depth_age_s = now - depth_recv_ts
        else:
            depth_age_s = float("inf")

        with self._lock:
            # Shared with the IMU watchdog: either cause counts.
            in_window = self._watchdog_restarts_in_window_locked(now, window_s)
            if in_window >= max_restarts:
                self._color_stall_fault = True
                latched = True
            else:
                self._color_stall_restart_times.append(now)
                self._color_stall_restart_count += 1
                in_window += 1
                self._last_pipeline_error_msg = "color_stall"
                latched = False
        if latched:
            logger.error(
                "OAK colour stream still stalled after %d restarts in %.0f min; "
                "auto-restart disabled (restart the service to retry)",
                in_window, window_s / 60.0,
            )
            return False
        logger.warning(
            "OAK colour stream stalled: no fresh NN packet for %.1f s "
            "(depth age %.1f s); restarting the OAK session "
            "(%d in the last %.0f min)",
            stalled_for_s, depth_age_s, in_window, window_s / 60.0,
        )
        return True

    def _watchdog_restarts_in_window_locked(self, now: float, window_s: float) -> int:
        """Prune both watchdogs' restart stamps; return how many are in the window.

        Caller holds the lock. One budget for the colour and the IMU
        watchdog (OakDetectionConfig.color_stall_max_restarts per
        color_stall_window_s): a session restart costs the same depth and
        detection outage whatever caused it, and two separate budgets
        would let one watchdog's restarts add to the other's.
        """
        cutoff = now - window_s
        self._color_stall_restart_times = [
            t for t in self._color_stall_restart_times if t >= cutoff
        ]
        self._imu_stall_restart_times = [
            t for t in self._imu_stall_restart_times if t >= cutoff
        ]
        return len(self._color_stall_restart_times) + len(self._imu_stall_restart_times)

    def _imu_stall_after_poll(self, now: float, session_start_ts: float) -> bool:
        """Apply the IMU stall watchdog after the IMU poll of one loop pass.

        Returns True when the session loop should exit so the supervisor
        rebuilds the device (the colour watchdog's exit path: break, then
        the session's one ``finally`` teardown). Never True when:

        * the watchdog is off (no heading consumer, or
          ``imu_stall_restart_s <= 0``) or ``stop()`` was requested;
        * the IMU has never delivered a message since this reader started.
          A camera whose IMU never worked is not helped by rebuilds, and
          each one costs seconds of depth: warn once, report it in health,
          and leave the session alone;
        * depth is not fresh (``imu_stall_depth_fresh_s``): then the whole
          device is stalled, which is not an IMU-only stall;
        * the fault is latched (the shared budget was full).

        A session that has not delivered an IMU message yet, after the IMU
        worked in an earlier session, restarts at warm-up + restart time;
        the shared budget bounds that.
        """
        if self._stop_event.is_set():
            return False
        cfg = self._det_cfg
        with self._lock:
            enabled = self._imu_watchdog_enabled
            session_msg_ts = self._imu_session_msg_ts
            any_msg_ts = self._imu_msg_ts
            fault = self._imu_stall_fault
            fault_ts = self._imu_stall_fault_ts
            depth_recv_ts = self._last_depth_recv_ts
        if not enabled:
            return False
        # Fresh data clears the latch: any IMU message after it was set.
        # The restart history stays, so a flap cannot reset the cap.
        if fault and any_msg_ts is not None and any_msg_ts > fault_ts:
            with self._lock:
                self._imu_stall_fault = False
            logger.warning("OAK IMU stream recovered after a stall fault")
            return False
        restart_now, stalled_for_s = _imu_stall_check(
            now, session_start_ts, session_msg_ts, cfg,
        )
        if not restart_now or fault:
            return False
        if any_msg_ts is None:
            if not self._imu_never_seen_logged:
                self._imu_never_seen_logged = True
                logger.warning(
                    "OAK IMU has delivered no message since start (%.1f s into "
                    "this session); the IMU watchdog does not restart the "
                    "session for an IMU that never worked",
                    stalled_for_s,
                )
            return False
        depth_age_s = (now - depth_recv_ts) if depth_recv_ts > 0.0 else float("inf")
        depth_fresh_s = 1.5
        window_s = 900.0
        max_restarts = 3
        if cfg is not None:
            depth_fresh_s = float(getattr(cfg, "imu_stall_depth_fresh_s", 1.5))
            window_s = float(getattr(cfg, "color_stall_window_s", 900.0))
            max_restarts = int(getattr(cfg, "color_stall_max_restarts", 3))
        if depth_age_s > depth_fresh_s:
            return False

        with self._lock:
            in_window = self._watchdog_restarts_in_window_locked(now, window_s)
            if in_window >= max_restarts:
                self._imu_stall_fault = True
                self._imu_stall_fault_ts = now
                latched = True
            else:
                self._imu_stall_restart_times.append(now)
                self._imu_stall_restart_count += 1
                in_window += 1
                self._last_pipeline_error_msg = "imu_stall"
                latched = False
        if latched:
            logger.error(
                "OAK IMU stream still stalled after %d session restarts in "
                "%.0f min; IMU auto-restart disabled (heading stays stale; "
                "restart the service to retry)",
                in_window, window_s / 60.0,
            )
            return False
        logger.warning(
            "OAK IMU stream stalled: no IMU message for %.1f s "
            "(depth age %.1f s); restarting the OAK session "
            "(%d in the last %.0f min)",
            stalled_for_s, depth_age_s, in_window, window_s / 60.0,
        )
        return True

    def _max_usb_speed(self) -> str:
        """USB speed cap for the device session (config, else the config default)."""
        value = getattr(self._det_cfg, "max_usb_speed", None)
        if value is None:
            value = OakDetectionConfig.max_usb_speed
        return str(value or "").strip().upper()

    def _run_pipeline_once(self, dai, np) -> bool:
        """Build + open one device session and run the poll loops.

        Returns True if the device session actually opened and ran the poll loop
        (i.e. a live device went away or stop() was requested), False if the
        build/open failed before the device was ever live. The supervisor uses
        this to decide whether an ended session counts as a reconnect.
        """
        # Phase heartbeat: the build/open below can take seconds (device boot,
        # blob load); stamp so a legitimately slow start ages from here.
        with self._lock:
            self._last_supervisor_ts = time.monotonic()

        vio_attempted = False
        try:
            # USB 2 by default: the USB 3 link jams the RTK GPS (2026-11-06,
            # OakDetectionConfig.max_usb_speed).
            pipeline = open_pipeline(dai, self._max_usb_speed())

            # Determine model type early — affects stereo and NN config.
            _det_cfg = self._det_cfg
            _use_yolo = (
                _det_cfg is not None and _det_cfg.model_type == "yolov8n"
            )

            cam_rgb = pipeline.create(dai.node.Camera).build(dai.CameraBoardSocket.CAM_A)
            mono_left = pipeline.create(dai.node.Camera).build(dai.CameraBoardSocket.CAM_B)
            mono_right = pipeline.create(dai.node.Camera).build(dai.CameraBoardSocket.CAM_C)

            stereo = pipeline.create(dai.node.StereoDepth)
            stereo.setDefaultProfilePreset(dai.node.StereoDepth.PresetMode.DENSITY)
            stereo.setLeftRightCheck(True)
            stereo.setOutputSize(640, 400)
            if _use_yolo:
                # Extended disparity halves the minimum detectable range (0.35 m vs 0.7 m)
                # which helps catch close-range obstacles and improves near-field Follow Me.
                stereo.setExtendedDisparity(True)
                # Align depth map to RGB camera so bounding-box spatial positions are correct.
                stereo.setDepthAlign(dai.CameraBoardSocket.CAM_A)
            _cam_fps_kw = self._camera_fps_kw()
            mono_left_out = mono_left.requestOutput((640, 400), **_cam_fps_kw)
            mono_right_out = mono_right.requestOutput((640, 400), **_cam_fps_kw)
            mono_left_out.link(stereo.left)
            mono_right_out.link(stereo.right)

            # Device-side ROI spatial depth for obstacle distance + median depth.
            spatial_calc = pipeline.create(dai.node.SpatialLocationCalculator)
            rw = self._obs_cfg.roi_width_pct
            rh = self._obs_cfg.roi_height_pct
            rv = getattr(self._obs_cfg, "roi_vertical_offset_pct", 0.0)
            cy = max(rh / 2.0, min(1.0 - rh / 2.0, 0.5 + rv))
            roi_rect = dai.Rect(
                dai.Point2f(0.5 - rw / 2.0, cy - rh / 2.0),
                dai.Point2f(0.5 + rw / 2.0, cy + rh / 2.0),
            )

            spatial_min_cfg = dai.SpatialLocationCalculatorConfigData()
            spatial_min_cfg.depthThresholds.lowerThreshold = 400
            spatial_min_cfg.depthThresholds.upperThreshold = 10000
            spatial_min_cfg.roi = roi_rect
            spatial_min_cfg.calculationAlgorithm = dai.SpatialLocationCalculatorAlgorithm.MIN
            spatial_calc.initialConfig.addROI(spatial_min_cfg)

            spatial_med_cfg = dai.SpatialLocationCalculatorConfigData()
            spatial_med_cfg.depthThresholds.lowerThreshold = 400
            spatial_med_cfg.depthThresholds.upperThreshold = 10000
            spatial_med_cfg.roi = roi_rect
            spatial_median_algo = getattr(
                dai.SpatialLocationCalculatorAlgorithm,
                "MEDIAN",
                dai.SpatialLocationCalculatorAlgorithm.AVERAGE,
            )
            spatial_med_cfg.calculationAlgorithm = spatial_median_algo
            spatial_calc.initialConfig.addROI(spatial_med_cfg)
            stereo.depth.link(spatial_calc.inputDepth)

            if _use_yolo:
                _blob = _det_cfg.model_path
                if _blob:
                    # NNModelDescription.model is Hub-slug only; resolve to absolute path for
                    # local blobs and use setBlobPath() + manual input wiring instead.
                    _blob_abs = (Path(__file__).resolve().parents[2] / _blob).resolve()
                    if not _blob_abs.exists():
                        logger.error(
                            "YOLOv8n blob not found at %s — falling back to MobileNet-SSD. "
                            "Run scripts/convert_yolov8n.py on the Pi to generate it.",
                            _blob_abs,
                        )
                        _use_yolo = False
                        with self._lock:
                            self._person_label = PERSON_LABEL
                else:
                    logger.warning(
                        "YOLOv8n requested but model_path is empty; "
                        "falling back to MobileNet-SSD. "
                        "Run scripts/convert_yolov8n.py on the Pi to generate a local blob."
                    )
                    _use_yolo = False
                    with self._lock:
                        self._person_label = PERSON_LABEL

            # Check if hand tracking will be enabled (before NN setup).
            gesture_enabled = (
                self._gesture_cfg is not None
                and self._gesture_cfg.enabled
                and _HAND_MODELS_DIR.is_dir()
            )

            det_q = None
            tracker_enabled = False
            if _use_yolo:
                # Use plain NeuralNetwork — the ultralytics ONNX export produces
                # pixel-space (cx, cy, w, h) in output0 (values 0..input_w/h).
                # DetectionParser / SpatialDetectionNetwork expect normalised [0,1]
                # coords and silently reject every box, yielding zero detections.
                # Parse the raw NNData tensor on the host and compute spatial
                # coordinates from the stereo depth frame instead.
                yolo_nn = pipeline.create(dai.node.NeuralNetwork)
                yolo_nn.setBlobPath(str(_blob_abs))
                _nn_threads, _nn_shaves = self._nn_thread_counts()
                yolo_nn.setNumInferenceThreads(_nn_threads)
                yolo_nn.setNumShavesPerInferenceThread(_nn_shaves)
                yolo_nn.input.setBlocking(False)
                self._configure_nn_input_queue(yolo_nn.input, "yolo_nn")
                _yolo_cam_out = cam_rgb.requestOutput(
                    (_det_cfg.input_width, _det_cfg.input_height),
                    dai.ImgFrame.Type.BGR888p,
                    **self._camera_fps_kw(),
                )
                _yolo_cam_out.link(yolo_nn.input)
                det_q = yolo_nn.out.createOutputQueue(maxSize=1, blocking=False)
                # NeuralNetwork has no passthroughDepth; tap stereo.depth directly.
                depth_q = stereo.depth.createOutputQueue(maxSize=1, blocking=False)
                logger.info(
                    "OAK-D: using YOLOv8n (NeuralNetwork+host-NMS: conf=%.2f nms=%.2f, %s, input=%dx%d)",
                    _det_cfg.confidence_threshold, _det_cfg.nms_threshold, _blob_abs,
                    _det_cfg.input_width, _det_cfg.input_height,
                )
            else:
                model_desc = dai.NNModelDescription(
                    model="luxonis/mobilenet-ssd:300x300", platform="RVC2"
                )
                logger.info(
                    "OAK-D: using MobileNet-SSD (%s)",
                    "yolov8n blob unavailable"
                    if _det_cfg is not None and _det_cfg.model_type == "yolov8n"
                    else "legacy",
                )
                spatial_nn = pipeline.create(dai.node.SpatialDetectionNetwork).build(
                    cam_rgb, stereo, model_desc,
                )
                spatial_nn.setConfidenceThreshold(self._fm_cfg.detection_confidence)
                # MobileNet fallback keeps its own, unchanged settings; the
                # nn_inference_threads knob is for the YOLO path's A/B only.
                spatial_nn.setNumInferenceThreads(1)
                spatial_nn.setNumShavesPerInferenceThread(4)
                spatial_nn.input.setBlocking(False)
                self._configure_nn_input_queue(spatial_nn.input, "spatial_nn")
                spatial_nn.setBoundingBoxScaleFactor(0.5)
                spatial_nn.setDepthLowerThreshold(int(self._fm_cfg.min_distance_m * 1000))
                spatial_nn.setDepthUpperThreshold(int(self._fm_cfg.max_distance_m * 1000))

                if gesture_enabled:
                    # ObjectTracker's passthrough fan-out stalls the pipeline when
                    # PD is also consuming camera frames.  Fall back to raw
                    # detections so both person-following and hand gestures work.
                    det_q = spatial_nn.out.createOutputQueue(maxSize=1, blocking=False)
                    logger.warning(
                        "ObjectTracker skipped (hand-tracking active); using raw detections",
                    )
                else:
                    try:
                        object_tracker = pipeline.create(dai.node.ObjectTracker)
                        object_tracker.setDetectionLabelsToTrack([self._person_label])
                        object_tracker.setTrackerType(dai.TrackerType.SHORT_TERM_IMAGELESS)
                        object_tracker.setTrackerIdAssignmentPolicy(dai.TrackerIdAssignmentPolicy.SMALLEST_ID)

                        spatial_nn.out.link(object_tracker.inputDetections)
                        spatial_nn.passthrough.link(object_tracker.inputTrackerFrame)
                        spatial_nn.passthrough.link(object_tracker.inputDetectionFrame)
                        det_q = object_tracker.out.createOutputQueue(maxSize=1, blocking=False)
                        tracker_enabled = True
                    except Exception:
                        logger.warning(
                            "ObjectTracker init failed; falling back to raw detections",
                            exc_info=True,
                        )
                        det_q = spatial_nn.out.createOutputQueue(maxSize=1, blocking=False)

                depth_q = spatial_nn.passthroughDepth.createOutputQueue(maxSize=1, blocking=False)

            # Spatial ROI depth is also control-critical, so prefer newest sample.
            spatial_depth_q = spatial_calc.out.createOutputQueue(maxSize=1, blocking=False)
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
