gruMoses/wall_e-Mini/pi_app/hardware/bms.py

"""
Daly BMS Bluetooth service for WALL-E Mini.

Polls the JHB-R24TH-V1.3 BMS (Daly-app compatible) over BLE (bleak) in a background thread.
Thread-safe access to the latest battery state via get_state() / is_charging().

Fail-open charger inhibit: if the BMS has been unreachable for longer than
bms_timeout_s, is_charging() returns False so a lost BLE link never bricks
the robot.

Charge-detect debounce: is_charging() only reports True once pack current has
read above charge_detect_min_current_a for charge_detect_min_consecutive_polls
consecutive polls, so a single spurious positive-current sample (regen/noise
blip while driving) cannot latch a false charger-inhibit and stop the robot.

References:
  - bms_scan.py at repo root for the Daly wire protocol
  - config.BmsConfig for tunable parameters
"""

import asyncio
import copy
import logging
import struct
import threading
import time
from dataclasses import dataclass, field
from typing import List, Optional, Tuple

logger = logging.getLogger(__name__)

# Daly BLE service UUID fragment (0xFFF0 family)
_DALY_SERVICE_UUID_FRAGMENT = "fff0"

# Daly command bytes (A5 40 <cmd> 08 00*8 <checksum>)
_DALY_CMD = {
    "soc":               bytes([0xA5, 0x40, 0x90, 0x08, 0x00, 0x00, 0x00, 0x00, 0x00, 0x00, 0x00, 0x00, 0x7D]),
    "cell_voltage_range":bytes([0xA5, 0x40, 0x91, 0x08, 0x00, 0x00, 0x00, 0x00, 0x00, 0x00, 0x00, 0x00, 0x7E]),
    "temp_range":        bytes([0xA5, 0x40, 0x92, 0x08, 0x00, 0x00, 0x00, 0x00, 0x00, 0x00, 0x00, 0x00, 0x7F]),
    "mosfet_status":     bytes([0xA5, 0x40, 0x93, 0x08, 0x00, 0x00, 0x00, 0x00, 0x00, 0x00, 0x00, 0x00, 0x80]),
    "status":            bytes([0xA5, 0x40, 0x94, 0x08, 0x00, 0x00, 0x00, 0x00, 0x00, 0x00, 0x00, 0x00, 0x81]),
    "errors":            bytes([0xA5, 0x40, 0x98, 0x08, 0x00, 0x00, 0x00, 0x00, 0x00, 0x00, 0x00, 0x00, 0x85]),
}

# Daly 0x98 alarm bit layout: (byte_index, bit_number, label)
# Standard Daly Smart BMS protocol (verified against maland16/daly-bms-uart,
# python-daly-bms, and raw 0x98 response cross-checked against live BMS state).
# Pattern: even bit = Warning (L1), odd bit = Trip/Protection (L2)
# Daly 0x93 byte 0: the BMS's own charge/discharge classification.
_DALY_MODES = {0: "idle", 1: "charging", 2: "discharging"}

_DALY_0x98_ALARM_BITS: List[Tuple[int, int, str]] = [
    # Byte 0 — Voltage (bits 0-3: cell; bits 4-7: pack)
    (0, 0, "Cell OVP Warning"),    (0, 1, "Cell OVP Trip"),
    (0, 2, "Cell UVP Warning"),    (0, 3, "Cell UVP Trip"),
    (0, 4, "Pack OVP Warning"),    (0, 5, "Pack OVP Trip"),
    (0, 6, "Pack UVP Warning"),    (0, 7, "Pack UVP Trip"),
    # Byte 1 — Temperature (bits 0-3: charge; bits 4-7: discharge)
    (1, 0, "Charge OTP Warning"),  (1, 1, "Charge OTP Trip"),
    (1, 2, "Charge UTP Warning"),  (1, 3, "Charge UTP Trip"),
    (1, 4, "Discharge OTP Warning"), (1, 5, "Discharge OTP Trip"),
    (1, 6, "Discharge UTP Warning"), (1, 7, "Discharge UTP Trip"),
    # Byte 2 — Current (bits 0-3: OCP) + SOC (bits 4-7)
    (2, 0, "Charge OCP Warning"),  (2, 1, "Charge OCP Trip"),
    (2, 2, "Discharge OCP Warning"), (2, 3, "Discharge OCP Trip"),
    (2, 4, "SOC High Warning"),    (2, 5, "SOC High Trip"),
    (2, 6, "SOC Low Warning"),     (2, 7, "SOC Low Trip"),
    # Byte 3 — Differential alarms
    (3, 0, "Cell Voltage Diff Warning"), (3, 1, "Cell Voltage Diff Trip"),
    (3, 2, "Temp Sensor Diff Warning"),  (3, 3, "Temp Sensor Diff Trip"),
    # Byte 4 — Hardware / FET
    (4, 0, "Charge FET Failure"),
    (4, 1, "Discharge FET Failure"),
    (4, 2, "Cell Mismatch"),
]


@dataclass
class BmsState:
    """Latest snapshot of BMS telemetry.

    All numeric fields are None until the first successful poll.
    ``connected`` reflects the current BLE link status.
    """
    # Pack-level
    pack_voltage_v: Optional[float] = None
    pack_current_a: Optional[float] = None   # positive = charging, negative = discharging
    soc_pct: Optional[float] = None

    # Cell voltages (mV)
    cell_max_mv: Optional[int] = None
    cell_min_mv: Optional[int] = None
    cell_delta_mv: Optional[int] = None

    # Temperature (°C)
    temp_max_c: Optional[int] = None
    temp_min_c: Optional[int] = None

    # MOSFET / charger state
    charge_fet_on: Optional[bool] = None
    discharge_fet_on: Optional[bool] = None
    # Daly 0x93 byte 0: the BMS's own classification of the pack
    # ("idle" / "charging" / "discharging"). Daly 0x94 bytes 2 and 3: the
    # charger and load "connected" flags. Logged only (2026-09-25): the
    # charger inhibit follows current, so a full pack on the charger is not
    # inhibited. Whether this BMS sets the charger flag with 0 A on a full
    # pack is not yet verified on the robot.
    bms_mode: Optional[str] = None
    charger_connected: Optional[bool] = None
    load_connected: Optional[bool] = None

    # Pack info
    num_cells: Optional[int] = None
    cycle_count: Optional[int] = None

    # Active protection flags (list of human-readable names)
    error_flags: List[str] = field(default_factory=list)

    # Metadata
    last_update_epoch_s: float = 0.0
    connected: bool = False


@dataclass
class BmsLinkHealth:
    """Freshness of the BMS data, for telemetry and the journal only.

    ``state`` is ``"pending"`` (never polled, still inside ``bms_timeout_s``
    of the service start), ``"up"`` (last good poll inside ``bms_timeout_s``)
    or ``"dark"`` (no good poll for longer than ``bms_timeout_s``). While the
    link is dark, ``is_charging()`` fails open and the FET values in
    ``get_state()`` are the last polled values, not live ones.

    This is observation only: nothing reads it to decide motion.
    """
    state: str
    # Seconds since the last good poll; None if the BMS was never polled.
    data_age_s: Optional[float]
    # Seconds without a good poll (since the service start when never
    # polled); None unless state is "dark".
    dark_for_s: Optional[float]
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
