gruMoses/wall_e-Mini/(commit log)

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2025-08-28 Log RC read failures
    [arduino_rc.py]
2025-08-28 Handle inverted IMU correction
    [imu_cli_manual.py, test_controller.py, test_imu_steering_harness.py]
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2025-08-28 Add IMU timestamp reset helper and update tests
    [test_controller.py]
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2025-08-28 Reset IMU error count on successful read
    [test_imu_steering.py]
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2025-08-28 Analyzer: multi-run segmentation, motor columns, enhanced summaries (P/I/D means, roughness, overshoot), windup ratio; JSON now {meta,runs,overall}
    [pid_log_analyzer.py]
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2025-09-02 Add Bluetooth SPP control functionality
    - Modified main.py to use external SPP server via shared file
    - Enhanced spp_server.py with shared file communication and debug output
    - Updated run_main.sh to start wall-e-spp.service automatically
    - Implemented shared file bridge (/tmp/wall_e_bt_latest.json) for BT commands
    - Added freshness check for Bluetooth commands (600ms timeout)
    - Fixed command conversion and file writing with proper error handling
    - Enables Android app control via Bluetooth SPP connection
    [spp_server.py]
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2025-09-04 fix: IMU steering now works with Bluetooth full throttle
    - Fixed moving_ok detection for Bluetooth control
    - Previously IMU corrections were blocked when BT sent (255,255)
    because moving_ok was calculated from RC values instead of BT motor commands
    - Now uses actual motor byte values to determine movement for BT control
    - Maintains original RC logic for radio control input
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2025-10-31 RC control path verified end-to-end: \n- Confirm Arduino CSV format (ch1,ch2,ch3,ch5) and ranges\n- Upload to Nano (Old Bootloader) documented and used\n- Ensure service restarts and control app inte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
    [arduino_rc_reader.ino, spp_server.py, spp_server_backup.py, vesc.py]
2025-10-31 logging: write regardless of armed; show armed/events in UI; default bt_age=None; print write errors once
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2026-02-28 Add OAK-D Lite obstacle avoidance and Follow Me mode
    Integrate OAK-D Lite stereo camera for depth-based obstacle avoidance
    and autonomous person-following. Obstacle avoidance linearly scales
    throttle between configurable slow/stop distances. Follow Me mode uses
    MobileNet-SSD spatial detections to track and follow the nearest person
    with proportional steering and speed control.
    - OakDepthReader: threaded DepthAI v3 pipeline for depth + spatial NN
    - ObstacleAvoidanceController: pure-logic throttle scaling from depth
    - FollowMeController: person target selection and motor command generation
    - Safety: Follow Me activation via ch3 tap sequence or web UI toggle
    - Controller: mode switching (MANUA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
    [oak_depth.py, test_controller_obstacle.py]
2026-02-28 Add RTK GPS hardware reader and waypoint navigation
    Implement DFRobot GNSS-RTK I2C driver and autonomous waypoint navigation
    controller. The GPS reader uses a vendored register-level protocol to
    parse lat/lon/alt/fix/sats/hdop from the RTK module. Waypoint navigation
    uses haversine distance/bearing with cruise/approach speed profiles and
    integrates with the existing IMU steering compensator for heading control.
    - RtkGpsReader: threaded I2C reader with DFRobot register protocol
    - WaypointNavController: bearing/distance math, speed profile, waypoint advancement
    - CLI tools: test_rtk_gps.py (live GPS display), record_waypoints.py (interactive recorder)
    - Tests: haversine distance/bearing, wayp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
    [record_waypoints.py, rtk_gps.py, test_rtk_gps.py, test_waypoint_nav.py]
2026-02-28 Add web dashboard with live camera feeds and Follow Me UI
    Serve a live dashboard at :8080 with MJPEG RGB/depth streams, real-time
    SSE telemetry, person tracking radar, and a Follow Me toggle button.
    The recorder captures activity-triggered H.265 video and MCAP data when
    obstacle avoidance or Follow Me is active.
    - OakWebViewer: Flask app with MJPEG streams, SSE telemetry, Follow Me API
    - OakRecorder: activity-triggered recording with pre-buffer and storage management
    - Dashboard UI: tracking radar, motor gauges, detection overlays, auto-reconnect streams
    - oak_live_view.py: standalone dry-run test dashboard for camera-only testing
    Made-with: Cursor
    [oak_live_view.py, oak_recorder.py, oak_viewer.py]
2026-02-28 Add RC Ch4 and use it for Follow Me mode activation
    - Arduino: add Ch4 on pin D10 as 5th RC input (CSV: ch1,ch2,ch3,ch4,ch5)
    - Pi parser: accept 5-field CSV (backward-compatible with legacy 4-field)
    - Safety: replace quad-tap ch3 Follow Me activation with ch4 switch
    (ch4 high = enter, ch4 low = exit; still requires armed state)
    - Propagate ch4 through RCInputs, RCState, controller, main loop,
    monitor CLI, and structured JSON logs
    - Remove tap_window_s/tap_count from config
    - Update all tests (28 pass)
    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
    [arduino_rc.py, arduino_rc_reader.ino, monitor_rc.py, test_controller.py]
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2026-02-28 Unify motor neutral constant to 126 across entire codebase
    - mapping.py: Change CENTER_OUTPUT_VALUE from 128 to 126, MAX_OUTPUT
    from 255 to 254, and rewrite map_pulse_to_byte as piecewise-linear
    around center (850->0, 1500->126, 2150->254)
    - arduino_modelx.py: Import CENTER_OUTPUT_VALUE/MAX_OUTPUT/MIN_OUTPUT
    from mapping instead of hardcoding; remove stale TODO comments
    - controller.py: Replace all hardcoded 126/255 with shared constants;
    initialize _person_detections in __init__ to avoid AttributeError
    - follow_me.py: Import and use shared constants for neutral/max/min
    - config.py: Remove duplicate log_steering_corrections from Config
    (already exists in ImuSteeringConfig)
    - Update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
    [arduino_modelx.py, test_controller.py, test_mapping.py]
2026-02-28 Add RC staleness watchdog and serial reconnect for safety
    - controller.py: Check RC age on every process() call; if data is >1s
    stale, force disarm, stop motors, return neutral with RC_STALE event.
    This prevents the robot from running away if the Arduino disconnects.
    - safety.py: Add RC_STALE event type to SafetyEvent enum.
    - arduino_rc.py: Add _reconnect() method that closes the dead serial
    port, rediscovers the Arduino, and reopens. The _read_loop now catches
    SerialException/OSError and triggers reconnect instead of spinning on
    a dead file descriptor. Also handles generic errors with a 10-error
    threshold before reconnecting.
    - main.py: Fix reference to removed config.log_steeri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
    [arduino_rc.py, test_controller.py]
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2026-03-01 Optimize OAK host workload and harden performance validation.
    This reduces unnecessary preview/serialization CPU work, fixes DepthAI encoding and recorder queue wiring, and adds a reproducible perf harness plus baseline/P1 validation reports to drive before/after tuning.
    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
    [oak_depth.py, oak_recorder.py, oak_viewer.py, plot_pid_csv.py]
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2026-03-01 Revert "Tune OAK queue policies and drain recorder bitstream backlog."
    This reverts commit 4388f75d737f5a8460b8beb0b87b7d27e81f35df.
    [oak_depth.py, oak_recorder.py]
2026-03-01 Make high-rate PID CSV logging explicit and document follow-up outcomes.
    This adds an opt-in --pid-csv flag to avoid always-on per-tick CSV writes in normal runs and updates the performance report with live follow-me validation, MCAP runtime notes, and the reverted queue-tuning outcome.
    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
2026-03-01 Document post-P1 follow-up commits and latest regression notes.
    This updates the performance report with spatial offload/recording-trigger changes, commit traceability, and short-window regression caveats for interpreting stress data.
    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
2026-03-01 Cache recordings API directory scans with short TTL.
    This avoids re-walking the recordings directory on every /api/recordings poll by caching results for a brief interval, reducing filesystem overhead from dashboard refresh traffic.
    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
    [oak_viewer.py]
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2026-03-01 Gate MCAP image snapshots to follow/person contexts.
    Reduce recording-path CPU load by skipping MCAP RGB/depth image serialization during obstacle-only sessions while preserving video and telemetry recording.
    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
    [oak_recorder.py]
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2026-03-03 Add comprehensive ideas and enhancements tracker
    Captures all discussed improvements: IMU 15 Hz bottleneck fix, PID
    tuning issues, backlash compensation, wheel speed feedback (VESC
    telemetry / freed Arduino encoder pins), terrain roughness detection,
    tilt protection, slew rate limiting, Follow Me smoothing, gain
    scheduling, RTK GPS gotchas, gyro drift mitigation, and more.
    Prioritized by impact/effort ratio.
2026-03-08 Add slew rate limiter, follow-me PD steering, and calibration wizard.
    - Motor command slew limiter with mode-aware accel/decel profiles,
    hard-stop bypass, and snap-first-command behavior.
    - Follow-me PD steering (derivative damping + EMA smoothing),
    dynamic follow distance, and hold-last-command on brief target loss.
    - Depth ROI vertical offset and raised lower threshold (100→400mm)
    with host-side 5th-percentile obstacle distance.
    - Controller calibration mode for web-based calibration wizard.
    - OakWebViewer wired to calibration blueprint and new nav link.
    - Consolidated ideas doc into unified roadmap/TODO.
    - Tests for slew limiter asymmetric profiles and hard-stop bypass.
    Made-with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
    [auto_tune_follow_me.py, calibration_wizard.py, oak_depth.py, oak_recorder.py]
2026-03-08 Add hand-gesture activation for Follow Me mode
    Implements 3-4-3 finger sequence to activate Follow Me and open palm
    (5 fingers) to deactivate, using MediaPipe Hands running on the Pi CPU.
    Key design decisions driven by OAK-D Lite hardware constraints:
    - All hand detection/landmark inference runs host-side via MediaPipe
    (on-device palm detection stalled the pipeline due to ISP output limits)
    - ObjectTracker is conditionally disabled when gestures are active to
    avoid passthrough fan-out backpressure
    - Angle-based finger detection (PIP/DIP joint angles) instead of
    Y-coordinate ordering, which is robust to any camera mounting angle
    Includes GestureStateMachine with debounced sequence mat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
    [oak_depth.py, test_gesture_control.py]
2026-03-10 Follow Me: lost-target recovery steering, steer rate limiting, and obstacle fix
    - Lost target: turn back toward person's last known direction instead of
    driving straight forward (lost_target_search_steer_pct config).
    - Steering rate limiter: cap steer_offset change rate (max_steer_delta_per_s)
    and absolute value (max_steer_offset_byte) to prevent torque spikes.
    - Disable snap_first_command for Follow Me mode so first motor command is
    ramped through slew limiter (snap_first_follow_me config).
    - Obstacle avoidance: raise min depth from 400mm to configurable min_depth_mm
    (600mm default) and add min_valid_pct gate (8%) to reject sparse noise
    that was falsely throttling to 10% in both m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
    [oak_depth.py]
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2026-03-10 GPS telemetry, ground-plane obstacle visualization, and IMU smoothing
    - Add GPS fields to RecordingTelemetry and populate from RTK reader
    - Dashboard: live GPS fix, satellites, HDOP, position, altitude cards
    - IMU: EMA-smooth accelerometer before gravity projection for yaw rate
    - Obstacle overlay: draw ground-plane corridor triangle instead of
    fixed rectangle, using camera_height_m and robot_width_m geometry
    - Pass full ObstacleAvoidanceConfig to OakRecorder for accurate overlay
    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
    [oak_imu.py, oak_recorder.py, oak_viewer.py]
2026-03-10 Add IMU tuning session notes and obstacle avoidance plan docs
    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
2026-03-11 Follow Me: tuned steering/speed gains, fixed dynamic follow distance, improved lost-target behavior
    - Disable IMU heading compensation in Follow Me mode (was fighting the
    steering controller) and reset heading target on mode entry
    - Remove dynamic follow distance that overrode the configured 1.5m with
    whatever distance the person happened to be at on first detection
    - Decouple speed gain from max_distance_m so extending detection range
    (4m→6m) doesn't flatten the speed curve; new max_speed_error_m param
    - Increase max_follow_speed_byte 100→115 and accel slew 140→200 bps
    to keep up with walking pace on dirt
    - Tune steering: Kp 0.8→0.35, Kd 0.981→0.06, steer cap 50→15 bytes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
2026-03-11 Enrich MCAP and JSON telemetry for trail-following calibration
    Add IMU heading, odometry pose, pursuit mode, trail state, speed/steer
    offsets, and distance error to both MCAP and JSON logs. Add raw person
    detection list (x_m, z_m, conf, bbox) to JSON logs. Update trail replay
    tool to consume the new fields directly from MCAP instead of backfilling
    from JSON.
    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
    [oak_recorder.py, trail_replay.py]
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2026-03-11 Fix confirmed bugs from code review across 7 files
    Odometry (odometry.py):
    - Add MAX_DT clamp to prevent pose teleport after pipeline stalls
    - Guard against NaN/inf heading from IMU
    - Detect counter-rotating motors and zero forward speed
    - Freeze RobotPose dataclass
    Follow Me (follow_me.py):
    - Minimum forward speed during lost-target trail pursuit (prevents spin-in-place)
    - Add hysteresis on trail/direct mode switching decision (not steer output)
    Main loop (main.py):
    - Initialize imu_status before first use in telemetry block
    - Preserve timestamp precision (round to ms instead of int)
    - Add motor_driver.stop() at top of finally block
    Calibration parser (follow_me_calibration.py):
    - Read s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
    [follow_me_calibration.py, test_trail_follow.py]
2026-03-11 Add 14 new tests for bug fixes and safety-critical paths
    New odometry tests (test_trail_follow.py):
    - dt clamp prevents pose teleport on pipeline stalls
    - NaN/inf heading rejected without poisoning pose
    - Counter-rotating motors report zero forward speed
    - RobotPose frozen dataclass enforced
    New integration tests (test_follow_me_integration.py):
    - Lost-target with trail: robot follows trail, both motors forward
    - Lost-target with zero last_speed_offset: MIN_LOST_TARGET_SPEED kicks in
    - Lost-target with empty trail: robot stops at neutral
    - Mode-switch hysteresis prevents trail/direct flapping
    New safety/waypoint tests (test_safety_and_waypoint_fixes.py):
    - SafetyState.set_follow_me_active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
    [test_follow_me_integration.py, test_safety_and_waypoint_fixes.py, test_trail_follow.py]
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2026-03-13 Add LoRa link status to dashboard, field-tuning updates, and OAK-D health monitoring
    - Read differential age and base station ID registers from DFRobot RTK
    module and display LoRa correction link health in the dashboard with
    color-coded status (green/yellow/red based on diff age and fix quality)
    - Tune follow-me parameters from evening field session: increase lost
    target timeout, add blind trail pursuit window, widen direct pursuit
    thresholds, calibrate trail speed scale from VESC measurements
    - Add OAK-D pipeline health diagnostics (staleness tracking, error
    messages, per-subsystem timestamps) to oak_depth reader
    - Fix VescCanDriver construction in CLI tuning tools (pass left/righ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
    [auto_tune_follow_me.py, auto_tune_pid.py, auto_tune_straight_bias.py, oak_depth.py, oak_recorder.py]
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2026-03-13 Add affine geo-transform engine for pixel↔GPS conversion
    Pure-math module for map calibration: computes least-squares affine
    transform between pixel coordinates and GPS (lat/lon) using local
    tangent plane projection for numerical stability. Includes save/load
    JSON persistence and per-point residual computation via Haversine.
    9 unit tests covering round-trip accuracy, collinear rejection,
    interior point mapping, and persistence.
    [test_geo_transform.py]
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2026-03-13 Fix RTK GPS silent failure and dashboard telemetry blackout
    RTK GPS: split 33-byte I2C read into two calls (32+1) to stay within
    smbus2's 32-byte block limit; promote poll errors to WARNING.
    Depth: track frame reception separately from quality-filter pass so
    depth_stale reflects actual pipeline health; always update raw_frame
    for live dashboard visualization even when quality filters reject.
    SSE: replace float('inf')/NaN with null before JSON serialization—
    Infinity is not valid JSON and was causing JSON.parse() to fail on
    every SSE message, killing all dashboard telemetry.
    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
    [oak_depth.py, oak_viewer.py, rtk_gps.py]
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2026-03-13 Upgrade trail-following with regulated pure pursuit: smoothing, adaptive lookahead, curvature scaling
    Implements the four high-impact upgrades from trail-following research:
    1. Savitzky-Golay path smoothing on breadcrumb trail (numpy only, no scipy)
    2. Adaptive lookahead: clamp(speed_mps * time_s, min, max) replaces fixed formula
    3. Forward-only closest-point search with sliding window (prevents backward snap)
    4. Curvature-based velocity scaling with look-ahead pre-deceleration
    All features are feature-flagged and default to enabled. Existing behavior
    preserved when flags are disabled. 47 tests pass (21 new), zero regressions.
    [test_trail_follow.py]
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2026-03-15 Fix IMU heading update in Follow Me and tune trail pursuit lookahead
    - Call imu_compensator.update() in FOLLOW_ME branch of controller.py
    so dead-reckoning odometry gets live heading (was frozen before).
    - Increase pursuit_lookahead_speed_scale from 0.0015 to 0.019 so the
    lookahead reaches curved trail sections at follow speed (~2.5 m)
    while staying tight (~1.1 m) during slow lost-target recovery.
    - Document root cause of trail-steering wrong-direction bug: heading
    noise contaminates camera_to_world crumb positions, manufacturing
    phantom curves. Add three-phase fix plan to TODO (log-replay
    simulator, 2D physics sim, noise-immune crumb algorithm).
    - Add logging/troubleshooting ref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
    [test_follow_me_integration.py]
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2026-03-27 Add Follow Me log replay harness (Option 1)
    - tools/replay_follow_me_log.py: replay FOLLOW_ME segments through
    FollowMeController with monotonic time mapped from log ts; optional
    GPS feed; compare replay vs logged steer/speed; CSV export.
    - Fixture + unit tests for parse/replay smoke test.
    - Mark Option 1 done in performance_optimization_todo.md.
    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
    [replay_follow_me_log.py, test_replay_follow_me_log.py]
2026-03-29 Add UPS Plus power daemon with 30s grace timer
    Adds upsPlus_power_daemon.py to the repo (was deployed to ~/bin but
    never tracked). Also increases NO_CHARGE_GRACE_SECONDS from 10 to 30
    so the UPS Plus 2-minute battery sampling window (8-9s) no longer risks
    tripping the shutdown sequence.
    [upsPlus_power_daemon.py]
2026-03-29 Calibrate Follow Me for gravel field testing (Phase 0–5)
    - trail_speed_scale_mps_per_byte: 0.0016 → 0.0075 (measured via RTK GPS on gravel)
    - max_follow_speed_byte: 115 → 80 (more reaction time for corners)
    - pursuit_lookahead_curvature_points: 5 → 10 (earlier turn detection at higher speed)
    - trail_direct_blend: effectively disabled (was overriding trail pursuit at corners,
    causing the robot to cut corners and aim straight at the person)
    Phases 0–4 pass. Phase 5 (curvature velocity scaling) still in progress —
    corner-cutting fix needs field retest.
    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
2026-03-29 fix(oak): correct YOLOv8n hub slug and add MobileNet-SSD fallback
    Replace invalid "yolov8n" hub slug with "yolov8n_coco_640x352" (Myriad X
    RVC2 compatible). Wrap both NNModelDescription creation and
    SpatialDetectionNetwork.build() in try/except blocks that gracefully
    fall back to MobileNet-SSD so the robot always comes up even if YOLO
    model resolution fails.
    [oak_depth.py]
2026-03-29 fix(oak): revert default to mobilenet-ssd, fix slugs, add blob conversion script
    - Revert OakDetectionConfig.model_type default back to "mobilenet-ssd" so
    robot is functional while YOLOv8n blob conversion is pending
    - Fix YOLO branch: when model_path is empty, skip hub (no longer supported)
    and fall back to MobileNet-SSD immediately with a clear log message
    - Fix all MobileNet-SSD hub slugs to "luxonis/mobilenet-ssd:300x300" (the
    correct depthai 3.x / Luxonis Hub format; bare "mobilenet-ssd" caused
    NeuralNetwork blob-not-loaded errors at pipeline.start())
    - Add scripts/convert_yolov8n.py: converts yolov8n.pt → OpenVINO IR →
    .blob via blobconverter for local use on OAK-D Lite (R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
    [convert_yolov8n.py, oak_depth.py]
2026-03-29 feat(oak): switch default to YOLOv8n blob, fix opset for blobconverter compat
    - config.py: OakDetectionConfig model_type → yolov8n, model_path → models/yolov8n_416.blob
    - convert_yolov8n.py: export with opset=11 so blobconverter (OpenVINO 2022.1) can compile MaxPool
    [convert_yolov8n.py]
2026-03-29 fix(convert): use ONNX+opset11 path to bypass blobconverter opset14 rejection
    Ultralytics 8.4+ exports OpenVINO IR with opset14 MaxPool which the Luxonis
    blobconverter server (OpenVINO 2022.1) rejects. Switch to ONNX export with
    opset=11 and blobconverter.from_onnx() so the server handles IR conversion.
    [convert_yolov8n.py]
2026-03-29 fix(oak): use model= not modelPath= for NNModelDescription with local blob
    DepthAI constructor signature uses model= (not modelPath=) for loading a
    local .blob path. Fixes TypeError on YOLOv8n blob load at startup.
    [oak_depth.py]
2026-03-29 fix(oak): use setBlobPath+manual wiring for local YOLOv8n blob (depthai 3.x)
    NNModelDescription.model is Hub-slug only — passing a local file path causes
    a 404 Hub lookup. Switch to setBlobPath(abs_path) + cam_rgb.requestOutput() +
    stereo.depth.link() for local blobs; keep .build() path for Hub MobileNet-SSD.
    [oak_depth.py]
2026-03-29 fix(oak): align depth to RGB camera for YOLOv8n spatial detection accuracy
    Manual wiring doesn't auto-align depth; setDepthAlign(CAM_A) ensures bounding
    box spatial positions map correctly to the RGB inference frame.
    [oak_depth.py]
2026-03-29 fix(oak): use YoloSpatialDetectionNetwork for YOLOv8n blob
    SpatialDetectionNetwork uses SSD-style output parsing and produces zero
    detections when given a YOLOv8n blob (output shape [1, 84, 8400]).
    Switching to YoloSpatialDetectionNetwork and adding the required anchor-free
    YOLO parameters (setNumClasses/setCoordinateSize/setAnchors/setAnchorMasks)
    restores person detections.
    [oak_depth.py]
2026-03-29 fix(oak): configure YOLOv8n detectionParser in depthai v3
    depthai v3 SpatialDetectionNetwork.detectionParser defaults to
    NNFamily=YOLO but leaves NumClasses=0, CoordinateSize=0, and
    IouThreshold=0.0 — these zero values cause the YOLO decoder to
    produce no detections. Set NumClasses=80, CoordinateSize=4,
    Anchors=[], AnchorMasks={} (anchor-free), and IouThreshold from
    config on the detectionParser before the pipeline starts.
    YoloSpatialDetectionNetwork does not exist in depthai 3.3.0;
    the correct v3 pattern is SpatialDetectionNetwork + detectionParser.
    [oak_depth.py]
2026-03-29 fix(imu): correct roll/pitch axis mapping for OAK-D Lite BMI270
    The BMI270 uses the camera image frame (X=right, Y=down, Z=forward).
    When the camera is flat, ay ≈ -g causing atan2(ay,az) = -90° (was
    reporting -93.6° for a nearly-level camera).
    Remap to robot body frame:
    roll = atan2(ax, -ay) -- X=right tilt, -ay gives +g reference up
    pitch = atan2(az, -ay) -- Z=forward tilt, same reference
    Gyro integration updated to match:
    roll integrates gz (Z=forward is the roll axis)
    pitch integrates gx (X=right is the pitch axis)
    Yaw rate (gz_dps in return dict) is unchanged to preserve existing
    steering compensation behaviour.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
    [oak_imu.py]
2026-03-29 fix(oak): wire YOLO passthrough queue for rgb_stale diagnostics
    When using setBlobPath() (manual wiring), the YOLO pipeline was creating
    a separate cam_rgb.requestOutput(640x480) for rgb_preview_q — a raw camera
    preview that is only polled when the recorder is active (_rgb_poll_enabled).
    This meant rgb_stale was always True regardless of whether camera frames
    were actually reaching the YOLO NN.
    Changes:
    - Save _yolo_cam_out reference from cam_rgb.requestOutput() before linking
    to spatial_nn.input (ensures the output node stays alive during pipeline
    construction)
    - For YOLO (non-gesture), bind rgb_preview_q to spatial_nn.passthrough
    instead of a separate camera preview; the passthrou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
    [oak_depth.py]
2026-03-29 fix(oak): drop BGR888p type from YOLO requestOutput to fix dead camera→NN link
    Requesting an explicit BGR888p frame type from cam_rgb.requestOutput() at
    416x416 causes the ISP to silently produce no frames on depthai v3, which
    starves the YOLO NN of input and produces zero detections. Removing the
    explicit type lets the ISP output its native format; the Myriad X NN
    runtime handles the format conversion internally, matching the behaviour
    of the auto-wired MobileNet path.
    This resolves the root cause of rgb_stale: true persisting even after the
    passthrough queue fix — spatial_nn.passthrough was empty because the NN
    genuinely had no input frames to pass through.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
    [oak_depth.py]
2026-03-29 fix(oak): restore BGR888p for YOLO NN input; fix rgb_stale diagnostic
    Two issues found after deploying the passthrough-queue change:
    1. Removing BGR888p caused the Myriad X to receive NV12 frames (259584B)
    instead of the 519168B (3×416×416) that the YOLO blob's input tensor
    requires, logging:
    Input tensor 'images' exceeds available data range.
    Data size (259584B), size (519168B) — skipping inference
    Restore BGR888p so the ISP produces the correct 3-channel uint8 data.
    2. Using spatial_nn.passthrough as the host rgb_stale queue broke the
    ObjectTracker fan-out: passthrough already has two on-device consumers
    (inputTrackerFrame + inputDetectionFrame) and depthai v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
    [oak_depth.py]
2026-03-29 fix(oak): use 640x480 for YOLO rgb diagnostic to avoid requestOutput dedup
    depthai v3 deduplicates requestOutput() calls with identical (size, type)
    parameters on the same Camera node — calling requestOutput((416,416)) a
    second time returned the same on-device-only output already linked to the
    NN, so the host queue never received frames (rgb_stale: true).
    Use (640, 480) for the diagnostic queue to guarantee a distinct ISP output
    stream that is delivered to the host.
    [oak_depth.py]
2026-03-29 fix(oak): set _rgb_always_poll=True for YOLO regardless of gesture state
    When gesture_enabled=True (hand models dir exists on Pi), the previous
    code placed _rgb_always_poll=True inside 'if not gesture_enabled:',
    so it was never reached. rgb_preview_q was set to hand_rgb_q but
    _rgb_always_poll stayed False, causing _poll_rgb to never be called
    and rgb_stale to always report True.
    Move the _rgb_always_poll=True assignment outside the gesture check so
    it fires whenever _use_yolo is True, regardless of gesture mode.
    [oak_depth.py]
2026-03-29 fix(yolo): add reverse_input_channels=True to fix BGR→RGB mismatch
    OAK-D sends BGR888p frames but the blob expected RGB input, causing
    person detection confidence to fall to 0.02-0.05 (below 0.3 threshold).
    Furniture detections still worked because shape features are color-agnostic.
    The blobconverter reverse_input_channels flag inserts an OpenVINO
    mean/scale preprocessor that swaps channels at compile time, so no
    runtime overhead on the Myriad X.
    [convert_yolov8n.py]
2026-03-30 fix(convert): pass reverse_input_channels via optimizer_params
    blobconverter.from_onnx() does not accept reverse_input_channels as a
    direct kwarg — it must be passed as an OpenVINO MO flag via
    optimizer_params. Bare kwarg raised TypeError at runtime.
    [convert_yolov8n.py]
2026-03-31 Switch YOLO input to 640x352 wide aspect ratio for full OAK-D Lite HFoV
    - convert_yolov8n.py: replace --imgsz with --width/--height args (default
    640x352); ONNX export uses imgsz=[height, width] for non-square support;
    auto-derives output path as models/yolov8n_WxH.blob
    - config.py: replace input_size=416 with input_width=640/input_height=352;
    update model_path default to yolov8n_640x352.blob; fix camera_hfov_deg
    from 73.0 to 81.0 (OAK-D Lite full sensor HFoV)
    - oak_depth.py: pass (input_width, input_height) to requestOutput instead
    of the old square (input_size, input_size); update log message format
    - oak_viewer.py: set stream-card img aspect-ratio to 640/352 for correct
    widesc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
    [convert_yolov8n.py, oak_depth.py, oak_viewer.py]
2026-03-31 fix(yolo): bake input normalisation into blob, fix detection parser config
    convert_yolov8n.py:
    - Add --scale_values=[255,255,255], --mean_values=[0,0,0], --layout=NCHW to
    optimizer_params so the Myriad X normalises [0,255]→[0,1] internally;
    without this all sigmoid activations saturate and yield zero real detections
    - --reverse_input_channels was already present; now grouped with the other
    normalisation flags with an explanatory comment
    - Change default --shaves from 6 to 5 (correct for OAK-D Lite RVC2)
    - Clear ~/.cache/blobconverter and /tmp/blobconverter before conversion so
    stale cached blobs (compiled without normalisation) are not returned
    oak_depth.py:
    - Add dp.setSubtype("y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
    [convert_yolov8n.py, oak_depth.py]
2026-03-31 feat(cli): add standalone YOLO detection validation script
    test_detection.py builds the same YOLOv8n SpatialDetectionNetwork
    pipeline as production (same detectionParser config, RGB888p input,
    extended disparity, depth alignment) and runs it for a configurable
    duration. Per-frame detection output is printed live, followed by a
    summary with detection rate, top classes, avg confidence, and a clear
    PASS/FAIL verdict (PASS ≥ 50% frames with detections).
    Use `--save-frames` to save OpenCV-annotated JPEGs for visual inspection.
    [test_detection.py]
2026-04-01 Refactor follow-me into clean 5-layer architecture
    Replace the monolithic FollowMeController with distinct, testable layers:
    1. DetectionFilter — conf/depth/bbox-area validation, normalises x to [-1,+1]
    2. TargetTracker — EMA smoothing (α=0.35), track-ID continuity, 2s persistence
    3. SteeringLayer — proper PID (Kp=1.8 Ki=0.2 Kd=0.7) on normalised offset
    4. SpeedLayer — depth-error proportional control with ±0.2m dead zone
    5. SafetyLayer — accel slew-rate limiting, speed cap
    Motor output is rate-limited to 15 Hz (decoupled from 30 fps vision) while
    all computation (PID, trail breadcrumbs, mode selection) runs at full call
    rate so _pursuit_mode and tel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
2026-04-01 fix(test): align test_detection pipeline with baked-normalisation blob
    - Add dp.setSubtype("yolov8") — without this the DetectionParser
    misreads the [1,84,4620] YOLOv8 tensor as YOLOv5 layout and yields
    zero detections regardless of confidence threshold
    - Switch camera output from RGB888p → BGR888p to match oak_depth.py;
    the blob is compiled with --reverse_input_channels + --scale_values
    baked in, so it expects raw BGR888p from the camera
    [test_detection.py]
2026-04-01 Switch YOLOv8 detection to NeuralNetwork + host-side NMS
    The ultralytics ONNX export bakes in the decode step and outputs
    pixel-space (cx, cy, w, h) in output0 (values 0..640/352).
    DetectionParser / SpatialDetectionNetwork expect normalised [0,1]
    coordinates and silently reject every box, yielding zero detections.
    Replace SpatialDetectionNetwork + detectionParser with plain
    NeuralNetwork and parse the raw NNData tensor on the host:
    - _parse_yolo_tensor(): conf filter + per-class cv2.dnn.NMSBoxes
    - _compute_spatial_from_depth(): median depth sampling at bbox centre
    + pinhole projection for lateral x_m
    - depth_q now taps stereo.depth directly (no passthroughDepth)
    - ObjectTracker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
    [oak_depth.py, test_detection.py]
2026-04-01 follow-me: revert PID gains to match pre-refactor behavior
    Kill integral term (ki 0.2→0.0) that was causing hunting/oscillation.
    Scale back kp (1.8→0.8) and kd (0.7→0.3) to gentler old values.
    Restore follow_distance_m to 1.5m and target_ema_alpha to 0.3.
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2026-04-01 fix(follow_me): eliminate overshoot from stale steer + direct-mode spikes
    Three compounding causes of follow-me overshoot, all fixed:
    1. Steer frozen on stale data (persistence window)
    The TargetTracker returns the last known state for up to persistence_s
    even when persons=0. The controller was calling _compute_steering() on
    this stale normalized_x, holding e.g. steer=+18.2 for 2 s while the
    robot had already passed the target. Fix: gate the steering computation
    on `fresh_detection = bool(filtered)`; when the persistence window is
    active but no real detection exists, use steer=0 (coast straight).
    Also reduce the default persistence window from 2.0 s → 1.0 s.
    2. Ste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
2026-04-01 fix: front camera obstacles no longer block reverse commands
    Obstacle avoidance scaling now checks direction before applying
    throttle reduction — `is_forward_motion` gates both the motor
    byte scaling and the hard-stop slew-limiter bypass so that
    front camera detections only affect forward motion.
    Added regression test `test_reverse_unaffected_by_front_obstacle`.
    [test_controller_obstacle.py]
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2026-04-01 feat(vesc): CAN telemetry RX and low-voltage shutdown
    Adds background CAN telemetry reception and a voltage-triggered graceful
    shutdown to VescCanDriver — the primary safety path for low-battery protection.
    - vesc.py: daemon thread reads VESC STATUS/STATUS_4/STATUS_5 broadcast
    frames; thread-safe telemetry state (RPM, current, temps, pack voltage).
    Public API: get_voltage(), get_rpm(motor), get_current(motor),
    get_temperature(motor). Voltage monitor runs in the RX thread: if pack
    voltage stays below threshold for a sustained delay, motors are stopped
    and `sudo shutdown -h now` is invoked via a detached thread (one-shot
    latch, no oscillation). start()/stop() lifecycle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
    [test_vesc_telemetry.py, vesc.py]
2026-04-01 feat(bms): Daly BMS Bluetooth integration with charger inhibit
    Adds a threaded BmsService that polls the Daly SPIM08HP over BLE and
    gates drive commands when the charger is connected.
    bms.py — BmsService:
    - Runs an asyncio event loop in a daemon thread (bleak BLE client)
    - Polls SOC, cell voltage range, temperature, MOSFET status, pack status,
    and error/protection flags every 8 s (configurable)
    - Auto-reconnect with exponential backoff (5 s → 60 s cap)
    - Thread-safe get_state() returns a BmsState snapshot
    - is_charging(): charge FET on + current > 0; fail-open — returns False
    if BMS unreachable for > bms_timeout_s so a lost BLE link never bricks
    the robot
    - Logs INFO on each suc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
    [bms.py, test_bms.py]
2026-04-01 Add closed-loop speed control and slip detection via VESC telemetry
    Improves driving on farm terrain by closing the speed loop and detecting
    wheel slip in real time rather than relying on open-loop byte commands.
    - vesc.py: add VescTelemetry dataclass + VescCanDriver.get_telemetry()
    snapshot combining RPM, current, temp and voltage from both motors
    - config.py: VescConfig gains wheel_radius_m, motor_poles,
    vesc_telemetry_enabled; FollowMeConfig gains velocity PID fields
    (speed_kp/ki/kd/integral_limit) and slip detection fields
    (slip_threshold_rpm, slip_throttle_reduction, slip_feedforward_gain)
    - controller.py: MotorDriver Protocol + NoopMotorDriver gain
    get_telemetry();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
    [test_speed_loop_and_slip.py, vesc.py]
2026-04-01 fix(vesc): correct STATUS_5 voltage byte offset and length check
    Observed VESC firmware sends 8-byte STATUS_5 frames with input_voltage
    at bytes [4:6], not [8:10]. The previous parser required len >= 10 and
    read from offset 8, which silently dropped every STATUS_5 frame and left
    pack_voltage_v = None indefinitely (low-voltage shutdown never triggered).
    Fix: len >= 6, read from offset 4.
    Also update voltage_shutdown_threshold_v from 22.4V (stale 5S LiPo value)
    to 42.0V for the confirmed 14S Li-ion pack (measured ~55V at ~74% SOC,
    i.e. 14 × 3.93V/cell; 42V = 14 × 3.0V/cell safe cutoff).
    [vesc.py]
2026-04-01 Enable Daly BMS with confirmed 13S pack config
    - Set BMS MAC address to 50:19:05:01:09:4E (JHB-50190501094E)
    - Enable BMS polling (bms_enabled = True)
    - Fix voltage_shutdown_threshold_v: 42.0→39.0V (13S×3.0V, not 14S)
    - Correct stale "confirmed 14S" comment — BMS reports 13 cells
2026-04-02 test: fix two pre-existing test failures uncovered by recent changes
    test_vesc_telemetry: _status5_frame() helper was placing voltage at bytes
    [8:10] (old layout). The e8d2697 fix moved the parser to read from [4:6],
    so update the helper to match (drop tach_abs) and update the short-frame
    guard test from 9 bytes to 5 bytes (< 6 is now the threshold).
    test_controller_obstacle.test_follow_me_uses_detections_not_rc: the test
    called ctrl.process() twice in rapid succession (< 1 ms real time), so the
    slew limiter (follow_me_accel_bps=200) allowed < 1 byte of ramp from neutral
    and the DriveCommand read back 126. Fix by mocking time.monotonic to advance
    1 s between the mode-entry call and the dete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
    [test_controller_obstacle.py, test_vesc_telemetry.py]
2026-04-02 docs(follow_me): add follow-me fix plan from log + CAN audit
    Six confirmed issues from arm_20260401_190138.log and live diagnostics:
    steer=0 during detection persistence, speed persistence gap, BMS FET
    14s delay, IMU fight artifact (log-only), and two logging artifacts.
    Priority-ordered fix plan with root-cause evidence and implementation notes.
2026-04-02 fix(follow_me): implement all 6 priorities from FOLLOW_ME_FIX_PLAN
    P1 (CRITICAL): Replace steer=0.0 on detection dropout with hold-then-linear-
    decay over steer_hold_decay_s (1.5s). Robot now maintains turn direction
    during brief occlusions instead of driving straight while person is 39° off-axis.
    - Add _last_fresh_steer / _last_fresh_steer_time to FollowMeController.__init__
    - Add steer_hold_decay_s: float = 1.5 to FollowMeConfig in config.py
    P2 (HIGH): Add "vesc" section to log_obj (left_rpm, right_rpm, speed_mps) and
    actual_speed_mps to the follow_me section. VESC telemetry was parsed and held
    in telem dict but never written to JSON log.
    P3 (HIGH): Warn (don't block) when B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
2026-04-02 fix(follow_me): Grok safety review — BMS FET timeout, speed-aware steer decay, state telemetry, IMU filter preservation
    1. BMS FET safety timeout (config.py, main.py)
    - Rate-limit discharge_fet_on=False warning to once/5s (was every tick)
    - Add BmsConfig.bms_fet_grace_period_s=20 + bms_fet_safety_timeout_s=2
    - After grace period, FET off >2s forces charger_inhibit → neutral + disarm
    - Track arm/disarm events; reset all FET state on each arm cycle
    2. Speed-aware steer hold decay (config.py, follow_me.py)
    - Lower default steer_hold_decay_s 1.5→1.0
    - effective_decay = decay_s * max(0.3, 1.0 - speed_factor): at max speed
    decays in 0.3s; at zero speed decays in full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
    [test_gesture_control.py]
2026-04-02 Trail follow fixes: prune optimisation, extrapolate, tangent, hysteresis
    - pure_pursuit: add last_closest_idx property (observability)
    - trail: add get_tangent_direction() and extrapolate() wrapper; prune()
    already uses while/popleft (O(k) prefix removal, returns count removed)
    - follow_me: adjust_for_prune() after every prune(), extrapolate once on
    first lost-target entry, trail-tangent search direction, 3-frame
    hysteresis before declaring trail exhausted; observability in get_status()
    - test: fix test_prune_behind_robot to reflect prefix-removal semantics
    (oldest/consumed points are at the front of the chronological deque)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
    [test_trail_follow.py]
2026-04-06 feat(safety): depth corridor hardening, YOLO stop-tier cutoff, OAK-D auto-recovery
    - config: min_depth_mm 600→350 (extended disparity floor), stale_policy→stop (fail-safe),
    safety_stop_radius_m=0.8, SafetyLayer accel cap + ghost config keys for future use
    - obstacle_avoidance: wire YOLO 'stop'-tier detections (person/animal <0.8m) → scale=0
    with latch; expose safety_force_stop in telemetry
    - oak_depth: mask followed-person bboxes from depth corridor so wall behind person is
    measured, not the person themselves; integrate safety-tier overrides into effective
    corridor distance; wrap pipeline thread in retry loop with exponential backoff (1s→30s)
    and expose pipeline_dead flag f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
    [oak_depth.py]
2026-04-06 feat(control): safety_state sync for gesture Follow-Me, VESC CAN failure detection, BMS FET all armed modes
    - controller: call safety_state.set_follow_me_active() on gesture activate/deactivate
    so SafetyLayer gets proper mode context
    - vesc: track consecutive CAN send failures; alert after 5 failures within 2s window;
    expose can_send_alert + can_send_fail_count in VescTelemetry; recover silently on success
    - main: expand BMS discharge-FET safety check from FOLLOW_ME-only to all armed modes;
    web viewer gating changed from oak_recorder to oak_reader (decouples viewer from recorder)
    [vesc.py]
2026-04-06 fix(video): reduce MJPEG latency — 320x240 @ quality 50, decouple viewer from recorder
    - oak_recorder: resize annotated RGB and depth frames to 320×240 before JPEG encode;
    drop quality 70→50 (RGB) and 60→50 (depth) to cut stream size and browser buffer lag
    - oak_viewer: guard all recorder references with 'recorder is not None' so web viewer
    serves live telemetry and placeholder frames even when OakRecorder is disabled;
    avoids crashing when recorder=None is passed
    [oak_recorder.py, oak_viewer.py]
2026-04-11 fix(bms): correct MOSFET status parsing and error command
    Bug 1: 0x93 response byte 0 is a mode enum, not a FET bitmask.
    Charge/discharge FET on/off booleans are at bytes 1 and 2.
    Bug 2: Error/alarm command was 0x97 (cell balancing status), should
    be 0x98 (protection status). Rewrite parser to decode the 0x98
    multi-byte alarm format with Level 1 (warning) vs Level 2 (trip)
    distinction per the Daly UART protocol spec.
    [bms.py]
2026-04-12 fix(bms): always select fff2 as TX characteristic, not fff3
    The Daly BMS exposes two writable characteristics under service 0xFFF0:
    fff2 (command TX) and fff3 (unused). _find_daly_chars() previously picked
    whichever writable char appeared first in the BLE iteration, causing
    intermittent connection failures when fff3 was enumerated before fff2.
    Fix: collect all write-capable characteristics, then select fff2 explicitly
    before falling back to the first available writable char.
    [bms.py]
2026-04-12 fix(bms): correct 0x98 alarm bit mapping — OVP/UVP were swapped
    The entire _DALY_0x98_ALARM_BITS table had the wrong bit order. The Daly
    Smart BMS protocol uses low bits for OVP and high bits for UVP within each
    byte (not high=OVP, low=UVP as previously coded). This caused bits 0 and 4
    (Cell OVP Warning + Pack OVP Warning at ~4165 mV / 99.7% SOC) to be
    mislabeled as UVP — which is physically impossible at full charge.
    Also corrects bytes 1-4: temperature byte was similarly bit-reversed;
    current/SOC alarms were at wrong byte offsets; short-circuit/IC-error/FET-
    lock were remapped to bytes 2-4 per the standard protocol layout.
    Verified against raw 0x98 response (byte[0]=0x11) cross-check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
    [bms.py]
2026-04-17 fix(oak_depth): corridor valid-% uses in-corridor pixel count, not full band
    The ground-plane trapezoid corridor mask was being compared against the
    full band rectangle instead of actual in-corridor pixel count, so the
    valid-% metric was artificially depressed and could falsely trip the
    min_valid_pct rejection threshold.
    [oak_depth.py]
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2026-04-17 feat(nav_ui): respect original image dimensions so robot marker lands at correct GPS position
    The /map/image endpoint downsamples large source images for bandwidth
    (property_map.jpg is 9512x15530 / 28MB; served as 4096x6687). It sets
    X-Original-Width and X-Original-Height response headers so clients can
    recover the true pixel dimensions.
    map_calibration.json's gps_to_pixel affine is fit in ORIGINAL-image
    pixel space. Previously initMap() used the downsampled naturalWidth/
    naturalHeight from a plain Image() tag and set Leaflet bounds to the
    served dimensions — so gpsToPixel() returned coordinates in a 9512x15530
    space while Leaflet interpreted them in a 4096x6687 space. The robot
    marker la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
    [waypoint_nav_ui.py]
2026-04-17 fix(nav): expose waypoint progress in SSE, populate bearing/distance, relax start preconditions
    - waypoint_nav: get_status() now returns the live bearing/distance from the
    last compute() call instead of always 0.
    - oak_recorder/main/oak_viewer: thread wp_index/wp_total/wp_name/wp_bearing_deg/
    wp_distance_m/wp_completed through RecordingTelemetry to /api/telemetry so
    the /navigate UI can actually render waypoint progress, the active-target
    highlight, and the progress line.
    - waypoint_nav_ui: /api/nav/start only requires calibration when a waypoint
    lacks lat/lon; UI + server minimum is now 1 waypoint (enables single-tap
    goto, which is the described end-to-end use case).
    Co-Authore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
    [oak_recorder.py, oak_viewer.py, waypoint_nav_ui.py]
2026-04-17 fix(nav_ui): allow fitBounds to zoom out for 9512x15530 map, harden robot marker
    After commit 5dcd3a7 switched bounds to original-image space (9512x15530),
    fitBounds() on a phone needs zoom ~-4.9 to show the whole image. minZoom=-3
    (scale 1/8) clamped the view to a 1189x1941 center crop — which on a portrait
    phone screen showed only a horizontal slice through the middle of the map.
    That's what the user perceived as a "90-degree rotation", and the robot marker
    (image pixel y ~3325, i.e. 21% up from the bottom of the 15530-tall bounds)
    fell outside the clipped viewport so appeared "missing".
    - Lower minZoom to -6 so fitBounds can fit the full portrait image on any
    phone viewport, restorin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
    [waypoint_nav_ui.py]
2026-04-17 fix(nav_ui): flip Y-axis so image-file pixel coords match Leaflet CRS.Simple
    In CRS.Simple with bounds [[0,0],[imgH,imgW]], imageOverlay draws the image
    with its TOP-LEFT pixel at NW = (lat=imgH, lng=0) — so an image-file pixel at
    (px, py) corresponds to latlng (imgH-py, px), not (py, px).
    The UI was treating py as lat directly, so the robot marker (rover pixel
    x=713, y=3325 — near the house in the upper-left of the map) landed at Leaflet
    lat=3325, which is screen-y = imgH-3325 = 12204 from the top — i.e. near the
    bottom of the 15530-tall image, where the bottom sheet overlay then hid it.
    All waypoint/polyline/draw/click handlers had the same inversion so were
    self-consistently in the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
    [waypoint_nav_ui.py]
2026-04-18 fix(nav): pivot in place on large heading error to prevent donut driving
    Waypoint nav used to command full cruise speed regardless of heading error.
    With a large error (e.g. 90°) the IMU compensator's ±25-byte correction
    differential on top of a forward base produced a wide circular arc that
    never converged — the "donut" failure seen when the robot was armed for a
    10-ft westward hop.
    - WaypointNavConfig: add pivot_heading_error_deg (25°) and align_heading_
    error_deg (8°). Above pivot → speed=0. Below align → full speed. Linear
    ramp between.
    - WaypointNavController.compute() accepts optional current_heading_deg and
    applies the gate via _gate_speed_by_heading().
    - Controller f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
    [test_waypoint_nav.py]
2026-04-18 fix(nav): drive direct high-differential pivot instead of ±25 correction
    After the first fix, logs showed corr_applied saturating at -25 while the
    robot still arced: heading=308° drifted to 305° over multiple cycles while
    distance dropped 3.04m→2.66m. The compensator's ±25 cap plus VESC motor
    deadband produces asymmetric, weak counter-rotation — one wheel barely
    moves, the other goes forward, so the net motion is a slow arc, not a pivot.
    Instead of riding on the compensator correction when speed is gated to 0,
    compute the signed heading error in the controller and command motors
    directly with ±pivot_speed_byte (default 60) — well clear of the deadband.
    Suppress imu_correction for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
2026-04-18 refactor(nav): state-machine + command-space waypoint navigation
    Replace the byte-additive pivot hack with an IDLE/ALIGN/DRIVE/ARRIVE state
    machine. waypoint_nav.compute() now returns normalized (v_cmd, yaw_cmd, state);
    a deadband-compensated mix_to_bytes() converts those into motor bytes so a
    non-zero command always clears the motor deadband.
    - ALIGN pivots at a fixed normalized yaw until |heading_err| < align_threshold.
    - DRIVE follows a distance-based forward profile; falls back to ALIGN if the
    error exceeds recovery_threshold.
    - Speed-gating helper, direct-pivot branch, and pivot_speed_byte knob are
    gone; the state machine owns transitions.
    - ImuSteering.set_target_heading() now onl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
2026-04-18 fix(nav): obstacle avoidance no longer mangles pivot into left-hand circles
    Root cause of the "left-hand circles" bug: during waypoint nav ALIGN state,
    the mixer correctly emits a pure pivot (L=62, R=190). But the obstacle
    avoidance post-processor treated the pivot as "forward motion" because
    `is_forward_motion = left > 126 or right > 126` is true for any pivot with
    the right track forward. When depth dropped below threshold, it scaled both
    bytes toward neutral, collapsing the pivot asymmetrically to values like
    (L=113, R=139) — just barely above motor deadband. Real-world track response
    at that level favours the forward motor over the barely-reversed one, so the
    robot translates forward w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
2026-04-18 fix(nav): flip ALIGN pivot yaw sign to match physical robot
    ALIGN state was open-loop pivoting the wrong direction, so heading error
    grew instead of shrinking and the state machine never reached DRIVE.
    Follow Me masked this because its yaw is closed-loop on visual x-offset
    and self-corrects; waypoint nav's open-loop compass pivot does not.
    Log evidence: heading error grew 14.6° -> 22°, and yaw_rate_dps had the
    same sign as wp_heading_error_deg (they should be opposite).
2026-04-18 feat(nav): GPS course-over-ground auto-aligns IMU heading in waypoint nav
    OAK-D Lite has no magnetometer, so gyro-integrated heading is relative
    to startup orientation and drifts over time. Waypoint nav now learns
    the offset between raw IMU heading and true (GPS) north while driving
    and continuously corrects for gyro drift — fully transparent.
    - While in DRIVE, buffer GPS fixes (rolling window, default 4s).
    - Once we've displaced >=2m above 0.3 m/s, compute GPS course-over-ground
    and set heading_offset = cog - imu_heading (first sample locks, EMA
    refines thereafter).
    - State machine uses (raw_imu + offset) for heading-error decisions.
    - Controller feeds the PID a target of (bearing -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
    [oak_viewer.py]
2026-04-18 docs: audit and update — CLAUDE.md, IMU hardware facts, waypoint nav, known issues
    - Create CLAUDE.md: architecture overview, subsystem notes, IMU/OAK/nav/BMS
    details, known issues, and branch state for AI-assisted development
    - imu_steering.md: correct stale hardware claims — OAK-D BMI270 is gyro+accel
    only (no magnetometer), heading is relative to startup orientation, not north;
    magnetometer disabled by default; external I2C breakout is optional
    - README.md: add waypoint nav state machine section, GPS COG in-progress note,
    Known Issues section (VESC 0 RPM, IMU drift)
    - TODO.md: add VESC telemetry RPM=0 as known issue; fix stale path reference
    - performance_optimization_todo.md: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
2026-04-18 fix(nav): correct heading-offset EMA wrap, wire offset fields into SSE
    1. EMA wrap in WaypointNavController._update_heading_offset: the previous
    (x % 360) + one-sided clamp only normalized positive deltas correctly.
    Use the standard ((x + 180) % 360) - 180 form so negative updates land
    in (-180, 180] as intended.
    2. Forward wp_heading_offset_deg and wp_heading_offset_locked through the
    telemetry pipeline (controller -> RecorderTelemetry -> oak_viewer SSE
    + main.py SSE) so the dashboard can display whether the offset has
    locked and its current value.
    [oak_recorder.py, oak_viewer.py]
2026-04-18 refactor(nav): move GPS heading alignment out of waypoint_nav
    The GPS course-over-ground heading aligner was bolted onto
    WaypointNavController, so Follow Me and manual driving couldn't benefit
    from it even though they have the same gyro-drift problem. Extract it
    into a standalone GpsHeadingAligner, own it in Controller, and run it
    every tick regardless of mode. waypoint_nav now just consumes an
    already-corrected heading.
    - New pi_app/control/gps_heading_align.py: stateless correct() /
    imu_target_heading() for consumers; update() self-gates on fix
    quality, displacement, and speed.
    - GpsHeadingAlignConfig moves to top-level config; gps_align_* removed
    from WaypointNavConfig.
    - Controlle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
    [oak_recorder.py, oak_viewer.py]
2026-04-18 feat(nav): heading-aligner observability + DGPS gate
    The aligner was effectively invisible in journalctl — offset/locked
    fields only made it to the structured JSON log — so a session without
    RTK looked identical to a broken aligner.
    - config.GpsHeadingAlignConfig.min_fix_quality 4 → 2. DGPS (~2 m CEP)
    is fine given the 2 m displacement + 0.3 m/s speed gates already
    guard against noise. Sessions that never see RTK can now calibrate
    from manual driving.
    - Heartbeat line gains HDG_OFF(+XX.X° L|-) so aligner state is at a
    glance in journalctl. When mode != MANUAL, also append nav=STATE and
    mot(L=N R=N) so ALIGN/DRIVE transitions and the pivot actually
    reaching the motors are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
2026-04-18 revert(nav): keep min_fix_quality at RTK-fixed (4)
    DGPS-quality heading calibration isn't trustworthy enough to keep.
    Reverting the gate to RTK-only; heartbeat/lock-log observability from
    8fc8076 stays.
2026-04-18 Add GET /api/gps and POST /api/nav/go endpoints
    Enables sending WALL-E to a GPS waypoint from SSH or API without the
    map UI. /api/nav/go accepts absolute lat/lon or a relative offset
    (direction + distance_ft, or bearing_deg + distance_ft). /api/gps
    returns current fix, satellites, hdop, and RTK correction age.
    [waypoint_nav_ui.py]
2026-04-19 feat(robot): unify autonomy control and harden operator telemetry
    Consolidate shared drive/autonomy paths, expand waypoint mission UI, and stabilize camera/IMU/VESC observability so manual and autonomous operation are safer and easier to diagnose in the field.
    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
    [oak_depth.py, oak_imu.py, oak_recorder.py]
2026-06-11 Fix #1 — gate calibration wizard on armed state, run update_safety unconditionally
    The calibration routines drive the motors directly (motor.set_tracks),
    bypassing the normal command path. Two problems made this unsafe:
    * controller.process() returned early for calibration mode BEFORE
    update_safety() ran, so RC ch5 e-stop and ch3 disarm did nothing while
    calibrating.
    * the /api/cal/start endpoint was unauthenticated and ungated, so two LAN
    POSTs could spin the wheels regardless of arm state.
    * controller.py: move the calibration early-return to AFTER update_safety()
    so safety (RC-stale disarm, ch3 disarm, ch5 e-stop) runs every tick. In
    calibration mode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
    [calibration_wizard.py, test_calibration_wizard.py, test_controller.py]
2026-06-11 Fix #2 — initialize telemetry dict to prevent UnboundLocalError on follow-me with no target
    When ch4 (follow-me) is flipped while armed with no person in frame,
    update_safety emits FOLLOW_ME_ENTERED; controller.process() then takes the
    "no target" branch and writes telemetry["follow_me_activation_blocked"]. But
    the telemetry dict was not created until further down the function, so that
    write raised UnboundLocalError, killing the control process and dropping all
    authority over the motors.
    Initialize `telemetry = {}` right after update_safety (before any event
    handler can touch it) and reuse it for the later mode assignment instead of
    recreating it (which would have discarded the event-hand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
    [test_controller.py]
2026-06-11 Fix #3 — wire YOLO safety detections into the main tick (person-stop tier)
    ObstacleAvoidanceController.set_safety_detections() implements a "stop" tier
    that force-stops forward motion when a person/animal is within
    safety_stop_radius_m (0.8 m), but it was never called with live YOLO output,
    so the tier was dead code.
    Feed oak_reader.get_all_detections() to obstacle_ctrl.set_safety_detections()
    once per tick in the main loop, right after the depth obstacle update. Gated
    by a new config flag obstacle_avoidance.yolo_safety_enabled (default True) so
    it can be disabled if it false-stops.
    Tests (test_obstacle_safety_tier.py): the latch fires only for a stop-tier
    detection inside the radius, th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
    [test_obstacle_safety_tier.py]
2026-06-11 Fix #3 (revise) — consolidate person-stop to the depth-poll path; remove unused latch
    Per review: the YOLO person/animal stop tier already runs in the live tick via
    the depth poll — a "stop"-tier detection within safety_stop_radius_m forces the
    reported min_distance to 0 (oak_depth.poll_depth), which flows through
    get_min_distance() -> compute_throttle_scale() -> 0.0. The separate
    ObstacleAvoidanceController.set_safety_detections() latch I wired in 59c71c4 was
    a second, redundant mechanism. Kevin's call: keep ONE clear stop tier.
    * controller/obstacle_avoidance.py: delete the unused set_safety_detections()
    latch (it had no callers before 59c71c4), its _safety_force_stop state, the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
    [oak_depth.py, test_obstacle_safety_tier.py]
2026-06-11 Follow-me: disable velocity PID + add host-side IoU/Kalman tracklet layer
    Part A — velocity PID off (config.py FollowMeConfig):
    Zero speed_kp/ki/kd. The wheel-RPM telemetry feeding the closed speed loop is
    dead/unreliable, so the PID integrated garbage and produced the lunge/stall
    cycle. With all three gains zero, PIDController.compute() returns 0.0 (p+i+d all
    collapse; no divide-by-gain — verified read-only in follow_me.py), so
    SpeedLayer.compute() cleanly falls back to the open-loop throttle-vs-distance
    mapping. No controller.py change needed.
    Part B — host-side tracklet layer (pi_app/hardware/oak_depth.py):
    Add a pure-numpy constant-velocity Kalman + greedy-IoU tracker (Tracklet /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
    [oak_depth.py, test_tracklet_tracker.py]
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2026-06-11 fix: DepthFilter rejection latch — reseed after 5 consecutive rejections and on target switch
    [test_depth_filter_latch.py]
2026-06-11 fix: PID dt measures time since last compute, not last output
    [test_pid_dt.py]
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2026-06-11 feat: fm_score trial cost function
    tools/fm_score.py reduces a Follow-Me trial-recorder JSONL to a single scalar
    cost J (lower = better) for the auto-tuner to minimise:
    J = 1.0*sum(x_err^2 dt) + 0.1*sum((d_steer_norm/dt)^2 dt)
    + 0.5*max(0, zero_crossings - direction_changes) + 50.0*lost_track
    Tracking-error and steering-thrash terms are scored over direct-pursuit ticks
    only (pp not scored); the hunting term counts filtered-error zero-crossings
    beyond those explained by the 1s-smoothed signal's genuine direction reversals;
    lost_track flags any "lost"/"search" tick. Weights documented as constants.
    Robust to empty/single-line files and skips malformed lines. stdlib + numpy
    only. CLI pr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
    [fm_score.py, test_fm_score.py]
2026-06-11 feat: fm_autotune GP-BO ask-tell loop + docs
    tools/fm_autotune.py: human-in-the-loop Gaussian-process Bayesian optimiser for
    the five Follow-Me steering params. Each iteration asks skopt for a candidate,
    POSTs it to /api/follow_me/params, prompts the operator to walk a fixed pattern,
    finds the newest trial JSONL, scores it via fm_score, and tells the optimiser.
    Trial 1 is seeded with the shipped config values. Lost trials score normally
    (+50); missing/empty trial files get a fixed J=100 penalty. State is persisted
    after every trial for --resume (re-tells all recorded points). On completion it
    prints the recommended params and the exact config.py lines to make them
    permanent.
    Safety: only ev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
    [fm_autotune.py, test_fm_autotune.py]
2026-06-11 feat: teleop session manager + server-side deadman watchdog
    New pi_app/web/teleop.py: a fail-safe phone-teleop core that slots UNDER
    existing RC authority. TeleopSession is a Flask-free state machine (arm
    ceremony, latched e-stop, speed cap, stale/out-of-order guard) plus a 50 Hz
    watchdog thread that is the SOLE writer to the motor command sink. Every tick,
    if armed and the heartbeat is older than 250 ms, it forces neutral and disarms
    the session — so a dropped wifi link, slept phone, or killed WS handler all hit
    the same stop path. RC ch3 disarm / ch5 e-stop (read via rc_state_provider)
    override phone state every tick. Production sink writes the same
    /tmp/wall_e_bt_latest.json override fi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
    [teleop.py]
2026-06-11 feat: /drive minimal phone UI + WS heartbeat/drive protocol
    Wire the fail-safe teleop into the web viewer (additive only — one block in
    OakWebViewer._run alongside the existing calibration/map/nav blueprints):
    instantiate the TeleopSession with the file sink and a recorder-backed
    rc_state_provider, register the /drive page, the /ws/drive WebSocket, and the
    REST mirror, and start the deadman watchdog thread. No existing route or
    behavior changed. /drive serves a minimal phone-first UI (press-and-hold ARM,
    big-red E-STOP, slow/normal/fast caps, two touch-zone tracks, plain-text status
    with arm/deadman/RTT/speed/battery). Optional shared-token auth via
    WALL_E_TELEOP_TOKEN.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
    [oak_viewer.py]
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2026-06-11 feat: /drive polished joystick UI + HUD + e-stop + PWA
    Tranche 2 UI overhaul — replaces minimal tranche-1 HTML with a
    game-controller-grade dark UI. All safety semantics unchanged.
    Layout (portrait-first, iPhone safe-area aware):
    - HUD bar (top): connection dot w/ live pulse, RTT chip, arm badge
    (ok/bad/warn), battery V, speed cap %, deadman age, RC state chips
    - Speed segmented control: SLOW | NORMAL | FAST
    - E-STOP: full-width red button, 2-step dismiss for latched state
    - ARM row: press-and-hold with radial progress ring (rAF, 520 ms),
    haptic on arm success, RC-in-hand checkbox
    - Joysticks (thumb zone, bottom half): two virtual pads, spring-return
    knob (CSS cubic-bezier spring),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
    [teleop.py]
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2026-06-11 fix: wire FM trial recorder rotation into mode transitions; record is_armed + output bytes
    stop_recorder() was dead code (audit finding on 857fced): the JSONL
    recorder opened one file per process, never per session. Now
    start_recorder()/stop_recorder() are called at every FOLLOW_ME
    entry/exit site in controller.py (web API, RC ch4 event, gesture,
    emergency). Each record additionally carries is_armed and the final
    mixed left_byte/right_byte. Additive only — fm_score.py field names
    unchanged; safety-fix lines in controller.py untouched.
    Tests: rotation, unwritable dir, new fields (8 new, 54 total green).
    [test_follow_me.py]
2026-06-11 fix: empty depth corridor on a fresh frame is 'clear', not 'stale'
    _poll_depth early-returned without updating _depth_state.timestamp
    when the corridor had no valid pixels, so get_min_distance() age grew
    and the staleness tier fired on open ground. Now a fresh frame with an
    empty corridor (and no safety-tier person) stores min_distance=inf
    with a fresh timestamp. True frame loss still goes stale exactly as
    before; _apply_safety_tier_override is unchanged and still runs first.
    get_status() sanitizes non-finite distance to None so SSE/MCAP/CSV
    JSON never sees Infinity.
    Tests: 14 new in test_depth_corridor_stale.py incl. person-stop
    dominance on empty corridor.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
    [oak_depth.py, test_depth_corridor_stale.py]
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2026-06-11 safety: teleop hardening — real ch5 e-stop path, staleness bound, driver lock, gated e-stop clear, token auth
    Audit of e2cc241..f05567f found the rc_state_provider read a
    nonexistent RecordingTelemetry.emergency_active (RC ch5 never reached
    the session) and no staleness bound on telemetry. RecordingTelemetry
    gains emergency_active + ts_mono (populated additively in main.py);
    provider fail-safes to disarm on >1s-stale telemetry, None only when
    no source ever existed (bench mode).
    Also: single-driver lock (second phone cannot drive/arm an armed
    session; e-stop accepted from any client; lock clears on disconnect/
    deadman/disarm/estop), e-stop clear now requires an observed RC ch3
    cycle when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
    [oak_recorder.py, teleop.py, test_teleop.py]
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2026-06-11 fix: vesc_rpm_bench needs repo root on sys.path when run as a script
    ModuleNotFoundError on the Pi when invoked as python3
    tools/vesc_rpm_bench.py — the mocked tests run from repo root and
    could not catch it.
    [vesc_rpm_bench.py]
2026-06-11 feat: vesc_rpm_bench refreshes RPM command each tick; steady-state verdict
    First real run (2026-06-11, wheels off ground) proved ERPM telemetry
    works (+1500 commanded, ~1460-1500 reported, 298 pkt-9 frames, zero
    parse errors) but motors stopped at t~1.1s: the script sent the
    command once and the VESC firmware ~1s command timeout kicked in.
    Now the command is re-sent on every 10 Hz sample tick (cmd_tx column
    proves it) and the verdict reports mean steady-state ERPM error per
    side over t>0.5s.
    [test_vesc_rpm_bench.py, vesc_rpm_bench.py]
2026-06-11 docs: VESC RPM known-issue resolved — bench proves ERPM telemetry works
    2026-06-11 hardware bench: -1.0%/-0.4% steady-state error at +1500
    ERPM, zero parse errors. Also documents the confirmed ~1s VESC
    firmware command timeout.
2026-06-11 test: un-rot waypoint nav suite — pin e4cbfd0 state-machine behavior (15 fixes)
    All 15 long-standing failures were stale tests written against the
    pre-e4cbfd0 API: compute() now returns (v_cmd, yaw_cmd, state) floats
    instead of (bearing, speed_byte); pivot/align config fields renamed to
    recovery_threshold_deg/align_threshold_deg; speed ramp replaced by the
    binary ALIGN/DRIVE machine. No production code touched. RTK>=4 gate,
    stale-GPS halt, and heading gating are now correctly pinned, including
    the conservative no-heading->ALIGN behavior.
    [test_safety_and_waypoint_fixes.py, test_waypoint_nav.py]
2026-06-11 test: fix TestControllerFollowMe for the no-target engagement gate (4 fixes + 1 new)
    Tests flipped ch4 high without registering a person, so the a1bbe22-era
    'no Follow-Me entry without a target' safety gate correctly refused
    activation and the old assertions failed. Tests now inject a fake
    target first, and a new test pins the gate itself
    (follow_me_activation_blocked=no_target). No production code touched.
    [test_controller_obstacle.py]
2026-06-11 test: pin current OAK-IMU yaw API and corrected Daly BMS decode (6 fixes)
    oak_imu: _compute_yaw_rate_rads gained source/auto_axis params and the
    accel-invalid fallback moved to gy (camera-frame yaw) in dbef18a.
    bms: tests pinned the OLD wrong FET bit mapping; bms.py was fixed
    (cb8d2f6/b3718aa) to read charge/discharge as plain booleans at p[1]/
    p[2] and voltage alarms from buf[0] — tests now pin the corrected
    decode (matches the 2026-04-10 OVP debugging findings).
    No production code touched.
    [test_bms.py, test_oak_imu.py]
2026-06-11 feat: OAK USB auto-reconnect supervisor — no more service restarts on camera drop
    Root cause of the known issue: each _poll_* swallowed ALL exceptions,
    so an X_LINK communication error raised inside a poll was eaten and
    the session loop spun forever without ever reaching the rebuild path.
    Fatal comm errors (X_LINK/communication/device-closed markers) now
    re-raise; _run_pipeline is a supervisor that closes the device, backs
    off 2s/5s/10s (interruptible by stop()), waits for re-enumeration,
    and rebuilds. Depth timestamps are NOT refreshed during an outage, so
    the staleness fail-safe still halts autonomous motion. get_health()
    adds connected/reconnect_count/last_disconnect_ts. Safety tier and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
    [oak_depth.py, test_oak_reconnect.py]
2026-06-11 feat: optional camera feed in /drive — WS binary JPEG frames (item F complete)
    /ws/camera pushes binary JPEGs at a soft 8 fps with frame-skip
    backpressure (no queue build-up = no MJPEG-style multi-second phone
    buffering). Token-gated like /ws/drive; REST fallback
    /api/teleop/camera/frame; CAM toggle default OFF; frame source is
    recorder.get_latest_annotated_jpeg passed via a backward-compatible
    register_teleop kwarg. Control WS and deadman untouched. 8 new tests.
    [oak_viewer.py, teleop.py, test_teleop.py]
2026-06-11 fix: clean BMS BLE teardown — cancel the poll task instead of stopping the loop
    stop() called loop.stop() under a running coroutine, so every service
    stop logged 'BMS event loop exited unexpectedly' + RuntimeError and a
    GC'd un-awaited coroutine. Now stop() cancels the tracked poll task
    via call_soon_threadsafe; _run_loop handles CancelledError as a clean
    exit. Polling/reconnect/fail-open behavior unchanged. 2 new tests.
    [bms.py, test_bms.py]
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2026-06-11 fix: camera feed registers as RGB preview client so frames actually exist
    Live deploy found /api/teleop/camera/frame returning 503: OakRecorder
    only generates preview JPEGs while a stream client is registered
    (set_stream_client_connected gate). The teleop WS and REST camera
    paths now register/unregister exactly like /stream/rgb does (REST
    polls up to 0.8s for the first frame). Hook errors can never kill the
    socket or the endpoint. 4 new tests.
    [oak_viewer.py, teleop.py, test_teleop.py]
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2026-06-11 fix: stand test samples motor bytes after the output slew settles
    First hardware run: bytes read 135/135 one frame after e-stop (the
    controller's output slew mid-decay), 126/126 settled — by-design
    deceleration ramp, not a held command. Sample at +0.8s.
    [teleop_stand_test.py]
2026-06-11 feat: one-thumb arcade drive — single stick replaces tank joysticks
    Kevin's field feedback after tonight's stand+ground testing: one
    finger, not two sticks. Single centered pad; client-side arcade mix
    (throttle=-y, steer=x, STEER_GAIN=0.8, clamp ±1) feeding the
    unchanged tank WS protocol — zero server/safety changes. Stick zeros
    on pointerup/cancel, visibilitychange, pagehide, and E-STOP press.
    [teleop.py]
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2026-06-13 fix: disable slip-comp steer feed-forward (gain 0.02->0.0) — Follow-Me steer runaway
    Root cause of the 2026-06-13 'overshot and wouldn't drive forward'
    Follow-Me session (fm_trials/1781382327.jsonl, 780 ticks):
    _apply_slip_compensation is a no-op when VESC RPM is unavailable. RPM
    read 0 for this robot's whole life, so the path NEVER ran until RPM
    telemetry was fixed today — then it went live and ran a positive-
    feedback steer runaway. On a skid-steer robot any turn IS an rpm
    differential, so steer_correction=(L-R)*gain injects more steer ->
    bigger differential -> clamps to the global +-25 (bypassing the direct
    path's 18 cap, which is why records showed steer=25 on direct ticks).
    It pinne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
2026-06-13 feat: flight-recorder honesty + correct (disabled-by-default) slip detector
    Recorder honesty (so the next Follow-Me walk is diagnosable):
    per-tick records now carry steer_want (what the branch wanted, pre-slip
    pre-slew), steer_src (direct/trail/search/persist/lost — distinguishes
    a persistence hold from a true lost, which the old 'mode' conflated),
    slip_active, emitted (true only on 15 Hz output-gate ticks — filter to
    dedupe the 32 Hz vision double-writes), and rpm_l/rpm_r (actual eRPM —
    their absence is exactly why the 2026-06-13 slip runaway needed a live
    bench to diagnose). All legacy keys unchanged; fm_score.py uses .get().
    Slip detector rewrite (correct algorithm, OFF by default)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
    [test_follow_me.py, test_speed_loop_and_slip.py]
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2026-06-13 feat: edge-boosted steering gain — recover targets drifting to the frame edge
    Walk fm_trials/1781386838 lost the person laterally: they drifted to
    x_filt +-0.9 (frame edge) while steering only used +-8-12 of its 18-byte
    authority. The morning anti-oscillation tune (kp 0.8->0.4) is gentle at
    center (good) but too soft to recenter an edge target before it exits
    the FOV. Edge-boost amplifies the lateral error by (1 + steer_edge_boost
    * ramp) only above |x|=steer_edge_knee, so center behavior is exactly
    unchanged (gain==1.0 below the knee) and the PID reaches full authority
    sooner at the edge. Direct path only; deadband, the 18-byte cap, slew
    cap, and confidence scaling all preserved. Recorder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
    [test_follow_me.py]
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2026-06-14 feat: edge/width/height detection filter — reject edge slivers + short ground blobs
    Video analysis of the 'chicken' run (MCAP 20260613_165957) corrected
    the diagnosis: the robot did NOT misclassify a chicken. After losing
    the tracked person, YOLO confidently (0.90-0.92) boxed a CLIPPED SLIVER
    of the person at the right frame edge (xmin 0.90-0.94, width 0.06-0.10)
    and re-acquired it as a new target. The chickens were never boxed; one
    real short blob (impl height 0.68m) was correctly ignored.
    DetectionFilter (Layer 1) gains three geometric rejections, each
    config-gated (<=0 disables): edge exclusion (reject xmin>1-margin or
    xmax<margin; margin 0.15), min bbox width (0.09), min implied physi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
    [test_follow_me.py]
2026-07-05 chore: test real serializers not mirrors; refresh stale docs/comments
    - Extract sse_detection_dict() (oak_viewer.py) and mcap_detection_dict()
    (oak_recorder.py) as pure module-level functions; test_tracklet_tracker.py
    now imports and calls the real production serializers instead of
    hand-maintained local mirrors that could silently drift from prod.
    - TODO.md: mark VESC RPM-stuck-at-0 issue resolved (bench-verified
    commit 8e0d6ee; live vesc_rx_frame_count climbing, 0 parse errors),
    add follow-ups for real-drive RPM confirmation and velocity-PID
    re-enable decision.
    - docs/services.md: run_main.sh no longer passes --pid-debug (dropped
    in 5c1aa52); doc now matches `exec python3 -u -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
    [oak_recorder.py, oak_viewer.py, test_tracklet_tracker.py]
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2026-07-05 fix: debounce BMS is_charging to kill charger-inhibit motor cutout + surface charger_inhibit in telemetry/logs
    Root cause (2026-06-13 16:13:31 field log): a single spurious +1.3A pack-current
    poll during a full-speed FOLLOW_ME chase made is_charging() true for a full
    ~8s poll interval (BMS holds readings between polls), latching charger_inhibit
    and forcing the motors to neutral mid-chase. A momentary positive-current blip
    on a near-full pack (regen/noise) is not a charger being connected.
    - bms.py: is_charging() now requires pack current above
    charge_detect_min_current_a (default 2.0A) on >=2 consecutive successful
    polls (charge_detect_min_consecutive_polls) before reporting True. Any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
    [bms.py, oak_recorder.py, oak_viewer.py, test_bms.py]
2026-07-05 safety: gate /api/cal/start and /api/nav/skip behind session e-stop
    QA follow-up on the same wave1/web-surface hardening, reusing the estop_check
    pattern from the prior commit:
    - create_calibration_blueprint gains an optional estop_check callable
    (default None = ungated, back-compat). /api/cal/start now refuses 409 while
    the /drive TeleopSession e-stop is latched — calibration drives the motors
    directly, so a latched driver e-stop must block a run. The existing arm-gate
    (400) is kept; the e-stop check runs first.
    - /api/nav/skip now refuses 409 while latched, for consistency with
    /api/nav/start and /api/nav/go (advancing the target index under a latched
    e-stop would redirect m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
    [calibration_wizard.py, oak_viewer.py, test_calibration_wizard.py, test_teleop.py, waypoint_nav_ui.py]
2026-07-05 fix: per-motor VESC staleness + live open-loop fallback + contain CAN OSError/RX-thread death
    get_telemetry() returned non-None as soon as EITHER motor had ever reported
    RPM (per-motor rpm fields were never reset), making the controller's
    "stale telemetry -> open-loop" elif permanently dead code -- a dead RX
    thread or one silent VESC just froze stale numbers that every consumer
    (speed layer, slip detector) trusted as fresh.
    - vesc.py: add left/right_status_age_s (per-motor STATUS(9) frame age) and
    rx_thread_alive to VescTelemetry/get_rx_health(), computed in
    get_telemetry() from each motor's last_status_s.
    - controller.py: rewire the fallback inside the `if _telem is not None:`
    branch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
    [test_speed_loop_and_slip.py, test_vesc_telemetry.py, vesc.py]
2026-07-05 fix: slew-cap the FM lost/search path + kill phantom/dead steer config knobs
    Problem 1 (steer discontinuity): the per-tick steer slew cap
    (steer_slew_per_tick) was applied ONLY in the target-present branch of the
    emission gate in follow_me.py. Lost/search steer bytes bypassed the gate
    entirely via _handle_lost_target() returning pre-mixed motor bytes directly,
    and _last_emitted_steer was force-reset to 0.0 on every lost/search tick. This
    let SEARCH snap steering 0->±search_cap bytes in one 15Hz tick, and made
    reacquisition slew from a false 0 instead of the real last-commanded steer.
    Fix: _handle_lost_target() now returns (speed, steer) instead of motor bytes;
    compute() routes ALL branches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
    [follow_me_calibration.py, test_follow_me.py]
2026-07-05 fix: UPS AC-detection keyed on charger voltage + debounce (stop false shutdown-countdown flapping)
    The live upsplus-power.service daemon (not previously in the repo) inferred
    AC presence from INA219 battery current sign, which flaps every 1-2 minutes
    on a topped-off pack during normal charge-taper cycling even though the
    charger stays physically connected the whole time (typec/microusb voltage
    holds ~4.7-5.1V throughout). Each flap armed a 30s shutdown-countdown grace
    window that only survived by luck, cancelling ~8-9s later; a sustained load
    or longer taper window would have falsely shut down the Pi while on AC power.
    Brings the daemon under version control at scripts/upsPlus_power_daemon.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
    [test_ups_ac_debounce.py, upsPlus_power_daemon.py]
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2026-07-10 feat: UPS daemon detect-only mode — full detection chain without shutdown actions
    Adds a bench-test mode (--detect-only flag OR UPS_DETECT_ONLY=1 env var) that
    runs the entire AC-loss detection/debounce/grace chain identically to armed
    mode but suppresses every shutdown action at its own call site: stop wall-e,
    shed USB, UPS shutdown-countdown register write, and sync/shutdown. Also skips
    the two startup UPS register writes so the mode is strictly read-only against
    hardware. At grace expiry it logs a single unmistakable suppression line and
    keeps monitoring, so unplug/replug cycles are repeatable without a restart.
    Normal-mode behavior is unchanged (default path untouched beyond guard hook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
    [test_ups_ac_debounce.py, upsPlus_power_daemon.py]
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2026-07-10 docs: correct detect-only warning — 2026-07-10 shutdown was the VESC low-voltage watchdog (main battery switched off), not the UPS cell cutoff
2026-07-10 fix: VESC low-voltage watchdog — plausibility floor + 30s sustain, no OS shutdown (per Kevin's spec)
    The 2026-07-10 incident: main battery switched OFF while the Pi ran on its
    separate UPS. As the VESC caps drained a STATUS_5 frame reported 6.80V; the
    old watchdog saw 6.80 < 39.0V and, after 10s, ran `sudo shutdown -h now`,
    killing the Pi. The watchdog predates the UPS (written when the Pi was powered
    FROM the main pack). A 13S pack's BMS hard-cuts ~37.7V, so any reading far
    below that is switch-off cap drain or sensor garbage, not a dying pack.
    New behavior (early warning + motor cutoff ONLY — the OS-shutdown path is gone):
    - Plausibility floor (voltage_shutdown_floor_v, default 30.0V)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
    [oak_recorder.py, oak_viewer.py, test_vesc_telemetry.py, vesc.py]
2026-07-10 test: fix flaky trail-pursuit budget test with virtual clock
    test_trail_pursuit_hard_stops_at_3s built its 15-iteration trail on real
    time.monotonic() while feeding fake pose timestamps, so under CPU load a
    slow iteration could exceed target_persistence_s (0.5s), drop the tracker
    into the lost path mid-build, and corrupt _last_valid_time/the trail
    (~3% flake). Patch pi_app.control.follow_me.time during the build loop
    too, advancing a controlled clock in 0.1s steps so poses and compute()
    share one deterministic timeline. Assertions unchanged.
    Verified: 30/30 isolated runs and 15/15 runs under 4-core CPU load pass.
    [test_blind_pursuit_budget.py]
2026-07-10 fix: controller observes VESC pack-low latch — prevent lurch-on-release; pin latch-survives-dropout
    QA follow-up to bfc9662. The pack-low latch was enforced only inside the
    driver's set_tracks(), invisible to the controller: while latched, the
    controller's slew state (_slew_last_left/right) kept ramping toward the
    commanded value, so the instant the latch cleared at ~41V mid-command the
    fully-ramped bytes were emitted in one tick — a full-speed lurch on a 40kg
    robot.
    Fix: while self._vesc_pack_low_latched is true, the controller forces neutral,
    calls _motor.stop(), and _reset_slew_state() every loop — an exact mirror of
    the adjacent charger_inhibit block. On release the output now ram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
    [test_controller.py, test_vesc_telemetry.py]
2026-07-10 feat: /debug live status board + UPS status bridge
    Read-only bench diagnostics page at /debug on the dashboard Flask app. It
    subscribes to the existing /api/telemetry SSE and polls /api/ups, rendering
    every safety + power status as a big pill that visibly flips as the owner
    physically toggles switches / pulls plugs. Panels: SAFETY, VESC/CAN, BMS,
    UPS, and a client-side rolling event log of status transitions. No control
    elements — nothing on the page can command the robot.
    UPS data lives in the separate upsPlus_power_daemon process (it owns I2C).
    The daemon now atomically publishes /tmp/ups_status.json each poll loop
    (temp write + os.replace) via a fully exception-isolated helper that can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
    [oak_recorder.py, oak_viewer.py, test_debug_board.py, test_ups_status_bridge.py, upsPlus_power_daemon.py]
2026-07-10 fix: symlink-safe UPS status temp write + debug-page null rendering
    QA hardening: write_status_file previously opened a predictable
    f"{path}.tmp.{pid}" in world-writable /tmp with plain open() — the daemon
    runs as root, so a local attacker pre-planting a symlink there would turn
    the write into an arbitrary-file-write-as-root. The temp file is now
    created with os.open(O_WRONLY|O_CREAT|O_EXCL|O_NOFOLLOW, 0o644) under an
    unpredictable secrets.token_hex(6) suffix (O_EXCL refuses any pre-existing
    path and never follows symlinks; the random suffix prevents name-squatting
    races). Written via os.write with fd closed in a finally (no fd leak even
    if the write raises). All failures, EEXIST included,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
    [oak_viewer.py, test_ups_status_bridge.py, upsPlus_power_daemon.py]
2026-07-10 perf: UPS daemon I2C politeness — quiet during transfer windows, 10s supplemental cadence
    Prophylactic load reduction on the UPSPlus HAT's MCU (I2C 0x17, IP5328P
    power path). Field evidence 2026-07-10: with zero I2C traffic 3/3 main-pack
    output flips transferred cleanly; with the per-poll supplemental snapshot +
    INA219 read active the first pack-flip after deploy hard-cut the Pi output
    in ~2s. n=1 death, so this is insurance, not a proven root-cause fix.
    The per-poll DETECTION read (shutdown decision input) is untouched. Only the
    extra snapshot + INA219 reads behind _publish_status are gated: silenced
    during any sag/transfer/outage (instant-not-present OR debounce window OR
    state MISSING)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
    [oak_viewer.py, test_ups_status_bridge.py, upsPlus_power_daemon.py]
2026-07-10 perf: snapshot-free AC transition logging — zero supplemental I2C on edges
    The AC state-change log line did a fresh read_ups_snapshot (~16 regs +
    INA219) on every transition — supplemental I2C at the worst possible
    moments for the politeness policy: the 'missing' edge read landed
    mid-outage/transfer and the 'present again' edge read landed inside the
    5s recovery holdoff. ALL transition logging is now snapshot-free (even in
    steady AC-present state, for simplicity): charger voltages come from the
    current poll's detection read and battery values from the last cached
    supplemental read, tagged '[cached, batt Ns old]' when meaningfully aged.
    New pure _format_ac_transition_log() plus tests: fo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
    [test_ups_status_bridge.py, upsPlus_power_daemon.py]
2026-07-10 feat: early USB shed on AC loss + staggered restore — protect UPS output during pack transitions
    The OAK-D sits behind a Genesys powered hub fed from the MAIN PACK. When the
    pack switches off, the hub's devices dump their full draw onto the Pi's USB
    ports at the exact instant the UPS is transferring to battery — overloading
    its output (3 field hard-cuts match this). At pack-return, hub re-enumeration
    inrush collides with UPS charge inrush.
    - Shed OAK-hub USB power on the FIRST poll with an instant-low charger
    reading (pre-debounce, ~1s latency; a false positive costs a camera blip),
    fire-once per outage via usb_shed_active. Previously the shed only ran in
    run_shutdown_sequence at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
    [test_ups_ac_debounce.py, test_ups_usb_shed.py, upsPlus_power_daemon.py]
2026-07-11 Tighten UPS shutdown budget under the ~20s firmware guillotine
    The UPSPlus EP-0136 (FW v14) cuts its own 5V output ~19-20s after input
    loss regardless of battery charge (bench-verified 2026-07-10: single 60s
    cut, full pack, detect-only, zero register writes, output died at 19.5s;
    prior deaths at ~28-30s cumulative). The old budget (10s AC-loss debounce
    + 30s grace) started the OS shutdown at ~40s, AFTER that guillotine, so a
    real outage always ended in an unclean hard cut.
    Retune so the halt finishes before the firmware cut:
    - AC_LOSS_DEBOUNCE_S 10.0 -> 4.0
    - NO_CHARGE_GRACE_SECONDS 30 -> 4 (missing ~4s, grace expiry ~8s,
    shutdown issued ~8-9s, halt done ~15-17s, guillotine ~20s)
    - UPS_S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
    [test_ups_ac_debounce.py, test_ups_status_bridge.py, test_ups_usb_shed.py, upsPlus_power_daemon.py]
2026-07-11 Cut serialized wall-e pre-stop from UPS shutdown critical path
    Bench measurement (2026-07-10 20:50, journal-verified) showed the old
    sequence blew the guillotine budget it was just retuned for: the
    serialized `systemctl stop wall-e.service` alone took 5.2s (depthai
    teardown), putting grace expiry ~8-9s + 5.2s + halt at ~21-22s — past the
    19.5s UPS firmware output cut. Meanwhile a direct `shutdown -h now`
    completes the ENTIRE halt in ~7s because systemd stops wall-e IN PARALLEL.
    The halt is the clean teardown; the pre-stop was pure critical-path cost.
    - DELETE stop_rover_service() and its call (contract change: the shutdown
    sequence no longer pre-stops wall-e; tests updated to assert the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
    [test_ups_ac_debounce.py, test_ups_status_bridge.py, test_ups_usb_shed.py, upsPlus_power_daemon.py]
2026-07-12 Harden GPS heading alignment before autonomous navigation
    Require trusted RTK-fixed samples, reset alignment between armed sessions, and expose corrected heading so waypoint missions can be gated and validated safely.
    [oak_recorder.py, oak_viewer.py, test_gps_heading_align.py, test_gps_heading_align_controller.py]
2026-07-12 Freeze GPS heading after a trusted straight lock
    Prevent turning COG from corrupting the navigation frame and keep waypoint bearing control isolated from manual straight-hold logic.
    [oak_recorder.py, oak_viewer.py, test_gps_heading_align.py, test_gps_heading_align_controller.py]
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2026-07-17 harden /debug temperature graph: stale alignment, gap breaks, a11y
    Adversarial-QA hardening on top of the temperature history feature.
    Correctness:
    - Align the frontend VESC stale gate with the controller. The base page
    treated VESC temps as stale only when BOTH motor STATUS(9) ages exceeded
    0.5s (&&); the controller nulls its temp mirrors when EITHER age > 0.5s
    or the RX thread is dead. Introduce vescTempsStale() mirroring the
    controller so a single silent VESC gaps its series instead of freezing
    a last-seen value.
    - Break the plotted stroke when consecutive samples are >5s apart
    (TEMP_GAP_MS) so an SSE reconnect or tab freeze no longer draws a
    misleading diagonal across the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
    [oak_viewer.py, test_debug_board.py, test_vesc_telemetry.py]
2026-07-17 Harden GPS heading aligner gate ordering and lock immutability
    Salvaged from orphaned uncommitted WIP on fix/oak-imu-heading-hardening
    (the branch's config.py/controller.py/test_controller.py/heading_tuning.md
    edits were already superseded by the producer-integration commits; only the
    GPS-align hardening was unique).
    The controller polls update() at ~30 Hz while RTK GPS fixes arrive at ~1 Hz,
    so a single fix is re-seen ~30 times. Previously duplicate-timestamp dedup ran
    *after* the lock/yaw gates, so a transient IMU yaw spike on a later poll of the
    already-seen fix could wrongly clear the straight-run history. Fix the ordering:
    - Once locked, update() is a pure no-op until reset() (early r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
    [test_gps_heading_align.py]
2026-07-17 Fix circular gyro calibration in OAK IMU producer path
    Field chalk tests showed 90° CCW turns over-reporting by ~19-22° while CW
    was accurate at gyro_y × 1.0, with bias collection printing exactly
    x=y=z=0.000000. Root cause: OakImuReader.__init__ enables producer NMNI
    (bias=0) before the first calibrate_gyro. If the host snapshot ever exposed
    integrate-path rates (bias-subtracted then NMNI-gated), sub-threshold
    residual bias would read as exact zero and calibration would be a no-op,
    leaving that residual to integrate over the whole turn and skew CW vs CCW.
    Fix (no scale fudge):
    - oak_depth: keep latest g*_rads raw forever and add an explicit
    get_imu_raw_gyro_dps() as the calibration co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
    [oak_depth.py, oak_imu.py, oak_imu_yaw_producer.py, test_oak_imu_yaw_producer.py]
2026-07-18 docs: add charger-inhibit fail-open decision memo for Kevin
    Documents current BLE-timeout fail-open behavior for BmsService.is_charging()
    -> Controller.set_charger_inhibit() with file:line cites, a failure-mode
    table (including the 2026-06-13 spurious-current debounce incident), and
    four alternatives (keep as-is, fail-closed w/ RC-override, VESC/UPS
    corroboration, loud link-loss banner) evaluated against the actual telemetry
    this repo exposes. No behavior change.
2026-07-18 docs: add drivetrain gearing analysis for Follow-Me jerkiness
    Traces the byte->eRPM->wheel-speed math to a near-exact match with the
    documented top speed, cross-validating the recorded gear ratio and wheel
    diameter. Finds every diagnosed jerkiness mechanism (velocity-PID
    lunge/stall, slip-comp runaway) is a disabled feedback loop, not a
    gearing shortfall, and lays out measurements to confirm before regearing.
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2026-07-18 web: cap concurrent MJPEG + SSE stream clients to protect the Pi 5
    Each live /stream/rgb, /stream/depth (MJPEG) and /api/telemetry (SSE)
    connection pins a Flask worker thread that wakes several times a second
    to fan out a frame or serialize telemetry. On the Pi 5 those threads
    compete with the control loop, so a handful of forgotten browser tabs
    could measurably degrade autonomy with no upper bound.
    Add a thread-safe, leak-proof connection cap:
    - shared MJPEG pool (MAX_MJPEG_CLIENTS=3) across rgb+depth, since a
    single dashboard tab opens both and that is what actually costs the
    host; SSE pool (MAX_SSE_CLIENTS=6) for /api/telemetry.
    - a slot is reserved before streaming and relea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
    [oak_viewer.py, test_stream_client_caps.py]
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2026-07-26 Warn at startup when the boot supply looks marginal
    Diagnosed 2026-07-26. The 5V rail feeding the UPSPlus is a 3A buck off the
    13S pack. After the robot sits, the 18650 goes flat; on power-up the UPS
    demands ~2.9A to charge it on top of the Pi 5 + OAK-D boot load, which
    exceeds the buck's rating. The regulator falls out of regulation and the Pi
    hard-cuts with no OS shutdown and no log. The 08:44 boot that morning lasted
    115s and left a dirty journal.
    The failure is current delivery, not stored energy — 3.9V is ~50% SoC.
    Measured input rail against 18650 charge draw:
    0.19A -> 4893mV 1.24A -> 4864mV ~2.0A -> ~4.8V 2.88A -> 4184mV
    The first three are a ~0.06 ohm resistive droop (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
    [test_ups_marginal_supply_warning.py, upsPlus_power_daemon.py]
2026-07-26 Add read-only CLI to print OAK factory intrinsics
    The obstacle corridor derives focal length by trig from a hand-entered FOV
    instead of reading the per-unit calibration the camera ships with. Three
    sources disagree about that FOV: config.py:184 says 81.0, oak_depth.py
    defaults to 73.0 in both call sites, the 2026-03-09 board measurement derived
    73, and the Luxonis spec for the OAK-D Lite colour sensor is 81 diagonal /
    ~69 horizontal. 81.0 looks like a diagonal figure in a horizontal field.
    The error points the unsafe way: too large an HFOV gives too small an fx,
    which shrinks the corridor threshold (fx * robot_half_mm), so the mask
    rejects obstacles inside the robot's real swept path.
    This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
    [oak_intrinsics.py]
2026-07-26 Read camera intrinsics from EEPROM; fix the FOV constants they exposed
    MEASURED 2026-07-26 with pi_app/cli/oak_intrinsics.py against the actual
    camera: CAM_A @ 640x400 gives fx=456.89, implied HFOV 70.01 deg (EEPROM spec
    FOV 68.794). config.py claimed 81.0 -- the OAK-D Lite colour sensor's DIAGONAL
    FOV sitting in a horizontal field, 18% wrong.
    Three defects, one root cause.
    1. Obstacle corridor. fx was derived by trig from the 81 deg constant, giving
    374.67 against a true 456.89. The corridor threshold is fx * robot_half_mm,
    so it was 18% too small: the mask guarded a ~0.67 m wide robot instead of
    0.82 m and ignored obstacles ~7 cm inside each edge of its own swept path.
    oak_de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
    [oak_depth.py, test_blind_pursuit_budget.py, test_controller_obstacle.py, test_depth_filter_latch.py, test_detection_height_gate.py, test_follow_me.py]
2026-07-26 Log OAK intrinsics provenance at WARNING so it is actually visible
    The app configures no logging handler, so the root logger sits at WARNING and
    the INFO line added with the EEPROM read was silently dropped — leaving no
    runtime evidence of where the corridor's focal length came from. That matters
    because a failed EEPROM read falls back to the config constant and silently
    changes safety geometry.
    Now logs the calibration load and, once per resolution, the resolved fx/cx with
    the implied HFOV and the principal-point offset. Matches the existing
    HAND_INIT startup-diagnostic precedent in this file. Once per device session
    per resolution, never in a hot path.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
    [oak_depth.py]
2026-07-26 Query depth intrinsics with the full frame height, not the ROI band
    _poll_depth passed band.shape[0], but band is a vertical CROP of the depth
    frame (frame[y0:y1, :]). Asking getCameraIntrinsics for that height describes a
    differently-cropped sensor readout than the frame we actually have.
    Only fx and cx are consumed and both are horizontal, so the resolved numbers
    are unchanged (fx=456.89, cx=334.95 either way, confirmed on hardware). This is
    a latent-trap fix: any future caller reading fy/cy from the helper would have
    silently got values for the wrong geometry. Also stops the journal reporting a
    misleading "640x200".
    [oak_depth.py]
2026-07-26 Make device intrinsics the single source of camera geometry
    The recorder's overlay derived its own focal length from a hardcoded
    hfov_deg=81.0 default that NO caller ever overrode, plus a second hardcoded
    81.0 for the consume-radius arc, and placed the principal point at the frame
    centre. Meanwhile the obstacle corridor had just been switched to the device's
    real calibration (70.01 deg, fx=456.89, principal point +14.9 px off centre).
    So the picture the recorder drew and the corridor the robot enforced were
    different geometries. That is worse than either being wrong alone: the field
    check for the corridor fix is "compare the overlay against the physical robot
    width with the boards on", and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
    [oak_depth.py, oak_recorder.py, test_overlay_intrinsics.py]
2026-07-26 Bind remaining geometry defaults to config so they cannot drift
    Two parameter defaults still carried hand-copied physical values:
    follow_me.DetectionFilter camera_vfov_deg = 65.3 (the stale pre-fix FOV)
    oak_recorder camera_height_m = 0.497 (twice)
    Production overrode both, so neither was a live fault. But a literal default
    that no caller exercises is precisely how hfov_deg=81.0 survived unnoticed in
    the recorder for months — nothing reads it, so nothing contradicts it, until
    one day a caller omits the argument. Both now derive from the config dataclass
    at import time, so they cannot diverge from the measured values again.
    Audit of every other numeric default in h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
    [oak_recorder.py]
2026-07-26 Document camera calibration; drop stale VESC RPM known-issue
    README still listed VESC RPM readback as "stuck at 0, root cause not yet
    investigated". That was resolved and bench-verified 2026-06-11 and CLAUDE.md
    already said so, so the two docs contradicted each other — the exact trap the
    global instructions warn about (do not trust an old CLAUDE.md; report stale
    content).
    CLAUDE.md gains a camera-calibration section: the measured per-unit numbers,
    the rule that geometry only ever comes from get_intrinsics(), the three
    defects the wrong 81 deg constant caused, and the warning that two of them
    were cancelling each other so fixing one alone regresses the robot.
    Also records the open field c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
2026-09-19 Stop a closer person stealing the follow-me lock
    Two paths let a closer person take the operator's lock on a single frame:
    1. TrackletTracker associated purely on IoU, so an occluder whose larger,
    overlapping box swallowed the operator's inherited the operator's
    track_id. Association now also requires depth continuity
    (tracklet_depth_gate_m + growth per missed frame); the live YOLOv8
    host-NMS path passes per-detection depths.
    2. TargetTracker handed off immediately to the closest floor-clearing
    candidate the moment the committed id went missing. The hand-off is
    now sustained (target_switch_min_s and target_acquire_min_frames); the
    operator reappearing clears the challen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
    [oak_depth.py, test_depth_filter_latch.py, test_target_lock_steal.py]
2026-09-19 Re-enable the follow-me velocity PID behind an RPM plausibility gate
    The gains were zeroed 2026-06-11 because dead eRPM readback made the loop
    chase a bogus "not moving" error. Bench tests since showed the readback
    works, so the loop comes back with guards:
    - RpmPlausibilityGate: a motor commanded >= 12 bytes from neutral but
    reading < 150 eRPM for 0.5 s trips the gate; the controller nulls RPM
    and actual_speed_mps (open-loop fallback) until real RPM returns, with
    a 2 s minimum hold. Exposed in telemetry.
    - One speed scale: target and feedback both use the kinematic wheel
    speed (0.009416 m/s/byte from VescConfig), not the GPS ground-speed
    trail scale, which carried a ~20% bias.
    -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
    [test_rpm_plausibility.py, test_tracklet_tracker.py]
2026-09-19 Measure forward speed as the signed wheel mean; clear stale PID integral
    From the Fable review of the velocity-PID re-enable:
    - actual_speed_mps averaged |eRPM|, which reads max(|v|, |yaw|). Any
    low-speed arc looked like overspeed and the loop cut throttle toward
    zero over a sustained turn. The signed mean cancels the steering
    differential. Both sides read positive eRPM forward (2026-06-11 bench).
    - SpeedLayer kept the PID integral across open-loop ticks and across the
    full lost-target reset, so a stale I-term hit the first closed-loop
    tick after the RPM gate recovered. It now resets on every open-loop,
    too-close and tracking-reset path.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
    [test_rpm_plausibility.py]
2026-09-19 Add the OAK-D Lite capability audit
    Answer two operator questions with sourced Luxonis documentation: the
    OAK-D Lite BMI270 cannot provide fused or absolute heading (BNO08x only),
    so host-side gyro integration was the right design; and the pipeline
    under-uses the device. The audit lists each feature as used, unused,
    misused or unavailable, with a recommended sequence. The two high-value
    items: the pipeline requests RAW IMU reports where the v3 docs list
    CALIBRATED reports for the BMI270 (factory bias/scale/frame), and the
    YOLOv8n blob lacks NN Archive metadata, which is why every on-device
    detection/tracking node returned nothing and the host stack exists.
    CLAUDE.md: correct the detection-n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
2026-09-19 Add the external 9DoF IMU postmortem
    Why the SparkFun ISM330DHCX + MMC5983MA board never worked as a heading
    source, with sourced evidence and an offline simulation of the heading
    math: the magnetometer has been disabled since 2026-02-28 (gyro-only,
    worse than the OAK path it competed with), the documented calibration
    tool has collected zero samples since the commit that added it, the live
    hard-iron calibration exceeds the local horizontal Earth field, motor
    current at the mount can exceed that field with no validity gate in the
    fusion, and the MMC5983MA SET/RESET runs once and leaves the part in
    RESET polarity. Verdict: salvageable only as a magnetometer-based north
    corrector for the OAK gy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
2026-09-19 Make the OAK heading compass-native (clockwise-positive) end to end
    Field measurement 2026-09-19 (robot on 3923f23, OAK-D Lite BMI270, imu source
    oak_d): hand-turning the robot ~90 degrees RIGHT moved the dashboard heading
    241.4 -> 152.8 (-88.6 deg); turning back LEFT moved it 162.9 -> 255.0 (+92).
    Magnitude right, sign inverted.
    Cause: gyro_y was already clockwise-positive. The BMI270 Y axis points DOWN on
    this mounting (the accelerometer reads about -1 g on Y at rest, which is why
    oak_imu.py computes roll_acc = atan2(ax, -ay)), and a right-handed frame with
    +Y down makes +gy a clockwise turn. OakImuReader then negated it
    (heading = -yaw), so a right turn read as a left turn.
    Two downstre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
    [oak_imu.py, oak_imu_yaw_producer.py, oak_yaw_chalk_test.py, test_heading_sign_closed_loop.py, test_imu_steering_harness.py, test_oak_imu.py, test_oak_imu_yaw_producer.py]
2026-09-19 Report the live yaw rate on duplicate IMU reads instead of zero
    controller.py:755 calls imu_compensator.get_heading_deg() on every tick, which
    consumes the producer cum delta. Heading-hold update() then calls read() again
    in the same tick. At the 10 ms BMI270 packet cadence the second read usually
    finds no new packets and lands in the duplicate / generation_reseed branch of
    _consume_producer_yaw, which returned a yaw rate of 0.0. The PID D-term and the
    GPS heading-aligner's "am I turning?" gate therefore saw a rate that flickered
    between the real value and zero on alternate reads.
    Freezing the HEADING there is correct (there is no new cum to integrate), but
    the yaw RATE is a separate and st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
    [oak_imu.py, test_oak_imu.py, test_oak_imu_yaw_producer.py]
2026-09-19 Track gyro bias while stationary and freeze yaw integration
    oak_d): parked, the heading wound +0.9 deg/s. The robot JSON log shows
    gy_body_dps (the bias-subtracted body rate about Y) at -0.03 right after a GOOD
    3 s boot calibration at 11:12, then -0.46 (11:16), -0.83 (11:20), -1.07 (11:36),
    -1.25 (11:49), plateauing near -1.2 deg/s. That is thermal gyro-bias drift, and
    nothing in the stack was tracking it:
    * NMNI at 0.3 deg/s cannot gate a 1.2 deg/s rate.
    * The reader-side bias_adapt only ran when every axis was below the NMNI
    threshold, so it could never engage once the drift exceeded 0.3 deg/s --
    exa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
    [oak_depth.py, oak_imu.py, oak_imu_yaw_producer.py, oak_yaw_chalk_test.py, test_oak_imu.py, test_oak_imu_stationary_bias.py]
2026-09-19 Show the heading state honestly in the UI
    Three places showed a plausible stand-in instead of the state they actually
    had, which is how an inverted heading survived two months of driving.
    1. property_map drew the robot marker straight from imu_heading_deg. That
    heading is clockwise-positive but relative to BOOT orientation, while the
    marker contract is true north, so it was only right by luck. It now prefers
    corrected_heading_deg when heading_offset_locked is set, exactly as the
    waypoint UI already did, and falls back to the raw heading otherwise.
    2. wp_heading_error_deg and nav_state were never serialized into the telemetry
    SSE, although waypoint_nav_ui reads both at the to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
    [oak_recorder.py, oak_viewer.py, property_map.py, test_heading_ui_honesty.py]
2026-09-19 Gate stationary bias tracking on a wheels-stopped witness
    Two independent reviewers found the same BLOCKER in the stationary detector
    added by fb9e378: an IMU cannot vouch for its own stillness. A genuine slow
    steady rotation (a cross-slope creep, a gentle arc) satisfies the raw
    gyro/accel window's std and rate gates exactly as well as a truly parked
    robot, so ZUPT froze real rotation and the bias tracker absorbed it as drift
    (measured: a true 1.5 deg/s turn frozen 39 of 40 s; a 0.08 deg/s^2 ramp
    ratcheted the bias to 70 deg/s).
    Fix: stationary now additionally requires a FRESH witness from
    ImuYawProducer.set_motion_witness() saying the wheels are physically
    stopped. main.py derives that wi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
    [oak_depth.py, oak_imu.py, oak_imu_yaw_producer.py, oak_yaw_chalk_test.py, test_oak_imu.py]
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2026-09-19 Pin imu_source to the OAK BMI270
    "auto" tried the external ISM330DHCX + MMC5983MA reader first. That path
    is unvalidated, untested, and now publishes the opposite yaw-rate sign
    convention to the corrected OAK path, so plugging the parked board back
    in would silently hijack heading. Pin the source; re-enable only after
    the bench protocol in docs/external_imu_postmortem.md.
    Claude-Session: https://claude.ai/code/session_01KWgFAzHJyxP7sDA3T6g3fU
2026-09-19 Record the heading work in RESULT.md
    Field evidence (sign inverted on a hand turn; thermal bias walk after a
    good boot calibration), the five root causes, the seven commits, the
    on-robot validation plan, and what is still open.
    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
2026-09-19 Add the RTK float investigation runbook
    The rover (DFRobot KIT0198, Quectel LC29HDA) has never reported RTK
    fixed in any log since 2026-07-30. Live register probes confirm the
    module itself reports quality 5, that it is in LoRa mode, and that RMC
    course/speed are available but unread. Ranked causes (LoRa air rate vs
    correction payload, L1-only intersection, unfrozen base coordinate,
    rover noise/antenna, base sky view), the decisive short-baseline test,
    the base-station checklist, and the driver changes in progress.
    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
2026-09-19 Log the values already computed, add a session header and slim the console line
    The logging audit found several controller.process() telemetry values that
    were computed every tick and then discarded before they reached the JSON
    log: VESC RPM-plausibility/duty/temperature fields, the IMU steering
    correction_blend/speed_gain_scale, and straight_intent. Wire them through:
    - vesc block: rpm_plausible, gate_trips, l/r_temp_c, l/r_motor_temp_c,
    l/r_duty (all already on the telemetry dict; no controller.py changes).
    - imu_steering block: correction_blend, speed_gain_scale (already on
    telemetry), plus a new `saturated` bool -- ImuSteeringCompensator's
    anti-windup flag (_last_saturated) was tr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
    [test_controller.py, test_imu_steering.py, test_log_fields.py]
2026-09-19 Instrument the follow-me speed loop
    The velocity PID re-enabled behind the RPM plausibility gate had no
    telemetry: PIDController computed p/i/d and discarded them, and SpeedLayer
    computed open-loop byte, target speed, velocity error, and the closed-loop
    correction and discarded all of it too -- there was no way to derive the
    speed-loop gains offline or tell whether a given tick was even closed-loop.
    - PIDController.compute() now stores last_p/last_i/last_d/last_output on
    every call (generic -- also covers the lateral steering PID for free).
    - SpeedLayer.compute() stores last_open_loop_byte/last_target_mps/
    last_actual_mps/last_err_mps/last_corr_mps/last_corr_byte/last_closed on
    every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
    [test_follow_me.py]
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2026-09-19 RTK GPS: log fix-quality edges, read UTC/COG/SOG, fix poll aliasing
    Vendored register map and read protocol from DFRobot's own driver
    (DFRobot/DFRobot_RTK_LoRa, python/raspberrypi/DFRobot_RTK_LoRa.py,
    fetched 2026-09-19) and followed it exactly for the new register reads.
    Receiver: DFRobot KIT0198 (Quectel LC29HDA behind an I2C co-processor at
    0x20). See docs/rtk_gps_module.md for the register map and protocol.
    1. Parse UTC (registers 0-6, already inside the existing 32-byte block
    read) into GpsReading.utc_iso (ISO 8601, None when year==0/no fix yet),
    and geoid separation (registers 26-28, same sign/scale shape as
    altitude at 23-25) into GpsReading.geoid_sep_m. Register 32 (DIFID_L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
    [rtk_gps.py, test_log_fields.py, test_rtk_gps.py]
2026-09-19 auto_deploy: robust smoke test, error text in the log, docs-only pulls without restart
    A root-owned pi_app/io/__pycache__ on the Pi made compileall fail with a
    PermissionError, which the smoke test read as a broken push and rolled
    back a good deploy without recording why. Write bytecode to a scratch
    PYTHONPYCACHEPREFIX, gate on the exit code, and append the error text to
    deploy.log. Changes that touch only docs/ or top-level .md files now pull
    without restarting the daily-driver service.
    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
2026-09-19 Lock the GPS heading from per-epoch course over ground; log teleop deadman trips
    The displacement lock needed a straight command on both RC channels and a
    straight path for 8 s. With a single mixed stick on uneven ground that is
    a coin flip, and phone/BT driving could never lock at all. The receiver
    now reports its Doppler course over ground each epoch, so
    GpsHeadingAligner.update_cog() pairs each epoch's course with the IMU
    heading at that instant: wobble cancels sample by sample. Lock when six
    epochs within 20 s agree to within 8 degrees (circular std); gates are
    RTK fixed, forward intent from the last emitted motor bytes (RC or
    phone), speed >= 0.3 m/s, yaw rate <= 6 deg/s. The displaceme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
    [teleop.py, test_gps_heading_align.py, test_gps_heading_align_controller.py, waypoint_nav_ui.py]
2026-09-19 Keep the GPS heading lock across disarm; verify it from course over ground
    Every disarm reset the one-shot lock, so each attempt needed another
    forward run. The offset relates the IMU boot frame to true north, and
    that frame is continuous across disarm / RC stale / e-stop (the gyro
    keeps integrating, ZUPT holds the heading while parked, the tracked bias
    keeps it honest). Kevin chose to keep the lock (2026-09-19). Two guards
    replace the reset: while locked, qualifying course-over-ground epochs keep
    feeding the window, and six agreeing epochs that disagree with the frozen
    offset by more than cog_verify_max_error_deg (15) move it with a WARNING
    (lock_source "cog-relock", relock_count); and the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
    [test_gps_heading_align.py, test_gps_heading_align_controller.py]
2026-09-19 Make the waypoint ALIGN pivot proportional to the heading error
    Field run 2026-09-19 18:19: with the corrected heading and a fixed 0.5
    pivot (about 74 deg/s measured), ALIGN carried 25-30 deg past the target
    on every pivot, beyond recovery_threshold_deg, so DRIVE bounced back to
    ALIGN in the other direction and the robot rocked left-right while
    creeping toward the waypoint. The pivot now scales with the error: full
    pivot_yaw_cmd (lowered 0.5 -> 0.35) at pivot_full_error_deg (90) and
    above, down to pivot_yaw_min (0.18) near the window, so it can stop
    inside align_threshold_deg. Sign law unchanged.
    Tests changed with reasons: the two ALIGN sign tests asserted the fixed
    magnitude; they now ass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
    [test_waypoint_nav.py]
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2026-09-20 Follow-me: target the emitted forward byte in the speed loop; grace hold; slow into turns
    Three sources of the "jumpy" speed in the 18:50 run:
    1. SpeedLayer targeted open_loop from the depth error, but the persistence
    decay, the SafetyLayer accel ramp, the obstacle throttle and the slew
    limiter all cut the command after it. The velocity PID sat at its +21
    byte clamp (corr_byte 21.2 while speed_offset was 2.5) and dumped it as
    a surge when the limit lifted. The controller now feeds back the
    common-mode byte that reached the motors on the previous FOLLOW_ME tick
    (update_telemetry(emitted_forward_byte=...)); the target is
    min(open_loop, emitted - last correction), and a fu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
    [test_follow_me_speed_loop_limits.py]
2026-09-20 Depth corridor: require pixel support and two-poll persistence; log the corridor's valid fraction
    In the last 30 s of the 18:50 follow-me run (low sun) the corridor
    distance flickered 2.3 -> 1.4 -> 2.3 -> 0.4 (depth_p5_mm 383) -> 0.8 m
    while the operator was 2.8-3.8 m ahead and the full-frame valid fraction
    was 2-7 percent; throttle_scale went 0.9 -> 0.0 -> 0.4 -> 0.8. The 5th
    percentile of a handful of valid pixels is noise.
    The near estimate is now the k-th smallest valid depth with
    k = max(corridor_min_support_px (400), 5 percent of the valid count); a
    corridor with fewer than 400 valid pixels is rejected like a low
    valid-fraction one. A two-poll max filter (corridor_persistence_polls)
    k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
    [oak_depth.py, test_obstacle_corridor_support.py]
2026-09-20 Nav page: always-visible STOP, collapse on start, RTK-fixed gate, no confirm mid-hold
    Closes #45, #46, #47, #48, #51 from docs/ui_audit_2026-09-19.md.
    - STOP is a fixed 72 px control outside the collapsible sheet (same id and
    handler), shown while a run is active, paused or launching. The in-sheet
    STOP is gone; PAUSE and SKIP stay.
    - The sheet collapses on the MANUAL -> WAYPOINT_NAV transition, and the nav
    status line is always visible under the toolbar.
    - At 100 percent fill STOP appears first, GO fades, and a 4 s toast says
    releasing does not stop the robot.
    - The JS gate matches the backend (gpsFix === 4); validation runs on
    pointerdown before the hold; errors block with an in-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
    [test_waypoint_nav_ui_safety.py, waypoint_nav_ui.py]
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2026-09-20 Obstacle corridor: fraction-based near support and a MANUAL creep floor (19:53 garage stop)
    2026-09-19 19:53 CDT, after sunset: the robot could not be driven forward
    into the garage and had to be backed in. The log shows the corridor's
    5th-percentile depth at 367-429 mm (throttle 0.0) for two minutes before
    and during the attempt, while the corridor MEDIAN was 5-7 m and 10-13
    percent of pixels were valid. A real object at 0.37 m pulls the median
    down with it; a 5th percentile pinned at the minimum measurable depth
    (min_depth_mm 350) is max-disparity noise, which always reads "closest
    possible" and so stays steady to the centimetre. The OAK-D Lite has no IR
    projector: its stereo depth is pass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
    [oak_depth.py, test_controller_obstacle.py, test_obstacle_avoidance.py, test_obstacle_corridor_support.py]
2026-09-20 Retune follow-me steering against the real yaw plant; fix zeroed yaw rate
    The 2026-09-19 retune rested on "0.22 deg/s of yaw per L-R byte". That
    figure is wrong: 64 percent of logged imu.yaw_rate_dps samples were 0.0.
    The duplicate-read branch of OakImuReader only reported the live rate for
    samples younger than 50 ms, and under follow-me load the sample age is
    p50 90 ms / max 286 ms. From the heading derivative the plant is 0.65-0.71
    deg/s per byte with ~0.45 s lag on both days. The tripled loop gain made
    the robot weave with growing amplitude on the 2026-09-20 run and swing
    120 deg for a 28 deg bearing.
    - oak_imu: duplicate-rate freshness bound 0.05 -> 0.20 s (still below the
    0.5 s stale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
    [analyze_follow_me_log.py, oak_imu.py, test_analyze_follow_me_log.py, test_fm_params_endpoint.py, test_follow_me.py, test_oak_imu_motion_witness.py]
2026-09-20 Keep the follow-me lock through tracklet id churn on a lone operator
    The 2026-09-20 14:58 run hard-stopped from 1.4 m/s five times in 31 s with
    one person in frame at conf 0.85-0.93. The tracklet id on the operator
    churned 266 -> 272 -> 271 -> 273 -> 275 -> 276 -> 277: the box is 0.10 of
    the frame wide at 4 m, detections arrive 0.12-0.35 s apart and the robot
    yaws at 20-35 deg/s, so consecutive boxes have IoU 0. Each flip to a
    different CONFIRMED id tripped the sustained hand-off added on 2026-09-19
    (1.0 s), and speed decayed to 0 after the 0.3 s grace.
    - TrackletTracker: centre-distance fallback pass after the IoU pass, for
    confirmed tracklets only, behind the existing depth gate, with a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
    [analyze_follow_me_log.py, oak_depth.py, test_analyze_follow_me_log.py, test_target_lock_steal.py, test_tracklet_tracker.py]
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2026-09-20 Make the person-range sampler say "unknown" instead of guessing; log it
    2026-09-20 15:49 run: with the operator at 5.8-5.9 m the SAME track id
    read 5.8, 3.7, 3.1, 5.8, 4.1, 2.6 m on successive frames. The sampler
    discarded every pixel beyond max_distance_m (6.0 m) - the person's own -
    and took the median of whatever strays were left, with no support floor.
    Each bad range failed the tracker's depth gate and stopped the robot.
    - Sampler is a pure helper: torso band (20-55 % of box height, inner
    50 % of width), window shifted away from a clipped frame edge, valid
    pixels out to person_depth_sample_max_m (9.0), support floor
    (>= 12 px and >= 2 % of the ROI) else depth_status "no_support" a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
    [analyze_follow_me_log.py, oak_depth.py, test_person_depth_sampler.py]
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2026-09-20 Close the remaining drive-into-person paths found in safety review
    An independent Grok review of the 15:49 fix found the replayed case
    closed but four neighbours open:
    - H3: the nearest-person limit compared against raw_depth_m, so once the
    tracker ACCEPTED a true 1.2 m the limit switched off while DepthFilter
    still reported 3.0 m for ~5 frames, on a fresh tick. It now compares
    against the range the speed law would use (target.depth_m).
    - H4: "blind ticks never accelerate" capped at the last fresh REQUEST;
    a SafetyLayer ramp in progress (54 of a requested 100) kept climbing.
    Not-fresh AND depth-unknown-coast ticks now cap at min(last fresh
    request, the previous tick's post-safet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
    [test_depth_coast.py, test_follow_me.py, test_follow_me_integration.py]
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2026-09-20 A/B 1: cap OAK camera outputs at 15 fps (camera_fps 0 -> 15)
    nn_input_queue_size=1 landed (read-back maxSize=1) and idle det_fps rose
    11 -> 12.5, but idle det_latency_s stayed 0.60 s with only 18 ms of host
    work per loop, so the delay is upstream of the NN input queue. Next
    suspect from the pipeline review: the sensors free-run at ~30 fps while
    the NN sustains ~12, so camera/ISP frame pools queue ahead of the NN and
    contend with stereo + NN. Resolution unchanged (safety geometry
    untouched). Idle A/B on det_latency_s / det_fps / depth_fps; revert if
    depth_fps or det_fps drops. Kevin approved up to 3 A/B pushes.
    Also adds the lidar selection research (docs only).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
2026-09-20 Docs: record the 2026-09-20 follow-me rounds 3-5 and the gesture review
    docs/follow_me_run_2026-09-20.md now covers the whole day (14:58 hard
    stops + weave, 15:49 near-run-over and its fixes, 17:11 validation, the
    vision-latency work, 18:09 validation, open items, and the decision to
    leave steering gain alone). New docs/gesture_review_2026-09-20.md holds
    the hand-gesture review, the owner's direction and the fix order.
    CLAUDE.md: rounds 4-5, camera_fps = 15 is load-bearing, how to measure
    latency at idle, two new known issues (gestures do not work as deployed;
    recording is suppressed while gestures are configured).
    Written by Grok 4.6 from the session notes; docs only.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
2026-09-21 WIP (NOT for main): arms-up pose detector + reverse-twitch bench test
    Owner request 2026-09-20: a "both hands up" gesture that will later make
    the robot back up while keeping him centred. Tonight's scope is only the
    bench acknowledgement: when both wrists are above the shoulders for
    0.4 s, give ONE reverse pulse (22 bytes, 0.25 s, < 7 cm), 3 s cooldown.
    The camera cannot resolve palms/fingers beyond ~0.5 m, so the agreed
    trigger is body pose.
    - pi_app/control/arms_up.py: pure arms_up() + debounced ArmsUpDetector
    (hold counts NEW sample timestamps; release; stale).
    - pi_app/hardware/pose_worker.py: MediaPipe Pose (lite, ~40 ms on the
    Pi 5) on the person crop of the existing 640x480 frame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
    [oak_depth.py, pose_worker.py, test_arms_up.py]
2026-09-21 Add the next-session handoff (docs/NEXT_SESSION.md)
    State of the robot, the unmerged fm-armsup branch and its merge
    procedure, the rules learned on 2026-09-20, the prioritised backlog
    (arms-up bench test, back-up feature, recording, gesture fixes, gravel
    phantom, steering gain, lidar, housekeeping) and the known residual
    risks of the live build. Docs only.
2026-09-22 Harden the arms-up bench twitch after the Grok safety review
    A Grok safety review of d23c252 found paths to unintended reverse
    motion. This commit closes them. The branch stays off main.
    - Enable: runtime-only latch (POST /api/arms_up/twitch_test), refused
    unless armed + MANUAL + no e-stop/charger/pack-low/calibration. It
    clears on disarm, e-stop, mode change, calibration, RC stale, a
    5 min expiry, and a 3-pulse budget. twitch_test_enabled is gone, so
    a deploy never makes gesture-commanded motion live.
    - Gating: MANUAL only (FOLLOW_ME removed; the follow-me code is main's
    again). A start needs sticks within 6 bytes of neutral, no web-teleop
    override, 0.5 s of neutral output with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
    [oak_depth.py, oak_viewer.py, pose_worker.py]
2026-09-22 Close the second-review holes in the arms-up bench twitch
    A second Grok safety review of the branch found three bounded ways to
    get an unintended ~7 cm reverse pulse, a detector re-arm glitch, and a
    frame copy held under the OAK lock. All fixed here:
    - POST /api/arms_up/twitch_test is local-only (127.0.0.1 / ::1), so
    only a shell on the robot can enable the latch. A second enable while
    latched is refused ("already_latched"): the 3-pulse budget and the
    5 min window cannot be refilled. An accepted enable resets the
    detector streak on the control thread.
    - The still gate fails closed: both VESC eRPMs must be present and
    under the cap ("no_rpm" otherwise), and still time counts only i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
    [oak_depth.py, oak_viewer.py, pose_worker.py, test_arms_up.py, test_arms_up_endpoint.py]
2026-09-24 Docs: record the arms-up bench test result (PASSED on the stand)
    2026-09-24: fb9420e deployed; two reverse pulses on the stand, one-arm
    poses never triggered, re-arm worked, expiry cleared the latch, and
    det_latency_s p50 stayed at 0.18 s with the pose worker running.
    Also records the camera-geometry finding that blocks a raised-arms
    trigger for the back-up feature: inside ~3.5-4.5 m the raised hands
    leave the frame.
2026-09-24 Docs: draft the "pump to back up" design after the arms-up bench test
    The bench test showed that raised hands leave the frame inside
    ~3.5-4.5 m, which is the back-up working range. A same-evening test
    showed that a low two-hand pump widens the target's YOLO box 3-3.7x
    at 1.5-3 m with both edges moving and the centre steady, so the new
    design reads the gesture from the box width in metres. Grok's second
    opinion found eight defects in the first draft (start/hold conflict,
    one-frame flicker, a forward-speed sign bug, near-range clipping,
    blind rear swing, and more); all are corrected in this version.
    NEXT_SESSION.md points backlog item 2 at the design.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
2026-09-25 Docs: record the 2026-09-25 stale-detection follow-me incident
    The OAK colour camera stalled after 23 h of uptime; the reader kept
    serving a 40-minute-old person and follow-me drove a 44 s circle
    chasing it. Records the facts, the overnight-armed finding, and the
    two-deploy fix plan (freshness gate first, auto-restart later).
2026-09-26 Stop follow-me from driving on a stale detection stream
    2026-09-25 18:23: the OAK colour camera (CAM_A) had stalled on the
    device at 17:43 after 23 h of uptime while depth kept running.
    get_person_detections() kept returning the last person for 40 minutes,
    FOLLOW_ME entry accepted it as a target, and follow-me drove ~0.85 m/s
    in a left circle for 44 s. get_health() already said
    detections_stale=True, but nothing read it.
    - OakDepthReader: a freshness clock from the NN message's host-synced
    capture time, refreshed only when the NN sequence number advances
    (a re-published frozen frame stays stale); get_detection_freshness()
    and health fields det_fresh_age_s / det_seq / det_seq_stuck_pac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
    [oak_depth.py, test_detection_freshness.py, test_log_fields.py]
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2026-09-26 Require the arm switch to be seen OFF after a restart before arming
    Follow-up to auto-disarm: arming is level-based and the re-arm latch
    lived only in memory, so a service restart (deploy, crash) after an
    auto-disarm would re-arm on an arm switch that was left up.
    - Controller(startup_interlock=True) starts with the re-arm latch set;
    the robot arms only after ch3 has been seen at or below the low
    threshold. The RC-stale rebuild keeps the latch (transmitter off at
    boot), and a mid-band ch3 does not clear it.
    - main.py enables it from SafetyConfig.require_switch_off_at_startup
    (default True). A Controller built directly (unit tests) keeps the
    old behaviour, so existing tests are unc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
    [test_arm_interlock.py]
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2026-09-26 Restart the OAK session when the detection stream stalls
    Deploy 2 of the 2026-09-25 stale-detection fix. CAM_A stalled on the
    device with the pipeline still running and no exception, so nothing
    ended the session; recovery needed a manual service restart.
    - The session loop runs a watchdog after each vision poll: when no
    fresh NN packet (the capture-time clock from deploy 1) has arrived
    for color_stall_restart_s (5 s), after a color_stall_warmup_s (10 s)
    warm-up measured from the session loop start, it logs a WARNING and
    ends the session; the existing supervisor tears down, backs off 2 s
    and rebuilds. Sessions without a detection queue never trigger it,
    and stop() never counts as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
    [oak_depth.py, test_oak_color_stall.py]
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2026-09-26 Replace the corridor blob filter with a depth-agreement filter
    Grok's review of 8a4afb2 and a stress test proved the blob-size filter
    unsafe: woven wire fence looks like speckle at the pixel level, and with
    30 percent of its pixels removed (worse light) every blob variant, with
    or without merging nearby fragments, lost the fence at ~1 m. It also
    could turn a measurable corridor into "clear": dropping speckle pushed
    valid density under min_valid_pct (trash can, 50 percent dropout).
    Now a near pixel stays only when at least 16 near pixels in its 13 x 13
    window lie within one 100 mm depth bin of it (corridor_speckle_window_px,
    corridor_speckle_min_neighbours). False matches are sparse with ran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
    [oak_depth.py, test_corridor_speckle_person_mask.py]
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2026-09-26 Add an I2C bus 1 auto-unlock guard for the 2026-09-25 stuck-bus incident
    On 2026-09-25 a device on I2C bus 1 held SDA low for 17 hours, taking
    out both the RTK GPS and the UPSPlus HAT with it, and nothing on the
    Pi 5 recovers a stuck controller on its own. bin/i2c_bus_guard.py polls
    the UPS status file's age and SDA's level, and only when the UPS is
    stale AND SDA reads low for 3 consecutive ~1s samples does it run the
    standard unbind/clock-SCL/STOP/rebind bus-clear recovery, capped at 6
    attempts per rolling hour. Hardware access is isolated behind one
    Hardware class so detection and recovery are unit-tested against a
    fake (pi_app/tests/test_i2c_bus_guard.py) with no real GPIO involved.
    Also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
    [i2c_bus_guard.py, test_i2c_bus_guard.py]
2026-09-26 Fix review findings: open-drain drive, UPS reopen, UPS-blind-any-cause alert
    Four fixes from review of the initial guard:
    - Never drive SCL/SDA high push-pull ("op","dh"): a wedged slave can
    still be holding a line low, and a push-pull high would fight it on
    the same wire. Every drive is now low-only ("op","dl"); "high" is
    always a release to input-with-pull-up ("ip","pu").
    - The STOP condition is now the textbook open-drain sequence: drive SCL
    low, drive SDA low, release SCL, release SDA -- SDA then transitions
    low-to-high while SCL is high.
    - Unbinding/rebinding the adapter invalidates the UPS daemon's open
    smbus2.SMBus handle, and that daemon never reopens it on its own,
    so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
    [i2c_bus_guard.py, test_i2c_bus_guard.py]
2026-09-26 Fix Grok-flagged defects: kill safety, self-heal, joint detection, UPS rules
    Five defects from Grok's review of the guard, fixed with tests:
    - KILL SAFETY. A SIGTERM/SIGKILL during recover_bus used to skip its
    `finally` block, stranding GPIO2/3 in GPIO mode with the driver
    unbound and nothing to repair it. Now: main() installs a SIGTERM/
    SIGINT handler (ShutdownFlag) that only sets a flag -- the handler
    never raises, so a `finally` already running always completes, and
    the loop (_run_loop) exits after the current cycle instead of being
    torn down mid-recovery. SIGKILL still cannot be caught, so every
    cycle now opens with a cheap self-heal check (is_driver_healthy):
    if the dri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
    [i2c_bus_guard.py, test_i2c_bus_guard.py]
2026-09-26 Parse Pi 5 output-mode pinctrl lines; do not heal on unreadable pins
    Real `pinctrl get` prints output pins as " 7: op dh pu | hi // ...": the
    drive token sits between function and pull, so the old pattern read a
    pin left in output mode by an interrupted recovery as "unknown". The
    function is now the first token after "N:".
    is_driver_healthy() treated "unknown" as drift, so a pinctrl failure
    would have re-asserted both I2C pins every 5 s on a healthy, busy bus.
    Only a positively read non-a3 function or an unbound driver counts now.
    [i2c_bus_guard.py, test_i2c_bus_guard.py]
2026-09-26 Make the I2C guard status file readable by pi (0644)
    tempfile.mkstemp creates 0600 and the guard runs as root, so the dry run
    on the robot left /tmp/i2c_guard_status.json unreadable to `pi`: the
    doc's plain `cat` failed and the web UI (runs as pi) could not use it.
    fchmod to 0644 before the atomic replace.
    [i2c_bus_guard.py, test_i2c_bus_guard.py]
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2026-09-28 Hold the heading the operator last chose in MANUAL with a GPS lock
    With the GPS heading offset locked, the MANUAL straight-drive block
    re-applied a true-frame target, captured at straight entry, on every
    tick. The straight latch survives stick pulses (0.8 s hysteresis,
    |steering| <= 0.18 counts as straight), so the target never followed
    the operator's turns, and it overwrote the compensator's re-capture on
    each return to neutral. Each time the sticks evened out, heading hold
    drove back toward the old heading at up to the 35-byte cap.
    Field, 2026-09-27: RTK fixed at 16:52 locked the offset (+22.5 deg).
    At 17:32 the operator held right stick for 52 s and the robot still
    turned 27 deg left aga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
    [test_manual_heading_hold_retarget.py]
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2026-09-28 Make stick expo ratio-preserving and keep steering intent linear
    Review of 79c3cad found two defects in per-track expo:
    1. steering_input (heading-hold neutral test, straight latch, IMU blend)
    came from the expo-shaped bytes, but its thresholds are tuned for
    linear sticks. Gentle turns read as straight and the hold fought
    them: in a closed-loop sim of the real controller and compensator,
    64-120 deg turns in 4 s became 4-8 deg.
    2. Near full stick, per-track expo amplified a small stick difference
    about 2x (1900/1800 us: 123 deg in 4 s against 81 linear, at up to
    1.6 m/s).
    steering_input and the arms-up twitch stick band now read the linear
    stick bytes (expo would widen that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
    [test_auto_disarm_controller.py, test_controller_stick_expo.py, test_manual_heading_hold_retarget.py, test_mapping.py]
2026-09-28 Docs: record the pull-left fix, MANUAL obstacle curve, stick expo and Wi-Fi block
    NEXT_SESSION.md section 4 item 0 and CLAUDE.md gain the 2026-09-27
    evening changes: the GPS-locked heading-hold stale target, the MANUAL
    throttle curve for netting over the lens (person ranges keep the old
    law), the ratio-preserving stick expo, and the NetworkManager
    no-secrets Wi-Fi block with its stopgap. The reconnect watchdog is not
    on main; its review findings are listed for the rework.
2026-09-28 Remove the person/animal cap from the MANUAL obstacle curve
    Kevin's decision (2026-09-27), from his safety principle now in
    CLAUDE.md: human input can carry a little extra risk, autonomous input
    must not cause human harm. In MANUAL he stops the robot by letting go
    of the stick; disarming in the autonomous modes takes much longer.
    This reverts 3656bc0 and ce510f7. The cap made the relaxed MANUAL curve
    fall back to the old law near people and animals. Review found it
    leaky twice (animals and unranged persons are not masked out of the
    corridor; a hand or an animal's head reaches ahead of the range point),
    and it turned the netting relief off whenever the camera saw Kevin near
    the robot but cou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
    [oak_depth.py]
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2026-09-28 Add a Wi-Fi reconnect watchdog for NetworkManager's no-secrets block
    2026-09-27 17:35-18:13: at the edge of range NM 1.42 failed three
    association attempts, marked the profile "no-secrets", and blocked its
    autoconnect until reboot. The Pi stayed up, came back into range at
    18:05, and stayed off the network until a power cycle. Wi-Fi is its
    only IPv4 path. NM clears that block only when a secret agent
    registers, networking restarts or the profile reaches IP config; the
    300 s retry timer does not, and a drop during the WPA 4-way handshake
    takes the same path even with auth-retries 0.
    bin/wifi_watchdog.py (root, wifi-watchdog.service, installed by hand
    with bin/install_wifi_watchdog.sh) acts w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
    [test_wifi_watchdog.py, wifi_watchdog.py]
2026-10-04 Remember which Wi-Fi profiles have reached the gateway
    The "gateway answered" flag was per connection. A failed nmcli read, a
    Wi-Fi blip, or a reboot during a router outage cleared it, and the
    dark-gateway path then bounced a good link. The set of profile UUIDs
    now lives in /var/lib/wifi-watchdog/state.json, and a failed nmcli read
    skips the tick.
    The profile test accepts a valid ARP entry when ping fails, same rule
    as the watchdog. The runbook says to read that test after 6 minutes,
    and to leave preconfigured auth-retries at 0 until a fallback profile
    passes. 33 unit tests pass. A mutation check kills each reviewed bug.
    Co-Authored-B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
    [test_wifi_watchdog.py, wifi_watchdog.py]
2026-10-04 Do not clear the offline clocks on a failed UUID read
    _connected cleared offline_since and idle_since, then returned when the
    CON-UUID read failed. One bad read restarted the 120 s idle timer while
    the radio was still down. Read the UUID first and return before any
    assignment. Review of e31067b (session 01a107e5-1958-7b80-8f55-8367280ca739).
    [test_wifi_watchdog.py, wifi_watchdog.py]
2026-10-08 Detect a hung OAK vision worker and restart the service while disarmed
    The colour-stall watchdog's third restart on 2026-10-04 13:41 called
    pipeline.stop() and depthai's teardown never returned. The worker thread
    sat in C++ for four days with pipeline_running True; the supervisor runs
    inside that thread, so nothing rebuilt the session. Depth was four days
    stale, so MANUAL drove at the 10 percent stale floor ("extremely slow")
    and FOLLOW_ME was refused, with only the status line's scl=0.1 as
    evidence.
    get_health() now reports vision_hung when neither the session loop nor
    the supervisor heartbeat has ticked for vision_hang_s (30 s), or the
    thread died, while nobody asked it to stop. The heart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
    [oak_depth.py, test_oak_vision_hung.py, test_vision_hang_monitor.py]
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2026-10-09 Add an operator netting mute for the MANUAL depth corridor
    Electric-fence mesh netting loaded on the robot hangs over the lens and
    is a solid wall at 0.40-0.50 m to the stereo camera: in 60 raw frames
    97-98 percent of the valid corridor pixels sit at 0.35-0.65 m, so the
    MANUAL obstacle curve held Kevin at 0.3-0.4 throttle for 81 m of
    driving. Depth cannot tell the mesh from a wall, and an automatic "the
    wall moves with us" latch was rejected in review: a close person YOLO
    misses, wheels slipping in front of a real wall, or anything being
    pushed satisfies the same test.
    The mute is explicit. The operator taps "NETTING LOADED" on the phone
    (POST /api/manual/netting_mute) with the netting alre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
    [oak_recorder.py, oak_viewer.py]
2026-10-09 Docs: depthai 3.3.0 teardown abort is a self-join fixed in 3.6.1
    Record the research on the 2026-09-26 abort crash loop and the
    2026-10-04 hang: the abort is Node::stopPipeline() dropping the last
    Pipeline reference on a node thread (EDEADLK in ~PipelineImpl), fixed
    upstream in v3.6.0; the hang is plausibly an XLinkInHost reader parked
    without a timeout during teardown. List the ranked next steps (upgrade,
    stop then wait on the worker thread, bounded helper-thread teardown).
    Also note that the 1.78 GB idle run log is by design.
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2026-10-17 Docs: do not raise the Pi USB current limit; the hub backfeeds, fix the cable
2026-11-04 Add walle-ups: UPS HAT (B) mains-loss halt with RTC-alarm wake
    The UPSPlus HAT is retired. The Waveshare UPS HAT (B) has no MCU and no
    charger IC: its 8.4 V jack is wired straight to the 2S pack node, the
    only sensor is an INA219 at 0x42 on the battery shunt, and the 5 V output
    stays on after a halt. bin/walle_ups.py (walle-ups.service, root) halts
    the Pi after 5 s of battery discharge (<= -250 mA with the pack at or
    below the supply setpoint), killing wall-e first and arming the RTC
    alarm; walle-ups-wakecheck.service re-checks on every boot before
    basic.target and powers off again while mains is absent, failing open on
    any doubt. Needs POWER_OFF_ON_HALT=1 / WAKE_ON_GPIO=0 in the bootloader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
2026-11-04 Retire the UPSPlus code, point the dashboard at walle-ups, apply the audit fixes
    UPSPlus: delete scripts/upsPlus_power_daemon.py, its seven tests and two
    bench docs; run_main.sh no longer probes I2C 0x17/0x18; docs/services.md
    lists walle-ups, walle-ups-wakecheck, the I2C guard and the Wi-Fi watchdog
    with their install scripts. The /debug UPS panel and read_ups_status()
    now read the walle-ups/1 status schema (input, batt_v, batt_ma, soc_pct,
    state, mode, halt_enabled, last_loss) and show a blind watcher as STALE.
    Audit (12 contradictions found by a read-only review, fixes chosen by
    Kevin): ch5 e-stop halts the OS, so the field plan and the GPS heading
    doc no longer promise a drive home afte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
2026-11-04 walle-ups: the shunt is 10 mOhm, not 0.1R; add simulate-loss
    The first bench unplug (2026-11-03 20:51) read -52 mA for a Pi drawing
    about 0.6 A and sat in the hold band, so the Pi stayed up on the pack.
    The schematic's 0.1R label is wrong by ten: the brick-connected trickle
    is +40..+150 mA and the unplugged Pi reads -520..-910 mA at 10 mOhm.
    Default shunt 0.01 ohm, present band >= -80 mA (floating noise is
    +/-40 mA at this scale), regression tests from the logged register
    values. `walle_ups.py simulate-loss --yes` fires the real kill/alarm/
    poweroff sequence with mains connected to test the wake chain without a
    plug pull. Docs and CLAUDE.md carry the corrected numbers and the cell
    finding: t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
2026-11-04 Add the Pi 5 power module spec (60 V input, 14 V outputs, 2S buffer)
    Research draft for the board that replaces the UPS HAT (B): a surge
    stopper and a 150 W brick on the 13S pack, a 14 V rail with two smart
    high-side outputs, separate 5 V rails for the Pi and for the USB
    devices (no backfeed into the Pi), a resistor-set 7.60 V charger with a
    scheduled 8.40 V balancing top-up, and a module MCU that halts the Pi,
    cuts its 5 V and applies it again when the pack returns, so the RTC
    polling goes away. Written by a Fable agent with three Grok second
    opinions recorded in its appendix.
    Review fixes before commit: the 8.40 V top-up switch now adds a
    resistor in parallel with the lower feedback resis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
2026-11-04 Power module spec: 13.2 V rail on a Murata quarter brick
    Kevin chose a 13.2 V rail, peak ratings and smart FET outputs, and asked
    why the board cost so much. The TRACO TEP 150 was half the BOM and had
    been priced from memory at 160 USD; DigiKey lists it at about 268 USD
    with a 19-week lead time. A Murata HPQ-12/25-D48 quarter brick (300 W,
    94.5 percent, about 100 USD, in stock) trimmed +10 percent lands on
    13.2 V, carries the 10 A tap and the Pi together, and cuts the worst
    brick heat from 22 W to about 10 W. Spin 1 drops from about 325 to
    about 265 USD; spin 2 stays about 190 USD.
    A Grok second opinion agreed and listed holes, now in the spec: the
    36 V input floor under motor sag (threshol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
2026-11-04 Power module spec: cheap golf-cart converter as a bench-tested option
    Kevin found a 48 V to 12 V 20 A golf-cart converter for about 25 USD.
    A Grok second opinion rejected it for spin 1: protecting its 60 V input
    would mean lowering the surge clamp to about 58 V, which makes the
    stopper absorb ordinary regen on a full pack, and with no datasheet its
    failure modes cannot be specified. The Murata brick stays the default.
    The board gains an optional 12 V IN connector (fuse, TVS under 28 V,
    15 V overvoltage disconnect) and bench test T-17, so the cheap unit can
    be tried without a respin once it survives 68 V and a short on the
    bench.
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2026-11-04 Power module spec: off-the-shelf 12 V converter off the board
    Kevin chose an off-the-shelf converter ("we're going to use something
    off the shelf") and doubted the 68 V clamp. He is right that the pack
    cannot reach 68 V; bus overvoltage happens only when the cells are not
    absorbing it (a hot-plug ring, or regen with the BMS charge path open),
    which is a robot-level problem for the VESCs and every converter.
    The 12 V rail now comes from a potted golf-cart converter rated for
    72 V carts, bolted to the chassis. The board carries no pack power: a
    thin pack-sense lead feeds VIN_OK, and the 12 V comes in through a fuse,
    an SMBJ15A and a 100 V LTC4368 disconnect (15.0 V / 10.5 V). The surge
    stoppe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
2026-11-04 walle-ups: fixes from the Opus review of the new loss rules
    The third Grok pass timed out, so a Claude Opus subagent reviewed d6f41d9.
    Fixes for its findings:
    - The boot check decides "low pack" from the voltage at boot, not the
    chain's stored kind: on 75 % of the samples at or below 7.0 V,
    whatever the current, it powers off with the 600 s alarm and never
    caps. A floor halt on 1 ohm cells can happen with the pack near 8 V at
    rest, and a pack at 6.9 V drawing -200 mA used to fail open into a full
    boot. A present supply holds the pack at S, so this cannot lock a live
    supply out.
    - Band readings count at boot inside any chain except a simulated one
    (critical included), still unde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
2026-11-04 Docs: the 7.5 V real-pull test with the new rules passed
    Held 17 min while the pack sagged from above the supply, clean hard
    halt at 7.18 V, 18 alarm wakes powered off on band readings inside the
    hard chain, and the boot continued within 75 s of the replug.
2026-11-04 walle-ups: hysteresis on the hard loss line
    In the 2026-11-04 pull test the pack hovered at 7.14-7.27 V around the
    7.20 V hard line for 6 minutes, and the 10 s gap reset kept restarting
    the loss count. A count still starts only below S - 0.30 V; while it
    runs (its last counted sample is within the gap), a discharging sample
    below S - 0.20 V also counts. A present sample or the gap ends it, and a
    stalled loop cannot restart a stale count through it.
    Tests replay the field dither (halts in 5 s with the hysteresis, not
    without), the release level, the end of a count, and a stalled loop.
    Grok review 01a1a82c: no findings.
2026-11-04 walle-ups: in a loss chain, ignore band readings from a supply below the pack
    On 2026-11-04 a supply swap halted the Pi and opened a hard chain. The
    robot buck then held the pack at 7.496-7.512 V, but the cells rested near
    7.8 V and still pushed -270..-305 mA, so every wake read "outage going on"
    and the Pi polled until the 24-wake cap (30 min). A real outage in the
    same chain read 7.30-7.35 V at -567..-600 mA.
    Inside a chain, a band sample now counts toward powering off only if the
    pack discharges at 400 mA or more AND its voltage is not pinned within
    0.03 V of the setpoint (a present CC/CV supply pins the node at S; Grok
    review 01a1a857 showed the current cut alone fails for a fuller pack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
2026-11-04 Docs: the robot buck swap booted on the first wake with a069476
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2026-11-05 Docs: raw-serial proof that the RC ch3/ch4 fault is upstream of the code
    With wall-e stopped, the Arduino's own CSV shows ch3 and ch4 moving
    together for one 40-80 ms frame group per transmitter button press and
    resting near 1504. On 2026-10-08 ch3 and ch4 were independent and ch3
    held 2000 while armed. Record the effect on arming and correct the
    10-17 note that said MANUAL needs 0.3 s of ch3 high.
2026-11-05 Power module spec: option A (Pi on the main pack, ignition gate, grace timer)
    Revise docs/power_module_spec.md to option A of
    docs/pi_power_architecture.md, which wins on any conflict.
    - The Pi gets 5.1 V from an isolated 75 V / 100 V-surge brick (TRACO TEN
    30-4811WIN class; RECOM RP30-4805SFW/N, TEN 20-4811WIN as options) on
    the battery side of the main switch, behind F3 and a P-FET high-side
    switch, so the brick is disconnected in storage (under 10 uA leakage).
    - ENABLE = ignition OR (Pi 3V3 AND NOT grace expired). The ignition is
    sensed from the switched side only, through PV and phototransistor
    optos on their own fuse; the battery side has no galvanic link to
    anything. A 74H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
2026-11-05 Docs: RC button truth table from a raw serial capture
    Each press of button 3 or 4 reaches the Arduino as one short pulse on
    both ch3 and ch4 (3 low, 4 high), never a latched level, while a held
    stick reads steadily. Correct the 10-09 note that called ch1/ch2 dead.
2026-11-05 Docs: RC fault root cause is the DS600 V3 CH3/CH4 hybrid mode
    The remote's LCD shows both mix icons. Record the V3 power-on combos
    (hold 3 cycles the mixes, hold 4 is channel reverse), the state left
    tonight and the check for tomorrow.
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2026-11-05 Docs: stand motor test, bus voltage and UPS under load
    Full-speed driving, a reverse step and hard stops on the stand moved
    the bus 0.5 V at most and never pushed the UPS watcher out of present.
    Mark the result as the mild case: free wheels, a pack that was not
    full and a 48 Hz sample.
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2026-11-05 Review option A power spec: bus overvoltage gate, heat and hot-plug fixes
    Hardware review of docs/power_module_spec.md (option A) against the
    VESC facts measured 2026-11-04/05 (l_max_vin 90 V, regen cutoff off,
    -40 A regen, right VESC on 12 cells) and the TRACO, Vishay, TI and
    Toshiba datasheets.
    - 3.2a: with the fault at 90 V a full-pack stop can hold the bus above
    the SMBJ58A breakdown; the TVS burns and F3 opens (hard Pi cut while
    driving), and the brick sees >75 V for >100 ms. List the conditions
    before the brick goes on the bus: regen cutoff, l_max_vin ~61 V,
    13 cells, T-2 at 1 MS/s before fitting, dump clamp if T-2 fails.
    - TLP293 dark current (50 uA at 85 C) made IGN_OFF read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
2026-11-05 Add RC arm-channel fail-safe: arm persistence and mid-band disarm
    From 2026-10-09 to 2026-11-05 the HotRC DS600 V3 had its CH3/CH4
    hybrid (jog) mix on. ch3 then rested at ~1500 us and reached ~2004 or
    ~1000 only in one 40-140 ms burst per button press. Level arming armed
    on one high burst and held the arm while ch3 sat mid-band, so only a
    lucky one-frame low burst could disarm the robot. The 2026-11-04 logs
    show 2.5-15 s armed on a dead switch, once in FOLLOW_ME after a single
    press (arm_20261104_194325).
    update_safety now:
    - arms only after ch3 >= 1800 us on every tick for
    SafetyParams.arm_high_persist_s (0.2 s). Every hybrid high burst in
    the logs is one logged tick with mid-band 103-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
2026-11-05 Fix arm fail-safe review findings: monotonic clock, burst refresh, e-stop
    An independent Grok review of 489c440 found three defects.
    1. Time base. The run timers and the debounce used the wall clock
    (now_epoch_s = time.time()). The Pi has no RTC battery and NTP steps
    the clock after boot: a forward step during one high frame satisfied
    arm_high_persist_s on the next frame (one hybrid burst could arm),
    and a backward step postponed the mid-band disarm. update_safety now
    takes now_mono_s and runs every safety timer on it; the controller
    passes its mono_now, and force_disarm and the RC-stale rebuild stamp
    the monotonic clock. SafetyState.last_transition_epoch_s becomes
    l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
2026-11-05 UPS doc: main-switch pull with the VBUS-cut hub cable
    The HAT current after the pull fell from 1.1-1.6 A to 0.79-0.85 A, and
    the pack stayed at 6.68 V or above, so the normal absent halt ran instead
    of the critical rule. The hub no longer back-powers from the Pi.
2026-11-05 Docs: OAK at USB 3 after the plug turn-over, charger measured from the BMS log
    The camera links at 5000M with its USB-C plug turned over; latency is
    unchanged. The charger holds about 54.4 V in its constant-voltage stage,
    so it is correct. The old 4200 mV limit tripped at 1.0 A and the trip
    stays latched with the cells resting at 4.18 V, so the overvoltage
    release must sit above the resting full cells.
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2026-11-05 Log VESC bus voltage, currents and a peak-hold in the per-tick vesc block
    Regenerative braking pushes energy onto the 13S bus; with the BMS charge
    FET open the bus can rise toward the VESC 90 V over-voltage fault. The CAN
    driver already parsed STATUS_4/STATUS_5 but nothing reached the run log, so
    the planned stand test had no data.
    Per side the vesc block now has l_/r_bus_v, l_/r_bus_a (input current,
    negative = regen) and l_/r_motor_a, plus a peak-hold since the previous
    written line: l_/r_bus_v_max and l_/r_bus_a_min. The driver tracks the
    peaks under its existing lock in the STATUS parsers (it sees every frame)
    and take_bus_peaks() returns and resets them; main.py calls it only when a
    lo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
2026-11-05 Make the OAK pipeline safe across the depthai 3.6.1 upgrade
    depthai 3.6.1 changes the IMU RAW reports from the RDF frame to the
    sensor frame (UNCALIBRATED is the old RAW) and runs AutoCalibration by
    default. The yaw channel and the boot gravity check assume RDF, and the
    corridor geometry assumes the factory calibration, so either change
    could move the robot's heading or geometry without an error.
    - Pick the IMU report by depthai version: RAW before 3.6.1 (3.3.0 has no
    ACCELEROMETER_UNCALIBRATED), UNCALIBRATED from 3.6.1.
    - Default DEPTHAI_AUTOCALIBRATION=OFF before depthai is imported.
    - Log depthai version, USB speed, IMU reports and the autocalibration
    setting once per OAK session at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
2026-11-05 Fail closed on an unparseable depthai version; export the autocal default
    Grok review: when the version string cannot be parsed, choosing RAW
    would put the yaw on the sensor's own axes on 3.6.1+. Decide from the
    IMUSensor enum instead (ACCELEROMETER_UNCALIBRATED arrived with the RAW
    change). run_main.sh now also exports DEPTHAI_AUTOCALIBRATION=OFF for
    the service. Record the review's open items in docs/depthai_upgrade.md.
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2026-11-05 depthai upgrade doc: bench results on 3.3.0 and 3.6.1
    3.6.1 RAW reverses Y and Z against the old RAW, so gyro_y changes sign;
    3.6.1 UNCALIBRATED matches 3.3.0 RAW. Intrinsics, USB speed and the
    autocalibration default are unchanged.
2026-11-05 Docs: wall-e runs depthai 3.6.1; unplug and heading sign tests passed
    The camera unplug no longer aborts wall-e; the session reconnected in
    about 7 s at USB 3. A hand turn right moved the heading +90 and the turn
    back -91. Latency is a little lower (p50 0.183 s). The requirements pin
    is still 3.3.0, pending a restart window.
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2026-11-06 Cap the OAK at USB 2: its USB 3 link jams the RTK GPS
    Measured outdoors on 2026-11-06 with the antenna within 30 cm of the hub:
    OAK streaming at USB 3 gave 10-11 satellites and no RTK while tracking,
    and 0 satellites for 4 minutes from a fresh GPS start (also with the cut
    extension's shield repaired). At USB 2 the GPS held 32-34 satellites with
    RTK float. The plug orientation picked the speed on this cable, so the
    cap is now OakDetectionConfig.max_usb_speed = "HIGH", applied when the
    session opens the device; the startup line shows the cap.
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2026-11-06 Add log-only VIO to wall-e's camera session (off by default)
    OakDetectionConfig.vio_enabled adds a BasaltVIO node that shares the mono
    outputs and the 100 Hz IMU and logs pose, heading change and path to a new
    "vio" log block. It has no control authority.
    BasaltVIO needs the RAW IMU reports on depthai 3.6.1 and the IMU node has
    one accelerometer and one gyro slot, so with VIO on wall-e requests RAW and
    _poll_imu negates y and z, which reproduces the UNCALIBRATED (RDF) values
    the heading uses (measured on this unit). With VIO off the session is the
    same as before. VIO inputs drop instead of blocking; a VIO build or start
    failure, or repeated short VIO sessions, disable VIO until restart so t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
2026-11-06 VIO bench: correct IMU path, but it costs a third of the depth frames on USB 2
2026-11-08 RTK runbook: parked-rover PV correlation, 09-19 counterexample, PV-only test
    On 2026-11-07 the rover sat at one spot for 5.5 h with corrections
    all day and fixed only when PV power fell to about 100 W; the battery
    inverter carried the AC load all evening while it held the fix, so the
    AC side is not the noise source. The 09-19 first fix (15:27 CDT, sunny
    day) predates the journal lines, so 'only near sunset' was too strong.
    The test now cuts PV input only, off/on twice, at the 11-07 spot.
    Also record the panel layout and the 11-08 80-minute corrections gap.
2026-11-08 RTK runbook: base runs off the container solar; monitor recommendation
    Kevin confirmed the base is powered by the container solar system, so
    noise can be conducted through its supply and the 11-04 container
    blackout restarted its survey-in. Record why a power-bank swap is not a
    good first test, and recommend a listen-only tap on the base serial line
    as the networked monitor.
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2026-11-08 RTK runbook: pick the 915 MHz listener board and its decode limits
    Heltec WiFi LoRa 32 V3 (US915) for the receive-only listener: the V4's
    amplifier front end buys nothing at 90 m. Record the receive-only rule,
    the V3 power and RF-switch setup, and why a decode can fail while
    channel activity still fires.
2026-11-10 Docs: status audit of 2026-11-10 and corrections to stale statements
    Add docs/status_audit_2026-11-10.md: the result of an audit of the
    documents against the code (eight open safety gaps in priority order,
    the pack-low latch that cannot trip, the UPS battery incident of
    2026-11-08, what is not working, and what waits for Kevin).
    Correct statements that the code has overtaken in 17 documents: the
    motor byte range, the UPS wake-check and run-mode alarm times, the
    one-sided band rule, the USB 2 cap, the depthai 3.6.1 pin, the retired
    UPSPlus and /api/teleop paths, the arm fail-safe, and the BMS targets
    that Kevin confirmed as applied. Record his rulings of today: the
    east-field plan is still w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
2026-11-10 UPS doc: review the USB 3 shielding list against a live measurement
    Kevin asked if the earlier list (foil on the hub and the OAK cable, a
    plate under the antenna) is still the right plan. At USB 2 the hub's
    USB 3 side is in runtime suspend, so the good GPS result there does not
    identify the part that radiates. Record a revised order: check that
    USB 3 has a task, replace the cut extension, isolate the part, then
    repair it. A recommendation only; Kevin has not decided.
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2026-11-10 Status audit: odometry on the recent drives, GPS odometry frame defect
    An agent pass over the armed logs of 2026-11-04 to 2026-11-08, checked
    against the code. GpsOdometry keeps a math-angle heading, but its
    camera_to_world and pure pursuit use a clockwise frame, so trail
    pursuit steers the wrong way after a pivot (confirmed with the repo
    classes). Its heading is the boot-relative gyro. Three FOLLOW_ME paths
    use it; none ran in the 55 armed logs. Also: wheel speed reads 20 to
    25 percent above GPS ground speed, and the heading lock never engaged.
    Recommendation recorded, not applied: trail_follow_enabled False.
2026-11-10 Follow-me: turn trail following off until GPS odometry is repaired
    GpsOdometry keeps a math-angle heading, but its camera_to_world and
    pure pursuit use the clockwise dead-reckoning frame, so trail pursuit
    steers the wrong way after a pivot (+6.6 bytes where -1.8 is correct
    with the repo classes). Its heading is also the boot-relative gyro.
    GPS odometry is selected whenever the GPS has a fix, and it fed trail
    pursuit beyond 5.2 m, blind trail pursuit after a lost target and the
    search-pivot direction. None of those paths ran in any armed log.
    With trail_follow_enabled False the trail, the odometry objects and
    pure pursuit are not built. FOLLOW_ME is direct pursuit only, and a
    lost target get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
2026-11-10 Limit the waypoint API speed and radius; a refused start changes nothing
    /api/nav/start and /api/nav/go wrote the client's cruise_speed and
    arrival_radius into nav._cfg with no limit: 127 is full speed, a negative
    value reverses, and the value stayed for later missions.
    Now both routes validate with _parse_nav_params. A present value must be a
    finite number; a negative speed or a radius <= 0 is refused with HTTP 400 and
    a JSON error, and anything else is clamped to the slider range. The page's
    slider min/max now come from the same _SPEED_SLIDER_RANGE and
    _RADIUS_SLIDER_RANGE constants (placeholders in the template), so there is one
    definition. A start refused by activate_waypoint_nav (409)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
2026-11-10 Run the RC-stale watchdog and the phone override age on the monotonic clock
    Controller.process computed rc_age = epoch_now - rc.last_update_epoch_s.
    This Pi's wall clock steps at boot (the RTC resets when 5 V drops, then
    NTP corrects it), and a backward step made a dead RC link look fresh. The
    phone/SPP override age in main.py had the same epoch arithmetic and no
    lower limit, so a negative age passed as fresh.
    - ArduinoRCReader stamps each frame with time.monotonic()
    (RCState/RCInputs.last_update_mono_s replaces last_update_epoch_s).
    - Controller.process compares that stamp with its mono_now. A negative or
    non-finite age is stale. 0.0 keeps its meaning "no frame yet" (centred
    sticks,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
2026-11-10 Stop WAYPOINT_NAV when its heading reference is lost, stale or stuck in ALIGN
    Status audit 2026-11-10, item 3:
    (a) An OAK reconnect during a run makes _check_imu_frame_continuity reset
    the GPS heading offset to 0, and the run went on in the raw gyro frame
    because the lock was checked only at activation.
    (b) waypoint_nav_activation_blocked skipped the fix-quality check and the
    lock check when no GPS reading existed yet (e.g. after a restart).
    (c) ALIGN had no timeout, and nothing checked that the heading was fresh.
    Now:
    - _leave_waypoint_nav_if_unsafe runs every tick before the command is
    computed, next to the follow-me vision-stale exit, and uses the same
    exit as the other W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
2026-11-10 Leave WAYPOINT_NAV on a stale detection stream, as FOLLOW_ME does
    Status audit 2026-11-10, item 4: FOLLOW_ME leaves when the detections are
    older than OakDetectionConfig.vision_stale_s (1.5 s), but WAYPOINT_NAV
    did not. With the colour camera stalled, a run continued on the depth
    corridor alone and the person stop was blind. No control code read
    color_stall_fault or detections_stale.
    WAYPOINT_NAV now reuses the follow-me freshness source
    (OakDepthReader.get_detection_freshness via _vision_is_stale, sampled once
    per tick, fail-closed on a getter error) in the per-tick guard added for
    item 3: reason vision_stale, mode MANUAL before the command is computed,
    the sticks are the target and the sl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
2026-11-10 Docs: record the five corrections of 2026-11-10 and the IMU stall finding
    Items 2, 3, 4 and 5 of the status audit are corrected and deployed
    (2ebdace, eea14b5, cd6c9ee, 8bfbfb5, 949c0b4). Record what each one
    changes, what was checked on the robot, and what is not verified
    (arming with the transmitter on). Record the new gap from the logs of
    2026-11-07: the OAK IMU stream stopped without a fault for 38.8 h. Its
    correction is prepared and not deployed. Record the state of the
    person stop hold (three failed safety reviews, a simpler design in
    work) and of the GPS odometry repair.
2026-11-10 Restart the OAK session when the IMU stream stalls with depth live
    On 2026-11-06 19:34:37 the BMI270 stream stopped reaching the Pi in the
    middle of a healthy session, with no error. Depth and detections kept
    running, so nothing ended the session: the heading stayed frozen for
    38.8 h, through two drives, until an unrelated colour-stall rebuild on
    2026-11-08 brought the IMU back in the same process.
    The session loop now ends the session, after the IMU poll, when no IMU
    message has arrived for imu_stall_restart_s (10 s) while depth is newer
    than imu_stall_depth_fresh_s (1.5 s) and the session is past its warm-up
    (10 s). The supervisor rebuilds it exactly as for a colour stall: the
    loop breaks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
2026-11-10 Stop the heading hold while the IMU heading is stale; re-capture on recovery
    From 2026-11-06 19:34 to 11-08 10:21 OakImuReader reported the heading
    frozen ("stale") on every read, but ImuSteeringCompensator kept
    is_available True and kept computing a correction from the frozen
    heading. A turn in progress when the stream died pins the correction at
    the 35-byte clamp for as long as the stream stays dead: nothing the robot
    does can change the error.
    update() now returns no correction while the reader reports its heading
    stale (integrate_status "stale", or an infinite sample age = never
    sampled), and the integral, D-term filter and anti-windup flag are
    cleared. Neutral/steering tracking keeps r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
2026-11-10 Alarm on a stale IMU: health fields, per-minute journal line, status line, JSON events
    The 2026-11-06 dead IMU stream left one journal warning and nothing else
    for 38.8 h: get_health() had no IMU field, the 5 s status line printed a
    normal-looking "IMU 0°→0°", and the JSON log had no event.
    - get_health() (and so /api/telemetry camera_health) gains imu_age_s,
    imu_stale (OakImuReader's 0.5 s stale age, imported, so both mean the
    same) and imu_watchdog; imu_stall_restarts / imu_stall_fault came with
    the watchdog. is_stale is unchanged: it stays the vision health, so a
    short IMU drop does not flap the camera transition line.
    - OakImuReader repeats its stale WARNING every 60 s while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
2026-11-10 Docs: the IMU stall corrections are deployed
    185f239, 67b3f04 and 07cbc74 are on the robot (17:05 to 17:15). Record
    what each one does, the checks on the robot, and what only a real
    stall can show.
2026-11-10 Hold the person/animal stop until its object is seen beyond
    The 0.8 m stop in _apply_safety_tier_override is decided again at every
    depth poll with no memory. Inside ~0.4 m the box is clipped by the frame
    edge, the depth sample fails or reads the background through the clipped
    box, the box is narrower than the 0.40 width backstop, and the corridor
    ignores pixels at or below 350 mm. One bad frame released the stop on
    2026-11-08 14:27:40 (FOLLOW_ME, 0.66 s with Kevin 0.3-0.9 m away).
    PersonStopHold (pi_app/control/person_stop_hold.py) keeps the published
    obstacle distance at 0.0 after a trigger in FOLLOW_ME / WAYPOINT_NAV, or a
    carry-in of a trigger at most 1.0 s old on entry to those modes.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
2026-11-11 Odometry: one frame contract for both odometries and every consumer
    GpsOdometry kept a counter-clockwise math angle (0 = east) while its
    camera_to_world and PurePursuitController used the clockwise
    (-sin, cos) "right" vector, so after a pivot trail pursuit steered the
    wrong way (3 m ahead / 1 m right, 30 deg right pivot: +6.6 bytes, should
    be negative). Its update_gyro also overwrote the fused heading with the
    boot-relative gyro every tick, so the course-over-ground blend lasted
    one tick and the frame was 59-78 deg off the true GPS positions.
    The contract now lives in one place, pi_app/control/odometry.py: +y is
    90 deg clockwise of +x, theta clockwise-positive (= radians of the
    OakImuReader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
2026-11-11 Follow-me: build the trail from one valid odometry, dead reckoning by default
    _pick_odometry chose GPS odometry whenever it had a fix and dead
    reckoning otherwise, per tick, so one trail could mix points from two
    world frames. It now uses one source, FollowMeConfig.trail_odometry_source
    (default "dead_reckon"), returns None while that source offers no valid
    pose, and clears the trail and pure-pursuit state when the source's
    frame epoch changes.
    Why dead reckoning: on 30 s windows of the 2026-11-06/08 drives its
    end-to-end error against the GPS track was 0.85 m median / 2.3 m p90
    over a 16.6 m path, with the existing 0.0100 m/s/byte scale (best fit
    0.0100-0.0105; the VESC eRPM speed, not the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
2026-11-11 Follow-me: keep get_status read-only for the trail odometry
    get_status called _pick_odometry, which clears the trail and resets pure
    pursuit on a frame-epoch change. Status is read by telemetry/SSE threads
    between control ticks, so a status read could wipe the live trail and
    race the control loop. The side-effecting call is now _tick_odometry,
    used only on the compute path; get_status uses _peek_odometry, which
    returns the selected odometry when its pose is valid and touches no
    trail, pursuit, _odom_source or epoch state.
    An unknown trail_odometry_source now raises ValueError at construction
    instead of silently using dead reckoning.
    Tests: status reads between ticks and right after a frame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
2026-11-11 Tools: keep the replay and analysis scripts of 2026-11-10
    These scripts existed only in a temporary folder of the session that
    made the corrections of 2026-11-10. Keep the ones that are useful
    again:
    - tools/person_stop_hold: replay of the hold on armed logs (holds,
    what releases each one, operator-only cases) and the numbers behind
    its plausibility limits.
    - tools/odometry_analysis: extract and measure odometry from armed
    logs, compare dead reckoning with GPS odometry, replay with trail
    following on, and the flag-off equivalence check.
    - tools/wait_deploy.sh: wait for the robot's auto-deploy and print its
    health (ancestry check, service state, tracebacks). The robot and
    the jum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
2026-11-11 Docs: log fields, phone command freshness and waypoint reasons of 2026-11-10
    logging_troubleshooting: person_stop_hold keys, IMU stall events, IMU health
    fields in the camera health block, waypoint_nav_exit_reason (telemetry and
    journal only; build_log_obj does not log it), the always-log-on-event rule.
    teleop and services: last_update_mono_s, boot_id and the 0 to 0.6 s monotonic
    freshness rule. gps_heading_alignment: the new start refusals and run end
    reasons.
    (cherry picked from commit b8e47fba834b3b8a00097777f5440dbf9a04935a)
2026-11-11 Docs: charger inhibit review of 2026-11-10 (audit item 7)
    The BMS link goes dark 45-62 min after the pack current reaches 0.0 A,
    which on this robot means the charger holds the float. The inhibit was
    on for about 6 % of the charger time. Recommends a persisted charger
    latch with a narrow operator override (option C) and a slew fix first;
    lists the decisions for Kevin. No behaviour change.
    (cherry picked from commit 39f98ce1d6689f63d5fa46195388925992ac9ca2)
2026-11-11 Docs: correct the 42 h figure for the dark BMS link
    The charger inhibit review of 2026-11-10 measured the link timeline
    from the journal and the logs. The link was up on 2026-11-07 from
    12:17 to 20:09; the dark periods on each side were 17.5 h and 16.5 h.
    The BMS sleeps 45 to 62 minutes after its current reaches 0.0 A.
2026-11-11 Docs: the eRPM wheel speed reads 1.23x the GPS ground speed
    Straight steady drives of 2026-11-04 to 11-08 show a constant scale error
    in the eRPM-to-m/s conversion, not slip: no dependence on motor current at
    2-4 A, the same ratio on five drives, two fix types and the March RTK
    calibration. Byte 254 is about 1.31 m/s on the ground. The document lists
    the consumers, the decisions for Kevin and the tape test.
    (cherry picked from commit b16ec89161e4963078461061ca955680c71b9f0e)
2026-11-11 Docs: record the work prepared in the evening of 2026-11-10
    Five changes are ready in local worktrees and are not deployed: two
    small corrections, the BMS link telemetry, the slew correction after
    an armed stop release, the pack-low latch, and the wheel ground scale.
    Record the branches, the reviews, the order for a deploy and the
    decisions for Kevin.
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2026-11-11 Safety: make the person/animal stop override total on malformed detections
    _apply_safety_tier_override runs on every depth poll; its caller's try drops
    the poll result on any exception. A non-numeric z_m, a malformed bbox or a
    broken detection object could raise there. Now it never raises: an unreadable
    or NaN z_m and a missing depth_status count as unknown depth (never "ok"), so
    the width backstop still applies; an unreadable box skips only that detection
    and the rest are still evaluated; a broken iterator fails safe to a stop.
    Well-formed input (bool z_m included) decides exactly as before: a 4000-case
    random comparison against the old function sits in the test.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
2026-11-11 Slew: ramp from neutral after an armed stop releases, never snap
    2026-11-05 09:31:19 the charger inhibit released with the stick held at
    full reverse and the next tick sent 0, 0. The charger-inhibit and
    pack-low branches called _reset_slew_state(), which sets
    _slew_seen_non_neutral = False, and the person-stop bypass (distance
    0.0) set it False when its output was neutral. With snap_first_command
    True (production), the first non-neutral command after the release then
    passed the slew limiter unramped.
    Add _hold_slew_at_neutral() (reset, then mark motion seen) for the two
    armed inhibit branches, and mark motion seen in the hard-stop bypass.
    Stops stay immediate; only the release now ramps at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
2026-11-11 VESC: scale eRPM wheel speed to the measured ground speed
    Add VescConfig.wheel_ground_scale 0.815 and apply it in erpm_to_wheel_mps
    (controller actual_speed_mps) and wheel_mps_per_byte. The nominal
    kinematics read 1.23x the GPS ground speed on straight steady drives
    (docs/wheel_speed_scale_2026-11-10.md). The geometry constants stay as
    labelled because the data cannot split radius, gearing and pole count.
    FollowMeConfig.speed_loop_mps_per_byte follows the derivation:
    0.012555 -> 0.010232. The follow-me loop is ratiometric, so bytes do not
    change inside the clamps; the 0.20 m/s correction clamp is now 19.5 bytes
    (was 15.9). Gains and caps are unchanged on purpose.
    Tests changed because they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
2026-11-11 Follow-me: scale the two m/s speed-loop clamps with wheel_ground_scale
    speed_pid_max_correction_mps 0.20 -> 0.163 and speed_integral_limit
    1.0 -> 0.815 (each x 0.815). They were tuned on 2026-09-19/20 in the old
    over-reading wheel units; scaled so they are worth the same motor bytes
    (15.9 and 11.9) and the validated behaviour is unchanged.
    speed_loop_mps_per_byte is now exactly 0.012555 x 0.815 = 0.010232325 so
    target, feedback and clamps all scale by one factor and the bytes match
    to float precision. TestIdenticalMotorBytes drives the old and new
    configs through a ceiling-saturating step, an integral-saturating
    sustained error and a mixed sequence: identical bytes on every tick.
    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
2026-11-11 Docs: the evening corrections are deployed; record Kevin's rulings
    The replay tool, the stop hardening, the slew correction and the wheel
    ground scale are on main. Record what each changes, the wheel scale
    units in CLAUDE.md, and Kevin's rulings: limp home on, no charger
    latch, the first command after a re-arm stays as it is.
2026-11-12 Tools: write the part A battery limits to the VESCs over CAN
    tools/vesc_battery_limits.py does what VESC Tool's "write motor
    configuration" does: read the live MCCONF, change only the bytes of the
    7 part A fields (battery current max/regen, battery cutoff start/end,
    regen cutoff start/end, cell count), prove every other byte is unchanged,
    and send it back with COMM_SET_MCCONF framed as comm_can_send_buffer().
    The firmware ignores a failed flash store and GET_MCCONF shows only the
    live config, so the tool then reboots the VESC (COMM_REBOOT) and requires
    it to go silent and come back with re-measured boot offsets before it
    compares the stored copy.
    Dry run unless --write. Gates, checked again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
2026-11-12 BMS: show a dark link and stale FET data (telemetry only)
    The BMS sleeps about an hour after the pack current reaches 0.0 A on the
    charger, and the journal then shows only the reconnect retries. Nothing
    said that the charger inhibit had failed open or that the discharge-FET
    value was old.
    Add BmsService.get_link_health() (pending/up/dark on the same 30 s limit
    as the fail-open check, plus the data age) and check_link(), which logs a
    WARNING on the dark and restored edges and every 10 min while dark. Carry
    link_state/age_s in the run-log bms block, bms_link_state/bms_data_age_s
    in /api/telemetry, BMS(dark Nm) in the status line, and one WARNING per
    armed session armed with a dark link. No in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
2026-11-12 Pack-low latch: disarm gives a fresh MANUAL-only window, countdown survives noise
    Fixes from the Grok review of the first commit
    (session 01a1c84b-44ed-7301-b110-f995aa75450e):
    - Stuck latch: a non-limp disarm cleared the latch but kept the elapsed
    countdown, so a pack resting below 44 V re-latched within one frame and
    only a restart cleared it. The disarm now restarts the countdown and the
    BMS cell count and starts a post-latch session: MANUAL only (FOLLOW_ME /
    WAYPOINT_NAV ramp to zero) until the trusted pack is back at 46 V with
    zero throttle. Limp, when enabled, adds the cap and the lower floors.
    - Missed latch: one untrusted, below-floor or above-threshold frame reset
    the 3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
2026-11-12 Pack-low latch: disagreement and a lone right reading cannot postpone it
    Fixes from the second Grok review (session
    01a1c854-0e2a-7930-b4be-33a796cae2de):
    - Sustained disagreement (> 1.5 V) counted toward the 2 s reset grace, so
    repeated 2 s spells of it restarted the 30 s countdown forever. Only a
    TRUSTED reading at or above the threshold (or below the floor) can clear
    the countdown now; untrusted samples neither latch nor clear, so the
    countdown keeps its start time (fail-safe).
    - A disagreement where even the higher reading is below the threshold now
    counts as low (the pack is low whichever VESC is right). It can only
    latch, never release.
    - The right VESC alone was trusted a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
2026-11-12 Pack guard: restricted state, start seed, and ramps both ways with the slew fix
    Lasting untrusted voltage (the third Grok review's open item,
    session 01a1c859-6bc1-7b03-953e-336870b9e53b): untrusted data still
    never latches, but a pack voltage that is not cross-checked for
    pack_voltage_untrusted_limit_s (10 s) now enters a RESTRICTED state:
    autonomous modes ramp to zero and MANUAL is capped at the limp speed
    (32 bytes, 0.40 m/s). Not cross-checked = stale, disagreeing, below the
    plausibility floor while frames arrive, or only one usable reader (the
    other VESC silent or frozen), because a lone reader stuck high cannot be
    caught. A lone reader still latches. It ends after
    pack_voltage_trust_co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
2026-11-12 Pack guard: unchecked time accumulates, no below-floor brake pulse
    Fixes from the Grok review of 7a1de67 (session
    01a1c86b-6cf3-7dd0-895c-916dd6c8ddc7):
    - One cross-checked sample reset the 10 s not-cross-checked clock, so
    9.9 s bad / 0.1 s good kept autonomy unrestricted forever. The clock is
    now forgotten only after pack_voltage_trust_confirm_s (2 s) of
    cross-checked readings in a row.
    - A below-floor frame sent RPM 0 from the RX thread while the control
    loop was driving, and the next tick restored the full command: a
    one-tick brake pulse. RPM 0 is now sent there only when the control
    loop is silent (the same rule as a trip).
    - The start seed is decided on the first trusted sa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
2026-11-12 Controller: a bad pack-guard limit value fails closed too
    The Grok review of 742ad34 (session 01a1c86f-f738-7fc0-927b-140673e5c93c)
    noted that int() of the driver's limit ran outside the try, so a
    non-numeric value aborted the tick instead of failing closed. Convert it
    inside the try; an exception or a bad value now means limit 0.
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2026-11-12 Pack guard: autonomous stops at once in a limp session, floor latch kept
    Fixes from the Grok review of the limp-home default (session
    01a1c89a-5aa0-78e0-b5b3-1c3d0e874fd8):
    - Switching to FOLLOW_ME / WAYPOINT_NAV during limp, post-latch or
    restricted only shrank the envelope over 1.0 s, so the robot kept
    crawling in an autonomous mode. Both the driver (set_tracks,
    get_drive_limit_immediate) and the controller (_apply_pack_limit) now
    go to neutral on the first autonomous tick. The controller also uses
    the polled guard status, so a failed context push cannot leave the cap
    in force. A latch trip still ramps.
    - Below the limp floor, a disarm cleared the latch for one control tick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
2026-11-12 Pack guard: switch the frozen-reader rule off; print a feed failure once
    Review of the branch against real data. The VESC bus voltages step in
    0.1 V, and at rest one VESC often holds one value while the other
    flickers between two. The frozen-reader rule (20 s) took that as a
    frozen reader, used one VESC alone, and so put the robot in the
    RESTRICTED state. A replay of the real VescCanDriver over every armed
    log of 2026-11-06 to 2026-11-08 and the parked night of 2026-11-10
    found about 1,600 frozen episodes and 404 RESTRICTED episodes (8,000 s),
    including about 5 minutes of armed MANUAL at the crawl cap (39 ticks
    where the operator asked for more). With the rule off the same replay
    gives no RE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
2026-11-12 Pack guard: fix the final-review findings (Grok 01a1cc96, 01a1ccba)
    - Start seed: decided on the first cross-checked sample. The RX loop
    checks after every frame, so the first sample was always one VESC
    alone and used the seed up; the seed now only moves a countdown earlier.
    - A lone reader can latch but never release a latch, end the post-latch
    session, or clear a running countdown: all three need both VESCs fresh
    and agreeing (a reader stuck high beside a silent one).
    - A fresh reader below the 30 V floor beside a plausible one is dropped
    and the other is used alone; both below the floor is "below_floor"
    even when they differ by more than 1.5 V, and it clears the countdown
    (a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
2026-11-12 Controller: autonomy obeys the pack guard; only a deliberate disarm counts
    Wiring review of the low-battery branch (Opus) and Grok 01a1ccd5, 01a1cce1:
    - FOLLOW_ME and WAYPOINT_NAV starts are refused while the driver's pack
    guard is latched, RESTRICTED, in a post-latch session, or unreadable
    (fail closed): web follow-me start, /api/nav/start and /api/nav/go
    (reason "pack_guard"), RC ch4, gesture ACTIVATE. A driver without
    get_pack_guard_status() is not gated.
    - A running session that is RESTRICTED, post-latch or unreadable stops
    AT ONCE and goes to MANUAL: the slew is pinned at neutral, so a held
    stick ramps up from neutral inside the 32-byte cap. Before, a frozen
    FOLLOW_ME res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
2026-11-12 Pack guard: keep the raw 3.0 V check as a backstop beside the averages
    Both reviews of the averaged comparison (Grok 01a1cde8, and an
    independent Opus review briefed with the data, not the author's view)
    came back "recommend with changes" with the same core fix. The average
    lags a step by about 0.2 s, so in that window a pair that the raw 3.0 V
    check of 6ec19b9 rejects was trusted. Opus demonstrated the harm: a left
    reader glitching to 43 V for one frame every 1.5 s on a healthy 50 V pack
    was trusted, and the minimum latched the healthy pack at 32.9 s (main
    restricts and never latches). Grok showed a one-sided step 43 -> 50 V
    beside 44 V clearing a running countdown.
    Now a pair disagrees wh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
2026-11-13 Docs: LoRa listener results - the base transmits every second; reception at the robot is the weak point
    The receive-only listener (Heltec V3, outdoor Wi-Fi near the barn) hears
    the base every second: 9-10 LoRa packets (SF5, 500 kHz, sync 0x12,
    explicit header, CRC) near 915.01 MHz, about -40 dBm and SNR +9 dB near
    the barn. The robot's logs show station 3335 at a 1.0 s differential age
    when corrections arrive, but long gaps (87 % of rows on 2026-11-07
    evening, all of the garage time). Next checks: the rover's LoRa antenna
    and a reception map with the listener. Docs only: no service restart.
2026-11-13 Docs: X1202 bench results without hands, go/no-go 'not yet', hands-on procedure
    Record the first bench tests of the Geekworm X1202 (option F) in
    docs/pi_power_architecture.md sections 7.5 to 7.8, with the raw harness
    results in docs/data/x1202_bench_20261113/.
    Why: Kevin asked for the 7.2 results with a go/no-go. 33 power cycles ran
    through a remote outlet. The normal cycle and the reboot pass. The Pi stays
    off when the input returns during a shutdown or after a halt with the input
    present. The cells sag too much under load. The tests that need hands are
    listed in 7.7.
2026-11-13 Add the X1202 bench logger and the power-cycle test harness
    tools/x1202_bench_logger.py runs on the Pi: it records GPIO 6 (input good),
    GPIO 16 (charge disable), the MAX17040 cell voltage, EXT5V and the throttle
    flags, can hold charging off, and has a flag-gated bench guard that halts
    the Pi cleanly when the input stays lost. tools/x1202_cycle_test.py runs on
    a workstation: it switches a remote outlet and the Pi through the 7.2 test
    matrix (ride-through, full cycle, restore-during-shutdown race, halt with
    the input present, reboot, load on cells, minimum off time, soak).
    Why: the Geekworm X1202 must pass the bench tests in
    docs/pi_power_architecture.md section 7.2 before it replaces the UPS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
2026-11-13 Docs: draft design for the X1202 power watcher (not approved)
    Add docs/x1202_power_watcher_design.md: the design of the short script
    that would replace bin/walle_ups.py on the Geekworm X1202, its unit, the
    bus-guard witness, the retirement and install procedure and the test plan.
    Link it from docs/pi_power_architecture.md section 7.6.
    Why: Kevin asked for a reviewed plan for the robot install. The bench
    go/no-go is 'not yet', so this is a draft made ahead of the gate: nothing
    from it is installed or pushed as code. Grok (sessions 8ad0ce4e and
    8c736335) and an independent Opus reviewer examined it in three rounds.
    The reviews removed the late-shutdown check, the charge probe and the
    early-ha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
2026-11-13 Docs: X1202 bench ran on the USB-C input, not 12 V; name the cells
    Correct the setup in docs/pi_power_architecture.md section 7.5: the bench
    supply is the Raspberry Pi USB Type-C supply on the board's USB Type-C
    input (Kevin, 2026-11-13). The 12 V in the first issue was an assumption.
    Add the 6 V to 18 V input as an open go/no-go item, because the robot
    uses that input. Record the cells: old Moli ICR-18650H laptop cells.
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2026-11-13 Harness: skip the dimmer-level step on a plain relay outlet
    The level check after each 'on' was written for the Z-Wave dimmer that
    switched the bench supply on 2026-11-12. The supply is now on a plain
    Zigbee relay outlet, which has no level attribute, so the check would send
    an unsupported setLevel command and add 3 s to 6 s after each switch-on.
    The check now runs only when the device reports a level.
2026-11-13 Docs: X1202 power-cycle results on the 12 V input; debounce is 5 s
    Add the repeat of the power-cycle tests on the 6 V to 18 V input (17
    cycles, same behaviour as on the USB Type-C input; GPIO 6 reacts about
    0.7 s later) to docs/pi_power_architecture.md section 7.5, with the raw
    results. Set the debounce in docs/x1202_power_watcher_design.md to 5 s
    and correct the numbers that depend on it.
    Why: the robot uses the 12 V input, and the night's tests used the other
    input. Kevin decided the 5 s debounce on 2026-11-13, after the reviews.
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2026-11-13 Docs: record Kevin's shield decisions in the wiring doc
    Kevin decided: a microcontroller on the shield reads the RC channels,
    it talks to the Pi over USB, and the CAN interface stays separate.
    Add the two requirements that follow from USB (a cable, because the
    header has no USB; one 5 V source with VBUS not tied to it, after the
    2026-11-04 hub back-feed). Recommend dropping the Model X outputs
    (first-prototype motor driver, likely not fitted) and the HAT+ ID
    EEPROM (no use here; may clash with the NVMe carrier's).
2026-11-13 Docs: shield drops the Model X outputs and the ID EEPROM
    Kevin's decision: the Pi 5 shield has no Model X drive outputs (the
    first-prototype motor driver he does not know, probably not fitted)
    and no HAT+ ID EEPROM. All five shield decisions are now recorded.
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2026-11-13 Docs: Arduino flash verified against the repo sketch; shield chip and CH6
    Read the robot Arduino's flash in avrdude no-write mode (wall-e stopped
    about 15 s, Kevin's approval). The first 4,806 bytes match a build of
    the sketch at dcc550e with the Pi's Debian toolchain, byte for byte;
    5f275d0 and 5aa12e3 do not. The rest up to 9,807 is dead leftover from
    an older build. Board confirmed: ATmega328P, CH340, 16 MHz, Nano old
    bootloader. The full image is saved under arduino_rc_reader/backup as a
    restore point.
    Fold in the verification agent's review: an out-of-range pulse reads as
    a valid 1500 (a CH5 pulse above 2200 hides the e-stop), byte 255
    overflows the Model X PWM math, DTR resets the boa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
2026-11-13 Docs: the Arduino only streams RC to USB; the Model X is removed
    Kevin: the Arduino drives no device today; it used to control the
    OSOYOO Model X, which is gone. Correct the wiring doc, the diagram,
    hardware_mapping, can_vesc, README and CLAUDE.md: VESC over CAN is the
    only drive path, and the Model X fallback drives nothing.
    Keep one caution: the verified firmware still sets D7-D12 as outputs
    and drives them on an M command (sent only when no VESC is found), so
    no input may go on those pins; CH6 goes on A0.
2026-11-13 Docs: USB hub removed; Arduino on a Pi port, OAK on the UPS 5 V
    Kevin: the USB hub is no longer used. The Arduino plugs into a USB port
    of the Pi with a normal cable, so the Pi powers it and the receiver.
    The OAK-D Lite takes its 5 V from the UPS through the cut wire in its
    cord. That is the "variant without the hub" in pi_power_architecture.md,
    now marked as built (fuse and checks not recorded; max_usb_speed still
    HIGH).
    Shield requirement S10 keeps VBUS and the header 5 V apart: both now
    come from the Pi's 5 V rail, but joining them on the shield goes around
    the Pi's USB current limit, and a powered hub would back-feed again.
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2026-11-13 Docs: shield sits on the Waveshare CAN HAT; Mini-B socket; hand-solder
    Kevin's answers to the PCB session's blockers:
    - Build: hand-soldered (ATmega328P DIP-28 in a socket, CH340C as the
    only SMD chip, through-hole otherwise).
    - USB: his short cable ends in a 90-degree Mini-B plug, so the shield
    gets a Mini-B socket placed for that bend. His photo of the plug and
    the current Nano mount is in docs/data/shield_inputs_20261113/.
    - Stack: the shield mounts on top of the Waveshare RS485 CAN HAT, not
    an NVMe carrier. Its MCP2515 is on SPI0 with the interrupt on GPIO 25
    (read from the Pi's config.txt), and its RS485 side uses the UART, so
    S7 now reserves those pins too.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
2026-11-13 Docs: USB plug bend is not a design limit for the shield
    Kevin will buy whichever Mini-B cable the on-board socket needs, so the
    plug's bend direction no longer constrains the layout.
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2026-11-13 Docs: shield drops the on-board chip; an off-the-shelf Nano only
    Kevin: "If we're still going to have an Arduino, might as well just buy
    one off the shelf and make this board a whole lot simpler. Let's remove
    the small chip to replace the Arduino."
    S11 and D6 now specify one Nano socket and no on-board ATmega328P +
    CH340C; S9 keeps only the Nano's own USB port; D8 drops the SMD note.
    Buy a Nano with straight headers: the robot's present one has a
    right-angle row and does not fit the socket.
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2026-11-13 Docs: Nano goes on the side of the Pi's USB ports
    Kevin: move the Nano to the side where the Pi's USB ports are (the
    short end with the USB-A ports and Ethernet), for a short cable to a Pi
    USB port. Replaces the south-edge (USB-C and HDMI side) position.
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2026-11-14 Docs: refine the F3-open residual in D14; note the built board
    The Grok review of the restored shifter showed the blown-F3 case has two
    outcomes: a low-impedance dead rail holds I2C bus 1 low, a floating one
    leaves the bus high at about 2.9 V with the rover browned out. Also
    record that D14 is built as d5f5a7f in hardware-projects (ERC 0, DRC 0).
2026-11-14 Docs: record the shield research answers in the wiring spec
    Web research on 2026-11-13 answers several open checks on paper: the
    receiver's seventh row is EXT-V (a sense input, not power), its listed
    current is 35 mA and both listed sizes fit the bay; the rover estimate
    is 60 to 90 mA at 5 V; the Pi keeps header 5 V on in a halt and the
    X1202 manual says the board cuts it; Waveshare's RS485 direction pin is
    GPIO 4 (optional). The signal level, failsafe behaviour and CAN HAT
    heights stay open. Also folds in the board README's spec corrections
    (bay position, clip holes, D8, D9, check 11).
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2026-11-14 Safety: CH4 no signal latches FOLLOW_ME off until a measured low
    Grok review (session 36082792-5897-4516-8435-8996f6c890fd): counting a
    no-signal CH4 as "high" for the edge detector kept memory one sample
    deep. CH4 high -> no signal -> a measured mid value (receiver failsafe
    neutral, a corrupt field) -> high was a rising edge, and FOLLOW_ME
    restarted with the switch up the whole time and the robot still armed.
    SafetyState.ch4_requires_low replaces that trick: no signal on CH4 sets
    it on every tick, before any early return; only a measured CH4 at or
    below follow_me_low_threshold_us clears it; FOLLOW_ME_ENTERED needs it
    clear. force_disarm and the controller's RC-stale rebuild keep it.
    last_c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
2026-11-14 Controller: a dead track lead neutralises both tracks, and ramps back
    Review S3, contract changed on review: if CH1 or CH2 has no signal, BOTH
    tracks read neutral. With only the dead track neutral, a held stick on the
    other turned the robot in place. test_controller_no_signal_track_is_neutral
    became test_controller_one_dead_track_makes_both_tracks_neutral for that
    reason. The journal text says "both tracks held at neutral".
    Review note 3: on the tick the tracks go from forced neutral back to
    measured widths, armed in MANUAL on the RC sticks, _hold_slew_at_neutral()
    pins the slew, so a held stick ramps at the mode rate instead of
    snap_first_command passing it in one tick (same rule as the 20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
2026-11-14 Safety: a latch clears only on a low held 0.2 s, not one sample
    Kevin changed the contract on 2026-11-13 ("Held low 0.2 s"). The review
    reproduced it (sim_bounce.py): a loose lead that comes back with one
    500-1200 us bounce cleared rearm_requires_switch_cycle (CH3 re-armed about
    0.6 s later) or ch4_requires_low (FOLLOW_ME restarted 0.2 s later), with
    the switch up the whole time.
    - SafetyParams.latch_clear_low_persist_s = 0.2. rearm_requires_switch_cycle
    (every cause: startup interlock, force_disarm, mid-band, no signal) and
    ch4_requires_low clear only after a MEASURED low on every tick for that
    long, on the monotonic safety clock. A no-signal tick or any tick that is
    not low restar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
2026-11-14 Sketch: remove the Model X motor code
    Kevin, 2026-11-13: "Remove it now". The OSOYOO Model X board is removed;
    the VESCs on CAN drive the robot. The sketch now only reads the receiver
    and streams lines: no D7-D12 outputs (they stay at the reset default,
    input with no pull-up), no driveLeft/driveRight, no "M," parser. The loop
    discards any serial input, so an "M,<left>,<right>" from the Pi does
    nothing. That also removes the byte-255 PWM overflow and the Model X
    missing-command timeout (finding 6).
    Pi side unchanged: ArduinoModelXDriver still writes "M,l,r" when main.py
    finds no VESC on CAN, and four calibration CLIs use it. The writes are
    harmless: no flow control, so they never block, and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
2026-11-14 Docs: Kevin's 2026-11-13 decisions and the review fixes
    docs/rc_arduino_gps_wiring.md:
    - Section 7: hold last good (one rule: the last valid width until 100 ms
    after that pulse ended, then 0); worst-case detection latency about
    155 ms with the Pi's 30 Hz tick (review note 7); both tracks neutral on
    a dead track lead and the ramp when it comes back; held low 0.2 s to
    clear the re-arm latch and the CH4 latch, and for the pack-low latch and
    the person-stop release; the vision-hang gate after 30 s of no signal;
    no CH6 journal line.
    - Sections 3, 4, 5, S14: the Model X code is removed from the repo sketch,
    still on the flashed firmware until the next flash; the Pi's
    ArduinoModelXD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
2026-11-14 Retry GPS detection while the receiver is absent
    If I2C bus 1 was locked when wall-e started, detect() failed once and the
    reader was never created, so GPS stayed dark until a manual restart even after
    i2c-bus-guard unlocked the bus. The reader thread now retries every 30 s with
    bounded logging, and main always starts it (and builds the waypoint
    controller, whose start gate refuses a run with no GPS reading).
2026-11-14 Fix IMU calibration tool to read through the real ImuReader API
    The tool read reader.imu and reader.mag, which ImuReader does not have, so
    every read raised and no samples were collected. It now reads through the
    reader's mode/icm/ism/mmc members, prints real numbers instead of literal
    format strings, and its header says it is for the parked external breakout
    IMU, not the OAK BMI270.
2026-11-14 Correct stale comments and docstrings (no behaviour change)
    Stick expo comment now describes the ratio-preserving expo in mapping.py;
    camera_fps is in use, not reserved; the BMS is a JHB-R24TH-V1.3; the UPS
    setpoint is 7.5 V; the 2026-09-25 I2C lock-up was on the UPSPlus; /api/nav/go
    motion does not wait for arming (a disarmed tick drops the mode).
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
